HawortiaCooper/Bird.Bend_Stend/00_System/tools/README.md

# 00_System/tools — Integrator tools (owner: Implementer C)

Shared FW⇄SW interface tooling for `ICD_protocol.md` v0.7.5, `params.yaml` dict_version 6 and `protocol.yaml`
(protocol name registry, ICD §0.3).
Python ≥ 3.11, standard library + PyYAML (generators only). Use the project venv: `.venv\Scripts\python`.

| File | Purpose |
|---|---|
| `gen_params.py` | **Single generator entry point.** `params.yaml` → `02_FW/src/gen/params_gen.{h,c}`, `03_SW/src/bend_stand/core/params_gen.py`, ICD Appendix A; runs `gen_protocol.py`. Origin: Thrust_Stand_HAW `00_System/tools/gen_params.py` @9473c68 (trimmed). |
| `gen_protocol.py` | `protocol.yaml` → `02_FW/src/gen/proto_gen.h` (C), `03_SW/src/bend_stand/core/protocol_gen.py` (Python `IntEnum`/`IntFlag`, `<ID>_BITS`, `<ID>_DESC`, `CMD_REQ_LEN`, `CMD_RETRY`), ICD tables between `GENERATED protocol:<id>` markers + Appendix B (GF-08). |
| `ref_codec.py` | Reference codec (oracle): CRC-16/CCITT-FALSE, frame encoder, ICD §2.3 parser with resync, encode/decode of every request, response, DATA and EVENT payload. Stdlib only. |
| `ref_loadlim.py` | Reference FW load limit (M2, D-40 d): violations, trip samples, rails, regrow window; the docstring is the definition behind `loadlim_vectors.json` (ICD §5.5). |
| `ref_linkwdg.py` | Reference FW link watchdog (M4, D-47 a, ICD v0.7.4 §9.1): VALID cleared at the timeout in every motion state, stop / LINK_WDG / EVENTs only while moving; the docstring is the definition behind `linkwdg_vectors.json`. |
| `ref_motion.py` | Reference step-period generator (M2): exact sqrt ramp with max rule and fractional carry (R4 §1.5), controlled stop, JOG on-the-fly changes, ICD §6.5 stop-path rule, planner. The docstring is the normative definition behind `motion_vectors.json`. |
| `ref_cmdcheck.py` | Reference acceptance model of ICD §4–§6 (check order, BLOCK mask, busy, clears, SET_PARAM checks, hard rules). Acceptance only, no execution. |
| `gen_vectors.py` | **The single vector generator** → `vectors/protocol_vectors.json`, `vectors/check_vectors.json`, `vectors/units_vectors.json` (M1), `vectors/motion_vectors.json` (M2, from `ref_motion.py`), `vectors/loadlim_vectors.json` (M2, from `ref_loadlim.py`), `vectors/linkwdg_vectors.json` (M4, from `ref_linkwdg.py`). |
| `vectors/` | Generated shared vectors (never hand-edited). |
| `fw_twin/` | **FW host twin** (P2/M1): `build.py` (host gcc build of A's unmodified `02_FW/src/{pure,core,gen}` + twin seams), `engine/` (C: scheduler, seam implementations, world model), `twin.py` (launcher: virtual time, TCP ports, vocabulary v2, logs; Python API `Twin` / `TwinLink`), `contract/` (seam v1 header copies, used only while A's headers are absent), `probe/` (harness probe core — **not the FW**). See "FW host twin — how to run it" below. |
| `tests/` | pytest proving the codec, the model and the generators against the vectors; `test_fw_twin.py` = twin harness self-tests (probe core). |

## Regenerate (Integrator, after every params.yaml / ICD change)

```powershell
.venv\Scripts\python 00_System\tools\gen_params.py           # FW/SW params + protocol names, ICD App. A/B + tables
.venv\Scripts\python 00_System\tools\gen_vectors.py          # vectors (uses the new dictionary)
.venv\Scripts\python -m pytest 00_System\tools\tests -q      # must be green
```

CI / gate check (no writes): `gen_params.py --check` and `gen_vectors.py --check` exit 1 when any output is
stale; `gen_params.py --hash` prints PARAM_DICT_HASH. Rules: every ICD change = ICD version bump + change
history entry; every dictionary change = `dict_version` bump; ids are never reused (`retired_ids`). Validators
**add scenarios to `gen_vectors.py`** (via the Integrator), never a second generator (R3 pitfall P12).
**Input hardening (FWR-14, ICD v0.7.5):** `load()` of both generators rejects YAML text that could become code in the
generated C / Python: identifiers (`c_member`, `py_name`, columns, prefixes) against strict ASCII patterns without C / Python
keywords, `icd_version` / `retired` as `N.N[.N]`, `dict_version` and protocol versions as YAML integers, and every free text
(labels, units, descriptions, titles, `icd` refs, srs) without control / line-separator / bidi characters, `/*`, `*/`, `\`,
`"""` or C trigraphs (helpers `gen_protocol.safe_text / safe_ident / safe_version / safe_int`; tests
`tests/test_gen_text_safety.py` + Validator E's `02_FW/test/static/test_val_review_gen.py`). Non-ASCII symbols (µ, §, →) stay allowed.

## How both sides consume the vectors (IF-010)

Both implementations MUST pass the same files; the vectors are the oracle for byte values (ICD §0.1, §12).

| Vector set | FW (Implementer A / Validator E, `pio test -e native`, Unity) | SW (Implementer B / Validator F, pytest) |
|---|---|---|
| `protocol_vectors.json` `crc16` | `crc16_ccitt()` equals every `crc` | `io.framing` CRC equals every `crc` |
| `frames` (kind request/response/async) | decode every PC→FW request (payload_hex → C struct, fields = `decoded`); **encode** every FW→PC frame from `decoded` and compare **byte-identical** with `frame_hex` | encode every PC→FW request from `decoded` byte-identical; decode every FW→PC frame to `decoded` (`reencode: false` → re-encoding gives `canonical_payload_hex`; `INVALID_PADDING` → reject) |
| `frames` `framing_only` / `invalid` | frame layer only / must be dropped with `crc_errors += 1` | same |
| `streams` | feed `chunks_hex` in order to a fresh `frame.c` parser; call the 20 ms timeout hook if `idle_timeout_at_end`; frames **and** counters equal | same with `io.framing.FrameDecoder` |
| `units_vectors.json` (ICD §0.1) | `units.c` `um_to_steps` / `steps_to_um` / rate cap with `spm` = the binary32 from `spm_f32_hex`: every value exact | `calc.motion.um_to_steps` / `steps_to_um` and the simulator's step model: every value exact |
| `motion_vectors.json` (M2) | `ramp.c` / `stepgen_core` from the case parameters and events: every period within `tolerance.period_ticks` (±1) and the sum within `tolerance.sum_ticks` (±N/1000) of `periods`; `ctrl_stop_path()` equals every `ctrl_stop_paths` row; v0.7.2 `immediate_stops` (MOVE_UNTIL_LOAD threshold): the generator of `base_case` stopped immediately after `after_step` periods emits no further pulse; `threshold_in_controlled_stop`: the same after the base case's controlled stop, MOVE_DONE stays STOPPED (OI-FW-43 b) | the simulator's step model: every period and sum exact (binary64); `immediate_stops` the same |
| `loadlim_vectors.json` (M2) | `loadlim.c`: replay each case (init, then sample / fault_clear / config steps): `trip` and `regrow_window` equal after every step | the simulator's load limit: same |
| `linkwdg_vectors.json` (M4, ICD v0.7.4) | twin replay `03_SW/tests/integration/test_twin_m4_linkwdg.py` (state set up, silence from the end of the last request, trip / no trip, VALID after, LINK_WDG status, EVENT set at the trip and at the next frame) and Validator E's independent replay `02_FW/test/twin/test_val_twin_m4_linkwdg.py` (32/32 each); A's FW link watchdog (native suite) | the simulator's link watchdog: same (D-47 a in B's `io/sim/board.py`) |
| `check_vectors.json` `hw_meas_vectors` (v0.6) | only against a HW_MEAS build (FEAT_HW_MEAS = 1); release / twin builds replay `vectors` (DIAG_MEAS → NOT_IN_BUILD) | the simulator answers NOT_IN_BUILD (no HW_MEAS model) |
| `check_vectors.json` | set up the pure command-check context from `state_defaults` ⊕ `state` (and the param overrides), run the command check on `request.payload_hex`, compare STATUS/detail and, for NACKs, the encoded response with `response_frame_hex`; no side effect on NACK | the simulator (`io.sim.fw_logic`) in the same state answers identically (differential check of the SimBoard) |

FW side: a pre-script in `02_FW` (owned by A/E) converts the JSON into a C header (arrays of hex strings +
expected values) at build time, as Thrust_Stand did (`tools/gen_test_vectors.py`). It MUST read the files in
place (no copies) so `--check` staleness is caught. SW side: tests load the JSON directly via the repo path
`00_System/tools/vectors/`; `ref_codec` may be imported as an oracle in tests only, never by production code.

`check_vectors.json` state fields (`ref_cmdcheck.FwState`): `params` (key → value overrides; enum/bool as
code), `motion_state` (ICD §6.1 name), `enabling_left_ms`, `homed`, `pos_um`, `estop_latched`,
`estop_input_open`, `estop_closed_ms`, `halt_latched`, `stop_btn_active`, `stop_btn_released_ms`, `faults` /
`fault_causes` (FAULT names), `limit_start` / `limit_end` (active or latched), `afe_stale`, `afe_saturated`,
`raw`, `drv_power`, `alm_active`, `nvm_record_valid`, `paused` (v0.2), `unhomed_origin_um` (v0.7, D-43 b: the
position latched when the axis became un-homed; default 0), `ena_on` (**v0.7.5, D-50 c / OI-FW-50**: the ENA output at the
enabled level = STATUS `io` ENA_DISABLED clear; default true; false after DISABLE or an E-stop; after a boot NOT_ENABLED
keeps it true, D-13; the generator asserts ENA on outside NOT_ENABLED / E-stop and off with an E-stop).
`state_schema` (top level, = 2 since ICD v0.4, = 3 since ICD v0.7 (+ `unhomed_origin_um`), **= 4 since ICD v0.7.5** (+ `ena_on`;
FWR-09 in the pure check: DIAG_MEAS STATIC_LEVEL sel PUL with `ena_on` → `E_STATE` MEAS_STATE), F-B-25): version of these keys. Keys are only ever **added**
(never renamed or removed), each addition bumps `state_schema`; a replay MUST fail on an unknown key or a
newer `state_schema`. Every vector state is a valid configuration (all hard rules H1–H5 hold).
`expect.paused_after` (present when `state.paused` or for PAUSE / RESUME): the PAUSED latch after the command
(ICD §5.5, D-30/D-31: only RESUME or HALT_CLEAR clear it). It is an execution effect: FW latch unit tests,
the twin and the SW simulator check it; the pure FW command check ignores it.

**Protocol names (GF-08, ICD §0.3).** FW code includes `gen/proto_gen.h` and SW/GUI code imports
`bend_stand.core.protocol_gen`; neither side hand-lists command codes, NACK codes, bit tables or EVENT codes.
`tests/test_protocol_registry.py` proves `protocol.yaml` = `ref_codec.py` tables = generated module.

---

## Lean FW host twin for M1 (outline for Implementer A; R3 §3.6, SYS-008, D-07)

**Goal:** compile the *same* FW sources (`src/pure`, protocol/link, cfg/NVM, app state machines, motion
planner) for the PC against a ≤ 1.5 kLOC twin implementation of a few narrow C seams, serve USART2 as TCP
`127.0.0.1:5760` (SW endpoint `tcp://127.0.0.1:5760`), and drive the "world" through a control port. No
register emulation (the Thrust twin's 7.5 kLOC fake-`stm32f1xx.h` approach is not repeated).

### Seam v1 (single source; DEF-P1-02 / OI-FW-17 closed)
The seam contract is **FW_design §8.1** (Implementer A owns the headers `02_FW/src/hal/hal_*.h` and freezes
them as seam v1 in M1-WP1); this README adopts it **verbatim, including every Δ**. A seam change is made by A
in FW_design §8.1 + the headers and mirrored here in the same change (one contract, two copies kept equal;
the twin is coded against the headers).

```c
/* hal_uart.h */
size_t   hal_uart_read(uint8_t *buf, size_t max);                     /* consume RX bytes */
size_t   hal_uart_peek(uint8_t *buf, size_t max, uint32_t *cursor);   /* stop sniffer: new RX bytes, no consume */
typedef enum { HAL_TX_DATA = 0, HAL_TX_RESP = 1, HAL_TX_EVENT = 2 } hal_tx_class_t;
bool     hal_uart_write(const uint8_t *frame, size_t n, hal_tx_class_t cls); /* whole frame or false;
                                                                    HAL_TX_DATA callable from the sample ISR/tick */
size_t   hal_uart_tx_free(hal_tx_class_t cls);
bool     hal_uart_tx_idle(void);                                      /* all classes empty and line idle */
uint32_t hal_uart_rx_overruns(void);
/* hal_time.h */
uint32_t hal_time_us(void);   uint32_t hal_time_ms(void);
void     core_tick_1ms(void);                                         /* callback, level 4, every 1000 µs */
/* hal_step.h */
typedef struct { uint32_t pw_ticks, dir_setup_ticks; bool pul_invert, ena_invert; } hal_step_cfg_t;
uint32_t hal_step_init(const hal_step_cfg_t *cfg);                    /* returns f_tick (90 MHz target) */
void     hal_step_set_dir(int dir);                                   /* only while stopped; v1.3: +-1 logical
                                                                         direction, +-2 = same direction with the
                                                                         DIR output inverted (motion.dir_invert) */
void     hal_step_start(uint32_t first_period_ticks);                 /* first edge >= dir_setup after the call */
void     hal_step_set_period(uint32_t ticks);                         /* preload: period after the running one */
void     hal_step_set_period_now(uint32_t ticks);                     /* stretch the running period (§5.6.4) */
void     hal_step_arm_last(void);                                     /* OPM: stop at the end of this period */
bool     hal_step_stop_now(void);                                     /* CLEAN, no runt; true = pulse completes */
bool     hal_step_abort(void);                                        /* TRUNCATE; true = pulse cut (uncertain) */
int32_t  hal_step_count(void);                                        /* signed position counter, steps */
void     hal_step_set_count(int32_t steps);                           /* homing zero shift, only while stopped */
bool     hal_step_running(void);
uint32_t hal_step_stop_gen(void);                                     /* start-then-recheck counter */
void     hal_ena_set(bool enabled);                                   /* polarity from hal_step_init */
typedef struct { uint32_t period; bool last; bool stop; } step_next_t;
step_next_t step_isr(void);                                           /* callback, level 2, per completed pulse */
/* hal_inputs.h  — ids = ICD IO bit indices 0..7 */
uint16_t hal_inputs_raw(void);                                        /* electrical levels (1 = pin high) */
typedef struct { uint8_t pause_active_level, alm_active_level; } hal_in_cfg_t;   /* v1.2: STOP input retired */
void     hal_inputs_config(const hal_in_cfg_t *c);                    /* polarity for the fixed reactions */
void     hal_inputs_rearm(uint8_t id);                                /* re-enable a self-masked line */
void     on_input_edge(uint8_t id, bool level, uint32_t t_us);        /* callback, level 0/1, AFTER the HAL's
                                                                         fixed reaction; deferred during flash ops */
/* hal_outputs.h */
void hal_rate_pin(bool high);  void hal_trip_relay(bool trip /* never true in release 1 */);  void hal_led(bool on);
/* hal_hx711.h */
typedef struct { uint32_t t_us; int32_t raw; int32_t pos_steps; uint8_t status; } afe_sample_t;
void hal_hx711_config(uint8_t gain_pulses, bool rate80);
void hal_hx711_powerdown(bool on);
void hal_hx711_kick(void);                                            /* missed-edge recovery */
void hal_hx711_hold(bool on);                                         /* NVM hold */
void on_afe_sample(const afe_sample_t *s);                            /* callback, level 3, after the latch */
/* hal_flash.h */
bool hal_flash_erase(uint32_t sector);
bool hal_flash_program(uint32_t addr, const void *src, size_t n);
const void *hal_flash_map(uint32_t addr);
/* hal_sys.h */
void hal_wdg_kick(void);  void hal_wdg_set_timeout(uint32_t ms);
uint8_t hal_reset_cause(void);            /* RST_* (proto_gen.h) */
void hal_reset(void);  void hal_uid(uint8_t uid[12]);  bool hal_clk_fallback(void);
uint16_t hal_stack_free_min(void);
bool hal_fault_record(uint32_t *pc, uint32_t *cfsr);   /* seam v1.2 (OI-FW-32): HardFault record of the
                                                          previous run, true once after boot, then cleared */
size_t hal_meas_cmd(const uint8_t *req, size_t n, uint8_t *resp, size_t max);   /* seam v1.3 HW_MEAS (D-40c) */
/* critical sections (seam v1.1, A's proposal adopted in P2/M1): HALT = PRIMASK, AFE/MOTION = BASEPRI 0x20,
   DATA = 0x30, TICK = 0x40; no-ops in the twin (single thread, ISRs never preempt; nesting checked) */
typedef enum { HAL_CRIT_HALT = 0, HAL_CRIT_AFE = 1, HAL_CRIT_MOTION = 2, HAL_CRIT_DATA = 3, HAL_CRIT_TICK = 4 } hal_crit_level_t;
typedef uint32_t hal_crit_t;
hal_crit_t hal_crit_enter(hal_crit_level_t level);
void       hal_crit_exit(hal_crit_t saved);
/* usage: CRIT_BEGIN(HAL_CRIT_DATA); ... CRIT_END();  (macros in hal_sys.h) */
```

| Seam | Target implementation | Twin implementation (virtual time) |
|---|---|---|
| `hal_uart` | USART2 + DMA1 Stream5/6 Ch4; three TX class queues, wire order DATA > RESP > EVENT (ICD §2.4) | TCP 127.0.0.1:5760 paced at 92 160 B/s; same class queues and order; `peek` = second read cursor; every TX frame logged with first/last-byte virtual time (wire log) |
| `hal_time` | TIM5 1 MHz; SysTick 1 kHz → `core_tick_1ms` | virtual clock (lock-step or real time); `core_tick_1ms` every 1000 µs of virtual time |
| `hal_step` | TIM2 PWM mode 2 + update IRQ (R4 §1.3) | integrates virtual pulses at the commanded periods; `set_period_now` / `arm_last` act on the virtual counter; `abort` cuts the pulse and flags it uncertain; every PUL edge (both), DIR and ENA change logged with its virtual time |
| `hal_inputs` | GPIO + EXTI, fixed reactions in the HAL (FW_design §5.2) | world model per input (switch position, forced level, bounce, broken wire); `rearm` = no-op |
| `hal_outputs` | GPIO | levels recorded for `query` |
| `hal_hx711` | EXTI on DOUT + bit-bang (`hx711_seq.h`, Thrust origin) | sample source from the load model at rate·(1+ε); `hold` = no samples delivered; `kick` = no-op; gain pulses per read recorded |
| `hal_flash` | F4 sector erase / word program | file `flash.bin` (persists across twin resets); power cut injectable after program word n / during erase k; write counter |
| `hal_sys` | IWDG, RCC, SCB | IWDG model (timeout from `hal_wdg_set_timeout`, LSI selectable), reset = engine process restart by `twin.py` with the selected cause (flash kept, frames in flight cut), HSE-fail flag; `hal_crit_*` no-ops (nesting checked) |

**Seam semantics (normative, fixed by A's FW and fakes, adopted at ICD v0.5; OI-C-M1-03 answered):**
- `hal_uart_tx_free(cls)` = the largest frame (bytes) the class queue accepts **now** (0 = none).
- `hal_uart_peek(buf, max, &cursor)`: `cursor` = absolute RX byte count since boot (the core starts it at 0);
  returns the bytes after `cursor` without consuming them and advances `cursor`; a lapped cursor skips to the
  oldest byte still in the ring.
- `hal_step_stop_gen()` (v0.7.5, OI-FW-48, FW_design v0.8 FWR-01): incremented by **every** stop primitive call — `hal_step_stop_now()`,
  `hal_step_abort()` and the target's `step_estop_reaction()` — also while the timer is idle (start-then-recheck sees an idle
  halt between the gate check and the start); `hal_step_start()` arms the timer atomically. The twin mirrors the idle
  increment (its start is atomic by construction: single thread).
- `hal_flash_erase(sector)`: F4 sector number 1 or 2 (0x0800 4000…0x0800 7FFF / 0x0800 8000…0x0800 BFFF);
  `hal_flash_program(addr, src, n)`: addresses inside sectors 1–2, `n` a multiple of 4 B (word), at most
  512 B per call; programming can only clear bits (a 0→1 bit returns false).
- `hal_wdg_set_timeout(ms)` selects a window, it is not scaled: **ms ≤ 90 → run window** (PR /8, RLR 190:
  32.5 ms at LSI 47 kHz … 89.9 ms at 17 kHz; i.e. 90 = the worst-case timeout at the slowest LSI), **ms > 90
  → NVM long window** (PR /32, RLR 4095: 2.79 s … 7.71 s), idle only. The FW arms the run window at boot.
- `afe_sample_t.status` bits (`protocol.yaml` table `afe_sample_status`, C `AFES_*`): bit 0 `SCK_OVERRUN`
  (the read overran; the HX711 may have entered power-down → the core re-initialises it), bit 1 `MISSED_EDGE`
  (≥ 1 DOUT-ready edge missed before this sample → OVERRUN in the next DATA frame); bits 2–7 = 0.

**Seam v1.3 (ICD v0.6, D-40 c; REQ-C-M2-01, REQ-A-M2-03)** — three changes:
- `hal_step_set_dir(dir)`: A's interim encoding becomes the seam (SR-M2-01): `dir` = ±1 logical direction (the HAL
  counts `pos_steps` by its sign), ±2 = the same logical direction with the DIR output inverted
  (`motion.dir_invert`). DIR electrical level = (dir > 0) XOR (|dir| = 2).
- `hal_in_cfg_t` without `stop_active_level` (SR-M2-02, CR-01).
- `size_t hal_meas_cmd(const uint8_t *req, size_t n, uint8_t *resp, size_t max)` in `hal_sys.h`: the HW_MEAS forwarder.
  `req` = the 8-byte DIAG_MEAS request payload, already validated by the core (LEN, op / sel / a / b ranges,
  MEAS_STATE, ICD Appendix C); `resp` = the 64-byte OK body. Returns 64 when executed, **0 when the build has no
  HW_MEAS** (release image, twin without `--hw-meas`): the core then answers E_INTERNAL NOT_IN_BUILD. At boot the
  core calls it once with op INFO and sets FEAT_HW_MEAS from the result. STATIC_LEVEL is released by the HAL before
  any other DIAG_MEAS op and at `hal_step_start` / `hal_ena_set`. Not called from ISRs; called only from the command
  dispatcher (main loop). A's `hal_sys.h` carries it (seam check clean); the seam check still accepts a function marked
  "PENDING-A" in the block as announced-but-not-delivered for future additions.

**Seam v1.2 (M2; OI-FW-32)** — one addition, made by A in `hal_sys.h` and mirrored into the block above
(ICD v0.5; the twin provides it):
```c
bool hal_fault_record(uint32_t *pc, uint32_t *cfsr);   /* HardFault record of the previous run (.noinit):
                                                          true once after boot if present, then cleared */
```
The core puts `pc` / `cfsr` into EVENT BOOT `value` / `value2` (ICD §6.4). Twin: vocabulary `reset` with
`cause: "hardfault"` plants a record and resets with cause SOFTWARE; `--fault-rec <pc_hex>:<cfsr_hex>`.

Rules for A: the protocol, command check, state machines, NVM codec, ramp planner and safety logic call only
these seams (no direct register access outside `src/hal/`); every seam call that the twin cannot serve
deterministically takes `t_us` as an argument or reads `hal_time_us()`. FW-side debug hooks are not needed:
the twin keeps the seam-call log and the edge log itself (OI-FW-31).

### FW host twin — how to run it (Integrator, `00_System/tools/fw_twin/`, P2/M1)

**Private binary per run (OBS-M2-09, ICD v0.7.2).** Concurrent roles must never run, rebuild or lock the same
`fw_twin.exe`: (1) `build.py` compiles into a per-process temporary file and installs it with one atomic
`os.replace` (retried while Windows keeps an old file locked); (2) test suites call
`build.ensure_built_private(core)`: built once per process into `build.private_build_dir()` — `$BEND_TWIN_BUILD_DIR`
if set (kept, e.g. a role's scratchpad), else a temp dir removed at exit — and **pinned** for the whole run;
(3) `Twin(..., private=True)` (default) runs a binary that lies in the shared `fw_twin/build/` from a per-process
private copy (also for the engine restarts after resets), so callers that still pass the shared exe are
protected too. Validators' `VAL_TWIN_BUILD_DIR` keeps working (a private dir, used in place).

**Lock-step SW ⇄ twin (OBS-M2-09).** `03_SW/tests/integration/twin_rig.py` runs Implementer B's `Backend`
(`BackendSettings(clock="lockstep", test_hooks=True)`) and the twin in one virtual time: every 1 ms backend step
first advances the twin to the same instant (`Device.transport_for` → in-process `TwinTransport`; the
`Backend.sim_endpoint` stepper slot → the twin). `lockstep_boards.py` puts the twin and B's `SimBoard` (lock-step
clock, `VirtualTransportPair`) behind one PC-side driver for the SIM-vs-twin differentials;
`io_client.LockstepIoClient` is B's io layer waiting in virtual time. No integration result depends on the wall
clock any more except `test_backend_connect_sequence_tcp_realtime` (TcpTransport smoke, event-driven waits).
**M4 (D-46):** `test_backend_twin_m4.py` drives B's sequencer through its public API only (a `bird.bend.sequence`
file loaded by `Backend.sequencer.load`, `start / pause / resume / stop / abort / status / results`, `reports.*`)
and judges the outcome on the FW side of the wire (`seq_support.py`: decoded requests, responses, EVENTs and DATA
frames from the twin's `wire_log`; VALID windows from the SET_VALID response times, which fix VALID frame by frame
per ICD §4: a frame is VALID iff `t_on ≤ t_us < t_off`); `test_sim_vs_twin_m4.py` = the SIM-vs-twin differential of
a short sequence (board level with `lockstep_boards.Link`, and backend level: B's Backend on the simulator vs on the
twin). B's sequencer is delivered (M4), so these tests run without xfail; a test that needs a part of B that is
still missing is xfail at run time with the reason and flips by itself (e.g. `test_sim_vs_twin_stall.py` while the
simulator lacks `inject step_stall`). v0.7.5: `test_step_timeout_on_a_move_stall` = SW-SEQ-007 TIMEOUT end to end
(twin move stall → no MOVE_DONE → the sequencer's guard STOP at 1.2 × planned travel time + 10 s).

```powershell
.venv\Scripts\python 00_System\tools\fw_twin\build.py                  # --core auto: fw if 02_FW/src/core/*.c exists, else probe
.venv\Scripts\python 00_System\tools\fw_twin\build.py --core fw        # build\fw_twin.exe  (A's firmware)
.venv\Scripts\python 00_System\tools\fw_twin\build.py --check-seams    # A's hal_*.h == the seam v1 block above?
.venv\Scripts\python 00_System\tools\fw_twin\twin.py --port 5760 --ctl 5761 --clock realtime      # SW: tcp://127.0.0.1:5760
.venv\Scripts\python 00_System\tools\fw_twin\twin.py --clock lockstep --scenario my.simscn.json [--t0-us 0xFFFB6C20]
.venv\Scripts\python -m pytest 00_System\tools\tests\test_fw_twin.py -q                      # harness self-tests (probe)
.venv\Scripts\python -m pytest 03_SW\tests\integration -q                                    # SW <-> twin (A's FW)
$env:BEND_TWIN_CORE="probe"; .venv\Scripts\python -m pytest 03_SW\tests\integration -q       # harness check only
```

- **Build** (`build.py`): host gcc = CLion MinGW 13.1 (CLAUDE.md; else `gcc` on PATH or `$env:TWIN_GCC`), `-std=c11
  -O2 -DFW_TWIN=1 -DFW_VERSION_*` (read from `02_FW/platformio.ini` [env] build_flags, the single source; the ini is a build input) `-DPARAMS_GEN_WITH_KEYS=0 -DFW_FEATURE_EXTRA=FEAT_TWIN`
  (A's `core/fw.h` adds it to the INFO feature mask; no `#ifdef` in the core, TC-SYS-008-01). Sources compiled **in place,
  unmodified**: `02_FW/src/pure/*.c`, `src/core/*.c`, `src/gen/*.c` + `fw_twin/engine/*.c`; includes `02_FW/include`,
  `src`, `src/{pure,gen,core}` and `src/hal` (A's seam headers; `fw_twin/contract/` while they are absent).
  Log `build/build_<core>.log` (gcc command, warnings, seam check). `twin.ensure_built()` rebuilds when a source is
  newer than the exe. The core must provide `app_init()`, `app_loop()` and the callbacks `core_tick_1ms`,
  `step_isr`, `on_input_edge`, `on_afe_sample` (FW_design §3.2, §4.2, §8.1).
- **Architecture** (lean, R3 §3.6: no register emulation): `build/fw_twin.exe` = engine + FW, a slave process
  that runs only when `twin.py` advances the virtual clock (stdin/stdout line protocol, `engine/twin_engine.c`
  header). `twin.py` owns virtual time, the TCP data port (one client; a new connection replaces the old one,
  bytes go to the FW at the current virtual time), the JSON-lines control port, the logs and the timed actions.
  One engine process = one MCU power-on period; a reset ends the process and `twin.py` boots a new one after
  2 ms (`boot_delay_ms`) with the reset cause, the same `flash.bin` and the replayed world state.
- **Clocks**: `lockstep` — virtual time moves only on `clock` actions / `Twin.advance_*()` (deterministic: two
  runs give identical wire logs); `realtime` — `twin.py` advances virtual time with the wall clock × `--speed`
  (for B's backend over TCP). Execution rule (FW_design §8.2): ISR callbacks run atomically at their virtual time
  in NVIC order (inputs 0/1, step 2, sample 3, tick 4, TX-done 5), the main loop runs once after every virtual
  instant with an event. A main-loop pass takes no virtual time except flash operations (CPU stall: erase 500 ms,
  16 µs per programmed word); interrupts falling into a stall are taken after it (input fixed reactions happen
  at once, their core callback is deferred), the TX frame on the wire completes, the next one starts after the
  stall. A pass with > 2·10⁶ `hal_time_*` calls is a busy-wait → reported, treated as a hang (IWDG reset).
- **Seam models** (constants = FW_design §2.5): TX classes D 2 frames / 52 B, R 1 024 B, E 16 frames / 384 B;
  wire order D > R > E; 92 160 B/s, byte i of a frame ends at `t0 + ceil((i+1)·10⁹/92160)` ns (RX the same);
  RX ring 2 048 B (overrun counted, reader lapped). Step: f_tick 90 MHz, pulse at the end of each period
  (PWM mode 2), first rising edge ≥ `dir_setup` after `hal_step_start`; at each period end the count moves,
  the next period starts with the preload, then `step_isr()` is called (`.period` → preload, `.last` → the
  period just started is the last, `.stop` → halt now); `stop_now` CLEAN (a pulse in its high phase completes),
  `abort` TRUNCATE (pulse cut, not counted, POS_UNCERTAIN in `query pulses`). ENA electrical level
  = `!enabled ^ ena_invert`. Inputs (electrical, 1 = pin high, pinout §1): E-stop open = 1, limits active = 1,
  PAUSE pressed = 0 (NO), ALM active or driver unpowered = 1, PEND in position = 1, DRV_PWR present = 0; a broken
  wire reads 1 on every input; HAL fixed reactions: E-stop open → `hal_step_abort()` + ENA disabled, limit
  active → `hal_step_stop_now()`; every EXTI-input edge calls `on_input_edge` (lines never masked, `rearm` no-op);
  ALM / PEND / DRV_PWR are only polled. AFE: 80 SPS from reset (RATE pull-up), `hal_rate_pin` /
  `hal_hx711_config` select 10/80 SPS, conversions at `1/(sps·(1+rate_error))`, raw = round-half-away(offset +
  `cell_counts_per_n`·F(x) + N(0, noise)) clamped to the rails, `afe_sample_t.status` per the seam semantics
  (bit 0 = `afe sck_overrun`, bit 1 = after `afe miss_next`); `hold` = conversions continue, none delivered.
  **M3 load model (ICD v0.7.2)**: F = specimen (elastic − relaxation) + hung weights (`weight`); raw =
  round-half-away(offset + cpn·F + cell non-linearity + creep + zero drift + N(0, noise)): non-linearity
  `nonlin_pct_fs`·FS·4u(1−u), u = |F|/FS, odd in F (`fs_n` default 1961.33 N = 200 kg); creep first order toward
  `creep_pct`·(cpn·F) with `creep_tau_s` (R2: 0.02 % FS / 30 min); zero drift `drift_counts_per_s`, linear from the
  time it is set; relaxation first order toward `relax_pct`·F_elastic with `relax_tau_s` (follows the elastic
  force while moving). All terms 0 by default (M1/M2 results unchanged); the states advance with virtual time at
  each conversion / query and survive MCU resets (world).
  **M4 specimen model (twin side; vocabulary additions ICD v0.7.4, D-47 b):** deflection
  d = x − `x_contact_um`; `side` `pull` (default, the M1–M3 model: force only for d > 0), `push` (compression side:
  only d < 0, force negative) or `both` (clamped specimen, linear through the contact point);
  |F| = k|d| (bilinear above `f_yield_n`) + `k3_n_per_mm3`·|d|³, never below 0 (a softening k3 saturates at 0);
  **grip slip** `slip_at_n` + `slip_mm` (the simulator's B6-17 test extra): when |F| first reaches `slip_at_n` the
  contact point moves once by `slip_mm` in the deflection direction; **break** when |F| ≥ `f_break_n` or
  |d| ≥ `break_travel_um`: the force drops to `break_residual_pct` % of the intact curve (0 = clean break),
  relaxation state cleared (the simulator implements the same model, SWC-M4-01 closed). Break and slip are world states (kept over MCU resets, cleared by the next `specimen`
  action); seam-log entries `specimen_break <F_N> <x_um>` and `specimen_slip <F_N> <new x_contact_um>`; `query
  world` adds `specimen_broken`. Relaxation acts on either side (it follows the signed elastic force); a one-sided (pull / push) specimen never changes sign through its relaxation — unloading a relaxed specimen loses contact (force 0, no push-back; D-49 a scenarios), a clamped (`both`) one may.
  Flash: sectors 1+2 (0x0800 4000…0x0800 BFFF) in `flash.bin`, program = AND (a 0→1 bit returns false), sector =
  1/2 or an address in it. IWDG armed by the first kick / `set_timeout`; window per the seam semantics at the model LSI (`iwdg lsi_hz`,
  default 32 kHz: run window 47.75 ms, long window 4.10 s).
  `hal_uid` = `--uid` (default "TWIN-UID-001"), `hal_stack_free_min` = 3072 (no stack painting).
- **D-36 / CR-01 (ICD v0.5)**: there is no STOP/BREAK button input (PC7 is free; the red button is the E-stop,
  `estop`). The names `button stop`, `wire stop`, `chatter stop` are **retired** from the vocabulary and answer
  `{"ok": false}`.
- **RX during a flash stall (OBS-M1-02, fixed in v0.5)**: bytes injected with `rx_bytes at_us` reach the
  engine before it advances to their time, so bytes arriving during a SAVE stall land in the RX ring at their
  wire time (as the RX DMA does; logged there in `wire_log`), and the command is processed and answered after
  the flash operation (ICD §2.4 SAVE exemption, D-37a).
- **Python API** (validators, integration tests): `Twin(clock, core|exe, run_dir, scenario, t0_us, speed)`,
  `advance_us/ms/to`, `act(...)` (= control port), `feed_rx(bytes)`, `read_client()`, `serve(port, ctl)`,
  `fw_t_us()`, logs `wire_log`, `sent`, `edges`, `seam_log`, `conversions`, `input_log`, `resets`;
  `TwinLink(twin)` = in-process PC side on `ref_codec` (oracle, tests only): `send(name, fields, at_us=)`,
  `cmd(name, fields)`, `poll()`, `data()`, `events()`, `find(name, seq)`.
- **Probe core** (`probe/probe_core.c`, `--core probe`): a small ICD-shaped stand-in (link, parameters, a
  power-safe record log, stream, SET_VALID, stop/clear latches, and the probe-only TYPE 0x3F step train) used to
  self-test the harness and the integration tests before A's core exists. **Never M1 evidence** (INFO build string
  `PROBE-NOT-FW`).

**Vocabulary v2 in the twin (M1 subset complete; M2–M4 additions below; v0.7.5 `inject step_stall`, see "Move stall"):** all M1 actions are implemented — `estop` (bounce,
`drv_power_follows`, `k1_delay_ms`: the driver power also returns `k1_delay_ms` after the E-stop closes), `drv_power`,
`button` (pause), `limit` (forced / position), `alm`, `pend`, `specimen` (none / spring / bilinear / break;
relaxation since v0.7.2), `load_offset`, `afe` (all arguments), `inject` (`tx_congestion`, `link_silence`,
`rx_corrupt`, `hang` main/tick, `step_fault` = the next step ISR is skipped, per-command `drop_next` /
`duplicate_next` / `delay_next` / `corrupt_next` on requests and responses), `rx_bytes` (`at_us` = start of the
first byte, world µs), `on_frame` (after the last byte of the nth matching request), `on_event` (after the last
byte of the nth matching EVENT on the wire), `flash`, `clock`, `reset`, `query` (`world`, `pulses`, `outputs`,
`edges`, `seam_log`, `wire_log`, `sent`, `flash`); also `wire`, `chatter`, `world_shift`, `iwdg`, `clk`.
M2 additions (ICD v0.6, Validator E REQ-C-M2-02…10): `inject loop_load` (`us_per_pass`, `duration_ms?`: each main-loop pass consumes that much virtual time, ISRs keep running, the next pass starts after it), `driver` (`dir_wiring_inverted?`: the world moves by the DIR **pin** — x is integrated from PUL edges and the DIR level, independent of the FW counter, and persists across MCU resets; `pend_auto?`, `pend_lag_ms?`: PEND inactive while pulsing and `pend_lag_ms` after the last pulse), `query conversions` entries carry `gain_pulses` / `channel_gain` / `rate_sps`, `query … clear: true` drains a log after reading (default `log_max` 1 000 000 per log), `Twin(hw_meas=True)` / `--hw-meas 1` = model of DIAG_MEAS (twin_meas.c: counter, probe, stamps, .noinit kept over resets, STIM_RUN, HANG, STATIC_LEVEL; DWT not modelled). Earlier M2 additions (ICD v0.5): `inject isr_storm` (= `hang where=isr1`: main loop, tick, step ISR and sample delivery starved for `duration_ms`, hardware pulses continue at the preloaded period, level-1 input callbacks deferred, the level-0 E-stop reaction still acts; seam log `step_isr_starved`), `reset cause=hardfault` (seam v1.2 record), `afe_sample_t.status` bit 1 after `afe miss_next` / `drop_every`. Twin-only `query` extensions: `conversions` (every HX711
conversion: world `t_us`, FW `fw_t_us`, raw, delivered) and `inputs` (electrical input changes). Times in logs
are world µs since the twin start (float, ns resolution); `wire_log` `first_us` = start of the first byte,
`last_us` = end of the last byte.

**Coordinate and limit-switch convention (normative for the twin and the SW simulator; OI-B-M2-04, ICD v0.7).**
World x [µm] (`query world` `x_um_true`) is integrated per **completed** pulse (the end of the PUL pulse = the
timer update) from the DIR **pin**: +1 step (1000 / steps_per_mm **of the world** µm — the mechanics: scenario `params.motion.steps_per_mm`, default 800; v0.7.2 clarification, SWC-M3-03: a later SET_PARAM of the board's `motion.steps_per_mm` changes the µm per commanded step, never the carriage travel per pulse) while DIR is high, unless the DIR
wiring is inverted (`driver dir_wiring_inverted`); it is independent of the FW counter and persists across MCU
resets. START is active iff x ≤ `start_switch_um`, END iff x ≥ `end_switch_um` (`limit position_um`), evaluated
after every completed step. The HAL fixed reaction stops the timer CLEAN at that step, so the **last executed step
is the first step at which the switch is active** (step-exact, no extra step, no overshoot); the stop position
is therefore the first grid step at or beyond the edge. Homing: the slow approach ends at that step (x_edge), and
machine 0 lies `home.offset_um` beyond it, i.e. machine x = x_world − x_edge − `home.offset_um`
(`test_home_at_start_edge`). A simulator that integrates continuously must quantise the same way (stop at the first
step ≥ the edge in the moving direction).

**SIM-vs-twin comparison rule (MC2-6, ICD v0.7.2; `03_SW/tests/integration/test_sim_vs_twin_motion.py`).** Both
boards run the same script at the same virtual instants. Compared **exactly**: responses (status, detail), EVENT
sequences (code, arg and the position / reason values), STATUS latches (flags, status, faults, motion state, home
phase) and `pos_um` / `pos_steps` at world- or plan-determined end points (move target, JOG bound, homing at the
START edge, limit-switch stop at the first active step, MOVE_UNTIL_LOAD bound). For stops triggered **at a time**
(a command or an input edge while moving) the end position may differ by the simulator's 1 ms step grid, which
delays both the start of the move and the reaction by up to 1 ms each: |Δ| ≤ ceil(v·2 ms) + 1 steps; a FW load-limit or MOVE_UNTIL_LOAD threshold stop depends on the HX711
conversion phase: |Δ| ≤ ceil(v·12.5 ms) + 1 steps and the raw value of the trip sample is not compared; the rest
of those transcripts stays exact. Boot-time EVENT order (BOOT / PARAMS_DEFAULTED, not specified in ICD §11.3) and
all times are not compared. POS_UNCERTAIN after an E-stop edge while moving = the step output was running
(ICD v0.7.2 §6.2). M4 sequence differential (`test_sim_vs_twin_m4.py`): a VALID window is compared by its VALID
frame count (±1: conversion phase) and its set of raw values (exact: noise 0, world-determined position); status
after a threshold stop is taken ≥ 50 ms later (PEND is a driver-model signal with a 5 ms lag, not FW behaviour).

**E-stop wiring in the world (CR-03 / D-41, ICD v0.7).** Release 1 has no power-removal contactor: the driver's
48 V stays present when the E-stop opens. The world default `estop drv_power_follows: true` (vocabulary FROZEN)
models the earlier contactor wiring; release-1 scenarios pass `drv_power_follows: false`. With the defaults
`drv.pwr_sense_enable` = 0 and `drv.k1_check_enable` = 0 the FW ignores DRV_POWER, so both give the same result.

**DIAG_MEAS model (twin_meas.c) aligned to the target in v0.7 (REQ-C-M2-12, OI-FW-38).** NOINIT: the magic is
set at boot whenever the block is invalid (block cleared), so w0 = `MEAS_MAGIC` from the first read; w2 = the
heartbeat of the last 10 kHz DMA update (FW t_us floored to 100 µs), not the time of the read; sel 1 clears the
block and the rings. INFO w4 = 2048 stamps per channel, w7 = 10 000 000 (stimulus clock). PROBE_READ w5 = PUL
stamps since arming; TRIGGERED = probe counter running (never in PWM_INPUT). STATIC_LEVEL acts only with the step
timer stopped. Not modelled: the stamp rings surviving a reset (the twin carries the .noinit words), DWT
statistics (op 9 w0 = 0). v0.7.1 (OI-FW-41): NOINIT w4 prev_valid, w5 / w6 / w7 previous boot's newest PUL /
last heartbeat / hang start, w8 boot counter — at each MCU reset of a valid block the previous boot is snapshot,
w8 + 1, w1 restarts at 0 (this boot's rings start empty), w3 is kept; a power cycle invalidates the block; sel 1
clears all words. `build.py --build-dir` may lie outside the repo (absolute paths in its messages).
The engine no longer calls `step_isr()` after a fixed-reaction halt at a counted step (OI-FW-35).

**DIAG_MEAS model fidelity (v0.7.3, Validator E's HIL dry run, `00_System/tools/hil/`).**
- OBS-E-HG-01 (fixed): the RX probe source triggers at the falling edge of the **start bit** of a received byte
  (byte end − 10 851 ns at 921 600 Bd), as on the board; earlier models triggered at the end of the stop bit.
- OBS-E-HG-02 (fixed): STIM_RUN: each pulse = random delay (0…1 step period) + `hold`; the next delay starts at the
  end of the hold (board `meas_f4.c`); earlier models added another `hold` of idle time per pulse.
- OBS-E-HG-03 (partly fixed, rest documented): the twin has **no ISR latency** — an input's HAL fixed reaction (E-stop
  → ENA disabled, PUL stopped) and its core callback run at the virtual instant of the input change. A probe capture
  (CCR2/3/4) of an edge caused at the trigger instant therefore reports **1 tick** (board: CCRx = 0 means "no
  capture"). Latency budgets (≤ 100 µs / ≤ 1 ms) are only verified on the target (HG items); the twin checks the
  order of events and the reaction itself, not its latency.
- OBS-E-HG-05 / DEF-HG-01 (fixed): PWM-input mode as A's target after DEF-HG-01: a capture at each rising edge gives
  the period since the previous rise and the high time of the previous pulse; the first capture after arming is
  discarded, so min / max / count start with the second rising edge (min period no longer stuck at 0).
- v0.7.5 (OI-FW-47, OBS-M3-01): a PWM-input period longer than the 16-bit capture range (65 535 probe ticks) is recorded
  as 0xFFFFFFFF, as on the target (URS = 1). DWT section 23 (EXTI3 deferred E-stop callback) exists only on the target.
- Not modelled (unchanged): DWT statistics (op 9 w0 = 0), stamp rings surviving a reset, DMA latency (stamps exact
  to the virtual µs).

## Shared simulator / twin world-control vocabulary v2 (F-B-06, DEF-P1-03) — names FROZEN (ICD v0.4; v0.5: STOP-button names retired; v0.7.5: `inject step_stall` added)

Both the SW simulator (`io.sim.SimControl.act(action, **args)`, Implementer B) and the FW twin control port
accept the **same action names and arguments**, so differential tests (`03_SW/tests/integration/
test_sim_vs_twin.py`, Integrator) and validator suites drive both identically. Control port: one JSON object
per line over TCP 5761, `{"action": "<name>", ...args}`; reply `{"ok": true, ...result}` or
`{"ok": false, "error": "..."}`. Units: µm, counts, N, ms (µs where named `_us`); times without `at_us` act at
the current virtual time. Names are frozen from v0.4: a change needs a new action/argument name (old ones stay
accepted until both sides migrate) and an ICD version bump.

**Column M1** = required before M1 exit (Validator E / F M1 evidence); the rest before M2 entry. **Side**:
T = twin, S = simulator, both = both (differential tests use only "both" actions).

| Action | Arguments | Effect / result | M1 | Side |
|---|---|---|---|---|
| `estop` | `open: bool`, `drv_power_follows?: bool` (default true), `k1_delay_ms?: int` (default 20), `bounce_ms?: [int]` | E-stop sense input; if `drv_power_follows`, DRV_POWER drops `k1_delay_ms` later (K1 weld = `drv_power_follows: false`) | ✓ | both |
| `drv_power` | `on: bool`, `bounce_ms?: [int]` | DRV_POWER input / driver supply | ✓ | both |
| `button` | `name: "pause"`, `pressed: bool`, `bounce_ms?: [int]` | physical PAUSE button (polarity per `io.pause_active_level`); `name: "stop"` retired (v0.5, D-36) | ✓ | both |
| `limit` | `name: "start"\|"end"`, `active?: bool` (forced), `position_um?: int` (switch location), `bounce_ms?: [int]` | limit switches | ✓ | both |
| `wire` | `input: "estop"\|"start"\|"end"\|"pause"\|"alm"\|"pend"\|"drv_power"` ("stop" retired, v0.5), `broken: bool` | broken wire on any input (NC inputs read active / unpowered) |  | both |
| `chatter` | `input: <as wire>`, `period_ms: float`, `duration_ms: int` | periodic toggling (e.g. ALM 1 kHz chatter) |  | T |
| `alm` / `pend` | `active: bool` | driver outputs | ✓ | both |
| `driver` | `dir_wiring_inverted?: bool`, `pend_auto?: bool`, `pend_lag_ms?: float` (default 5) | DIR wiring / driver SW5 inverted in the world (x follows the DIR pin); automatic PEND (REQ-C-M2-06/07, v0.6) |  | T (S variant: `dir_wiring_inverted`; PEND always automatic, `pend_auto` / `pend_lag_ms` accepted and ignored) |
| `specimen` | `kind: "none"\|"spring"\|"bilinear"`, `k_n_per_mm`, `x_contact_um`, `k2_n_per_mm?`, `f_yield_n?`, `f_break_n?`, `relax_pct?`, `relax_tau_s?`; M4 (ICD v0.7.4): `side?: "pull"\|"push"\|"both"`, `k3_n_per_mm3?`, `break_travel_um?`, `break_residual_pct?`, `slip_at_n?`, `slip_mm?` | load model (relaxation modelled in the twin since v0.7.2; M4 sides / non-linearity / break by travel with residual / grip slip: see the M4 specimen model above) | ✓ | both (M4 args too: SWC-M4-01 closed, B's `io/sim/models.py` Specimen) |
| `weight` | `kg?: float`, `n?: float` (instead of kg), `g_mps2?: float` (default 9.80665) | v0.7.2 (M3 load calibration): known masses hung on the cell, force = kg·g (+ = tension, the sign of a pushed spring), adds to the specimen; 0 = removed |  | T (S variant implemented, SWC-M3-02) |
| `load_offset` | `counts: int` | cell zero offset (default scenario 50 000 counts ≤ 1 % FS, SWD-P1-15) | ✓ | both |
| `afe` | `rate_error?: float`, `noise_counts?: float`, `stall?: bool`, `saturate?: "pos"\|"neg"\|null`, `drop_every?: int`, `miss_next?: int` (single missed DOUT edges), `sck_overrun?: bool` (power-down symptom on the next read), `raw_script?: [int]` (next samples verbatim); v0.7.2: `drift_counts_per_s?`, `creep_pct?`, `creep_tau_s?`, `nonlin_pct_fs?`, `fs_n?` (cell model, see the AFE model above) | HX711 model | stall / rate / rails ✓ | both (`sck_overrun`: T; v0.7.2 cell terms in the simulator too) |
| `world_shift` | `um: int` | lost steps: shift `x_um_true` against the step counter (open-loop model; HOME_DRIFT tests); acts at once in every state, also while the step output runs (lost pulses mid-move: the move continues from the shifted world x, the FW count is unaffected; OI-F-BRU-02, twin self-test `test_world_shift_while_moving_lost_steps`) |  | both |
| `inject` | `fault: "step_fault"\|"tx_congestion"\|"rx_corrupt"\|"link_silence"\|"hang"\|"isr_storm"\|"loop_load"\|"step_stall"\|"drop_next"\|"duplicate_next"\|"delay_next"\|"corrupt_next"`, `duration_ms?`, `where?: "main"\|"tick"\|"isr1"` (hang / storm), `cmd?: <CMD name>`, `what?: "request"\|"response"`, `n?: int`, `ms?: int` | fault injection (per-command link faults = B's LinkModel hooks); v0.7.5 **`step_stall`** (`duration_ms`, 0 / absent = until the move ends): move stall without a FW stop cause, see "Move stall" below | step_fault, tx_congestion, link_silence, hang ✓ | both (`isr_storm`, `loop_load`, `where`: T) |
| `rx_bytes` | `hex: str`, `at_us?: int` | inject raw bytes into the FW RX at a virtual time (lock-step: exact) | ✓ | both |
| `on_frame` / `on_event` | `cmd` / `code`, `nth?: int`, `delay_us: int`, `then: {action…}` | run an action `delay_us` after the board received the nth matching request / sent the nth matching EVENT | ✓ | both |
| `flash` | `cut_after_word?: int`, `cut_in_erase?: int`, `reset?: "power"` | power cut during the next NVM program / erase (record integrity tests) | ✓ | T (S: record-level cut) |
| `iwdg` | `lsi_hz?: int` (17 000…47 000) | IWDG model clock |  | T |
| `clk` | `hse_fail: bool` | `hal_clk_fallback()` at the next boot |  | T |
| `clock` | `advance_ms?: int`, `advance_us?: int` | advance virtual time (lock-step only) | ✓ | both |
| `reset` | `cause: "pin"\|"power"\|"iwdg"\|"software"\|"hardfault"`, `pc?: int`, `cfsr?: int` | board reset, flash kept; `hardfault` = HardFault record (seam v1.2) + reset cause SOFTWARE (M2) | ✓ (hardfault: M2) | both (hardfault: T) |
| `query` | `what: "world"\|"pulses"\|"outputs"\|"edges"\|"seam_log"\|"wire_log"\|"sent"\|"flash"` , `since_us?: int`, `clear?: bool` (v0.6: drain after reading) | `world`: `x_um_true`, inputs, load (v0.7.2 twin: `specimen_n`, `weight_n`, `relax_n`, `creep_counts`, `drift_counts`, `raw_ideal` = raw without noise; M4: `specimen_broken`); `pulses`: PUL count (v0.7.5 twin: + `step_stalled`, `step_stall_armed`); `outputs`: ENA, RATE, LED, trip relay; `edges`: `[{t_us, pin: "PUL"\|"DIR"\|"ENA", level}]`; `seam_log`: `[{t_us, call, args}]`; `wire_log`: `[{dir, type, seq, first_us, last_us, hex}]`; `sent`: frames produced incl. dropped DATA; `flash`: write counter, records | world/pulses/outputs/edges/wire_log/sent ✓ | both (`edges`, `seam_log`: T; S returns its model equivalent where defined) |

**Move stall — `inject` `fault: "step_stall"`, `duration_ms?: int` (ICD v0.7.5; side both: twin `fw_twin`,
simulator `io/sim/board.py` `inject_step_stall`; the stimulus for the SW step-timeout guard SW-SEQ-007 TIMEOUT end
to end).** The board is open loop: a carriage that stops while the pulses go on is invisible to the FW (the move
still ends with MOVE_DONE), so the stall is modelled at the step-pulse output.
- Scope: the step output of the **running move** is frozen for `duration_ms` from the call; `duration_ms` 0 or
  absent = **until the move ends** (a stop); negative = refused. Injected while no move runs, the stall is **armed**
  and starts with the next move start (its duration counted from that start). A second call while stalled sets a
  new end from now. An MCU reset drops a running or armed stall.
- While frozen the move makes **no progress and the FW sees no stop cause**: no pulse completes; the step counter,
  `pos_steps` / `pos_um` and the world x (`x_um_true`; the carriage, hence the specimen load) stay constant; the
  motion state stays MOVING / HOMING / STOPPING; no MOVE_DONE, EVENT, fault or latch; DATA keeps MOVING. Twin: the
  step timer is frozen in its low phase — a pulse already high completes (and counts), the freeze starts at its end.
- End of the window: the pulse train resumes and the unchanged plan continues, so the move ends at its normal target
  / bound about `duration_ms` later with the usual MOVE_DONE (twin: the rest of the running period, exact;
  simulator: the next pulse one step period after the end; differences ≤ one step period).
- Any **stop** ends the stall. Immediate stop (STOP mode 0 — the sequencer's guard stop —, HALT, E-stop, limit or
  load-limit fixed reaction, MOVE_UNTIL_LOAD threshold): the frozen output halts at once, MOVE_DONE STOPPED at the
  frozen position, no pulse cut (the stall adds no POS_UNCERTAIN; an E-stop sets it as always, ICD §6.2). **Controlled stop** (STOP mode 1, link watchdog,
  PAUSE): model-dependent, **not compared** — the simulator lifts the stall and ramps down; in the twin the FW's stop
  ramp needs pulses (no seam call marks a controlled stop), so it starts when the window ends (clean-halt path, ICD
  §6.5: at once) and with `duration_ms` 0 the FW stays STOPPING until an immediate stop.
- Comparison (SIM-vs-twin, `test_sim_vs_twin_stall.py`): a stall that ends by itself (end position exact) and an
  immediate stop inside the window (positions within the time-triggered-stop tolerance, the position at the stop
  equal to the frozen one on each board, events exact).
- Twin extras: seam-log entries `step_stall_armed <duration µs>`, `step_stall_begin <end world µs | -1>`,
  `step_stall_end <frozen µs>`, `step_stall_halted <frozen µs>`; `query pulses` adds `step_stalled`,
  `step_stall_armed`.

Scenario file (`bird.bend.simscenario` v1, JSON, shared by simulator and twin):

```json
{
  "schema": "bird.bend.simscenario", "version": 1,
  "world": {"stroke_um": 300000, "start_switch_um": -1500, "end_switch_um": 301000,
            "cell_counts_per_n": 3285.0, "load_offset_counts": 50000,
            "specimen": {"kind": "spring", "k_n_per_mm": 50.0, "x_contact_um": 120000},
            "afe": {"rate_sps": 80, "rate_error": 0.005, "noise_counts": 45},
            "driver": {"lag_tau_ms": 5, "drv_power": true}, "estop_open": false},
  "params": {"motion.steps_per_mm": 800.0},
  "schedule": [{"t_ms": 5000, "action": "button", "name": "pause", "pressed": true},
               {"t_ms": 5100, "action": "button", "name": "pause", "pressed": false}]
}
```
M4 scenario keys of the specimen (twin): `world.specimen.side`, `k3_n_per_mm3`, `break_travel_um`,
`break_residual_pct`, `slip_at_n`, `slip_mm`.
v0.7.2 scenario keys of the cell model (twin): `world.afe.drift_counts_per_s` (alias `drift_counts_per_min`, the
simulator's name), `world.afe.creep_pct` + `creep_tau_s` (default 600 s), `world.afe.nonlin_pct_fs`, `world.weight_kg`,
`world.specimen.relax_pct` + `relax_tau_s`.
`params` = parameter overrides applied before the test (via SET_PARAM by the harness, not by the model).
`schedule` entries are vocabulary actions with `t_ms`. **Default load offset 50 000 counts** (≤ 1 % FS =
64 425 counts, the zero-balance allowance behind the FW threshold range, SRS A-02), so a default session does
not clamp the 110 % FS threshold; the clamping path (SAF-SW-002, D-29g) gets its own scenario
(`clamp.simscn.json`, offset 125 000 counts) (SWD-P1-15, advice to B).
