HawortiaCooper/Bird.Bend_Stend/00_System/specs/DECISIONS.md

# Decision log

Binding for all roles once **accepted**. Proposed decisions are listed for the product owner (PO).

| ID | Date | Decision | Status |
|---|---|---|---|
| D-01 | 2026-10-03 | Process, roles and layout mirror Thrust_Stand_HAW (`00_System/PROCESS.md`). | accepted (PO request) |
| D-02 | 2026-10-03 | `E:\Bavovna\Drone\Thrust_Stand_HAW` and `E:\Bavovna\Drone\Stefan` are read-only references. Reused code is copied into this repo with an origin note (`/* Origin: Thrust_Stand_HAW/02_FW/src/... @9473c68 */`). | accepted (PO request) |
| D-03 | 2026-10-03 | PC link: UART 921600 baud, 8N1, no flow control; every frame in both directions carries CRC-16. | accepted (PO request) |
| D-04 | 2026-10-03 | HX711 default: 80 SPS, channel A gain 128. | accepted (PO request) |
| D-05 | 2026-10-03 | Data frame fields: system time, payload version (1 B), flags (bit0 = data validity), AFE raw 32-bit, setpoint distance, CRC-16; binary with a leading separator. | accepted (PO request) |
| D-06 | 2026-10-03 | No hardware access (opening COM ports, flashing) until the PO confirms which board/port may be used. | accepted (Orchestrator, safety) |
| D-07 | 2026-10-03 | Hardware is available **later**: development and FW⇄SW integration first run against a PC simulator / FW host twin; on-target tests happen at a later gate approved by the PO. | accepted (PO) |
| D-08 | 2026-10-03 | "Start/stop switches" = **two end-of-travel limit switches** (START end, END end); one of them is the home/zero reference. No physical operator start/stop buttons. | accepted (PO) |
| D-09 | 2026-10-03 | FW framework: **PlatformIO + stm32duino** (as Thrust_Stand_HAW), LL/register access for timing-critical peripherals; Stefan is used only for pinout/board-init knowledge. | accepted (PO) |
| D-10 | 2026-10-03 | ~~E-stop under load: stop pulses, keep holding.~~ **Amended by D-11:** "stop pulses immediately, keep the driver enabled (holding)" applies to all **operational stops** (GUI STOP, Pause/Break, limit switch, FW load limit, stale/saturated AFE) = IEC 60204-1 stop category 2. Link loss and PAUSE use a **controlled** (decelerated) stop, also holding (D-15, D-26). | amended (PO, Q1) |
| D-11 | 2026-10-03 | **E-stop per IEC 60204-1 (power removal):** NC E-stop removes driver power in hardware, independent of the MCU (stop category 0; R5 to propose circuit). The MCU also reads the E-stop state → stops pulses, drops ENA, latches. Driver power loss = position lost → axis "not homed". Clear = button released + PC command + re-home. | accepted (PO, Q1) |
| D-12 | 2026-10-03 | FW hard load limit checked on **every** HX711 sample; ADC saturation = trip. Default 110 % FS (220 kg); **the PC can set it lower** (parameter), never above 110 % FS. SW limits (travel, load) on top. | accepted (PO, Q2) |
| D-13 | 2026-10-03 | MCU reset / power loss: the driver keeps holding (HBS86H: no ENA current = enabled); FW boots with pulses blocked, axis "not homed". | accepted (PO, Q3) |
| D-14 | 2026-10-03 | **Pause/Break key** = operational stop (holding) + sequence **terminated**, explicit clear. **Additional Pause/Resume**: a physical PAUSE button on an MCU input → controlled stop (holding), sequence paused, resumable (GUI Resume or button). | accepted (PO, Q4) |
| D-27 | 2026-10-03 | **Driver DIP setting (PFDE HBS86H label, 2 photos).** Block SW1..SW8 = 0 1 1 1 0 1 0 0. Label: SW1–SW4 pulse/rev (Leadshine table); SW5 motor DIR (off CCW / on CW); SW6 off = standard mode, on = start-up acceleration assist; **SW7/SW8 = motor select: on/on = 60 mm motor; off/on = 86-80 / 86-118; on/off = 86-151; off/off = 86 OPEN-LOOP, 6.0 A**; control inputs 5–24 V. 1 = ON is the only plausible reading (1 = OFF would select a 60 mm motor at 20000 p/rev). **Current setting therefore = 800 pulses/rev (160 steps/mm), CCW, acceleration assist on, 86 open-loop 6.0 A — the encoder is not used: missed steps are silent and no position-error ALM is possible.** Recommended: closed-loop motor setting matching the motor body length (86-80/86-118 → SW7 off, SW8 on; 86-151 → SW7 on, SW8 off) and 4000 p/rev (SW1 on, SW2 off, SW3 on, SW4 off). FW default steps/mm = 160 until changed/calibrated. Pending PO: motor label/body length, change to closed loop, pulses/rev choice, SW6. | **closed (PO 2026-10-03): "DIP change OK"** → target setting SW1..SW8 = on/off/on/off (4000 p/rev) · SW5 off (CCW, unchanged) · SW6 on (unchanged, compared at HW gate) · SW7 off / SW8 on (86-80/86-118 **closed loop**). Nominal **800 steps/mm** → `motion.steps_per_mm` default 800. The setup sheet must be applied (driver powered off) before the first FW motion; the first motion at the HW gate is a short slow jog that verifies direction and scale before any calibration. |
| D-28 | 2026-10-03 | **R5 defaults accepted** (`research/R5_interface_safety_hw.md` §7.1): E-stop Option A — 2-NC mushroom, NC1 drops a self-latching DC contactor (DILM7 class, 48 V coil from the driver PSU, blue RESET) switching +48 V to the driver, NC2 → MCU E-stop sense, contactor aux → driver-power sense (PA7); panel space reserved for a safety relay (Option B). **Axis is horizontal** (no gravity load, no brake; table may spring back when power is cut under load — accepted, releases the specimen). MCU trip-relay output (PB9) provisioned, unused in release 1. PSU Mean Well SDR-480-48. Interface board: perfboard for bring-up, SN74ACT244 shield PCB before calibration. Pin map R5 §6.1 accepted (DOUT PB4, RATE PB5, END PC1, STOP PC7 NC, PAUSE PB6 NO, DRV_POWER PA7, PA6 reserved). Driver tuning/current limit evaluated at the HW gate. Alarm reset = driver power cycle (E-stop + RESET); ENA-toggle reset tested on the bench. **Release 1: new motion is refused while ALM is active and driver power is present** (running moves unaffected; extends D-16). Following-error limit: factory value. ENA/driver-power settle ≥ 500 ms before the first pulse. | accepted (PO) |
| D-29 | 2026-10-03 | **Orchestrator P1 reconciliation (technical, within PO decisions):** (a) GUI Pause = FW PAUSE command 0x3B, same FW behaviour as the physical button; PAUSED clears on the next accepted motion command or HALT_CLEAR (F-B-03, SD-01). (b) Homing **only at the START switch** in release 1 (D-08/D-18; OI-ICD-01) — `home.ref_switch` fixed to START. (c) Driver power: E-stop sense open while DRV_PWR still present > 200 ms → fault K1_WELDED (contactor welded); DRV_PWR lost without E-stop → refuse motion, clear HOMED (position lost, D-11) (OI-FW-06, SD-02). (d) Controlled stop when the step period > 2 ms may be executed as a clean immediate halt (stop distance < 1 step) (OI-FW-07). (e) Speed limits split: travel 30 mm/s, under load 20 mm/s (R5, SD-03). (f) Accept ICD v0.1 SD-04…SD-10 (renames, session-only threshold params, reboot-required params, JOG no-bound sentinel, motion never auto-retried, max step rate 100 kHz, CLK_FALLBACK in GET_STATUS/EVENT). (g) SW FW-threshold computation clamps inward to the FW range (safe side) with a warning instead of refusing (F-B-07). (h) **First use / no calibration:** the operator may switch SW load limits off for the session ("no-specimen mode", explicit confirmation, banner); the FW load limit stays at its nominal default; travel calibration and the load-calibration wizard run in this mode (F-B-08). (i) Manual jog buttons: latest-wins — clicks accumulate on the commanded target; a target issued while moving is sent when the move completes (F-B-09). (j) Tare is session-only, never loaded from a file (F-B-13). (k) Dwell/settle measured from "target reached"; sequence travel targets are relative to the test travel zero by default (F-B-20). (l) AFE-config mismatch invalidates the calibration for load limits (F-B-22, stricter). (m) Reused Thrust_Stand code may be copied from its current HEAD; the commit hash is recorded in the origin note (F-B-11). (n) Ownership: Implementer B owns `03_SW/src/bend_stand/__init__.py`, `__main__.py`, launch scripts and `03_SW/tests/conftest.py`; Implementer D owns `gui/__init__.py` (F-B-12). | accepted (Orchestrator) |
| D-30 | 2026-10-03 | **PAUSED is a motion-blocking latch (amends D-29 a; closes OI-ICD-04 race).** While PAUSED, every new motion start (MOVE_ABS, MOVE_UNTIL_LOAD, HOME, JOG with v ≠ 0 incl. refreshes) is refused with E_STATE + BLOCK bit PAUSED; STOP/HALT/PAUSE/JOG 0 and all clears stay accepted. PAUSED is cleared **only by HALT_CLEAR** (the PC's Resume action), never implicitly by a motion command — so a command already in flight when PAUSE is pressed cannot restart motion. Resume (GUI Resume or button RESUME_REQUEST) = PC sends HALT_CLEAR, then re-issues the interrupted step's absolute target. **Controlled-stop clean-halt substitution (OI-ICD-05):** allowed only when the step period > 2 ms **and** the planned stop distance v²/(2·a_stop) ≤ 1 step (FW computes it); otherwise the FW decelerates as planned. Ownership: `00_System/specs/protocol.yaml` belongs to the Integrator. | accepted (Orchestrator) |
| D-31 | 2026-10-03 | **Dedicated RESUME command (amends D-30; closes F-B-30 race).** New command RESUME (0x3C, no payload): clears **only** PAUSED; refused (E_STATE with BLOCK mask) while HALT, ESTOP or any fault is latched — so a STOP-button HALT latched just before a Resume frame can never be cleared by it. HALT_CLEAR clears HALT and also PAUSED (a HALT terminates the sequence; clears never start motion). SW Resume = RESUME, then re-issue the interrupted step's absolute target. Ownership: Implementer B also owns `03_SW/requirements*.txt` (F-B-31). | accepted (Orchestrator) |
| D-32 | 2026-10-03 | **PO answers Q25–Q28.** Q25: motor label **SIHONG 86HS2140-06-001** (8.2 N·m, 6.0 A, 0.5 Ω, 140 mm, encoder to driver; = R2 §2) → closest PFDE motor profile is "86-80 / 86-118" (SW7 off, SW8 on; electrically ≈ Leadshine 86HS80-EC 8 N·m 6 A) for closed loop — recommendation, DIP change pending PO (see D-27); limit switches mechanical NC (= D-18). **Q26: when a load-target step does not reach its target load, the axis keeps travelling in the step direction up to the end of travel (soft limit before the end switch; the NC end switch is the backstop) and stops there; the step is marked NOT_REACHED and the sequence stops.** The approach bound of MOVE_UNTIL_LOAD is therefore the soft limit in the step direction; the step timeout must not abort earlier (timeout = travel time to that bound + margin); BREAK_DETECTED (load drop > 20 % of running max) still aborts. Q27: GUI defaults accepted (SW_design_GUI GQ-01…20). Q28: Pause/Break hotkey does not reach elevated windows — accepted known limitation. | accepted (PO) |
| D-33 | 2026-10-03 | **Orchestrator decisions on the P1 validator reviews.** (a) AFE stale timeout: default 250 ms + hard rule `afe.timeout_ms` ≥ 2 × configured conversion period (DEF-P1-01). (b) Sequence start is refused while POS_UNCERTAIN, AFE_RATE_MISMATCH, PAUSED, ALM active or DRV_PWR off (SWD-P1-04/08); the steady-state mask stays as specified. (c) ALM becoming active during a sequence → SW sends a controlled STOP and terminates the sequence (SW policy; FW still only reports, D-16) (SWD-P1-14). (d) Load-step approach bound (D-32) = the nearer of the soft limit and an enabled SW travel limit in the step direction; reaching it without the target load = NOT_REACHED (not a limit trip); step timeout = 1.2 × travel time to the bound + 10 s (SWD-P1-18). (e) SAF-FW-018 target test: reset with the specimen under ≥ 98 N (10 kgf) tension on the horizontal axis, axis motion ≤ 0.01 mm (DEF-P1-05). (f) During an NVM erase/program (idle only) the DRV_PWR reaction bound is extended to the operation time + 25 ms (DEF-P1-06); K1_WELDED latches ≤ `drv.k1_weld_ms` + 25 ms (OBS-P1-02). (g) Idle disable is not applied while the AFE is stale (unloaded state cannot be confirmed) (OBS-P1-05). (h) A limit latch clears when the input has been released for `io.release_ms`; only motion away from the switch is accepted while latched (OBS-P1-06). (i) Supported PC runtime: **Python 3.14** (as installed on the dev PC; the app ships with its own venv); no separate 3.11 test (SWD-P1-16). (j) Reference PC for NFR-001…004 = the PO's lab PC; spec to be supplied by the PO before M3 (SWD-P1-17). (k) A motion command refused with BLOCK PAUSED is an expected outcome (no retry, no link-degradation count) (SWD-P1-03). | accepted (Orchestrator) |
| D-34 | 2026-10-03 | **Clear commands are never auto-retried (closes OI-ICD-08).** HALT_CLEAR, ESTOP_CLEAR and FAULT_CLEAR move to retry class VERIFY (still sent on the priority lane, bypassing queues): a lost response is resolved by GET_STATUS, never by re-sending — so a retried clear can never wipe a new STOP-button HALT, E-stop or load-limit trip raised in between. Same rule as RESUME (D-31). | accepted (Orchestrator) |
| D-35 | 2026-10-03 | **P1 gate (PO review of REVIEW_PACKAGE).** G1: D-29…D-34 confirmed. G2: start with 1 kg + 10 kg (LOW_SPAN warning accepted); a heavier reference may come later. G3: no answer → default, nothing missing in SW items 9–11. **G4: the E-stop and the physical STOP are the same button** → board inputs: STOP and PAUSE buttons; SW: STOP and PAUSE (exact semantics of the combined button: see D-36). **G5: plan without oscilloscope / logic analyzer** → HW-gate timing evidence must come from on-chip measurement (DWT/timer capture, e.g. PUL looped back to a timer input) and the PC. G6: lab PC spec still due before M3. **G7: P2 started — M1 (link & skeleton) on the simulator/twin, D-06 stays in force.** | accepted (PO) |
| D-36 | 2026-10-03 | **One red STOP = E-stop (amends D-26 (2), D-28).** There is a single physical red NC mushroom button: it cuts driver power through the contactor (R5 Option A, RESET to re-close) and its second NC contact is the MCU E-stop sense (PA10). **There is no separate physical holding STOP/BREAK button**: SAF-FW-022 (physical STOP → HALT) is withdrawn, the STOP-button input (PC7), `io.stop_active_level`, status bit STOP_BTN and HALT source BUTTON are retired. Holding stops remain in software: GUI STOP and the Pause/Break key (HALT). Physical **PAUSE** button (NO) stays. Both buttons are on a **separate operator panel** wired to the interface board. Side effect: PC7 is free again → FW_design R-01 (USART6 fallback clash) is resolved. Applied as change request **CR-01** at the M1 gate (SRS v0.5, ICD v0.5, params/protocol, pinout, designs, test plans) — M1 code does not implement the button inputs (M2 scope). | accepted (PO) |
| D-37 | 2026-10-04 | **M1 gate interface decisions.** (a) OBS-M1-01: commands received during an NVM SAVE (idle only) are answered after the flash operation (≤ erase + program time); this is an accepted exemption to the response-time and stop-path budgets because no motion is possible during SAVE. The SW sends **no non-stop command while a SAVE is outstanding** (stop-class frames stay allowed and are executed right after the flash op), so the FW RX ring cannot overflow. (b) IF-C-M1-02: while a feature bit (e.g. FEAT_DRV_SIGNALS) is 0 in GET_INFO, the related status bits (ALM, PEND, DRV_PWR) are sent as 0 and are **invalid** — the SW shows them UNKNOWN; the simulator mirrors the FW feature mask. (c) RESUME stays on the CONTROL lane (not "never delayed"); SRS IF-011 lists only STOP/HALT/PAUSE and the clears (priority path). (d) STOP confirmation must be ordered by FW device time (`t_us` of the indication ≥ FW receive time of the STOP), not only by the PC receive stamp (OBS-M1-R1) — B before M2. | accepted (Orchestrator) |
| D-38 | 2026-10-04 | **Plot panes as in Thrust_Stand (PO request after running the M1 SW).** Adopt Thrust_Stand_HAW SW-RT-004 / D-62 / D-63 (@37c8747, incl. its plot-performance fix): each plot window holds plot panes in a grid of 1/2/3/4 columns (per window); user can add panes ("New pane", "Plot in / move to pane N"), reorder by drag and drop, move a pane with its curves to another plot window, rename and close panes; a newly shown channel joins the first pane showing the same quantity, else an empty pane is reused before a new one is created; unticking removes only the curve, emptied panes are kept for reuse; X axis (time) linked inside a window; the X-Y (travel–load) view is a pane type; layout (columns, order, curves per pane) restored at next start; one data snapshot per distinct time window for all panes. New requirement SW-RT-006 (M1 add-on, Implementer D). | accepted (PO) |
| D-39 | 2026-10-04 | **M2 started (PO "go ahead with M2").** M1 close-out items (CR-01, D-37, OBS-M1-R1, SAVE quiesce, feature-bit validity) are folded into the M2 work of each role; ICD v0.5 lands during M2. **HX711 driver is reused from Thrust_Stand_HAW @37c8747** (PO: already done there): `02_FW/src/sens/hx711.{cpp,h}`, `src/pure/hx711_math.{c,h}`, `src/pure/hx711_seq.h` (+ its `test/test_val_hx711` as reference), ported to F446 seams (DOUT PB4/EXTI4, SCK PB10, RATE PB5) with origin notes. | accepted (PO) |
| D-40 | 2026-10-04 | **M2 entry decisions (Validator E's v0.3 plan).** (a) LIMIT_WIRING (both limit inputs active): FAULT_CLEAR is accepted once the inputs are no longer **both** active (ICD rule); an input still active keeps acting as a normal limit latch (motion toward it refused) — SRS SAF-FW-014 aligned to the ICD (OBS-E-M2-08). (b) Ramp total-duration tolerance = ±ceil(N/1000) ticks (vectors rule); SRS FW-MOT-003 aligned (REQ-C-M2-11). (c) CR-02 hardware-gate measurement approach accepted: loopback jumpers (PUL→PC7/PB7, DIR→PC9, ENA→PC8, event→PC6, 2nd input→PA11, stimulus PB8, 1 kΩ series), `HW_MEAS` build with byte-identical safety handlers, diagnostic command **DIAG_MEAS (0x3D)** present only in HW_MEAS builds (feature bit FEAT_HW_MEAS; release build answers NOT_IN_BUILD). (d) Load-limit regrow reference stays valid until the load is back inside the thresholds or the next FAULT_CLEAR (Integrator to state it in the ICD) (OI-E-M2-03). | accepted (Orchestrator) |
| D-41 | 2026-10-04 | **No power-removal contactor — E-stop is MCU/FW only (PO; amends D-11, D-28 E-stop circuit, D-36). CR-03.** The red NC button goes only to the MCU E-stop sense input (PA10). FW reaction unchanged: last PUL edge ≤ 100 µs, ENA driven to *disabled* ≤ 1 ms (driver de-energises the motor; load may back-drive), ESTOP latched, not homed; clear = released + PC ESTOP_CLEAR + ENABLE + HOME. There is no hardwired channel: the stop depends on the MCU, FW and the ENA line (3.3 V direct drive until the buffer board). Driver-power sense / K1_WELDED have no contactor to watch → `drv.pwr_sense_enable` default **0** (feature kept, optional 48 V presence sense). **Residual risk (stated to the PO):** not an IEC 60204-1 emergency stop; an MCU fault is covered only by the IWDG (≤ 100 ms → reset → boot with E-stop open drives ENA disabled). Orchestrator recommendation offered: a hardwired ENA-disable path (extra NO contact on the E-stop driving the ENA opto directly), independent of the MCU, ≈ €5. HW-gate answers: multimeter available; SWD possible but least preferred (board installed remotely) → DIAG_MEAS is the primary evidence path, SWD fallback only; bench safety procedure for E-stop sense stimulus: Validator E proposes. Applied at the M2 gate (SRS v0.6, ICD v0.7 default change, wiring/pinout, test plans). | accepted (PO) |
| D-42 | 2026-10-04 | **Hardwired ENA cut on the E-stop (PO, completes D-41).** The E-stop button gets an additional **NO contact** that drives the HBS86H ENA opto to *disabled* directly (ENA+ fed from a local 5 V supply through a resistor, OR-ed with the MCU drive via the buffer board / diode), independent of the MCU. The NC contact stays the MCU sense (PA10). The FW must tolerate the externally forced ENA state (no fault on read-back mismatch while E-stop is active). Implementer A designs the circuit in `01_HW/wiring.md` (with the buffer board), Validator E adds HG checks (E-stop with MCU held in reset → motor de-energised; multimeter on the ENA opto). Part of CR-03. | accepted (PO) |
| D-43 | 2026-10-04 | **M2 gate decisions.** (a) DEF-M2-01 and DEF-M2-02 are fixed now (no waiver), re-verified by Validator E before the M2 gate closes. (b) OBS-M2-02 un-homed jog bound: the un-homed travel window is measured from a fixed **un-homed origin** latched when the axis becomes un-homed (boot, ENABLE after power-up, E-stop, DISABLE, homing failure), not from each jog start: un-homed JOG/HOME motion stays within origin ± `home.max_travel_um`; a held jog that reaches the bound stops and further JOG toward it is refused (E_RANGE) until homed. (c) OBS-M2-06 ALM chatter at the 1 kHz poll rate: accepted limitation (ALM is report/start-block only, D-16/D-28), noted in FW_design. (d) M2 close-out applies CR-03 (D-41/D-42) everywhere: SRS v0.6, ICD v0.7 (`drv.pwr_sense_enable` default 0), wiring/pinout v0.5 with the D-42 circuit, SW texts. (e) SRS OI-18: K1_WELDED check gets its own parameter `drv.k1_check_enable` (default false, reboot-required); it latches only with both pwr_sense and k1_check enabled. | accepted (Orchestrator) |
| D-44 | 2026-10-05 | **M2 gate ACCEPTED WITH CONDITIONS; M3 started (PO "continue").** M3 scope: SW application (manual control, Safety limits / Test marks / Calibration & Tare tabs, travel + load calibration wizards, tare, PC load limits SAF-SW-001/002 calibrated path, no-specimen mode, recording + take sample, derived channels, hotkey test dialog). In parallel: Validator E prepares HW-gate scripts (`00_System/tools/hil/`, dry-run on the twin `--hw-meas`); Implementer A implements MOVE_UNTIL_LOAD (FW-MOT-006, M4 scope pulled forward — FW has slack); Integrator: sim-vs-twin motion subset (MC2-6), per-run private twin binary (OBS-M2-09), M3 integration flows with a load model. | accepted (Orchestrator) |
| D-45 | 2026-10-05 | **HW-gate plan decisions (Validator E's HIL dry run).** (a) OI-E-HG-01: HG-10c text corrected — with the MCU held in reset, releasing the E-stop lets the ENA pull-down re-enable the driver (holding, no pulses possible); accepted, the check is "de-energised while pressed". (b) OI-E-HG-02: the §6.8 bench window is 5…55 mm next to START (each E-stop trial forces a re-home). (c) OI-E-HG-03: 50 kHz / 10 kHz pulse-train checks run with the 48 V PSU off. (d) OI-E-HG-04: HG-04a uses a real button press on the predicted erase SAVE. (e) OI-E-HG-05: pulse-timing defaults get a margin over the driver minimum so rule 4 can pass: `motion.pulse_high_ns` 12 500, `motion.pulse_low_min_ns` 12 500, `motion.max_step_rate_hz` 40 000 (≥ 24 kHz needed for 30 mm/s at 800 steps/mm); the HG budget stays the driver minimum (10 µs). (f) OI-E-HG-06: HG-29c self-test uses a 10 ms hold + stamp/probe consistency. (g) OI-E-HG-07 (ENA node on J-EVT): deferred, optional. (h) DEF-M3-01 (stale sniffed-stop hold) and DEF-HG-01 (first PWM-input capture) are fixed by A before the HW gate. | accepted (Orchestrator) |
| D-46 | 2026-10-05 | **M3 gate ACCEPTED WITH CONDITIONS; M4 (Sequencer) starts.** M4 scope: sequence editor (travel / load-target / hold / home / tare / mark steps), loops, generator wizards, save/recall, sequence chart x = travel / y = load with moving marker, sequence execution engine with VALID windows and pause/resume, load-target steps (MOVE_UNTIL_LOAD approach + trim, NOT_REACHED, BREAK_DETECTED), steady-state extraction and the test report (CSV + JSON + HTML, optional 3-point bend). M4 entry also fixes SWD-M3-02 (trip-clear toast). | accepted (Orchestrator) |
| D-47 | 2026-10-05 | **M4 integration decisions.** (a) OI-C-M4-02: the FW link watchdog clears VALID (and reports it with the existing VALID-auto-clear EVENT) on timeout **in every motion state**, not only while moving; motion-stop behaviour on link loss is unchanged (controlled stop only while moving). Closes the gap "PC silent during a capture leaves VALID = 1" (SW-SEQ-004). A implements, Integrator states it in the ICD. (b) OI-C-M4-01: the Integrator may run the generator for ICD v0.7.4 (vocabulary-only additions: twin `specimen` arguments side / k3 / break_travel / residual / slip); generated files are the Integrator's to regenerate. (c) Validator F's TC-SW-SEQ-007-03 text is aligned to SRS SW-SEQ-007 / D-33 c (ALM during a sequence → controlled STOP + terminate). | accepted (Orchestrator) |
| D-48 | 2026-10-05 | **Sequence guard parameters (B's M4 design choices, accepted).** Guards arm once |F| ≥ max(5 % of the step target, 1 % FS); SLIP threshold floor 0.5 % FS; BREAK_DETECTED is evaluated before SLIP and only while a command increases |F|; plan estimates: trim 1 s, HOME at 10 mm/s + 5 s, TARE = window + 1.5 s. Validator F verifies them against SW-SEQ-007; the PO may tune them after the first real tests. | accepted (Orchestrator) |
| D-49 | 2026-10-05 | **PO decisions before P3.** (a) OBS-M4-02: BREAK_DETECTED also at standstill — during a hold or capture (no command changing |F|), a load drop of more than 20 % of the running maximum within 0.5 s stops the sequence (BREAK_DETECTED); the 0.5 s window keeps slow relaxation from triggering it; the guard still arms per D-48; samples before t_reached + 100 ms are ignored (HX711 filter lag after a fast move — same settle allowance as the trim; Orchestrator-confirmed). (b) Bench safety procedure FW_test_plan §6.8 with the D-45 changes is **approved by the PO**; the gate date is not yet set → **no D-06-GATE approval row exists yet** and D-06 stays in force (the HIL scripts open no port until a dated, approved D-06-GATE row is recorded). | accepted (PO) |
| D-50 | 2026-10-08 | **Pre-P3 Orchestrator decisions (tasks 1–7).** (a) F-B-COV-01: a 2-point load calibration with no weight actually hung was accepted (K wrong sign, ≈16 000 × nominal) because the K ≈ 0 check cannot trigger with two points. Plausibility rule added to SW-CAL-007: a weight point whose raw change from the zero point and from the previous point is < 10 × std_zero (min 50 counts) is refused ("weight not detected"); a fitted \|K\| outside 0.5…2 × the nominal \|K\| derived from the configured cell / AFE needs explicit operator confirmation (recorded). No sign check (negative K stays legal, wiring polarity). (b) F-B-PKG-03: SW-PLT-001 covers the self-contained Windows distribution (DM-02 runs on it); the venv route stays for development. (c) OI-C-075-04: the check-vector state gets an `ena_on` key (state_schema 4) for the FWR-09 STATIC_LEVEL rule after A's FWR fixes land; A, B and E update their replays in the same round. (d) Code signing of the distribution (F-B-PKG-02) and the D-42 periodic-check interval (OI-UM-04) are PO decisions; until then: unsigned build, check at the start of every test campaign. | accepted (Orchestrator) |
| D-51 | 2026-10-08 | **ISR budget verdict path (OI-FW-45/46).** A's rework (FW_design v0.8 §9.8, `02_FW/tools/isr_wcet.py`) gives path bounds that include bus wait states and cold flash: E-stop level-0 handler 1.33 µs conservative / 1.06 µs nominal (budget 1 µs), step ISR 3.52 / 2.29 µs (budget 2 µs). The safety outcomes have large margin (PUL inactive 0.49 µs after the E-stop edge vs ≤ 100 µs; ENA disabled 1.08 µs vs ≤ 1000 µs). Decision: NFR-007 stays as written and is judged, as its acceptance column says, on the DWT measurement at HG-18 (sections 1, 2, 3/4, 23); the static bounds are informative and the bus constants are calibrated there (OI-FW-46). If HG-18 measures the step ISR > 2 µs or the step-generation load > 15 % at the configured maximum rate, the fixed-point ramp (R4 §1.5, OI-FW-45 b) is the prepared remedy and becomes a defect fix; if the E-stop handler measures > 1 µs it is a defect against A. No budget is restated now. | accepted (Orchestrator) |
| D-52 | 2026-10-09 | **Level-1 handler budget and the FW re-check follow-ups (OI-E-RC-01).** NFR-007's \"E-stop/STOP ISR ≤ 1 µs\" applies to the level-0 E-stop reaction (`EXTI15_10`, DWT section 2); the \"≤ 1 µs\" for critical sections masking levels 0–2 is unchanged. The level-1 handlers (START/END `EXTI0/1`, PAUSE `EXTI9_5`, deferred E-stop callback `EXTI3`; sections 3/4, 23) are not E-stop/STOP ISRs; their pinout §4 \"≤ 1 µs\" was a design target derived from FW-TIM-001. They get a design budget of **≤ 2.5 µs each (measured)**, plus the derived HG-18 check **step ISR + largest level-1 handler ≤ 5 µs** (HX711 timestamp latency, FW-TIM-001). Exceeding either is a defect against A. A updates pinout §4 / FW_design §9.8; Validator E updates the HG-18 criteria. Re-check verdict (FW_code_review v0.6 §10): FWR-01…10 closed; new Low FWR-16 (ENABLE re-drives ENA after an E-stop edge inside the check window, ≤ 1 ms, the D-42 hardwired cut holds) and FWR-17 (tick-path restart misses an edge recorded before the generation capture) → A, to be fixed before the HW gate. | accepted (Orchestrator) |
| D-53 | 2026-10-09 | **SW review decisions (SW_code_review v1.1, OI-F-RV-01/02).** (a) SWR-03: motion commands require a valid load input (calibration + tare in this session, no AFE fault) or the no-specimen mode, independently of which SW load limits are enabled; switching both SW load limits off outside the no-specimen mode is refused; a session file with both off is restored with both on and a warning (SRS v0.6.6 SW-LIM-003). (b) SWR-16: the session `pull_dir` is the single source of truth; a sequence file's `pull_dir` is checked at start and a mismatch refuses the start (SW-SEQF-001). (c) Gate conditions: SWR-01/02/03 fixed before the first specimen test at the HW gate; SWR-04/05/07 before recordings count as evidence; SWR-14 (log file) before the HW gate; all other SWR in the pre-P3 batch where cheap, S4 items may stay backlog with a recorded reason. | accepted (Orchestrator) |
| D-54 | 2026-10-10 | **PO answers after tasks 1–7.** (a) Travel calibration shall be available and independent of the load calibration (PO: it was greyed out — cause: the D-53 a motion gate refused every move without a valid load input, making the wizard's own "no specimen mounted" confirmation unreachable). The travel-wizard start is exempt from LOAD_INPUT_INVALID: it asks for the "no specimen mounted" confirmation and runs in a wizard-scoped no-specimen state (PC load limits off only for the wizard's moves, FW load limit at nominal defaults, banner, event, limits restored at finish / cancel / abort per SWR-29); a non-homed axis is homed as the wizard's first step in the same scope. All other motion keeps D-53 a. SRS v0.6.7 SW-CAL-002. (b) 20 fps with the 600 s window on 4 plot windows is desired → new NFR-009 (Should); try GPU (OpenGL) rendering. (c) Recordings-folder picker in the GUI (SW-ACQ-002). (d) Driver-alarm reset procedure confirmed: E-stop → 48 V off/on → release → Clear E-STOP → Enable → HOME (OI-UM-02 closed). (e) D-42 ENA-cut check at the start of every test campaign confirmed (OI-UM-04 closed). (f) No code signing (F-B-PKG-02 closed). (g) Prepare the fixed-point step ramp now as a selectable FW build (default image unchanged; OI-FW-45 b) so a second image is ready at the gate. (h) HW gate date and reference-PC runs wait for the PO's go. | accepted (PO) |
| D-55 | 2026-10-10 | **D-54 g re-planned (OI-FW-45).** A's analysis: on the Cortex-M4F a fixed-point exact-sqrt ramp that keeps FW-MOT-003 (±1 tick, ~2^-26 relative precision) needs 64-bit Newton steps / library division and would be break-even or slower than the float path (VDIV/VSQRT 14 cycles each); the AVR446 recursion breaks ±1 tick. The Orchestrator's premise for D-54 g (fixed point = faster) was wrong. Replacement, same intent (a faster step ISR ready before the gate): A trims the float step-ISR path without behaviour change (branch-free clamps, register return, shorter bookkeeping; the seam change "count passed into step_isr" only with the Integrator and only if needed), target nominal ≤ 2.0 µs; ramp bit-exact, twin unchanged, verified by Validator E; HG-18 measurement decides (D-51); re-budgeting only on the measured figure. The fixed-point image is not built unless the PO asks for it as an experiment. | accepted (Orchestrator), PO informed |
| D-56 | 2026-10-14 | **PO: operator bring-up without an agent.** PO: no buffer board will be fitted; the operator flashes the board; the application runs on the operator's PC with no agent; the app shall collect the bring-up data and pack them into a zip that the operator sends to the PO. (a) New SW-BRU-001…004: a Bring-up assistant in the app (steps = the bring-up guide's step ids, automatic evaluation where the board shows the result, operator entries otherwise, continuous collection, resumable session, *Create bring-up package* zip with HTML + JSON + manifest). Step definitions are a data file shipped with the app, authored from the guide by A, schema and engine by B, GUI by D, safety review of the step content by Validator E, validation by Validator F. The assistant never bypasses gates (SW-BRU-004). (b) SYS-011 amended: the direct 3.3 V drive stays; before calibration / test campaigns it is qualified by I_LED ≥ 6 mA on ENA and DIR (shunt, C-06) and a pulse-integrity check (full-speed moves over the stroke, re-home, no HOME_DRIFT, offset within the FW-HOM tolerance), repeated after wiring changes and at the end of each campaign; the buffer board is required only if that qualification fails. Residual risk: a dropped pulse during a test is not detected until the end-of-campaign re-home (added to the known limitations). (c) The gate kit (HW_MEAS images) is separate from the operator package; how the formal HG items are run without an agent on the bench PC is open (PO question). | accepted (PO) / (b) Orchestrator, for PO confirmation |
| D-57 | 2026-10-14 | **PO: build the gate runner.** The formal HW gate is run by the operator alone with a frozen gate runner shipped in the gate kit (Validator E's proposal, ≈ 5–6 person-days): (a) the existing HIL session (`00_System/tools/hil`) packaged like the app (PyInstaller, no Python / repo needed), plain-language operator prompts with jumper pictures (A), fail-safe stops and BENCH-EXIT as today; (b) the D-06 interlock without the repo: an **approval file** generated by the Orchestrator from the dedicated `D-06-GATE-YYYYMMDD` row (board UID, validity date, kit and image hashes, runner version, accepted-open items), checked by the runner before any port is opened; any mismatch refuses; (c) the runner writes one results zip (session JSON, raw frame log, probe / DWT data, timestamped prompt answers, photos, manifest with hashes of runner and images) that the operator sends to the PO; Validator E evaluates it offline with a new analysis tool and writes `FW_test_report_HG1`; (d) known limits accepted by the PO: manual items are operator-attested, no live diagnosis or on-the-spot finer repeats (a second session instead), §6.8 bypass trials need a second person on site; (e) agents still never open a COM port or flash (D-06); the runner is used only by the PO's operator. Owners: Validator E (lead, runner logic, approval-file spec, offline analysis), B packaging (frozen build, smoke), A (jumper / bench pictures), Integrator (independent review), Orchestrator (approval-file generation tool and record). | accepted (PO) |
| D-26 | 2026-10-03 | **Operator controls, physical + SW pairs:** (1) physical **PAUSE** button on an MCU input + GUI Pause/Resume → controlled stop (holding), sequence paused, resumable; (2) physical **STOP/BREAK** button on an MCU input + GUI STOP + Pause/Break key → operational stop (holding, D-10) and sequence **terminated**; (3) NC **E-stop** = power removal (D-11). Physical STOP acts in FW without the PC. Contact type of PAUSE/STOP: NC recommended for STOP (R5 to confirm). | accepted (PO, 2026-10-03) |
| D-15 | 2026-10-03 | Link watchdog 1 s while moving → controlled stop, holding, validity flag cleared. Idle auto-disable after 600 s only if load < 2 % FS. Homing allowed with load < 5 % FS, else operator confirmation. | accepted (PO, Q5–Q7) |
| D-16 | 2026-10-03 | Driver: **PFDE (普菲德) HBS86H** — Leadshine-compatible clone (identified from the label photo 2026-10-03; PO had assumed genuine Leadshine); rated 24–100 VDC / 18–70 VAC; supplied from **48 V DC** (PO raised it from 24 V, which was below the 30 VDC datasheet minimum). Timing defaults as parameters: PUL high/low ≥ 10 µs, ≤ 50 kHz, DIR setup 20 µs; 4000 pulses/rev. **ALM and PEND are wired**; first release reads and reports them only, no automatic reaction (to be added later). | accepted (PO, Q8, Q10) |
| D-17 | 2026-10-03 | Driver inputs are currently driven **directly from 3.3 V MCU pins, wired common-cathode** (PUL−/DIR−/ENA− to GND; PO confirmed; Stefan wiring, proven running per D-24); a 5 V buffer interface board is optional — R5 prepares a proposal. | accepted (PO, Q9) |
| D-18 | 2026-10-03 | Limit switches: **mechanical NC**, both ends wired. START = home end. | accepted (PO, Q11) |
| D-19 | 2026-10-03 | Mechanics: **SFU1605 ball-screw table** (16 mm, 5 mm lead — PO confirmed), **300 mm stroke**; nominal 800 steps/mm at 4000 p/rev (direct drive ASSUMED). Required speed ≤ 10 mm/s; more is welcome. Max force 200 kg = cell FS (more needs a bigger cell). | accepted (PO, Q12) |
| D-20 | 2026-10-03 | Load cell **Keli DEF 3.0 mV/V, tension + compression**, pull positive; one calibration (no separate push calibration). | accepted (PO, Q13, Q20) |
| D-21 | 2026-10-03 | HX711: **RATE wired to an MCU GPIO**, 3.3 V supply, default **80 SPS**; FW measures the real sample period and flags a mismatch. | accepted (PO, Q14) |
| D-22 | 2026-10-03 | Nucleo: Stefan's board; re-wiring allowed. Powered from PC USB or a separate DC-DC; driver from a separate supply (48 V, D-16). Calibration weights: **1 kg and 10 kg**. | accepted (PO, Q15, Q16) |
| D-23 | 2026-10-03 | DATA frame: PO fields + u16 frame sequence counter + status flags (VALID, MOVING, LIMIT, ESTOP, fault…); **one frame per HX711 sample**; 32-bit µs timestamp. Manual slider = target position on release + hold-to-jog buttons; ±0.1/1/10 mm become absolute targets (no relative moves on the wire). **Load-target sequence steps are mandatory** (approach + trim). Linearity PASS ≤ 0.1 % / WARN ≤ 0.5 % span; caliper; travel step 2 over total 60 mm. Report: raw CSV + JSON metadata + HTML summary; 3-point-bend stress/strain can be enabled. Motor 86HS2140-class, 1000-line encoder. | accepted (PO, Q17–Q22) |
| D-24 | 2026-10-03 | Stefan's stand **did run and control the driver** (PO): its PUL/DIR wiring and direct 3.3 V drive work in practice; ENA was never driven (consistent with "no current = enabled"). Stefan's ~3 µs pulses worked → our 10 µs default is conservative. | accepted (PO, Q23) |
| D-25 | 2026-10-03 | Git: the Orchestrator commits at each gate (P0 committed 2026-10-03). | accepted (PO, Q24) |
