HawortiaCooper/Bird.Bend_Stend/00_System/specs/SRS.md

# Bird Bend Stand — System Requirements Specification (SRS)

| Doc | SRS |
|---|---|
| Version | **0.6.8 — DRAFT for Orchestrator review** (CR-03: no power-removal contactor, hardwired ENA cut; D-41…D-43) |
| Date | 2026-10-03 |
| Owner | Orchestrator (`00_System/specs/SRS.md`); draft prepared on the Orchestrator's behalf |
| Binding inputs | `Initial_specs.txt` (PO request), `DECISIONS.md` D-01…D-43 incl. change requests CR-01 and CR-03 (D-10 amended by D-11; D-16: PFDE HBS86H clone at 48 V DC; D-26 operator controls; D-27 DIP setting decoded, change still open; D-28 R5 defaults accepted; D-29 Orchestrator P1 reconciliation; D-30/D-31 PAUSED latch and RESUME; D-32 PO answers Q25–Q28; D-33 validator-review decisions; D-34 clears never auto-retried; D-35 P1 gate (G1…G7); D-36 one red STOP = E-stop (CR-01); D-37 M1-gate interface decisions; D-38 plot panes; D-39/D-40 M2 start/entry; D-41/D-42 no contactor + hardwired ENA cut (CR-03); D-43 M2-gate decisions), `P1_QUESTIONS.md`, research R1–R5, ICD v0.3 §14 (SD-01…SD-13, OI-ICD-01…07), `params.yaml` (Table 5.1), FW_design (OI-FW-01…27, R-01), SW_design (F-B-01…31), SW_design_GUI (GF-01…10, GQ-01…20), FW_test_plan (DEF-P1-01…07, OBS-P1-01…15), SW_test_plan (SWD-P1-01…18) |
| Downstream | `ICD_protocol.md` and `params.yaml` (Integrator), `01_HW/` pinout & wiring, FW/SW design, test plans, `TRACEABILITY.md` |

**Notation**
- "shall" is normative. Each requirement row: **ID · Requirement · Source · Acceptance criterion · V · MS · Pri**.
- **Source**: `PO-FW-n` / `PO-SW-n` = numbered items of `Initial_specs.txt` (sub-items of SW item 8 are `PO-SW-8.x`, see §7); `D-xx` = decision; `Rn §x` = research section; `CONV` = conventions in `CLAUDE.md`/`PROCESS.md`.
- **V** (verification): **T** test (host unit test, FW host twin or PC simulator), **A** analysis, **I** inspection, **D** demonstration. Suffix **+H** = needs target hardware, executed only at a PO-approved hardware gate (D-06, D-07).
- **MS** = milestone (PROCESS.md §2): M1 link & skeleton · M2 sensor & motion · M3 SW application · M4 sequencer.
- **Pri**: Must / Should / Could.
- Command names (STOP, HALT, PAUSE, MOVE_ABS, …) follow ICD v0.1 and parameter names (`motion.*`, `safety.*`, `io.*`, `drv.*`, …) follow `params.yaml` dict_version 1. The Integrator owns names, codes, ids and byte layouts; a rename there is reflected here at the next SRS version without changing the semantics stated here.
- Numbers marked ASSUMED are collected in §10. Withdrawn requirements keep their row and ID (never renumbered).

---

## 1. Scope

This SRS specifies the Bird Bend Stand: a pull/push (tension/compression) bend test stand made of a
NUCLEO-F446RE firmware (FW) that drives a horizontal ball-screw axis through a hybrid-servo stepper driver
(closed-loop mode, 4000 pulses/rev, D-27) and reads a load cell, and a Windows PC application (SW,
Python/PySide6) for configuration, manual control, calibration, tare, realtime display, test sequences and
reports. It covers system, safety, FW, interface, SW and non-functional requirements. The byte-level
protocol (`ICD_protocol.md`) and the parameter dictionary (`params.yaml`) are owned by the Integrator and
must implement the requirements here. The E-stop circuit (NC → MCU sense, NO → hardwired ENA cut; no power-removal contactor, CR-03:
D-41, D-42) and the 5 V buffer interface board are decided and documented in `01_HW/`.

## 2. Definitions

| Term | Definition |
|---|---|
| FS | Load-cell full scale: 200 kg = **1961.33 N** (G0 = 9.80665 m/s²). Nominal HX711 counts (3.0 mV/V, gain 128, ratiometric): **32 212 counts/kg**, 6 442 451 counts at FS; 1 % FS = 64 425 counts (R2 §4.4, ASSUMED nominal). |
| Raw counts | HX711 24-bit two's-complement result, sign-extended to int32, unscaled. Rail values 0x7FFFFF / 0x800000 (−8 388 608) = **saturated** (≈ 130 % FS). |
| Operational stop | IEC 60204-1 **stop category 2**: pulse generation ends, the driver stays **enabled and holding** (D-10 as amended by D-11). *Immediate* = no further step pulse after the stated reaction time; *controlled* = deceleration with `motion.a_stop_um_s2`, then stop (executed as a clean immediate halt only when the step period is > 2 ms and the stop distance is ≤ 1 step, D-29 (d), D-30). An operational stop never resumes the stopped move automatically. |
| E-stop | The **single red** NC mushroom button on the separate operator panel (with the PAUSE button; no separate physical holding STOP button, D-36). Its **NC contact** → MCU E-stop sense input (PA10): the FW stops pulses ≤ 100 µs, drives ENA to *disabled* ≤ 1 ms, latches ESTOP and clears HOMED (SAF-FW-005). Its additional **NO contact** drives the driver's ENA opto to *disabled* directly, independent of the MCU (hardwired ENA cut, D-42). There is **no power-removal contactor** (CR-03, D-41): the driver stays supplied; with ENA disabled the motor is de-energised and the load may back-drive the axis; position is lost ⇒ not homed. **Not an IEC 60204-1 emergency stop** (residual risk accepted by the PO, D-41; SYS-006, KL-08). |
| DRV_PWR | Optional MCU input (PA7) sensing the driver's 48 V supply: closed = driver powered (fixed fail-safe polarity). Disabled by default (`drv.pwr_sense_enable` = false since CR-03, D-41); while disabled, status DRV_PWR reads 1. |
| K1_WELDED | Latched fault: E-stop sense open while DRV_PWR still reports driver power for longer than `drv.k1_weld_ms` (default 200 ms). Meaningful only with the optional power sense enabled **and** a power-removal device that opens with the E-stop; none is fitted since CR-03 (D-29 (c), D-41, OI-18). |
| ALM start-block | Release-1 reaction to the driver ALM output: **new** motion commands are refused while ALM is active **and** driver power is present; running moves are not affected (D-28, extends D-16). Alarm reset = driver power cycle (48 V supply off/on). |
| STOP (GUI) | GUI STOP button: immediate operational stop, sequence terminated, not latched in FW (D-26 (2)). |
| HALT | Latched immediate operational stop raised by the PC **HALT** command (Pause/Break key); sequence terminated; cleared only by HALT_CLEAR (D-14, D-36). Not an E-stop. |
| PAUSE | Physical PAUSE button (MCU input, NO contact, operator panel) or GUI Pause (PC **PAUSE** command, same FW behaviour, D-29 (a)): controlled operational stop and FW latch **PAUSED**, which **blocks every new motion start** (MOVE_ABS, MOVE_UNTIL_LOAD, HOME, JOG ≠ 0 incl. refreshes of a running jog) (D-30); sequence **paused** and resumable (D-14, D-26 (1)). PAUSED is cleared only by the PC command **RESUME** (clears PAUSED only; refused while HALT, ESTOP or a fault is latched) or by HALT_CLEAR (clears HALT and PAUSED) (D-31); never by a motion command. |
| RESUME | PC command (GUI Resume, or the SW's reaction to the button's RESUME_REQUEST): clears PAUSED only; the SW then re-issues the interrupted step's absolute target (D-31). A clear never starts motion. |
| Homed | FW state: machine coordinate referenced by a completed HOME sequence and not invalidated since (E-stop, driver power loss, disable, idle disable, step fault, failed/aborted homing, reset). |
| Machine coordinate | Travel x [µm on the wire, mm in SW], 0 = home reference (`home.offset_um` from the START switch edge), increasing away from the home (START) switch. Release 1 homes at the START switch only (D-29 (b)). |
| Test travel zero | PC-side offset `x_zero` (e.g. at specimen contact); test travel = x − x_zero. Never sent to the FW. Sequence travel targets are relative to it by default (`x_zero` frozen at sequence start, D-29 (k)). |
| No-specimen mode | Session-only SW mode in which the operator has switched the SW load limits off after an explicit confirmation (first use / no calibration); a persistent banner is shown; the FW load limit stays at its nominal default (SW-LIM-004, D-29 (h)). |
| Active travel calibration | The steps/mm stored in the board NVM together with the SW file `active_travel.json`. A value written to the board RAM during the travel wizard is a trial value until the wizard result is accepted (SW-CAL-001). |
| Session parameter | Dictionary parameter with `nvm: false` (`safety.zero_raw`, `safety.load_raw_min/max`): written by the PC (SAF-SW-002), never stored in NVM; boot and DEFAULT_PARAMS set the default (D-29 (f), SD-05). |
| Latest-wins | SW rule for manual targets: while a move runs, a newer target replaces the pending one and is sent when the move completes (D-29 (i)). |
| Setpoint distance | D-05 field: commanded profile position = steps issued so far × 1000 / `steps_per_mm` [µm], latched at HX711 data-ready (R4 §2.3; interpretation ASSUMED, §10). |
| Validity flag (VALID) | DATA flag bit 0, set/reset by PC command (PO-FW-7); marks frames usable for analysis; FW clears it automatically on every stop/fault. |
| Moving / idle | Moving = FW is generating pulses or executing a ramp (MOVING flag). Idle = not moving. |
| Steady-state window | Report samples of a step: VALID = 1, MOVING = 0, setpoint distance constant, no stop/fault flag, t ∈ [t_reached + settle, t_reached + settle + capture] (R4 §8.3). |
| Tare | `tare_raw` = robust mean raw over the tare window; force F = K·(raw − tare_raw) (R4 §7). |
| Load calibration | K [N/count], B [N] from an OLS fit over zero + known weights (R4 §6). |
| Soft limits | FW travel limits [`limits.soft_min_um`, `limits.soft_max_um`] (machine coordinate), active when homed. **SW travel limits**: per-test limits inside them. |
| FW load limit | Raw thresholds `safety.load_raw_min/max` (session parameters) compared by the FW on every sample (D-12). **SW load limits**: force limits in N evaluated on the PC. |
| Latched | The condition persists until its stated clear condition is met. |
| Link capacity | 92 160 B/s (921 600 Bd, 8N1). |
| p95 | 95th percentile over ≥ 100 trials. |
| Reference PC | The PO's Windows 10 lab PC used with the stand (ASSUMED, §10); its spec is recorded in each performance test report. |
| Dead-man | Jog motion continues only while refreshed by the PC. |

## 3. System context

### 3.1 Context

```
 PC — Windows 10, Python 3.14 (own venv, D-33 (i)), PySide6 GUI + backend (core/io/calc), simulator
   │  USB ── ST-LINK/V2-1 VCP ── USART2: 921600 Bd 8N1, no flow control, binary frames, separator, CRC-16 both directions
 NUCLEO-F446RE — FW (PlatformIO + stm32duino, LL timers/EXTI/DMA, 180 MHz from HSE bypass); pin map R5 §6.1 (D-28)
   ├─ PUL PA0 / DIR PA1 / ENA PA4, common cathode (D-17) ── bring-up: direct 3.3 V; before calibration: SN74ACT244 5 V buffer shield (D-28)
   │       └─► PFDE HBS86H driver (Leadshine-compatible clone, 24–100 VDC; 48 V DC from Mean Well SDR-480-48)
   │             DIP (D-27, PO-approved target): 4000 pulses/rev, SW7/SW8 = off/on closed loop 86-80/86-118, SW5 CCW + SW6 assist unchanged
   │       └─► SIHONG 86HS2140-06-001 motor (1000-line encoder → driver, closed loop) ──(direct coupling, ASSUMED)──► SFU1605 ball screw,
   │             5 mm lead, 300 mm stroke, horizontal axis, no brake (D-19, D-28)
   ├─ ALM PA8 / PEND PA9 ◄── driver opto outputs (report; ALM start-block, D-16, D-28)
   ├─ DRV_PWR PA7 ◄── optional 48 V presence sense (default disabled, D-41)
   ├─ HX711 (3.3 V; DOUT PB4, PD_SCK PB10, RATE PB5; 80 SPS, A/128) ◄── Keli DEF 200 kg S-cell (3.0 mV/V, tension + compression)
   ├─ START limit PB0 (NC, home end) · END limit PC1 (NC)                                  (D-08, D-18)
   ├─ E-stop sense PA10 ◄── red E-stop NC contact; E-stop NO contact ──► ENA opto forced to disabled (hardwired, 5 V via buffer board, D-42);
   │       no power-removal contactor — the driver stays supplied (CR-03, D-41)
   ├─ operator panel: red E-stop (above) + physical PAUSE button PB6 (NO, D-14, D-26 (1)); no physical STOP/BREAK button — PC7 free (D-36)
   ├─ PB9 spare (trip relay not applicable without a contactor, CR-03) · PA6 reserved (TIM1/TIM8_BKIN)
   └─ status LED PA5
```

### 3.2 Stop and enable policy (normative summary; details in §4.2)

| Trigger | Category | Pulses | ENA | Latch / clear | HOMED | VALID | Source |
|---|---|---|---|---|---|---|---|
| E-stop button (MCU sense + hardwired ENA cut; no power removal, CR-03) | — (FW: immediate stop + ENA disabled; not IEC 60204-1 cat. 0) | stop ≤ 100 µs | driven to *disabled* ≤ 1 ms by the FW, and forced to *disabled* by the E-stop NO contact independent of the MCU | ESTOP; clear = input closed ≥ 100 ms **and** PC ESTOP_CLEAR; then ENABLE (500 ms settle) + HOME | cleared | cleared | D-11, D-41, D-42 |
| GUI STOP, SW limit trip, wizard/sequence abort (PC STOP) | 2 immediate | stop | kept | none (sequence terminated on the PC) | kept | cleared | D-10, D-26 |
| Pause/Break key (PC HALT) | 2 immediate | stop | kept | HALT; clear = PC HALT_CLEAR | kept | cleared | D-14, D-26 |
| Physical PAUSE button / GUI Pause (PC PAUSE command) | 2 controlled¹ | decelerate | kept | PAUSED (src = button / PC): every new motion start refused (BLOCK PAUSED, incl. jog refreshes); clear = PC RESUME (refused while HALT/ESTOP/fault latched) or PC HALT_CLEAR; button press while PAUSED → RESUME_REQUEST only | kept | cleared | D-14, D-26, D-29 (a), D-30, D-31 |
| Limit switch while moving | 2 immediate | stop | kept | LIMIT_x; only motion away from the switch accepted while latched; auto-clear when the input has been released ≥ `io.release_ms` (20 ms) | kept | cleared | D-08, D-10, D-33 (h) |
| Both limit switches active | 2 immediate | stop | kept | LIMIT_WIRING; FAULT_CLEAR when both released | kept | cleared | R4 §3.3 |
| FW load limit / ADC saturation | 2 immediate | stop | kept | LOAD_LIMIT; FAULT_CLEAR (unload allowed, re-trip on growth) | kept | cleared | D-12 |
| AFE stale while moving | 2 immediate | stop | kept | AFE_FAULT; FAULT_CLEAR after fresh samples | kept | cleared | D-10 |
| Link watchdog (1 s, while moving) | 2 controlled¹ | decelerate | kept | LINK_WDG; clears at next valid frame | kept | cleared | D-15 |
| Jog dead-man expired | 2 controlled¹ | decelerate | kept | none | kept | unchanged | R1 §10.3 |
| Step overrun / count fault | 2 immediate | stop | kept | STEP_FAULT; FAULT_CLEAR | cleared | cleared | R4 §1.6 |
| Homing failure | 2 immediate | stop | kept | HOME_NOT_FOUND / HOME_WIRING; FAULT_CLEAR (aborted homing: EVENT only, the stopping cause has its own latch) | cleared | cleared | R4 §3.1 |
| Home drift at re-homing (> `home.drift_tol_um`) | — | none (homing completes) | kept | HOME_DRIFT; FAULT_CLEAR (data since the previous homing suspect) | set (new zero) | — | R5 §8, SD-02 |
| Driver power lost (optional sense enabled; DRV_PWR off: PSU loss / switched off) | — (driver unpowered) | stop ≤ 25 ms (idle NVM operation: its duration + 25 ms) | driven to *disabled*, NOT_ENABLED | none; motion and ENABLE refused (DRV_UNPOWERED) while power is absent; after power returns ENABLE + 500 ms settle + HOME | cleared | cleared | D-11, D-29 (c), D-33 (f), D-41 |
| E-stop sense open while DRV_PWR present > `drv.k1_weld_ms` (200 ms) — only with the optional sense **and** a power-removal device (none fitted, OI-18) | — (E-stop row applies) | — | — | K1_WELDED (latched ≤ `drv.k1_weld_ms` + 25 ms); FAULT_CLEAR when the cause is gone | — | — | D-29 (c), D-33 (f), D-41 |
| Driver ALM active | — | **no stop** of a running move | kept | none; **new** motion refused while ALM active and driver power present (ALM start-block); alarm reset = driver power cycle (48 V supply off/on) | — | — | D-16, D-28, D-41 |
| Idle ≥ 600 s **and** load < 2 % FS (not while the AFE is stale) | — | — | *disabled* | event; re-ENABLE by PC | cleared | — | D-15, D-33 (g) |
| PC DISABLE (operator confirmed) | — | refused while moving | *disabled* | — | cleared | — | R4 §4.2 |
| MCU reset / IWDG / power-up | — | none | left at "no current" = driver enabled, holding (disabled if E-stop active) | boot: not enabled, not homed | cleared | stream off | D-13 |

¹ A controlled stop may be executed as a clean immediate halt only when the step period is > 2 ms **and** the FW-computed stop distance v²/(2·a_stop) is ≤ 1 step; otherwise the FW decelerates as planned (D-29 (d), D-30).

---

## 4. Requirements

### 4.1 System (SYS-)

| ID | Requirement | Source | Acceptance criterion | V | MS | Pri |
|---|---|---|---|---|---|---|
| SYS-001 | The system shall consist of the PC application, the NUCLEO-F446RE FW, the PFDE HBS86H hybrid-servo driver with the SIHONG 86HS2140-06-001 motor (8.2 N·m, 6.0 A, 1000-line encoder; D-32) on a horizontal SFU1605 ball-screw table without brake, the 48 V PSU, the HX711 AFE with Keli DEF 200 kg cell, two NC limit switches, the red E-stop button (NC contact → MCU sense, NO contact → hardwired ENA cut; no power-removal contactor, D-41/D-42), the optional driver-power sense (DRV_PWR), the physical PAUSE (NO) button (E-stop and PAUSE on a separate operator panel; no physical STOP/BREAK button, D-36) and the 5 V buffer interface board (SYS-011), connected as in §3.1. | PO intro, D-08, D-11, D-16, D-19, D-20, D-26, D-28, D-32, D-36, D-41, D-42 | `01_HW` wiring documentation shows every connection of §3.1; inspection checklist complete. | I | M2 | Must |
| SYS-002 | The FW shall stream raw counts and the commanded position and execute single motion commands; the FW alone shall implement the E-stop sense reaction, the optional driver-power supervision (DRV_PWR, K1_WELDED; default off), the ALM start-block, the physical PAUSE button, limit switches, FW load limit, link watchdog, jog dead-man and idle disable, independently of PC presence, stream state and SW. Scaling, tare, derived quantities, SW limits, calibration, sequencing and reports shall run on the PC. | CONV, D-12, D-26, D-28, D-29 (c), D-36, D-41, R4 §4, OBS-P1-14, OI-F-M2-02 | Every SAF-FW test also passes with the PC silent after its last command (timed tests run inside the link-watchdog window, `safety.link_timeout_ms` = 5000) and the stream off; code inspection finds no force scaling in FW. | T, I | M2 | Must |
| SYS-003 | Conventions: force > 0 = tension (pull), < 0 = compression (push), sign carried by K; travel in the machine coordinate (§2); SW units mm, N (display N or kgf selectable), s; wire units µm, µm/s, µm/s², µs, raw counts; all float→int conversions round half away from zero. | D-20, R4 §0 | R4 §12 vectors TV-U and `um_to_steps`/`steps_to_um` pass in FW host tests and pytest; GUI offers the N/kgf selector. | T | M1 | Must |
| SYS-004 | Mechanical envelope: stroke 300 mm; commanded speed 0.001…10 mm/s **required** (≥ 10 mm/s); higher speeds are allowed up to the parameter caps (defaults 30 mm/s travel unloaded, 20 mm/s under load, D-29 (e), R5 §2.3) and the pulse-rate cap; force range ±FS. | D-19, D-29 (e), R5 §2.3 | On the stand: moves at 0.01 mm/s and 10 mm/s (after travel calibration) with measured mean speed error ≤ 1 %; an unloaded move at 30 mm/s completes without ALM and with HOME drift ≤ `home.drift_tol_um` at the next homing; usable travel between soft limits ≥ 280 mm measured. | D+H | M2 | Must |
| SYS-005 | Drive train configuration: PFDE HBS86H (Leadshine-compatible clone, rated 24–100 VDC) supplied from **48 V DC** (Mean Well SDR-480-48, D-28); DIP block SW1…SW8 set and documented in a `01_HW` setup sheet with **all eight switches** and their meaning: SW1–SW4 pulses/rev (Leadshine table), SW5 motor direction, SW6 standard / start-up acceleration assist (**not** a motor-type switch), SW7/SW8 motor select (on/on 60 mm; off/on 86-80/86-118 closed loop; on/off 86-151 closed loop; off/off 86 open loop 6.0 A). **Target setting (D-27, PO-approved):** SW1 on, SW2 off, SW3 on, SW4 off = **4000 pulses/rev** (nominal **800 steps/mm**); SW7 off / SW8 on = closed loop for the SIHONG 86HS2140-06-001 motor (8.2 N·m, 6.0 A, 0.5 Ω, encoder to the driver, D-32); SW5 (CCW) and SW6 (acceleration assist on) unchanged. The setting found at delivery (800 pulses/rev, 86 open loop 6.0 A) is recorded in the setup sheet as the previous state. SFU1605 lead 5 mm, direct coupling ASSUMED; driver command-smoothing filter off; driver tuning/current limit evaluated at the HW gate. FW and SW shall not depend on a particular pulses/rev value: steps/mm is a calibrated parameter, and speed/acceleration limits are expressed in length units (mm/s, mm/s² in SW; µm/s, µm/s² on the wire) so they remain valid after recalibration. | D-16, D-19, D-23, D-27, D-28, D-32, R2 §1.6, §1.9, R5 §2 | `01_HW` setup sheet lists supply/PSU, all 8 DIP positions (previous and target) with meaning, motor label (86HS2140-06-001) and tuning settings; the DIP state is recorded in every test report; the change to the target setting is verified at the HW gate (SYS-009); first travel calibration result recorded and compared with 800 steps/mm; inspection: no speed/accel parameter in step units. | I, I+H | M2 | Must |
| SYS-006 | E-stop (CR-03: D-41, D-42): a single red NC mushroom button on the operator panel. Its **NC contact** goes to the MCU E-stop sense input (PA10): the FW stops pulses and drives ENA to *disabled* (SAF-FW-005), latches ESTOP and clears HOMED. An additional **NO contact** shall drive the driver's ENA opto to *disabled* directly — ENA+ fed from a local 5 V supply through a resistor, OR-ed with the MCU drive via the buffer board / diode — independent of MCU, FW and SW (D-42). There is **no power-removal contactor**: the driver stays supplied with 48 V; with ENA disabled the motor is de-energised and the load may back-drive the horizontal axis (no brake; spring-back accepted, KL-03). Releasing the button shall not cause motion (re-enable only by PC command after ESTOP_CLEAR, SAF-FW-006). **Residual risk (stated to and accepted by the PO, D-41):** this is **not** an IEC 60204-1 emergency stop (no hardwired power removal); an MCU fault is covered by the IWDG (≤ 100 ms → reset → boot with the E-stop open drives ENA disabled, SAF-FW-018/019) and by the hardwired ENA cut (D-42), whose NO contact is not monitored (KL-08, KL-09). Circuit documented in `01_HW/wiring.md` with the buffer board. | D-11, D-28, D-36, D-41, D-42, PO-FW-3, PO-SW-6 | Circuit review; with the MCU held in reset, pressing the E-stop de-energises the motor (multimeter on the ENA opto input: disabled level; motor shaft free without load); with the MCU running: ESTOP latched and ENA disabled per SAF-FW-005; after release no axis motion until ESTOP_CLEAR + ENABLE + HOME. | I, T+H | M2 | Must |
| SYS-007 | `01_HW` shall document the pinout per R5 §6.1 (accepted, D-28: DOUT PB4, RATE PB5, END PC1 with PB1 fallback, PAUSE PB6 NO (STOP input PC7 retired and free, D-36), DRV_PWR PA7, PB9 spare (trip relay not applicable, CR-03), PA6 reserved; origin Stefan, deviations with rationale), PUL/DIR/ENA common-cathode wiring with MCU GND only on the driver's opto side, the buffer board (SYS-011), HX711 at 3.3 V with RATE on a GPIO, NC limit switches to GND with RC filters, E-stop circuit (NC → PA10 sense, NO contact → hardwired ENA cut via the buffer board, D-42), optional 48 V presence sense on PA7, operator panel (E-stop, PAUSE button), ALM/PEND inputs, supplies and grounding. | PO intro, D-17, D-21, D-22, D-26, D-28, D-36, D-41, D-42, R1 §9, R2 §6, R5 §6.1 | Every FW pin appears in `pinout.md` with direction, level and origin; no 5 V signal on a non-5-V-tolerant (TC) pin (PA4/PA5). | I | M1 | Must |
| SYS-008 | All FW logic (motion, homing, safety, AFE, protocol) shall be executable in a FW host twin, and the SW shall run against a PC simulator with the models of R4 §11 (driver incl. ALM, optional driver-power sense and the E-stop with hardwired ENA cut, switches, buttons, HX711, specimen, link); target tests run only at a PO-approved hardware gate. | D-06, D-07, R4 §11, R5 §1.5 | Full GUI workflow (connect, home, calibrate, tare, sequence, report) demonstrated against the simulator; SW⇄twin integration tests pass. | T, D | M1 | Must |
| SYS-009 | Before any motion under load on target, a hardware check list shall be passed: 921600 Bd VCP streaming soak, flash erase vs IWDG, HX711 80 SPS on silicon, E-stop MCU-sense reaction and the hardwired ENA cut (D-42: with the MCU held in reset, pressing the E-stop de-energises the motor — multimeter on the ENA opto input), optional DRV_PWR sense (only if fitted), limit/load-limit/PAUSE-button reaction times, ENA enable/disable (direct 3.3 V drive at bring-up, then through the buffer board), ENA settle 500 ms, PUL/DIR timing (on-chip measurement: DWT / timer capture of PUL/DIR looped back to timer inputs, or equivalent; no oscilloscope or logic analyser, D-35 G5), ALM/PEND levels, ALM reset by driver power cycle (48 V supply off/on; the ENA-toggle reset tested on the bench), DIP target setting applied and recorded (SYS-005). The **first motion** on target shall be a short, slow jog without specimen (e.g. a few mm at ≤ 1 mm/s, un-homed jog speed cap) that verifies the direction (+x away from START, `motion.dir_invert`) and the scale (commanded vs measured travel, ±10 %, i.e. that the DIP change to 4000 pulses/rev took effect) **before any homing at speed or calibration**. Evidence: on-chip measurement through the `HW_MEAS` build's DIAG_MEAS command (primary, D-40 (c)) and a multimeter for static levels; SWD access is a fallback only (board installed remotely, D-41); the bench safety procedure for stimulating the E-stop sense is defined by Validator E. | R3 §7.2, D-17, D-24, D-27, D-28, D-35 (G5), D-36, D-40 (c), D-41, D-42, R5 §2.5 | Check-list report by Validator E with measured values; every budget of §6 met; first-jog record (direction, commanded vs measured travel) precedes the first homing and calibration records. | T+H | M2 | Must |
| SYS-010 | Code reused from Thrust_Stand_HAW or Stefan shall be copied into this repository with an origin note (path @ commit); Thrust_Stand_HAW code may be copied from its current HEAD, and the commit hash actually copied is recorded in the origin note; every requirement shall be traced to design, code and tests through ID tags (`Implements:` / `Verifies:`) and `TRACEABILITY.md`. | D-02, D-29 (m), PROCESS §3, PO-FW-1 | Traceability report: 100 % of Must requirements have ≥ 1 verifying test; every reused file carries an origin note with path and commit hash. | I | M1 | Must |
| SYS-011 | The driver control inputs (PUL, DIR, ENA) are driven directly at 3.3 V (D-17; the PO does not fit the 5 V buffer board, D-56 b). Before any calibration or test campaign the direct drive shall be qualified: (a) opto current I_LED ≥ 6 mA on ENA (DISABLE) and DIR (held level after a + jog), measured with a burden ≤ 10 Ω (DMM mA range or 10 Ω shunt; a 100 Ω-shunt reading is conservative and only a 4.5–6 mA reading needs the low-burden repeat; wiring.md §2.2, C-06 / M-2 / M-8), and (b) a pulse-integrity check passes — 10 round trips 5 ↔ 285 mm at the travel speed limit, then a re-home of the homed axis: no HOME_DRIFT and |d1| ≤ max(30 µm, 2·max|d0ᵢ|), where d0ᵢ are 3 baseline re-homes taken before the run and d = the HOMED event deviation, valid only if the axis was homed when HOME started (Validator E statistics: d is a difference of two switch captures; one repeat allowed); a baseline with max|d0ᵢ| > 100 µm stops the check (START switch mounting to be fixed first). If (a) or (b) fails, the 5 V buffer interface board (R5 §5.2 Option A, SN74ACT244 class) shall be fitted before calibration. The pulse-integrity check is repeated after any wiring change and at the end of every test campaign. | D-17, D-27 (inputs 5–24 V), D-28, R5 §5, D-56 (b) | Bring-up record (assistant package, SW-BRU-003): I_LED values and the pulse-integrity result; inspection of the installed wiring. | I+H | M2 | Must |

### 4.2 Safety — firmware (SAF-FW-)

| ID | Requirement | Source | Acceptance criterion | V | MS | Pri |
|---|---|---|---|---|---|---|
| SAF-FW-001 | Every operational stop shall end pulse generation, keep the ENA level unchanged (driver holding), discard the active move target and ramp state, clear VALID and report its cause (status flag + EVENT); a stopped move is never resumed by the FW. | D-10, D-11, R3 §1.7 P11, R4 §8.5 | Twin test per stop source of Table 3.2: ENA unchanged, MOVING = 0 and VALID = 0 in the next DATA frame, EVENT cause correct; a later clear/ENABLE does not restart the old move. | T | M2 | Must |
| SAF-FW-002 | Immediate stops (PC STOP, PC HALT, limit switch, FW load limit, AFE fault, step fault, homing/wiring fault) shall emit no further PUL edge later than: 200 µs after a limit-switch input edge at the MCU pin; 200 µs after the HX711 data-ready of the deciding sample; 2 ms after the last byte of a STOP/HALT command frame. Exemption: a STOP/HALT frame received during an idle NVM SAVE is executed right after the flash operation (no motion is possible during SAVE, D-37 (a)). | D-10, D-12, D-26, D-35 (G5), D-36, D-37 (a), R4 §4.6 | Twin timing test (virtual time); on target by on-chip measurement (DWT / timer capture with PUL looped back to a timer input) or equivalent, 100 trials per path, max ≤ budget. | T, T+H | M2 | Must |
| SAF-FW-003 | Controlled stops (link watchdog, PAUSE button, PC PAUSE, jog dead-man, STOP controlled mode, JOG 0) shall decelerate with `motion.a_stop_um_s2` to standstill, then behave as SAF-FW-001. The FW may substitute a clean immediate halt (no runt pulse) only when the current step period is > 2 ms **and** the FW-computed stop distance v²/(2·a_stop) is ≤ 1 step; otherwise it decelerates as planned, reprogramming the running step interval if needed to meet the 2 ms budget. | D-14, D-15, D-26, D-29 (a), (d), D-30, R4 §4.5, OBS-P1-01, OI-ICD-07 | Twin, for step periods ≤ 1 ms, 1…2 ms and > 2 ms and every controlled source: the deceleration **commit** (reprogramming of the running period / preload of the first deceleration interval, or the clean halt) occurs ≤ 2 ms after the trigger — for the PAUSE button the trigger is the threshold crossing at the MCU pin (the input RC delay is outside the budget); every later PUL interval is non-decreasing and on the planned profile ± 1 timer tick; stop distance = v²/(2·a_stop) ± 1 step; a clean halt occurs only when both substitution conditions hold. | T | M2 | Must |
| SAF-FW-004 | No partial (runt) or uncounted step pulse shall occur at any stop; the step counter shall equal the number of completed pulses; an immediate stop that may truncate a pulse in flight sets `pos_uncertain` (±1 step) and keeps HOMED; a missed timer update raises STEP_FAULT (immediate stop, HOMED cleared). | R1 B-07, R4 §1.6 | Twin: 10 000 random stops, simulated PUL edges = step counter (or ±1 with `pos_uncertain`); target: 100 moves cross-checked by an independent on-chip counter (PUL looped back to a timer input) or equivalent, difference 0. | T, T+H | M2 | Must |
| SAF-FW-005 | When the E-stop sense input opens, the FW shall (a) emit no further PUL edge later than **100 µs** after the input edge at the MCU pin, (b) drive ENA to the disabled level within 1 ms, (c) latch ESTOP, clear VALID and HOMED and discard the active move — in every link, stream and motion state. The ENA line may additionally be forced to *disabled* externally by the E-stop NO contact (D-42); the FW shall tolerate this externally forced state (no fault, no read-back-mismatch error while the E-stop is active). | D-11, D-41, D-42, R4 §4.6, PO-FW-3 | Twin and target (on-chip measurement: DWT / timer capture or equivalent), 100 trials: max (a) ≤ 100 µs, (b) ≤ 1 ms; flags set in the next DATA frame; with the ENA line externally forced to disabled during the E-stop → no fault, no extra EVENT. | T, T+H | M2 | Must |
| SAF-FW-006 | ESTOP_CLEAR shall be accepted only after the sense input has been closed continuously for ≥ `io.estop_release_ms` (default 100 ms), otherwise NACK with the input state; after clear the driver stays disabled and the axis not homed: motion requires ENABLE (which additionally requires driver power when the optional power sense is enabled, SAF-FW-024), MOVE_ABS additionally HOME. | D-11, D-28, R4 §4.2 | Twin: clear refused at 50 ms, accepted at 100 ms; afterwards JOG → NACK (not enabled); ENABLE with DRV_PWR off → NACK; after power + ENABLE MOVE_ABS → NACK (not homed). | T | M2 | Must |
| SAF-FW-007 | E-stop sense and limit inputs shall be NC contacts to GND with pull-up, "open/high" = active, and the DRV_PWR input shall read "unpowered" when open; their polarity is fixed in FW (no parameter), so a broken wire or unplugged connector reads as active / unpowered; an input active at boot is latched/reported from the first status and motion is refused accordingly. `drv.pwr_sense_enable` (reboot required) defaults to false since CR-03 (no contactor; the input is an optional 48 V presence sense); while false DRV_PWR reads "powered". | D-18, D-28, D-41, R2 §6.3–6.4, R4 §3.5, R5 §1.5 | Inspection: no polarity parameter for these inputs; twin: wire break on each input → stop + flag; boot with an input open → reported in the first GET_STATUS. | I, T | M2 | Must |
| SAF-FW-008 | The FW shall compare **every** HX711 sample with `safety.load_raw_min/max`; `safety.load_trip_samples` (default 1) consecutive violations shall cause an immediate stop, latch LOAD_LIMIT and clear VALID — in every state (incl. homing, jog, un-homed, stream off). The check cannot be disabled. | D-12, R4 §4.4 | Twin: injected raw_max + 1 → stop on that sample, same with the stream off; inspection: no parameter disables the check. | T, I | M2 | Must |
| SAF-FW-009 | A sample at either rail (0x7FFFFF or −8 388 608) shall count as a load-limit violation regardless of the thresholds. | D-12, R2 §4.1 | Twin: rail sample with thresholds at the range cap → trip. | T | M2 | Must |
| SAF-FW-010 | Load thresholds shall default to ±7 022 271 counts (110 % FS minus the 1 % FS zero-balance allowance) and be settable only within ±7 151 121 counts (110 % FS plus 1 % FS); outside → E_RANGE (never clamped by the FW); `raw_min < raw_max` hard rule; settable while moving, effective from the next sample. They are session parameters: never stored in NVM, set to the defaults at boot and by DEFAULT_PARAMS, kept by LOAD_PARAMS. | D-12, D-29 (f), SD-05, R2 §3, §4.4 | Parameter vectors: SET 7 151 122 → E_RANGE; SET 7 151 121 accepted and read back; defaults after boot and DEFAULTS equal the listed values; SAVE + reboot → defaults (not the set value). | T | M2 | Must |
| SAF-FW-011 | FAULT_CLEAR shall clear LOAD_LIMIT even if the load is still beyond the threshold, so the operator can unload; the FW shall re-trip immediately if the violation grows by more than `safety.load_regrow_raw` beyond the value at clear. | R4 §4.4 | Twin: after clear, a move reducing the load runs; a move increasing it beyond regrow trips. | T | M2 | Must |
| SAF-FW-012 | No HX711 sample for `afe.timeout_ms` (default **250 ms**; hard rule `afe.timeout_ms` ≥ 2 × the conversion period of the configured `afe.rate_sps`, i.e. ≥ 200 ms at 10 SPS) shall set AFE_STALE; while moving this causes an immediate stop and latches AFE_FAULT. Motion commands shall be refused while the AFE is stale or the last sample was saturated. | D-10, D-33 (a), DEF-P1-01, R4 §4.2 | Twin: DOUT stops during a jog → stop ≤ `afe.timeout_ms` + 1 ms; 10 min idle + 60 s jog at a true 10 SPS (± 0.5 % jitter) with the default timeout → no AFE_STALE / AFE_FAULT; SET of `afe.timeout_ms` or `afe.rate_sps` violating the hard rule → E_CONFIG; motion NACK while stale; FAULT_CLEAR succeeds only after fresh samples. | T | M2 | Must |
| SAF-FW-013 | A limit input becoming active while moving shall cause an immediate stop, latch LIMIT_START/LIMIT_END, clear VALID and send an EVENT. While a limit is active or latched, only motion away from that switch is accepted (motion toward it is refused); the latch clears automatically when the input has been released (inactive) continuously for `io.release_ms` (20 ms). (Expected switch edges during HOME are handled by FW-HOM.) | PO-FW-2, D-08, D-18, D-33 (h), OBS-P1-06, R4 §3.3 | Twin: hit during MOVE_ABS → stop; JOG toward → NACK; JOG away → executes; latch kept after 19 ms of release, cleared after 20 ms. | T | M2 | Must |
| SAF-FW-014 | Both limit inputs active simultaneously shall raise LIMIT_WIRING: immediate stop, all motion refused until the inputs are no longer both active and FAULT_CLEAR is received; an input that is still active keeps acting as a limit latch (motion toward it refused, SAF-FW-013). | R4 §3.3, §3.5, D-40 (a) | Twin: both open → fault + motion NACK; FAULT_CLEAR refused while both active; after one input closes, FAULT_CLEAR accepted, motion toward the still-open switch refused, motion away allowed. | T | M2 | Must |
| SAF-FW-015 | Link watchdog: no CRC-valid frame from the PC for `safety.link_timeout_ms` (default 1000 ms) shall, **in every motion state**, clear VALID (reported once by VALID_CLEARED, arg LINK_WDG, only on a 1 → 0 change); **while moving** (any mode) it shall additionally cause a controlled stop with the driver kept enabled, set LINK_WDG and send the LINK_WDG / STOPPED events; LINK_WDG clears at the next valid frame; no motion restarts; idle never stops. | D-15, D-47 (a), R4 §4.5 | Twin: silence 999 ms → no stop, VALID kept; 1000 ms + 2 ms → deceleration started (moving) / VALID cleared without stop (idle, NOT_ENABLED); `linkwdg_vectors.json` 32 cases. | T | M2 | Must |
| SAF-FW-016 | Jog dead-man: JOG motion shall continue only while refreshed by a JOG command at least every `motion.jog_timeout_ms` (default 250 ms); otherwise controlled stop. | R1 §10.3, R4 §2.1 | Twin: refresh every 200 ms keeps moving; deceleration starts ≤ timeout + 2 ms after the last refresh. | T | M2 | Must |
| SAF-FW-017 | Idle disable: after `safety.idle_disable_s` (default 600 s, 0 = never) without motion **and** with abs(raw − `safety.zero_raw`) < `safety.release_band_raw` (default 2 % FS; `zero_raw` is the session tare written by the PC, 0 until then), the FW shall set ENA to disabled, clear HOMED and send an EVENT; with the load at or above the band the driver stays enabled (holding) indefinitely; idle disable is not applied while the AFE is stale (the unloaded state cannot be confirmed). | D-15, D-33 (g), OBS-P1-05 | Twin (virtual time): unloaded → disabled at 600 s ± 1 s; loaded → still enabled after 1 h; AFE stalls at 300 s → no idle disable. | T | M2 | Must |
| SAF-FW-018 | After reset, power-up or IWDG reset the FW shall keep PUL idle from reset release, leave ENA at the "no current" level (driver enabled, holding, D-13) unless the E-stop input is active (then disabled level), report HOMED = 0, motion state "not enabled" (no pulse until ENABLE), stream off and the reset cause. | D-13, D-33 (e), DEF-P1-05, R2 §1.5, CONV | Twin: after boot STATUS shows not homed / not enabled / reset cause; JOG before ENABLE → NACK. Target: MCU reset with the specimen (spring) preloaded to ≥ 98 N (10 kgf) tension on the horizontal axis → axis motion ≤ 0.01 mm (dial indicator), raw change within noise. | T, T+H | M2 | Must |
| SAF-FW-019 | An independent watchdog (IWDG) shall be active from boot; a FW hang while moving shall stop the PUL output ≤ 100 ms after the hang (reset → SAF-FW-018). The timeout may be extended only while idle for flash operations. | R2 §5.5, R3 §3 | Injected infinite loop while moving: PUL stops ≤ 100 ms (twin; on target by on-chip loopback capture or equivalent); reset cause = IWDG. | T, T+H | M2 | Must |
| SAF-FW-020 | Motion gating: the command set shall contain **absolute moves only** (no relative move on the wire); targets/bounds outside the soft limits → E_RANGE; speed above the effective cap → E_RANGE, where the cap is `motion.v_max_load_um_s` for MOVE_UNTIL_LOAD and for any command accepted while loaded (abs(raw − `safety.zero_raw`) ≥ `safety.release_band_raw`, or AFE stale), else `motion.v_max_travel_um_s`, both limited by the step-rate cap (FW-MOT-009); accel above `motion.a_max_um_s2` → E_RANGE; MOVE_ABS, MOVE_UNTIL_LOAD and JOG with a bound refused when not homed; un-homed only HOME and unbounded JOG at ≤ `motion.v_unhomed_um_s`, both within the **un-homed travel window** = un-homed origin ± `home.max_travel_um`, the origin being latched when the axis becomes un-homed (boot, ENABLE after power-up, E-stop, DISABLE, homing failure) and not at each jog start; a JOG toward a reached window bound is refused (E_RANGE) until homed; every motion command refused while ESTOP/HALT/fault is latched, the driver is not enabled, driver power is absent (SAF-FW-024, optional sense), the ALM start-block applies (SAF-FW-026), PAUSED is set (SAF-FW-023) or the AFE is stale/saturated. | D-23, D-28, D-29 (e), D-30, D-43 (b), R3 §1.6 (b), R4 §2.1, §3.2, R5 §2.3 | Command-check vectors, one per refusal reason (incl. DRV_UNPOWERED, DRIVER_ALARM, PAUSED, loaded speed cap, un-homed window bound), give the expected NACK code; inspection: the ICD defines no relative-move command. | T, I | M2 | Must |
| SAF-FW-021 | HOME shall be refused when abs(raw − `safety.zero_raw`) > `home.max_load_raw` (default 5 % FS) unless the command carries the operator-confirmed flag; the FW load limit stays active during homing. | D-15 | Twin: 6 % FS load → NACK; same with flag → homing runs; trip during homing → stop. | T | M2 | Must |
| SAF-FW-022 | *Withdrawn (v0.5, D-36 / CR-01):* there is no separate physical holding STOP/BREAK button — the single red button is the E-stop (SAF-FW-005, SYS-006); holding stops remain GUI STOP and the Pause/Break key (HALT). | D-36 | — | — | — | — |
| SAF-FW-023 | PAUSE — physical PAUSE button active edge or PC **PAUSE** command (same FW behaviour): while moving a controlled stop (SAF-FW-003); in every case PAUSED is set (with source button / PC), VALID cleared and EVENT PAUSED sent (once; PAUSE while PAUSED → no new event); a button press while PAUSED shall only send EVENT RESUME_REQUEST. While PAUSED, every new motion start (MOVE_ABS, MOVE_UNTIL_LOAD, HOME, JOG ≠ 0 including refreshes of a running jog) shall be refused (E_STATE, BLOCK PAUSED); STOP, HALT, PAUSE, JOG 0, RESUME and the clears stay accepted. PAUSED shall be cleared only by **RESUME** (clears PAUSED only; refused with E_STATE while HALT, ESTOP or any fault is latched, so a HALT (Pause/Break) latched just before a RESUME frame is never cleared by it) or by **HALT_CLEAR** (clears HALT and PAUSED) — never by a motion command; neither clear starts motion; the FW never resumes motion by itself. | D-14, D-26 (1), D-29 (a), D-30, D-31, SD-01, SD-13 | Twin: button press and PC PAUSE during a move → deceleration + EVENT PAUSED with the source; second press → RESUME_REQUEST only, no pulses; MOVE_ABS / HOME / JOG and a jog refresh while PAUSED → E_STATE PAUSED, PAUSED kept; RESUME → only PAUSED cleared, no PUL edge; RESUME with HALT latched ms earlier → E_STATE HALT, HALT and PAUSED both kept; RESUME with ESTOP or a fault latched → refused, PAUSED kept; HALT_CLEAR with HALT + PAUSED → both cleared. | T | M2 | Must |
| SAF-FW-024 | **Only when the optional driver-power sense is fitted and enabled** (`drv.pwr_sense_enable` = true; default false since CR-03, D-41): driver power supervision (DRV_PWR input, FW-SW-005): when driver power is lost (PSU loss or switched off) the FW shall, within 25 ms of the input change (during an idle NVM erase/program: the operation time + 25 ms), end pulse generation, drive ENA to the disabled level, enter NOT_ENABLED, clear HOMED and VALID and discard the active move; it sends EVENT DRIVER_POWER (lost) on every loss, STOPPED (DRV_POWER_LOST) only if a motion was ended by it, and DRIVER_DISABLED (DRV_POWER_LOST) only if the driver was not already NOT_ENABLED (after an E-stop the axis is already stopped and disabled, so only DRIVER_POWER follows); while power is absent ENABLE and all motion commands are refused (DRV_UNPOWERED); after power returns, ENABLE waits `motion.ena_settle_ms` (FW-MOT-008) counted from the later of ENABLE and power return. | D-11, D-28, D-29 (c), D-33 (f), D-41, R5 §1.5, OI-ICD-06, DEF-P1-06 | Twin: DRV_PWR off during a jog (E-stop closed) → stop ≤ 25 ms, NOT_ENABLED, HOMED = 0, EVENTs DRIVER_POWER + STOPPED + DRIVER_DISABLED; E-stop first, then DRV_PWR off → only DRIVER_POWER; DRV_PWR off during a SAVE with sector erase → reaction ≤ erase time + 25 ms; toggles < 20 ms ignored; ENABLE refused while off; power on + ENABLE → first pulse ≥ 500 ms after the later of both. Default configuration (sense disabled): DRV_PWR reads powered, no reaction. Target (sense fitted): switching the 48 V supply off → status and EVENT observed. | T, T+H | M2 | Must |
| SAF-FW-025 | Contactor plausibility — **only with the optional driver-power sense enabled and a power-removal device that opens with the E-stop** (none is fitted since CR-03, D-41; with a plain 48 V presence sense this check would latch on every E-stop, OI-18): with `drv.pwr_sense_enable`, E-stop sense open while DRV_PWR still reports driver power continuously for longer than `drv.k1_weld_ms` (default 200 ms, ≥ contactor drop-out incl. aux delay) shall latch fault **K1_WELDED** (FAULT_SET EVENT, status FAULT) no later than `drv.k1_weld_ms` + 25 ms after the E-stop sense edge; FAULT_CLEAR clears it only when the cause is gone (E-stop sense closed or driver power off). The E-stop reaction itself (SAF-FW-005) is unaffected. | D-29 (c), D-33 (f), D-41, OBS-P1-02, R5 §1.5 | Twin (`drv.k1_weld_ms` ∈ {100, 200, 2000}): E-stop open with DRV_PWR held on → no fault at 150 ms (k1 = 200), fault latched within (k1, k1 + 25 ms]; normal case (power drops 60 ms after the E-stop) → no fault; FAULT_CLEAR refused while the cause persists, accepted after DRV_PWR off; sense disabled → never. | T | M2 | Must |
| SAF-FW-026 | ALM start-block: while ALM is active **and** driver power is present (DRV_PWR on, or `drv.pwr_sense_enable` = false), every **new** motion command (MOVE_ABS, MOVE_UNTIL_LOAD, HOME, JOG ≠ 0 when not jogging) shall be refused (DRIVER_ALARM); a running move — including speed refreshes of a running jog — is not stopped or affected by ALM; ENABLE, STOP, HALT, PAUSE, JOG 0, RESUME and the clears are not blocked. Alarm reset is by driver power cycle (48 V supply off/on). In the closed-loop driver setting (D-27) a following error raises ALM; release 1 still only blocks new motion (D-16). | D-16, D-28, R5 §1.5, Q-R5-11 | Twin: ALM active + power on → MOVE_ABS/HOME/JOG NACK DRIVER_ALARM; ALM during a move → move completes, EVENT ALM_CHANGED; ALM active + DRV_PWR off → refusal reason DRV_UNPOWERED. | T | M2 | Must |

### 4.3 Safety — PC software (SAF-SW-)

| ID | Requirement | Source | Acceptance criterion | V | MS | Pri |
|---|---|---|---|---|---|---|
| SAF-SW-001 | The backend shall evaluate the enabled SW limits (load in N with active calibration + tare; travel in mm) on every received DATA frame; a violation shall send STOP, terminate any sequence/wizard motion and log an event with the value (a position at, not beyond, an enabled travel limit is not a violation); STOP frame on the wire ≤ 50 ms after reception of the violating frame. While a load limit is enabled but has no valid input (no calibration, no tare in this session, calibration invalid by AFE-configuration mismatch (SW-CAL-009), AFE fault), motion commands are disabled; the only way to move without valid load limits is the no-specimen mode (SW-LIM-004). | PO-SW-2, D-12, D-29 (h), (l), R4 §4.6 | Simulator: 100 injected violations, STOP on the wire p95 ≤ 50 ms; motion controls disabled with load limit enabled and no calibration / no tare / AFE mismatch. | T | M3 | Must |
| SAF-SW-002 | After every change of calibration, tare or FW load-limit level, at connect and after LOAD/DEFAULT_PARAMS, the SW shall compute `safety.load_raw_min/max` per R4 §4.4 (rounding toward the tare), write them together with `safety.zero_raw` (session parameters, never saved) and verify by read-back. A FW level > 110 % FS is refused (SW-LIM-002); a computed threshold outside the FW range (±7 151 121 counts) is **clamped inward** to the range limit (safe side, earlier trip) with a warning. Without a valid calibration (no-specimen mode) the nominal defaults (±7 022 271) apply. SW motion commands stay disabled until the verified thresholds match the active calibration + tare (or the defaults in no-specimen mode). | D-12, D-29 (f), (g), (h), SD-05, R4 §4.4, §7 | pytest R4 TV-T `fw_raw_limits` vectors incl. a K below nominal → clamped value + warning; simulator: tare → SET_PARAM + read-back observed; reconnect / DEFAULT_PARAMS → values re-sent; injected mismatch → motion disabled. | T | M3 | Must |
| SAF-SW-003 | While connected, the SW shall send a heartbeat (PING) whenever nothing else was sent for 200 ms (gap ≤ 250 ms), only while its receive/processing pipeline is alive; during motion, DATA loss > 500 ms shall send STOP, terminate the sequence and show LINK LOST. | D-15, R3 §1.5 | Simulator: 600 ms stream gap during a sequence → STOP sent, sequence terminated; 10 min run: max heartbeat gap ≤ 250 ms. | T | M3 | Must |
| SAF-SW-004 | Operator confirmations shall be required for: HOME with abs(F) ≥ 5 % FS (sends the confirmed flag), DISABLE ("specimen unloaded?"), E-stop clear (button released, re-home notice), entering the no-specimen mode (SW-LIM-004); Enter/Space never confirm, and STOP is reachable inside every such dialog. | D-11, D-15, D-28, D-29 (h), R4 §2.1 | GUI tests: each dialog appears under its condition; keyboard default does not confirm; STOP button present. | T | M3 | Must |
| SAF-SW-005 | The GUI shall show persistent indicators for ESTOP, HALT, PAUSED (with source), LIMIT_START/END, LOAD_LIMIT, AFE stale/saturated/rate mismatch, LINK_WDG and link state, HOMED, POS_UNCERTAIN, driver enabled, driver power (DRV_PWR), ALM (with "new motion blocked"), PEND, faults K1_WELDED and HOME_DRIFT, CLK_FALLBACK (from GET_STATUS), the no-specimen mode banner, and for each latched condition its clear procedure. Status bits that belong to a feature whose GET_INFO feature bit is 0 (e.g. ALM, PEND, DRV_PWR without FEAT_DRV_SIGNALS) are invalid and shown as UNKNOWN (D-37 (b)). | D-11, D-16, D-26, D-28, D-29 (c), (h), D-37 (b), SWD-P1-06 | Simulator fault injection: each indicator updates ≤ 200 ms after reception of its carrier (DATA frame, EVENT or GET_STATUS response); for items carried only by GET_STATUS the poll period (≤ 1 s while streaming) adds to this. | T | M3 | Must |
| SAF-SW-006 | Before a move or sequence with enabled load limits, the SW shall warn when k_est·v·0.065 s > F_fw − F_pc (speed too high for the configured limit margin). | R4 §4.6 | pytest of the rule; GUI warning shown in the simulator. | T | M4 | Should |

### 4.4 Firmware (FW-)

#### FW-PLT — platform
| ID | Requirement | Source | Acceptance criterion | V | MS | Pri |
|---|---|---|---|---|---|---|
| FW-PLT-001 | The FW shall run on NUCLEO-F446RE, built with PlatformIO + stm32duino, with LL/register access and own IRQ handlers for step timer, EXTI and UART DMA (build flags per R1 §6.2); pinout and basic board init taken from Stefan where no conflict exists. | PO intro, D-09, R1 §6, §9 | Clean-checkout build succeeds; inspection of `platformio.ini` flags and pin init vs `01_HW/pinout.md`. | I | M1 | Must |
| FW-PLT-002 | SYSCLK shall be 180 MHz from HSE bypass (8 MHz ST-LINK MCO) with bounded PLL start and an HSI fallback reported as CLK_FALLBACK in GET_STATUS (`sys_flags`) and by an EVENT at boot — not in DATA (the condition is fixed from boot); all timer, pulse and baud constants shall be derived from the actual bus clocks (no hard-coded Stefan values). | R2 §5.1, R3 P7, R4 §1.9, D-29 (f), SD-10 | Inspection; twin with simulated HSE failure → flag; target: PUL frequency / device-clock error ≤ 0.1 % on HSE, measured on-chip (timer capture of looped-back PUL) and against the PC clock over ≥ 60 s, or equivalent. | I, T, T+H | M1 | Must |

#### FW-AFE — HX711
| ID | Requirement | Source | Acceptance criterion | V | MS | Pri |
|---|---|---|---|---|---|---|
| FW-AFE-001 | The FW shall read one HX711 on the DOUT-ready falling edge (EXTI), bit-banged in the ISR with interrupts masked only during each SCK-high (≤ 1 µs, never masking the E-stop/STOP/limit IRQs), SCK-high ≤ 50 µs always; result as int32 sign-extended 24-bit; driver logic reused from Thrust_Stand_HAW `hx711_seq` with origin note. | PO-FW-1, D-04, R2 §4.1, R3 §3.3 | Host vectors of the reused pure module pass; target on-chip measurement (DWT cycle counter around the read / timer capture of SCK, or equivalent) over 10 000 reads: max SCK-high ≤ 50 µs, read ≤ 60 µs. | T, T+H | M2 | Must |
| FW-AFE-002 | Gain/channel (A/128, A/64, B/32 = 25/27/26 pulses) and rate (10/80 SPS through the RATE GPIO) shall be configurable without reboot; defaults A/128 and 80 SPS. | PO-FW-1, PO-FW-4, D-04, D-21 | Twin: SET gain → pulse count changes on the next read; RATE pin level follows the parameter; defaults after DEFAULTS. | T | M2 | Must |
| FW-AFE-003 | After power-up, gain/rate change or a detected HX711 power-down/reset, the first `afe.settle_discard` (default 4) samples shall be flagged AFE_SETTLING in DATA (still subject to the load limit); a detected power-down shall trigger re-initialisation and increment a counter in GET_STATUS. | R2 §4.1, §4.3 | Twin: 4 flagged frames after a gain change; injected SCK-high overrun → re-init counter +1. | T | M2 | Must |
| FW-AFE-004 | The FW shall measure the real DOUT-ready period continuously (median of the last 16 periods), report the measured rate (0.1 SPS resolution) in GET_STATUS and set AFE_RATE_MISMATCH (flag + EVENT) when it deviates from the configured rate by more than `afe.rate_tol_pct` (default 20 %). | D-21, R2 §4.2 | Twin: HX711 model at 10 SPS with 80 configured → flag ≤ 1 s; 80 SPS ± 2 % → no flag; target: reported rate within ±1 % of an independent on-chip measurement (timer input capture of DOUT, or equivalent) and of the DATA t_us statistics. | T, T+H | M2 | Must |
| FW-AFE-005 | Each conversion shall be time-stamped with the 32-bit µs timer at DOUT-ready EXTI entry, and the commanded position (setpoint distance) shall be latched in the same ISR. | D-05, D-23, R4 §2.3, §9 | Twin: timestamp = virtual data-ready time ± 2 µs; latched position = step count at that instant. | T | M2 | Must |

#### FW-MOT — step/dir/enable motion
| ID | Requirement | Source | Acceptance criterion | V | MS | Pri |
|---|---|---|---|---|---|---|
| FW-MOT-001 | PUL shall be generated by a hardware timer in PWM mode with the pulse at the end of each period (R4 §1.3–1.4); pulse high width (default 12.5 µs, min 2.5 µs), minimum low width (default 12.5 µs), maximum step rate (default 40 kHz, cap **100 kHz**; defaults carry a 25 % margin over the 10 µs driver minimum, D-45 e) and DIR setup before the first active edge (default 20 µs) are parameters; DIR changes only while the timer is stopped; PUL/DIR/ENA polarities are parameters, and the PUL and ENA polarities take effect only after SAVE + REBOOT (`reboot_required`: a live change could emit a step edge or release a holding driver). | PO intro, D-16, D-24, D-29 (f), SD-06, SD-09, R2 §1.4, R4 §1.4 | Twin vectors; target at 50 kHz by on-chip measurement (PUL/DIR looped back to timer input capture, or equivalent): high ≥ 10 µs, low ≥ 10 µs, DIR setup ≥ 20 µs on every reversal. | T, T+H | M2 | Must |
| FW-MOT-002 | Position shall be an int32 step counter changed only per completed pulse and reported in µm via `steps_per_mm` with round half away from zero. | R4 §1.6, §2.2 | R4 TV-TC `um_to_steps`/`steps_to_um` vectors pass on host. | T | M2 | Must |
| FW-MOT-003 | Moves shall follow trapezoid/triangle profiles from the exact square-root ramp with fractional carry and separate accel/decel; period sequences match R4 TV-M within ±1 timer tick per period and ±ceil(N/1000) ticks in total (D-40 b); speed changes on the fly (JOG, controlled stop) use the virtual-index method. | R4 §1.5, §12 | Host vectors `motion_vectors.json` (TV-M 5.2 s move, triangle, asymmetric triangle, stop paths) pass. | T | M2 | Must |
| FW-MOT-004 | MOVE_ABS(target µm, speed µm/s, accel µm/s², 0 = default) shall move to the absolute target and send MOVE_DONE with the final position; a new MOVE_ABS/MOVE_UNTIL_LOAD while moving is refused (busy). | D-23, R4 §2.1 | Twin: 10 mm at 5 mm/s ends at the exact step count, duration = planner ± 1 ms; second move while moving → NACK busy. | T | M2 | Must |
| FW-MOT-005 | JOG(signed speed, accel, optional absolute bound) shall move in the sign direction toward the soft limit in that direction, or toward the bound if one is given (a bound must lie inside the soft limits, strictly ahead in the jog direction, and requires HOMED); "no bound" is the sentinel `JOG_NO_BOUND` = 0x80000000 (not 0, which can be a valid position); un-homed: no bound allowed, ≤ `motion.v_unhomed_um_s` and limited to the un-homed travel window (fixed un-homed origin ± `home.max_travel_um`, SAF-FW-020) — a held jog that reaches the window bound stops there and further JOG toward it is refused (E_RANGE) until homed; repeated JOG changes speed, accel and bound on the fly and refreshes the dead-man; JOG(0) = controlled stop, never refused by state. | PO-SW-5, D-23, D-29 (f), D-43 (b), SD-07, F-B-15, R4 §2.1 | Twin: jog never passes the soft limit or the bound; bound 0 is a real position; bound un-homed → NACK; un-homed: successive jogs never leave origin ± `home.max_travel_um`, JOG toward a reached bound → E_RANGE; speed change ramps without step loss. | T | M2 | Must |
| FW-MOT-006 | MOVE_UNTIL_LOAD(absolute travel bound — direction = sign(bound − x), speed, accel, raw stop threshold, comparison `cmp`: stop when raw ≥ threshold or raw ≤ threshold) shall check the last sample before the first pulse (already beyond → MOVE_DONE without motion), then move until the first sample beyond the threshold (immediate stop with the SAF-FW-002 load-path timing) or until the bound, and report MOVE_DONE with the reason; its speed cap is `motion.v_max_load_um_s`. | D-23, D-29 (e), (f), SD-07, R4 §2.1, §8.4 | Twin with specimen model: stop on the first sample past the threshold for both `cmp` values; already-beyond → no pulse; bound respected; reason codes correct. | T | M4 | Must |
| FW-MOT-007 | STOP(mode immediate / controlled) shall stop without latching; HALT shall stop immediately and latch HALT (source = PC) until HALT_CLEAR; PAUSE and RESUME per SAF-FW-023; STOP, HALT and PAUSE are accepted in every state and idempotent. | PO-SW-5, PO-SW-6, D-14, D-26, D-29 (a), D-30, D-31 | Twin: HALT during move → stop + latch; motion NACK until HALT_CLEAR; repeated HALT → one latch, OK responses. | T | M2 | Must |
| FW-MOT-008 | ENABLE shall assert the ENA enabled level, wait `motion.ena_settle_ms` (default **500 ms**) with no PUL/DIR edge — counted from the later of ENABLE and driver power return — and then set "enabled"; refused while ESTOP is latched or its input open, or while driver power is absent (SAF-FW-024). DISABLE (refused while moving) shall assert the disabled level and clear HOMED. | D-13, D-16, D-28, R2 §1.4–1.5, R5 §8 | Twin: first PUL/DIR edge ≥ 500 ms after ENABLE and ≥ 500 ms after DRV_PWR came on; ENABLE with DRV_PWR off → NACK; DISABLE while moving → NACK; after DISABLE HOMED = 0. | T | M2 | Must |
| FW-MOT-009 | `motion.steps_per_mm` (float32; dictionary range **100…100 000** — minimum 100 from the timer/ramp resolution; default **800** = 4000 pulses/rev on the 5 mm lead, D-27) shall be changeable only while idle; HOMED is kept and µm positions rescale (machine zero is a step count). All speed/acceleration parameters and command arguments are in µm/s and µm/s²; the effective speed limit is min(`motion.v_max_travel_um_s` or `motion.v_max_load_um_s` (SAF-FW-020), `motion.max_step_rate_hz`·1000/steps_per_mm), so a steps/mm change never invalidates a speed parameter. | PO-FW-4, D-19, D-27, D-29 (e), (f), SD-03, SD-09, R4 §2.2 | SET while moving → NACK busy; SET 99 → E_RANGE; SET 100 and 10 000 accepted; after SET while idle, reported position = steps·1000/spm; at spm = 10 000 a 10 mm/s move is refused (E_RANGE, step-rate cap) while the v_max parameters are unchanged. | T | M2 | Must |

#### FW-HOM — homing / zeroing
| ID | Requirement | Source | Acceptance criterion | V | MS | Pri |
|---|---|---|---|---|---|---|
| FW-HOM-001 | HOME shall run: pre-check (enabled, driver powered, no latch, no ALM start-block, SAF-FW-021) → release the START switch if active → fast seek toward the **START** switch at `home.v_fast_um_s` → immediate stop on the edge → back-off `home.backoff_um` → slow approach at `home.v_slow_um_s` capturing the position at the first switch edge in the EXTI ISR → set zero so that the edge lies at −`home.offset_um` → move to 0 → HOMED + EVENT. Release 1 homes **only at the START switch**; END homing is not supported and there is no home-switch parameter (`home.ref_switch` retired in dict_version 2). | PO-FW-2, D-08, D-18, D-29 (b), OI-ICD-01, R4 §3.1 | Twin with switch model incl. bounce: HOMED set, final position 0 = edge + offset ± 1 step. | T | M2 | Must |
| FW-HOM-002 | Homing failures shall stop immediately, leave the axis not homed and report: no switch within `home.max_travel_um` → fault HOME_NOT_FOUND; opposite (END) switch reached → fault HOME_WIRING; any other stop/fault during HOME → homing aborted, reported by EVENT (HOME_FAILED, reason ABORTED) but not latched as a fault (the stopping cause has its own latch, if any). | R4 §3.1, OI-ICD-03 | Twin: the three scenarios give the expected fault / EVENT; after an aborted homing FAULT_CLEAR has nothing homing-related to clear. | T | M2 | Must |
| FW-HOM-003 | The home position shall be repeatable within 0.02 mm (2σ) over 10 homing cycles. | R4 §3.1 | Target: dial indicator at the zero position, 10 cycles. | T+H | M2 | Should |
| FW-HOM-004 | Home drift check: when HOME runs on an axis that was already homed, the FW shall compare the captured switch edge with its expected position (−`home.offset_um`); a deviation > `home.drift_tol_um` (default 200 µm) shall latch fault HOME_DRIFT (FAULT_SET with the deviation in µm) while homing still completes with the new zero; EVENT HOMED carries the deviation in every case; FAULT_CLEAR clears HOME_DRIFT at once. (Detects lost steps or pulses the driver did not execute, e.g. with a wrong DIP setting or a dropped PUL edge.) | R5 §8, D-27, D-29 (f), SD-02 | Twin: re-homing after injected lost steps of 0.1 mm → no fault, deviation reported; 0.3 mm → HOME_DRIFT latched, HOMED set, motion refused until FAULT_CLEAR. | T | M2 | Must |

#### FW-SW — switch and button inputs
| ID | Requirement | Source | Acceptance criterion | V | MS | Pri |
|---|---|---|---|---|---|---|
| FW-SW-001 | START/END limit inputs shall use own EXTI lines, react on the first edge (no software delay) and debounce only the release (stable ≥ `io.release_ms`, default 20 ms, 1 kHz sampling); hardware RC τ ≈ 100 µs. | PO-FW-2, D-18, R4 §3.4 | Twin with bounce model: one stop per hit; release reported after 20 ms stable. | T | M2 | Must |
| FW-SW-002 | The E-stop sense input shall use its own EXTI at the highest interrupt priority, never masked by AFE critical sections (BASEPRI scheme), with hardware RC τ ≤ 10 µs; release debounced ≥ `io.estop_release_ms` (default 100 ms). | D-11, R4 §1.8, §3.4 | Inspection of NVIC priorities/BASEPRI; twin release test. | I, T | M2 | Must |
| FW-SW-003 | The physical PAUSE button input (PB6, operator panel) shall have an EXTI with priority just below the E-stop, react on the first active edge, debounce release/re-arm with `io.release_ms`, have a contact-type parameter (`io.pause_active_level` default CLOSED_ACTIVE = **NO**, D-28), and report its state in DATA status and GET_STATUS plus an EVENT on every press. There is no physical STOP/BREAK button input (D-36). | D-14, D-26, D-28, D-36 | Twin with bounce model: one EVENT per press; polarity parameter inverts detection; state bit in DATA. | T | M2 | Must |
| FW-SW-004 | ALM and PEND inputs shall be read with polarity parameters `drv.alm_active_level` / `drv.pend_active_level`, reported in every DATA frame status and GET_STATUS, with an EVENT on every ALM change; PEND not active within `drv.pend_timeout_ms` after the last pulse of a move → EVENT NOT_SETTLED (warning only, 0 = off). **No stop of a running move** by ALM in this release; the only reaction is the ALM start-block (SAF-FW-026). | D-16, D-28, SD-02, R5 §3.4 | Twin: ALM toggle during a move → flag + EVENT, motion continues; ALM active → new motion NACK; PEND withheld → NOT_SETTLED; inspection: no stop path from ALM. | T, I | M2 | Must |
| FW-SW-005 | The DRV_PWR input (PA7, optional 48 V presence sense — no contactor since CR-03; closed = driver powered, fixed polarity) shall be sampled at 1 kHz with a 20 ms stability filter, reported in DATA status (DRV_PWR) and GET_STATUS, with EVENT DRIVER_POWER on every change, and feed SAF-FW-024…026; with `drv.pwr_sense_enable` = false (**default** since CR-03, reboot required) it is ignored and DRV_PWR reads "powered". | D-28, D-29 (c), D-41, SD-02, SD-06, R5 §1.5 | Twin: input toggles shorter than 20 ms ignored; change → status bit + EVENT; default (sense disabled) → DRV_PWR = 1. Target (sense fitted): 48 V supply off/on observed. | T, T+H | M2 | Must |

#### FW-CFG / FW-NVM — configuration
| ID | Requirement | Source | Acceptance criterion | V | MS | Pri |
|---|---|---|---|---|---|---|
| FW-CFG-001 | All configuration parameters shall be defined only in `params.yaml` (id, type, unit, min, max, default, NVM flag (`nvm: false` = session parameter), settable-while-moving flag, reboot-required flag); FW tables are generated and never hand-edited. | PO-FW-4, CONV, D-29 (f), SD-05, SD-06 | Generator `--check` passes in CI; no hand-written parameter table in `02_FW`. | I | M1 | Must |
| FW-CFG-002 | A command sequence shall read **all** parameters (ids + values, paged if needed). | PO-FW-5 | Twin: every dictionary entry returned exactly once with its current value. | T | M1 | Must |
| FW-CFG-003 | A command shall set any single parameter: type and range checked (out of range → E_RANGE, never clamped), hard rules checked, parameters not settable while moving → busy; the response returns the value as stored; no implicit flash write; a `reboot_required` parameter becomes effective only after SAVE + REBOOT and sets REBOOT_PENDING in GET_STATUS until then. | PO-FW-6, D-29 (f), SD-06 | Vectors per parameter type: min/max accepted, min−1/max+1 refused; flash untouched after SET; SET `motion.ena_invert` → old level kept, REBOOT_PENDING = 1. | T | M1 | Must |
| FW-CFG-004 | GET_INFO shall return protocol version (major.minor), payload version, FW version + build id, parameter-dictionary hash, MCU UID and feature mask. | IF-008, R3 §1.4 | Twin: fields match build constants and generated hash. | T | M1 | Must |
| FW-NVM-001 | SAVE, LOAD and DEFAULTS commands shall exist; CFG_DIRTY (RAM ≠ NVM record) shall be reported with one normative definition (ICD). | PO-FW-6, R3 §1.4, §1.7 P2 | Twin: SET → dirty; SAVE → clean; reboot → saved values restored; DEFAULTS → defaults, dirty. | T | M1 | Must |
| FW-NVM-002 | NVM shall use two alternating flash records with sequence number, CRC-32 and dictionary hash: a power loss during SAVE keeps the previous record; corrupt/absent → defaults + flag; changed hash → migration by id (same id, type and in range kept); ≥ 10 000 saves; session parameters (`nvm: false`) are never written, start at their defaults and are kept by LOAD. | R2 §5.5, R3 §1.4, D-29 (f), SD-05 | Twin flash model: power cut at every program step → a valid record at boot; endurance analysis. | T, A | M1 | Must |
| FW-NVM-003 | Flash erase/program shall run only while idle (otherwise busy), after queued TX frames are drained; HX711 samples lost during the stall are flagged; commands received during the operation are executed and answered right after it (D-37 (a)). | R2 §5.5, R3 §1.7 P5 | Twin: SAVE while moving → NACK; target: no split frame on the wire around SAVE. | T, T+H | M1 | Must |

#### FW-CMD — command handling
| ID | Requirement | Source | Acceptance criterion | V | MS | Pri |
|---|---|---|---|---|---|---|
| FW-CMD-001 | Every CRC-valid command shall get exactly one response echoing its link sequence number; NACK carries status + detail and has no side effect; check order type → length → arguments → state → execution; unknown type → NACK. | IF-005, R3 §1.3 | Shared protocol vectors pass (incl. unknown type, wrong length). | T | M1 | Must |
| FW-CMD-002 | SET_VALID(0/1) shall return the device time t_us from which the value applies; every DATA frame with t_us ≥ that value carries it. | PO-FW-7, D-05, R4 §8.5 | Twin: frames before/after the boundary carry the old/new value. | T | M1 | Must |
| FW-CMD-003 | FAULT_CLEAR shall clear latched faults (LOAD_LIMIT per SAF-FW-011, AFE_FAULT, STEP_FAULT, LIMIT_WIRING, HOME_NOT_FOUND, HOME_WIRING, HOME_DRIFT, K1_WELDED) only when their cause is gone; otherwise NACK naming the remaining cause and nothing is cleared. ESTOP, HALT and PAUSED have their own clear commands (ESTOP_CLEAR, HALT_CLEAR, RESUME). | R4 §4.2, D-29 (c), D-31, SD-02 | Twin: one test per fault. | T | M2 | Must |
| FW-CMD-004 | GET_STATUS shall report: rx frames OK / CRC errors / framing errors, RX overruns, TX drops, loop_max_us, reset cause, link age, measured AFE rate, AFE re-init count, all latches and faults with the PAUSE source (HALT source is always PC, D-36), all input states incl. DRV_PWR, motion state, commanded position, active target, step count, current speed cap, CLK_FALLBACK, CFG_DIRTY, REBOOT_PENDING, last NVM save time. | R3 §1.4, D-21, D-28, F-B-02, SD-11 | Twin: each counter increments under its injected condition. | T | M1 | Must |

#### FW-STR / FW-TIM — streaming and time base
| ID | Requirement | Source | Acceptance criterion | V | MS | Pri |
|---|---|---|---|---|---|---|
| FW-STR-001 | STREAM_START / STREAM_STOP commands shall start/stop DATA frames; the stream is off after boot; the stream state does not affect any safety function. | PO-FW-8 | Twin: start/stop; SAF tests pass with stream off. | T | M1 | Must |
| FW-STR-002 | One DATA frame per HX711 conversion shall be sent, transmission starting ≤ 2 ms after data-ready, extended only by the remaining wire time of a frame already being transmitted (≤ 1.82 ms at the ICD maximum frame of 168 B) (M1: synthetic samples at 80 Hz). | D-23, PROCESS M1, OI-FW-02 | Twin: frames = conversions over 10 min; latency max ≤ 2 ms when no other frame is on the wire, ≤ 2 ms + wire time of the frame in transmission otherwise. | T | M1 | Must |
| FW-STR-003 | DATA shall carry the fields of IF-006, with status bits at least: VALID, MOVING, HOMED, ENABLED, ESTOP, HALT, FAULT (any fault latched), PAUSED, LIMIT_START, LIMIT_END, LOAD_LIMIT, AFE stale/saturated/settling, AFE_RATE_MISMATCH, LINK_WDG, PAUSE button, ALM, PEND, DRV_PWR, NO_AFE_DATA (fallback frame), OVERRUN, `pos_uncertain`. CLK_FALLBACK is not a DATA bit (FW-PLT-002). Status bits of a feature whose GET_INFO feature bit is 0 (e.g. ALM, PEND, DRV_PWR without FEAT_DRV_SIGNALS) are sent as 0 and are **invalid** (D-37 (b)). | PO-FW-11, D-05, D-23, D-28, D-29 (f), D-36, D-37 (b), SD-10 | Shared codec vectors; twin: each bit set under its condition. | T | M1 | Must |
| FW-STR-004 | The u16 frame sequence counter shall increment by 1 per DATA frame, also for frames dropped in the FW; the next sent frame carries OVERRUN. | D-23, R4 §9 | Twin with forced TX congestion: counter gap = dropped frames, OVERRUN set. | T | M1 | Must |
| FW-STR-005 | While the AFE is stale, the FW shall send DATA frames at `stream.fallback_hz` (default 10 Hz) marked "no AFE data", so that position and status stay visible. | R3 §1.6 (a) | Twin: DOUT silent → 10 Hz frames with the marker. | T | M2 | Should |
| FW-STR-006 | EVENT frames shall report: every stop with cause, fault set/clear (incl. K1_WELDED, HOME_DRIFT), VALID auto-cleared (with cause), MOVE_DONE, HOMED (with drift) / homing failure, driver enable/disable (incl. idle, E-stop, power loss), driver power changes, PAUSED (with source) / PAUSE_CLEARED (by RESUME or HALT_CLEAR), PAUSE button presses, RESUME_REQUEST, ALM changes, NOT_SETTLED, AFE re-init and rate mismatch, CLK_FALLBACK; queue ≥ 8 deep, overflow counted. | R3 §1.4, R4 §4, D-26, D-28, D-29 (a), (c), D-31, SD-02 | Twin: each event observed with correct code and t_us. | T | M2 | Must |
| FW-TIM-001 | A free-running 32-bit 1 MHz timer (wrap 71.6 min) shall be the device time base for DATA t_us, SET_VALID and EVENT timestamps; data-ready timestamp latency ≤ 5 µs. | PO-FW-11, D-23, R4 §9 | Twin; target: timestamp vs an independent timer input capture of the DOUT edge (or equivalent), max difference ≤ 5 µs. | T, T+H | M2 | Must |

#### FW-PAR — required configuration parameters (existence and range; dictionary = Integrator, §5)
| ID | Requirement | Source | Acceptance criterion | V | MS | Pri |
|---|---|---|---|---|---|---|
| FW-PAR-001 | The dictionary shall contain the AFE parameters of Table 5.1 (gain/channel, rate, rate tolerance, settle discard, stale timeout with the hard rule ≥ 2 × conversion period) with at least the listed ranges and the listed defaults. | PO-FW-1, PO-FW-4, D-04, D-21, D-33 (a) | `params.yaml` review against Table 5.1; generated C/Python contain them; SW-CFG displays them. | I | M1 | Must |
| FW-PAR-002 | The dictionary shall contain the mechanics and pulse-timing parameters of Table 5.1 (steps/mm, PUL/DIR/ENA polarity — PUL and ENA reboot-required, pulse high/low width, max step rate, DIR setup, ENA settle default 500 ms). | PO-FW-4, D-16, D-19, D-28, SD-06 | as FW-PAR-001. | I | M1 | Must |
| FW-PAR-003 | The dictionary shall contain the speed/acceleration parameters of Table 5.1 (v_max travel 30 mm/s and v_max under load 20 mm/s with hard rule load ≤ travel, a_max, a_stop, v_unhomed, jog timeout), all in length units (µm/s, µm/s²), never in steps. | D-19, D-27, D-29 (e), SD-03, R4 §2.1, §3.2, R5 §2.3 | as FW-PAR-001; inspection: no step-unit speed parameter. | I | M1 | Must |
| FW-PAR-004 | The dictionary shall contain the travel parameters of Table 5.1 (soft min/max with rule min < max; homing fast/slow speed, accel, back-off, offset, max travel, drift tolerance — no home-switch parameter: START only in release 1). | PO-FW-2, D-18, D-19, D-29 (b), SD-02, R4 §3 | as FW-PAR-001. | I, T | M1 | Must |
| FW-PAR-005 | The dictionary shall contain the safety parameters of Table 5.1 (load raw min/max and zero_raw as session parameters, trip samples, regrow, release band, homing max load, idle disable time, link timeout). | D-12, D-15, D-29 (f), SD-05, R4 §4 | as FW-PAR-001. | I | M1 | Must |
| FW-PAR-006 | The dictionary shall contain the I/O parameters of Table 5.1 (`io.release_ms`, `io.estop_release_ms`, PAUSE contact type, ALM/PEND polarity, PEND timeout, driver-power sense enable (reboot-required), K1 weld detection time, stream fallback rate) and shall **not** contain polarity parameters for the E-stop sense, limit and DRV_PWR inputs. | D-16, D-26, D-28, D-36, SD-02, SD-04, SAF-FW-007 | as FW-PAR-001. | I | M1 | Must |

### 4.5 Interface (IF-)

| ID | Requirement | Source | Acceptance criterion | V | MS | Pri |
|---|---|---|---|---|---|---|
| IF-001 | The PC⇄FW protocol shall be fully specified in `ICD_protocol.md`, owned by the Integrator, versioned with a change history; FW and SW implement only from it. | CONV, PROCESS §1 | ICD exists with version + history; review: every command/field used in code appears in the ICD. | I | M1 | Must |
| IF-002 | Physical link: USART2 via the ST-LINK/V2-1 VCP, **921 600 Bd, 8N1, no flow control**, binary (not human-readable), multi-byte values little-endian. | PO-FW-9, PO-FW-10, D-03 | Twin/codec vectors little-endian; target soak (SYS-009) at 921 600 Bd. | T, T+H | M1 | Must |
| IF-003 | Every frame shall start with a fixed **separator** (sync bytes), followed by type, link sequence number, length, payload, CRC; the ICD fixes the maximum payload and the receiver resync rules (drop one byte on CRC/length error, inter-byte timeout). | PO-FW-10, D-05, R3 §1.1–1.2 | Both parsers reproduce the shared stream vectors (bad CRC, noise, sync in payload, truncated frames). | T | M1 | Must |
| IF-004 | Every frame in **both directions** shall carry a CRC-16 (variant fixed in the ICD; proposed CRC-16/CCITT-FALSE, check "123456789" → 0x29B1); frames with a bad CRC are dropped, counted and never acted upon. | PO-FW-9, PO-FW-10, D-03 | CRC check vector; corrupted-frame vectors produce no action and increment the counter. | T | M1 | Must |
| IF-005 | Command/response: one response per CRC-valid command echoing its sequence number, ACK/NACK with status + detail; the PC retries only idempotent commands (queries, parameter writes, stream/valid, JOG 0), with a new sequence number and the newest value; STOP/HALT/PAUSE are repeated until confirmed; **motion commands (MOVE_ABS, MOVE_UNTIL_LOAD, HOME, JOG ≠ 0), ENABLE/DISABLE, NVM commands, REBOOT, RESUME and the clears (HALT_CLEAR, ESTOP_CLEAR, FAULT_CLEAR — still sent on the priority path) are never auto-retried** (D-31, D-34) — after a response timeout the SW determines the outcome from GET_STATUS; the FW has no duplicate acknowledgement; a motion command refused with E_STATE (BLOCK PAUSED) is an expected outcome — no retry, not counted as a link failure. Response timeouts, retry classes and counts are defined in the ICD. | R3 §1.3, §1.5, §1.7 P4, D-29 (f), D-31, D-33 (k), D-34, SD-08, F-B-01 | Protocol vectors; simulator with dropped responses: no duplicated motion, no motion command, RESUME or clear sent twice. | T | M1 | Must |
| IF-006 | The DATA frame shall contain: system time t_us (u32 µs), payload version (1 B), flag byte with bit 0 = data validity, AFE raw (i32), setpoint distance (i32 µm), frame sequence counter (u16), status flags (FW-STR-003), CRC-16; byte layout defined in the ICD. | PO-FW-11, D-05, D-23 | Codec vectors decode every field; ICD layout review. | T, I | M1 | Must |
| IF-007 | Exactly one DATA frame shall be sent per HX711 conversion (fallback frames per FW-STR-005 marked as such). | D-23 | Twin: frame count = conversion count over 10 min. | T | M1 | Must |
| IF-008 | Versioning: PROTO_VERSION major.minor (minor = backward-compatible additions), PAYLOAD_VERSION in every DATA frame, parameter-dictionary hash in GET_INFO; at connect the SW refuses motion and shows read-only state on a major or payload-version mismatch, and makes the configuration read-only with a warning on a hash mismatch. | R3 §1.3, §2.1 | Simulator with mismatching versions/hash → expected SW behaviour. | T | M1 | Must |
| IF-009 | Wire units: positions µm (i32), speeds µm/s, accelerations µm/s², times µs, load raw counts; motion commands carry absolute targets only (no relative moves). | D-23, R4 §0.1, R3 §1.6 (b) | ICD review; codec vectors. | I | M1 | Must |
| IF-010 | `params.yaml` shall generate the FW C header and the SW Python module (never hand-edited, `--check` in CI); shared protocol vectors and a reference codec shall be used by FW host tests and SW pytest alike. | CONV, R3 §2, §7.1 | CI job runs `--check` and both test suites on the same vector file. | I, T | M1 | Must |
| IF-011 | FW→PC traffic shall stay ≤ 10 % of the link capacity at 80 Hz incl. events; STOP, HALT, PAUSE and the clear frames (HALT_CLEAR, ESTOP_CLEAR, FAULT_CLEAR) from the PC use the priority path and are never delayed by SW queues or TX throttling; RESUME uses the normal control lane (D-37 (c)). | R3 §1.5, R4 §9, D-29 (a), D-31, D-37 (c) | Analysis of frame sizes; SW test: STOP sent while the queue is full goes out first. | A, T | M1 | Must |
| IF-012 | The ICD shall define at least: PING, GET_INFO, GET_STATUS, GET_ALL_PARAMS, GET_PARAM, SET_PARAM, SAVE/LOAD/DEFAULTS, STREAM_START/STOP, SET_VALID, ENABLE/DISABLE, HOME, MOVE_ABS, JOG (with optional bound), MOVE_UNTIL_LOAD (with comparison sense), STOP, HALT/HALT_CLEAR, **PAUSE**, **RESUME**, ESTOP_CLEAR, FAULT_CLEAR, REBOOT; async DATA and EVENT. | PO-FW-5…8, D-23, D-26, D-29 (a), (f), D-31, SD-01, SD-07 | ICD review checklist. | I | M1 | Must |

### 4.6 PC software (SW-)

#### SW-PLT — platform
| ID | Requirement | Source | Acceptance criterion | V | MS | Pri |
|---|---|---|---|---|---|---|
| SW-PLT-001 | The SW shall be a Windows 10 (64-bit) desktop application on **Python 3.14** (64-bit) with PySide6, pyqtgraph, numpy, pyserial, delivered (a) as a self-contained Windows distribution that needs no Python on the target PC (one-folder build with its own runtime, operator manual and quick-reference card, built by `03_SW/packaging/build_dist.ps1`; optional installer) and (b) for development, installable into a Python 3.14 venv from documented requirements files (`03_SW/requirements*.txt`). | PROCESS §5, D-33 (i), SWD-P1-16, D-50 (b) | (a) Fresh install of the distribution on a Windows 10 PC without Python starts and passes the packaging smoke checks (DM-02); (b) fresh install into a new Python 3.14 venv from the requirements files starts; dependency list inspected; no other Python version is supported or tested. | I, D | M1 | Must |
| SW-PLT-002 | Backend packages (`core`, `io`, `calc`) shall not import Qt widgets; calculations shall be pure functions covered by pytest vectors (all R4 §12 vectors). | CONV | Import-check test; pytest of R4 §12 passes. | T, I | M1 | Must |
| SW-PLT-003 | The SW shall connect to a COM port or to the simulator/twin endpoint, run the connect sequence (GET_INFO → version/hash check → GET_STATUS → GET_ALL_PARAMS) and show link statistics (frames, lost frames, CRC errors). | R3 §1.5, IF-008 | Simulator connect test; statistics change under injected loss. | T | M1 | Must |

#### SW-CFG — board configuration (PO-SW-1)
| ID | Requirement | Source | Acceptance criterion | V | MS | Pri |
|---|---|---|---|---|---|---|
| SW-CFG-001 | The SW shall read all settings from the board and display them in dedicated typed fields generated from the dictionary (unit, range, enum names, board value, default, edited value). | PO-SW-1 | GUI test vs simulator: every parameter shown, values equal the board. | T | M1 | Must |
| SW-CFG-002 | The configuration shall be saved to a JSON file (enums by name, dictionary hash) and recalled; recall fills edit fields only and reports unknown, missing and out-of-range entries and hash mismatch. | PO-SW-1 | Round trip identical; crafted file → each report case shown. | T | M1 | Must |
| SW-CFG-003 | Edited values shall be checked against hard rules, written to the board and validated by read-back, with per-parameter status OK / REJECTED / MISMATCH / BUSY / TIMEOUT; reboot-required parameters are marked and the SW offers SAVE + REBOOT; session parameters (`safety.zero_raw`, `safety.load_raw_min/max`) are shown read-only (owned by SAF-SW-002) and excluded from the configuration file. | PO-SW-1, D-29 (f), SD-05, SD-06, F-B-21 | Simulator with injected rejection/mismatch → status shown; reboot-required item → REBOOT_PENDING shown; session rows not editable. | T | M1 | Must |
| SW-CFG-004 | Buttons shall save to NVM, reload from NVM and restore defaults (with confirmation), and a CFG_DIRTY indicator shall be shown. While a SAVE (or LOAD/DEFAULTS) is outstanding the SW shall send **no non-stop command**; STOP, HALT and PAUSE stay allowed (the FW executes them right after the flash operation), so the FW receive ring cannot overflow (D-37 (a)). | PO-SW-1, FW-NVM-001, D-37 (a) | Demonstration against the simulator; wire-log test: between a SAVE and its response only stop-class frames appear. | D, T | M1 | Must |

#### SW-LIM — safety limits (PO-SW-2)
| ID | Requirement | Source | Acceptance criterion | V | MS | Pri |
|---|---|---|---|---|---|---|
| SW-LIM-001 | Travel limits (min/max, machine mm, each with enable) shall be configurable within the FW soft limits; manual control and the sequencer refuse targets outside them; violations are enforced by SAF-SW-001. | PO-SW-2 | Test: target outside → refused with message; limit outside soft limits → refused. | T | M3 | Must |
| SW-LIM-002 | Load limits shall be configurable: pull max (N > 0) and push max (N < 0), each with enable and warning level (defaults ±100 % FS trip, 90 % warning), plus the FW load-limit level (default 110 % FS; may be set lower but not below the SW trip level; never above 110 % FS) used by SAF-SW-002. | PO-SW-2, D-12 | Test: FW level > 110 % FS or < SW trip → refused; warning indicator at 90 %. | T | M3 | Must |
| SW-LIM-003 | Limits shall be saved/recalled with the session file, applied at start, and recorded in the recording metadata and the report. **(D-53 a)** Independently of which load limits are enabled, motion commands require a valid load input (calibration + tare in this session, no AFE fault, SAF-SW-001) or the no-specimen mode (SW-LIM-004); switching both SW load limits off outside the no-specimen mode is refused, and a session file with both load limits off is restored with both on and a warning. | PO-SW-2, PO-SW-3, D-53 (a), SWR-03 | Round trip; JSON metadata contains the limits; session with both load limits off → restored on + warning, motion refused until tare or no-specimen mode. | T | M3 | Must |
| SW-LIM-004 | **No-specimen mode** (first use / no valid calibration): the operator may switch the SW load limits off for the current session only after an explicit confirmation ("no specimen mounted — SW load limits off"; SAF-SW-004 dialog rules); while active, a persistent banner is shown on every tab and the mode is recorded as an event in recordings and reports; the FW load limit stays active — with the calibrated SAF-SW-002 thresholds when a valid calibration + tare exist, otherwise at its nominal default thresholds (SAF-FW-010 defaults; never widened); travel limits stay active; the travel calibration wizard and the load-calibration wizard are allowed in this mode. The mode is never saved to a file and ends when the operator re-enables the load limits, at disconnect and at application exit. | PO-SW-2, D-12, D-29 (h), F-B-08, GF-07 | Simulator: no calibration → motion refused; confirm no-specimen mode (Enter/Space do not confirm) → banner, jog allowed, both wizards run; FW thresholds read back = defaults without calibration, = calibrated values with a valid calibration + tare; event row in the recording; restart → mode off, limits enabled. | T | M3 | Must |

#### SW-META — report marks (PO-SW-3)
| ID | Requirement | Source | Acceptance criterion | V | MS | Pri |
|---|---|---|---|---|---|---|
| SW-META-001 | Report marks shall include measured element (specimen), specimen number, operator and notes, plus user-defined custom key/value fields (add, rename, remove). | PO-SW-3 | GUI test: custom field added appears in the JSON metadata and HTML report. | T | M3 | Must |
| SW-META-002 | Mark presets shall be saved/recalled; marks plus an automatic snapshot (board configuration, calibration, tare, limits, SW/FW versions) shall be included in every recording and report. | PO-SW-3, D-23 | Test: recording JSON contains marks + snapshot. | T | M3 | Must |

#### SW-RT — realtime display (PO-SW-4)
| ID | Requirement | Source | Acceptance criterion | V | MS | Pri |
|---|---|---|---|---|---|---|
| SW-RT-001 | Realtime plot windows shall be detachable (dock, float, re-attach), at least two at a time, each with its own STOP button; the layout is restored at the next start. | PO-SW-4, R3 §6.2 | GUI test float/re-attach; restart restores layout. | T, D | M3 | Must |
| SW-RT-002 | Plots shall be switchable on/off per channel for every DATA field (raw, setpoint distance, sample rate, frame-sequence gaps, each status bit) and for every derived channel; derived channels whose prerequisites (calibration, tare, geometry) are missing are shown greyed. | PO-SW-4 | GUI test toggles every channel; greyed state without calibration. | T | M3 | Must |
| SW-RT-003 | A time view (adjustable window 5–600 s, freeze, auto/manual Y) and an **X-Y view** (x = travel mm, y = load N or kgf) of the live data shall be available. | PO-SW-4, PO-SW-15, R3 §6.2 | Demonstration with the simulator. | D | M3 | Must |
| SW-RT-004 | Derived channels per R4 §10 shall be provided: force N and kgf, travel mm (machine and test), speed, force rate, tangent and secant stiffness, work, peak force, noise (rolling std), sample rate / lost frames, and optional 3-point-bend stress/strain when geometry is entered; each a pure function with vectors. | PO-SW-4, R4 §10 | pytest R4 TV-D and derived-channel vectors. | T | M3 | Must |
| SW-RT-005 | Numeric readouts (value and state n/a / STALE / SATURATED / INVALID) shall be shown for force, travel, raw and sample rate. | R3 §6.11 | Demonstration with injected states. | D | M3 | Should |
| SW-RT-006 | Plot windows shall hold plot panes arranged in a grid of 1, 2, 3 or 4 columns selectable per window; the user shall be able to add a pane, plot a channel in / move it to a chosen pane, reorder panes by drag and drop, move a pane with its curves to another plot window, rename and close panes; by default a newly shown channel joins the first pane showing the same quantity, otherwise an empty pane is reused before a new one is created; unticking a channel removes only its curve and an emptied pane is kept; the time axis is linked within a window; the X-Y (travel–load) view is available as a pane; the arrangement (columns, pane order, curves per pane) is restored at the next start; all panes share one data snapshot per distinct time window. | PO 2026-10-04 (D-38), Thrust_Stand SW-RT-004 / D-62 / D-63, OI-F-M2-01 | GUI tests: column switch keeps order; drag-reorder; move pane to another window keeps curves; quantity grouping and empty-pane reuse per D-63 rules (1)–(5); restart restores layout; refresh test: one snapshot per time window with 4 panes; NFR-001 frame interval holds with 4 panes. | T, D | M3 | Must |

#### SW-MAN — manual control (PO-SW-5)
| ID | Requirement | Source | Acceptance criterion | V | MS | Pri |
|---|---|---|---|---|---|---|
| SW-MAN-001 | A slider shall set the target position over the SW travel range; one MOVE_ABS is sent on release (nothing while dragging); disabled when not homed. | PO-SW-5, D-23 | GUI test: drag sends nothing; release sends one MOVE_ABS with the slider value. | T | M3 | Must |
| SW-MAN-002 | A numeric entry shall accept an absolute target or a travel distance (±mm); a distance is converted by the SW to an absolute target = last commanded target (incl. a pending one, SW-MAN-003) + distance. | PO-SW-5, D-23 | Test: the wire carries only absolute targets. | T | M3 | Must |
| SW-MAN-003 | Buttons −10, −1, −0.1, +0.1, +1, +10 mm shall produce absolute targets = last commanded target ± step; repeated clicks accumulate on the commanded target, not on the live position. **Latest-wins:** a target issued while the axis is moving becomes the pending target (a newer one replaces it) and is sent when the running move completes (MOVE_DONE); the GUI shows the pending target. | PO-SW-5, D-23, D-29 (i), F-B-09, GF-04 | Test: three +1 mm clicks from 10.000 mm → final commanded target 13.000 mm; clicks during a move: no MOVE_ABS before MOVE_DONE, then exactly one MOVE_ABS with the newest target (e.g. wire sequence 11, 13). | T | M3 | Must |
| SW-MAN-004 | Hold-to-jog forward/rear buttons shall send JOG while pressed (refresh ≤ 100 ms) and JOG 0 on release or focus loss; jog works un-homed at ≤ v_unhomed. | D-23, SAF-FW-016 | GUI test incl. focus loss → JOG 0 sent. | T | M3 | Must |
| SW-MAN-005 | Manual speed and acceleration fields (limited to the FW maxima) and a STOP button for immediate stop shall be on the manual tab. | PO-SW-5 | Test: values above max refused; STOP sends STOP immediate. | T | M3 | Must |
| SW-MAN-006 | The manual tab shall offer driver enable/disable (bound to FW state), HOME, set test travel zero (PC offset) and the VALID flag toggle. | PO-FW-2, PO-FW-7, D-23 | Demonstration with the simulator. | D | M3 | Must |

#### SW-STOP — stop, Pause/Break, pause/resume (PO-SW-5, PO-SW-6)
| ID | Requirement | Source | Acceptance criterion | V | MS | Pri |
|---|---|---|---|---|---|---|
| SW-STOP-001 | A GUI STOP button (immediate operational stop, D-26 (2)) shall be present as the first toolbar item, in every floating window and in every dialog; it acts on mouse press (GQ-20), never takes keyboard focus, bypasses command queues and terminates any running sequence or wizard motion. A STOP counts as confirmed only by its ACK or by an indication (MOVING = 0) whose FW device time `t_us` is ≥ the FW receive time of the STOP — never by PC receive order alone (D-37 (d)). Native OS file dialogs are disabled application-wide (Qt non-native dialogs) so that every dialog, including file open/save, carries STOP. | PO-SW-5, PO-SW-6, D-26, D-32 (Q27), D-37 (d), GF-02 | GUI test "STOP reachable on every tab/window/dialog" incl. the file open/save dialogs; inspection: native dialogs disabled at application start; latency per NFR-002. | T, I | M3 | Must |
| SW-STOP-002 | A system-wide Pause/Break hotkey (Pause, Ctrl+Break; also when the application is not focused) shall send HALT, terminate the running sequence and any calibration/tare step, and repeat HALT until it is acknowledged (ACK, or HALT shown in DATA/GET_STATUS with a device time `t_us` ≥ the FW receive time of the HALT, D-37 (d)) — ≤ 20 tries in 1 s, also with the stream off. The GUI shows whether the hotkey is active; known limitation KL-01 (§8.1, accepted by the PO, D-32 Q28): not delivered while an elevated (Administrator) window has focus. | PO-SW-6, D-14, D-26, R3 §6.3, GF-03 | Test with another (non-elevated) application focused; latency per NFR-003; hotkey state indicator shown. | T | M3 | Must |
| SW-STOP-003 | A HALT, ESTOP or driver-power loss reported by the FW from any source (GUI STOP / Pause/Break key, E-stop, driver-power loss if sensed) shall terminate any running sequence/wizard/tare within one received frame; a latched HALT shall be cleared only by an explicit GUI "Clear stop" action (HALT_CLEAR, which also clears PAUSED, D-31); no motion restarts automatically after the clear. | D-11, D-14, D-26, D-29 (c), D-36 | Simulator: HALT, E-stop EVENT and DRV_PWR loss during a sequence → sequence terminated; clear sends HALT_CLEAR; no motion command follows automatically. | T | M3 | Must |
| SW-STOP-004 | Sequence Pause — GUI Pause (sends the PC **PAUSE** command; the FW performs the controlled stop and sets PAUSED) or the physical PAUSE EVENT — shall keep the sequence state; while PAUSED no motion command is sent, and a command already in flight that is refused with E_STATE PAUSED is an expected outcome (no retry, no link-degradation count, the sequence stays paused). Resume (GUI Resume or RESUME_REQUEST from the button) shall send **RESUME** and, after its ACK, re-issue the interrupted step's motion (absolute target, or approach + trim) and restart its capture window; a RESUME refused because HALT, ESTOP or a fault is latched is an expected outcome (no retry, no re-issue; the HALT/ESTOP terminates the sequence). In manual mode Pause is a controlled stop and the motion controls stay disabled until Resume. | D-14, D-26 (1), D-29 (a), D-30, D-31, D-33 (k), PO-SW-12, SD-01, GF-01, SWD-P1-01 | Simulator: GUI Pause sends PAUSE; while PAUSED no motion command is accepted; Resume sends RESUME, then the step's absolute target; Resume is refused while HALT/ESTOP/fault is latched; a HALT latched before the RESUME frame is never cleared by it; pause during a travel step and a load step, resume → step completes; VALID never 1 during the pause. | T | M4 | Must |

#### SW-ACQ — stream, recording, momentary sample (PO-SW-7)
| ID | Requirement | Source | Acceptance criterion | V | MS | Pri |
|---|---|---|---|---|---|---|
| SW-ACQ-001 | Stream start/stop buttons shall be available on the toolbar from every tab, with the stream state shown. | PO-SW-7, PO-FW-8 | GUI test on every tab. | T | M1 | Must |
| SW-ACQ-002 | Record start/stop shall write a new test folder with a CSV of all DATA fields (unwrapped t_us, frame sequence, flags, raw, setpoint distance), derived columns and event rows (tare, VALID changes, stops, steps), plus a JSON metadata sidecar; recording runs during the whole sequence. The recordings folder shall be selectable in the GUI (folder picker; checked writable before use; saved with the session; D-54 c). | PO-SW-7, PO-SW-12, D-23, SWD-P1-06, D-54 (c) | 1 h simulator recording contains every frame exactly once (ground truth = the simulator's sent-frame log of frame_seq / t_us).; GUI test: folder chosen → next recording lands there, unwritable folder refused, choice survives restart. | T | M3 | Must |
| SW-ACQ-003 | "Take sample" shall append mean, std and N of force, travel and raw over a window (default 1 s, 0.1–10 s), with timestamp and marks, to `samples.csv`. | PO-SW-7 | pytest on the statistics; GUI test appends one row. | T | M3 | Must |
| SW-ACQ-004 | Frame-sequence gaps, CRC errors and overruns shall be counted and written into the recording; a recording failure (disk full, write error) shall be reported immediately, stop a running sequence (controlled stop) and never drop rows silently. | R3 §6.7 | Fault-injection tests. | T | M3 | Must |

#### SW-CAL — calibration (PO-SW-8)
| ID | Requirement | Source | Acceptance criterion | V | MS | Pri |
|---|---|---|---|---|---|---|
| SW-CAL-001 | A calibration tab shall start a travel wizard and a load wizard; each step shows its description, input fields, Continue / Repeat / Cancel and a progress bar during capture; STOP stays reachable; Cancel or any stop leaves the active calibration unchanged. **Active travel calibration** = the steps/mm in the board NVM together with `active_travel.json`; values written to the board RAM during the wizard (spm1) are trial values and are saved only when the operator accepts the final result (SW-CAL-004). On Cancel, STOP, HALT, PAUSE-abort, E-stop, driver-power loss, link loss or any other abort before that acceptance, the SW shall restore the previous value (spm0) to the board RAM and verify it by read-back as soon as the board is idle and reachable (after a reconnect at the latest; a board reset restores the NVM value by itself); until verified, an indicator "board steps/mm differs from the active calibration" is shown and recorded in recording metadata. | PO-SW-8.WIZ, GF-05, GRQ-B-17 | GUI test through all pages; cancel at each step keeps the old calibration; simulator: cancel after spm1 written → board = spm0 by read-back; E-stop during the 50 mm move → spm0 restored when idle; link loss after spm1 → indicator until reconnect, then spm0 restored; NVM never written before acceptance. | T | M3 | Must |
| SW-CAL-002 | Travel wizard (no specimen; allowed in the no-specimen mode, SW-LIM-004; **independent of the load calibration, D-54 a**: without a valid load input and outside the no-specimen mode the wizard start asks for the "no specimen mounted" confirmation (SAF-SW-004 dialog rules) and runs in a wizard-scoped no-specimen state — PC load limits off for the wizard's own moves only, FW load limit active at its nominal default thresholds (never widened), banner shown, event recorded, PC load limits restored when the wizard ends, is cancelled or aborted; if the axis is not homed the wizard's first step is HOME in the same scope): take up backlash with +2 mm; step 1 moves 10 mm (N1 = round(10·spm0)), the operator enters the measured distance D1, spm1 = N1/D1 is written to the board RAM (trial value, SW-CAL-001) and verified; step 2 moves 50 mm more (N2 = round(50·spm1), target = re-read commanded position + 50 mm), the operator enters the **total** D_tot, spm2 = (N1 + N2)/D_tot is written; all moves are absolute targets in one direction. | PO-SW-8.TC1, PO-SW-8.TC2, D-23, R4 §5.1, D-54 (a) | pytest R4 TV-TC (N1 = 6400, spm1 = 636.8159…, N2 = 31841, spm2 = 636.0778…); simulator run of the wizard.; no load calibration → wizard start enabled, confirmation required, PC load limits restored after finish / cancel / abort. | T | M3 | Must |
| SW-CAL-003 | Travel plausibility: reject D ≤ 0 or a result outside 100…10 000 steps/mm; the expected value is **800 steps/mm** (4000 pulses/rev, D-27); a change > 20 % is not rejected but requires explicit confirmation that shows the DIP-derived values (800 steps/mm = 4000 pulses/rev target; 160 steps/mm = 800 pulses/rev if the DIP change was not applied) — this large-change confirmation is still offered; a change > 5 % or a value outside ±20 % of the configured expected steps/mm asks for confirmation; warn "repeat" when the incremental value N2/(D_tot − D1) differs from spm1 by > 0.5 %. | R4 §5.1, §5.3, D-27 | pytest for each rule incl. 800 → 160 and 160 → 800 (confirmation, not rejection); 800 → 805 accepted without the > 20 % confirmation. | T | M3 | Must |
| SW-CAL-004 | The accepted steps/mm shall be written to the board, verified by read-back, saved to NVM and stored in a travel calibration file (date, D1, D_tot, N1, N2, results; displayed with 3 decimals). | PO-SW-8.TC2, R4 §5.1 | Simulator: board value, NVM and file agree. | T | M3 | Must |
| SW-CAL-005 | Load wizard (allowed in the no-specimen mode, SW-LIM-004) per the PO sequence: step 1 "remove load" → reference (zero) point; step 2 "put known weight", mass entered → point; step 3 "put bigger known weight", mass entered → point; for each point the stream is on, 2 s pre-settle, then 10 s capture (configurable). | PO-SW-8.PC1–PC3, D-22, SWD-P1-06 | Simulator: three points, each capture with N = round(capture time × measured conversion rate) ± 1 samples (= 800 ± 1 at exactly 80 SPS). | T | M3 | Must |
| SW-CAL-006 | Point acceptance: any saturated sample → invalid; MAD outlier rejection (5·σ_MAD) with > 2 % rejected → invalid; ≥ 95 % of nominal samples; drift ≤ max(2·std, 20 counts); std ≤ max(3·std_zero, 50 counts); masses increasing with m2 ≥ 1.5·m1 (m1 < 2 % FS → warning only, D-22); an invalid point is re-taken. | R4 §6.1–6.2, D-22 | pytest R4 TV-RS; scenario tests for each rejection. | T | M3 | Must |
| SW-CAL-007 | The SW shall fit F = K·raw + B by OLS, show residuals, R² (informative) and NL_span, and classify PASS (≤ 0.1 % span), WARN (≤ 0.5 %, operator may accept) or FAIL (> 0.5 %, K ≈ 0 or non-monotonic → "points are not linear", refused); 2 points → UNVERIFIED_LINEARITY; negative K accepted. **Plausibility (D-50 a), for any number of points:** each weight point whose raw change from the zero point (and from the previous point) is < 10 × std_zero (min 50 counts) is refused ("weight not detected", re-take); when a nominal \|K\| is derivable from the configured cell and AFE, a fitted \|K\| outside 0.5…2 × nominal is shown as "K implausible" and needs an explicit operator confirmation recorded in the calibration file. | PO-SW-8.FIT, D-23, R4 §6.2, D-50 (a) | pytest R4 TV-LC (PASS / WARN / FAIL / 2-point / degenerate); 2-point calibration with no weight hung → refused; \|K\| at 0.3 × / 3 × nominal → confirmation required. | T | M3 | Must |
| SW-CAL-008 | When the largest reference force is < 20 % FS, the calibration shall carry a LOW_SPAN warning, and displayed forces beyond 3× the largest calibration force shall be marked "extrapolated". | D-22, P1 follow-up, R4 Q-R4-07 | Test with 1 kg + 10 kg → LOW_SPAN; force > 294 N marked. | T | M3 | Should |
| SW-CAL-009 | The calibration result shall be saved as JSON (R4 §6.4 schema incl. AFE config, points, fit, status, `push_calibrated = false`) and an active copy loaded by default at start; previous files are kept. An AFE-configuration mismatch (gain/channel or rate) between the calibration and the board shall show "calibration invalid" **and invalidate the calibration for load limits**: the SW load limits and the FW threshold computation have no valid input, so motion is disabled while SW load limits are enabled (SAF-SW-001; no-specimen mode excepted); forces may still be displayed, marked invalid. | PO-SW-8.FILE, D-20, D-29 (l), F-B-22 | Restart → same K/B active; changed gain on the board → warning, motion disabled with load limits enabled, forces marked invalid. | T | M3 | Must |

#### SW-TARE — tare (PO-SW-8)
| ID | Requirement | Source | Acceptance criterion | V | MS | Pri |
|---|---|---|---|---|---|---|
| SW-TARE-001 | A TARE button shall be on the global toolbar, usable from every tab, with non-modal progress and verbatim refusal reasons. | PO-SW-8.TARE-ANY | GUI test on every tab. | T | M3 | Must |
| SW-TARE-002 | Tare shall capture `tare.window_s` (default 10 s, 2–60 s) with the robust statistics of R4 §6.1, set tare_raw = robust mean and apply F = K·(raw − tare_raw); it starts the stream if off and restores its state; a tare event row is recorded; on success the FW thresholds and `safety.zero_raw` are re-sent (SAF-SW-002). The tare is **session-only**: valid for the connected board (UID) while the application runs, never saved to or loaded from a file (recordings carry it as metadata); after an application restart a new tare is required. | PO-SW-8.TARE, R4 §7, D-29 (j), F-B-13 | pytest R4 TV-T `force_n` vectors; simulator: thresholds re-sent after tare; restart → no tare active, motion with load limits refused until a new tare. | T | M3 | Must |
| SW-TARE-003 | Tare shall be refused while moving or < 1 s after a move, with a stop/fault latched, with std/drift beyond the R4 §7 limits, > 2 % outliers or any saturated sample, > 1 % lost frames, or during a sequence capture window; it shall warn when abs(K·(tare_raw − raw_zero_cal)) > 10 % FS. | R4 §7 | One scenario test per refusal/warning. | T | M3 | Must |

#### SW-SEQ — test sequences (PO-SW-12)
| ID | Requirement | Source | Acceptance criterion | V | MS | Pri |
|---|---|---|---|---|---|---|
| SW-SEQ-001 | A sequence tab shall edit a step table with: step type (travel target, load target, hold, home, tare, mark), target (mm or N), speed (mm/s), ramp (accel mm/s², 0 = default), settling time (s), capture duration (s), step time (s, minimum duration; timeout for load steps), load tolerance (N), label; travel targets are relative to the test travel zero by default (`x_zero` frozen at sequence start), machine coordinate selectable per sequence; invalid entries are flagged in the editor. | PO-SW-12, D-29 (k), F-B-20, R4 §8.1 | Model tests incl. both travel references; GUI test of field validation. | T | M4 | Must |
| SW-SEQ-002 | Loops over a step range with a count (1–10 000) or "until stopped", nestable one level, shall be supported; loop iteration counters are recorded and reported. | PO-SW-12 | Expanded-plan tests for nested loops. | T | M4 | Must |
| SW-SEQ-003 | The backend engine shall execute steps as single absolute FW commands with the timeline command → target reached (t_reached: MOVE_DONE, or trim converged for load steps) → settle → capture → hold; settle, capture and the dwell max(step time, settle + capture) are all measured from t_reached; recording runs during the whole sequence. | PO-SW-12, D-29 (k), F-B-20, SWD-P1-06, R4 §8.1 | Simulator: each phase boundary within ±1 frame of plan, relative to the observed t_reached. | T | M4 | Must |
| SW-SEQ-004 | The SW shall set VALID = 1 exactly over the capture windows (via SET_VALID device time) and 0 at window end and on pause/stop/abort; every frame with VALID = 1 lies inside a planned capture window. | PO-SW-12, PO-FW-7, R4 §8.5 | Simulator recording check over a 50-step sequence. | T | M4 | Must |
| SW-SEQ-005 | Sequence start shall be refused unless the axis is homed and enabled, driver power is present (DRV_PWR), no ALM active, not PAUSED, no POS_UNCERTAIN (re-home first), no AFE_RATE_MISMATCH, no latch is active, all targets are within the SW limits, calibration + tare are valid for load steps, FW thresholds are verified and recording can start. | R4 §8, D-28, D-33 (b), SWD-P1-04, SWD-P1-08 | One test per refusal reason. | T | M4 | Must |
| SW-SEQ-006 | Load-target steps (mandatory) shall use approach + trim: approach with MOVE_UNTIL_LOAD (direction from `pull_dir` and the error sign, speed = step speed, raw stop at F_target − sgn·band, band = max(tol, k_est·v·0.065 s)); trim after MOVE_DONE + 100 ms using the mean of the last 4 samples, Δx = 0.5·(F_target − F̄)/k_est, abs(Δx) ≤ 0.2 mm at 0.2 mm/s, ≤ 10 iterations until abs(error) ≤ tol; position frozen during capture; k_est from the approach OLS slope (clamped), fallback user value. The approach bound is the nearer of the FW soft limit and an enabled SW travel limit in the step direction; reaching it without the target load (MOVE_DONE BOUND) marks the step **NOT_REACHED** — not a SW-limit trip — and stops the sequence; trim not converged after 10 iterations likewise marks the step NOT_REACHED and stops the sequence (no continue option). | D-23, D-32 (Q26), D-33 (d), R4 §8.4, F-B-14, SWD-P1-18 | pytest R4 TV-C; simulator specimen k = 50 N/mm, k_est = 40 → within tol in ≤ 10 iterations; MOVE_UNTIL_LOAD bound = soft limit, or the enabled SW travel limit when nearer; specimen too soft for the target → approach ends at the bound, step NOT_REACHED, sequence stopped, no SW-limit trip. | T | M4 | Must |
| SW-SEQ-007 | Guards shall abort the step and stop the sequence on: load moving opposite to the motion by > 5 % of target, load drop > 20 % from its running maximum (BREAK_DETECTED, during load-raising commands incl. a load-step approach, and also at standstill during a hold or capture when the drop happens within 0.5 s — D-49 a; guards arm per D-48), step timeout (travel and load steps incl. trim moves: 1.2 × planned travel time from the start position to the target / approach bound + 10 s, never shorter, SW-SEQ-006; hold steps: 3× planned + 10 s), travel bound (NOT_REACHED for load steps); ALM becoming active during a sequence → the SW sends a controlled STOP and terminates the sequence with reason "driver alarm" (no retry; the FW itself only reports ALM, D-16); controls shall be start, pause, resume (SW-STOP-004), stop (controlled stop, sequence ends) and abort (HALT). | PO-SW-12, R4 §8.4, D-32 (Q26), D-33 (c), (d), D-48, D-49 (a), SWD-P1-14, SWD-P1-18 | Scenario tests per guard and control; load-step timeout vector (130 → 290 mm at 2 mm/s, 100 mm/s² → travel time 80.02 s → timeout 106.0 s); ALM injected mid-sequence → controlled STOP, sequence ended "driver alarm", no retry. | T | M4 | Must |

#### SW-WIZ / SW-SEQF / SW-SCH — generators, files, chart (PO-SW-13…15)
| ID | Requirement | Source | Acceptance criterion | V | MS | Pri |
|---|---|---|---|---|---|---|
| SW-WIZ-001 | Generator wizards shall create: staircase (travel or load; start, end, increment or count; up / up-down; optional return to zero between steps), linear ramp (x0 → x1 at speed, capture during the ramp), cyclic/triangle (min/max travel or load, cycles, speed, dwell), hold/creep-relaxation, and return (travel 0 / home), each with speed, ramp, settle and capture parameters. | PO-SW-13, R4 §8.2 | pytest: generated step lists equal expected lists for each generator. | T | M4 | Must |
| SW-WIZ-002 | Generated steps shall be inserted into the editor (append or replace) and remain editable; the preview updates. | PO-SW-13 | GUI test. | T | M4 | Should |
| SW-SEQF-001 | Sequences shall be saved and recalled as JSON with a schema version (steps, loops, k_est, pull_dir, travel reference); an invalid file gives an error and leaves the current sequence unchanged. **(D-53 b)** The session `pull_dir` (stand configuration) is the single source of truth; the file's `pull_dir` is a declaration checked at sequence start — a mismatch refuses the start with a message naming both values. | PO-SW-14, D-53 (b), SWR-16 | Round trip identical; corrupt file → current sequence unchanged.; sequence pull_dir ≠ session pull_dir → start refused. | T | M4 | Must |
| SW-SCH-001 | A sequence chart (x = travel mm, y = load N/kgf) shall show the planned path of the defined sequence (travel targets known; load targets placed via k_est), with step labels. | PO-SW-15, R4 §8.2 | Test of the path computation; demonstration. | T, D | M4 | Must |
| SW-SCH-002 | During execution the chart shall show a moving line marker of the actual stage (vertical line at the current travel + point at (x, F)), highlight the active step and overlay the measured trace, updated ≥ 10 Hz. | PO-SW-15, SWD-P1-06 | Demonstration; timing test: the backend publish rate and the GUI repaint rate of the marker are each ≥ 10 Hz. | D, T | M4 | Must |

#### SW-REP — report
| ID | Requirement | Source | Acceptance criterion | V | MS | Pri |
|---|---|---|---|---|---|---|
| SW-REP-001 | Each test shall produce raw data CSV + JSON metadata (marks, calibration, tare, limits, sequence, board configuration, SW/FW versions, k_est, events) + an HTML summary (marks, F–x and F–t figures, step result table, warnings incl. LOW_SPAN / tension-calibrated push). | D-23, PO-SW-3 | Simulator run generates the three files; HTML opens in a browser; contents checklist. | T | M4 | Must |
| SW-REP-002 | Steady-state extraction per step and loop iteration shall use only samples with VALID = 1, MOVING = 0, setpoint distance equal to its value at window start, none of the flags excluded by the ICD §7.6 steady-state mask (unchanged, D-33 (b)) and t within [t_reached + settle, + capture]; statistics N, mean, std, min, max, SE(N_eff), drift for raw, F and x; INCOMPLETE if N < 0.8·capture·rate; ON_TARGET for load steps (abs(mean − target) ≤ tol). | PO-SW-12, R4 §8.3 | pytest R4 TV-SS (N = 7, mean = 300 047.142857…). | T | M4 | Must |
| SW-REP-003 | The report shall be reproducible offline from the recording, also with another calibration/tare applied. | R4 §7 | Regenerated report equals the original numbers; re-applied tare changes F as expected. | T | M4 | Should |
| SW-REP-004 | Optional 3-point-bend outputs (off by default): with span L, width b, thickness h → σ = 3FL/(2bh²), ε = 6δh/L², E_f = L³·m/(4bh³). | D-23, R4 §10 | pytest R4 TV-D (60 MPa, 0.006, 5000 MPa). | T | M4 | Should |
| SW-BRU-001 | The SW shall provide a **Bring-up assistant** (Tools menu) that walks the operator through the steps of the delivered bring-up guide (same step ids): per step the instruction, the expected result and a state (not done / pass / fail / skipped with reason). Steps observable from the board (latch, status bit and chip changes, GET_INFO identity, parameter read-back, motion results, HOME_DRIFT) are evaluated automatically; the others take operator entries (confirmation, measured values with unit and limits, remark). | PO 2026-10-14 (operator alone, no agent on the bench PC), D-56 (a) | Simulator walk-through of every step; automatic evaluation per step kind; GUI test of the entry forms. | T, D | P3 | Must |
| SW-BRU-002 | During a bring-up session the SW shall collect, without operator action: every event and status change, GET_INFO, the full parameter set at session start and at every Save to NVM / session end, the NVM state, link statistics, the incident log, the app settings, the calibration files, and a recording of every motion step. The session is saved continuously and resumes after an application or PC restart. | PO 2026-10-14, D-56 (a) | Kill-and-restart test resumes the session with no lost entry; collected-items checklist. | T | P3 | Must |
| SW-BRU-003 | **Create bring-up package** shall write one zip (name: date, board UID, FW build) with an HTML report and a JSON file of all steps, entries and automatic results, the collected data of SW-BRU-002, app / FW / OS versions and a manifest with the SHA-256 of every file; it works offline, takes only files from the app's own data folders, can be created at any point (partial package) and offers *Open folder*. | PO 2026-10-14, D-56 (a) | Package created on the simulator: manifest hashes verify, HTML opens, JSON validates against its schema; no file from outside the data folders. | T | P3 | Must |
| SW-BRU-004 | The assistant shall never bypass a gate or confirmation: it starts motion only from an explicit operator click on a motion step, with the normal gates, confirmations and no-specimen rules (D-53 a, D-54 a); STOP, Pause/Break and the stop banners stay available on top of it. | SAF-SW-004, D-56 (a) | Gate tests through the assistant (refusals identical to the normal GUI); STOP reachable in every assistant view. | T | P3 | Must |

### 4.7 Non-functional (NFR-)

| ID | Requirement | Source | Acceptance criterion | V | MS | Pri |
|---|---|---|---|---|---|---|
| NFR-001 | Plot refresh ≥ 20 fps (p95 frame interval ≤ 50 ms) with all channels of the channel registry (every DATA field, status bit and derived channel) enabled in one time view at 80 Hz, recording on, one time view + one X-Y view, 30 s window, on the reference PC. | R3 §0 (8), §6.2, SWD-P1-06 | Perf test over 10 min on the reference PC (simulator source). | T | M3 | Must |
| NFR-002 | GUI STOP click → STOP frame on the wire ≤ 50 ms (p95, 100 clicks) under the NFR-001 load. | R3 §6.12 | Perf test with wire timestamps (virtual serial / sniffer). | T | M3 | Must |
| NFR-003 | Pause/Break key → HALT frame on the wire ≤ 50 ms (p95); key → last PUL edge ≤ 100 ms (p95) on target. | PO-SW-6, D-14, D-35 (G5), R3 §6.3 | Perf test (simulator); target on-chip measurement (DWT / timer capture of the last PUL edge, or equivalent) against the PC key timestamp, 100 presses. | T, T+H | M3 | Must |
| NFR-004 | Endurance: 1 h at 80 Hz (288 000 frames) with recording and plotting: 0 lost frames attributable to the SW (= receive-queue overflow + recorder rows lost; FW losses are flagged by OVERRUN, link losses are frame_seq gaps without OVERRUN), memory growth ≤ 50 MB after buffers are full; on target over the VCP: 0 sequence gaps and 0 CRC errors. | R3 §6.12, SWD-P1-06 | Soak test with simulator; target soak at the HW gate. | T, T+H | M3 | Must |
| NFR-005 | FW: no dynamic memory allocation after init (no malloc/new in the build, heap unused); stack high-water mark reported in GET_STATUS. | CONV | Map-file inspection (no allocator symbols); twin/target status check. | I, T | M1 | Must |
| NFR-006 | FW main loop: each pass ≤ 1 ms, no blocking > 1 ms; exception: NVM erase/program while idle (≤ 2.5 s); `loop_max_us` reported. | CONV | Target: loop_max_us ≤ 1000 under max load (50 kHz stepping, 80 Hz stream, 20 commands/s) outside NVM operations. | T+H | M2 | Must |
| NFR-007 | FW ISR budgets: step ISR ≤ 2 µs worst case, step-generation CPU load ≤ 15 % at 50 kHz, critical sections that mask NVIC levels 0–2 (E-stop, limit/button inputs, step timer) ≤ 1 µs (other critical sections — AFE, tick, NVM — are reported with their measured length), E-stop/STOP ISR ≤ 1 µs. | R4 §1.8, OBS-P1-04 | DWT cycle-counter measurement on target. | T+H | M2 | Must |
| NFR-008 | FW command response time ≤ 10 ms after the last command byte (SAVE/LOAD/DEFAULTS ≤ 2.5 s); accepted exemption: commands received during an idle NVM SAVE are answered after the flash operation (≤ erase + program time, D-37 (a)). | R3 §1.5 | Twin timing; target sample of 1000 commands. | T, T+H | M1 | Must |
| NFR-009 | Plot refresh ≥ 20 fps (p95 frame interval ≤ 50 ms) shall also be reached with the 600 s window shown on 4 plot windows (all channels, 80 Hz, recording on) on the reference PC; GPU (OpenGL) rendering may be used. | PO 2026-10-10 (OBS-P3-03), D-54 (b) | Perf test TC-NFR-001-03 on the reference PC (simulator source). | T | P3 | Should |

---

## 5. Configuration parameters

### 5.1 FW parameters required in `params.yaml`

Names, ids and types are the Integrator's (`params.yaml` **dict_version 6**; the CR-03 default change of
`drv.pwr_sense_enable` to false lands with ICD v0.7; retired ids 0x0401 = `home.ref_switch`, 0x0603 = `io.stop_active_level`); this table states the required content, ranges and defaults and must match the dictionary.
"Range" is the dictionary range (min…max). **Flags**: **M** = settable while moving (`moving_ok`), **N** =
persisted in NVM (absent = session parameter, `nvm: false`), **R** = reboot required (effective after SAVE +
REBOOT). Counts assume the nominal cell sensitivity (§10 A-02).

| Group | Parameter | Type | Unit | Range | Default | Flags | Source | Req |
|---|---|---|---|---|---|---|---|---|
| afe | `afe.gain_channel` | enum | — | A128, A64, B32 | A128 | N | D-04 | FW-PAR-001 |
| afe | `afe.rate_sps` | enum | SPS | SPS10, SPS80 | SPS80 | N | D-04, D-21 | FW-PAR-001 |
| afe | `afe.rate_tol_pct` | u8 | % | 5…50 | 20 | MN | R2 §4.2 | FW-PAR-001 |
| afe | `afe.settle_discard` | u8 | samples | 0…20 | 4 | MN | R2 §4.1 | FW-PAR-001 |
| afe | `afe.timeout_ms` | u16 | ms | 25…1000 | 250 (H5: ≥ 2 × conversion period) | MN | R4 §4.2, D-33 (a), DEF-P1-01 | FW-PAR-001 |
| motion | `motion.steps_per_mm` | f32 | steps/mm | 100…100 000 | 800 (4000 pulses/rev, D-27) | N | PO-FW-4, D-19, D-27, SD-09 | FW-PAR-002 |
| motion | `motion.pul_invert` | bool | — | false/true | false (pulse = LED current) | NR | D-17, SD-06 | FW-PAR-002 |
| motion | `motion.dir_invert` | bool | — | false/true | false (set at the HW gate so that +x moves away from START; DIP SW5 direction, D-27) | N | D-27, R2 §1.4 | FW-PAR-002 |
| motion | `motion.ena_invert` | bool | — | false/true | false (LED current = disabled) | NR | D-13, R2 §1.5, SD-06 | FW-PAR-002 |
| motion | `motion.pulse_high_ns` | u32 | ns | 2 500…100 000 | 12 500 (25 % margin over the 10 µs driver minimum, D-45 e) | N | D-16, D-45 | FW-PAR-002 |
| motion | `motion.pulse_low_min_ns` | u32 | ns | 2 500…100 000 | 12 500 (D-45 e) | N | D-16, D-45 | FW-PAR-002 |
| motion | `motion.max_step_rate_hz` | u32 | Hz | 100…100 000 | 40 000 (D-45 e; ≥ 24 kHz needed at 30 mm/s × 800 steps/mm) | N | D-16, SD-09, D-45 | FW-PAR-002 |
| motion | `motion.dir_setup_us` | u16 | µs | 5…1000 | 20 | N | D-16 | FW-PAR-002 |
| motion | `motion.ena_settle_ms` | u16 | ms | 0…2000 | 500 | N | D-28, R5 §8 | FW-PAR-002 |
| motion | `motion.v_max_travel_um_s` | u32 | µm/s | 1…250 000 | 30 000 | N | D-19, D-29 (e), R5 §2.3, SD-03 | FW-PAR-003 |
| motion | `motion.v_max_load_um_s` | u32 | µm/s | 1…250 000 | 20 000 | N | D-19, D-29 (e), R5 §2.3, SD-03 | FW-PAR-003 |
| motion | `motion.a_max_um_s2` | u32 | µm/s² | 1 000…10 000 000 | 100 000 | N | R4 §2.1 | FW-PAR-003 |
| motion | `motion.a_stop_um_s2` | u32 | µm/s² | 10 000…10 000 000 | 1 000 000 | N | R4 §4.2 | FW-PAR-003 |
| motion | `motion.v_unhomed_um_s` | u32 | µm/s | 1…20 000 | 2 000 | N | R4 §3.2 | FW-PAR-003 |
| motion | `motion.jog_timeout_ms` | u16 | ms | 50…1000 | 250 | MN | R1 §10.3 (ASSUMED value) | FW-PAR-003 |
| limits | `limits.soft_min_um` | i32 | µm | −10 000…399 999 | 500 | N | R4 §3.2 | FW-PAR-004 |
| limits | `limits.soft_max_um` | i32 | µm | 0…400 000 | 290 000 | N | D-19 (ASSUMED) | FW-PAR-004 |
| home | `home.v_fast_um_s` | u32 | µm/s | 10…20 000 | 5 000 | N | R4 §3.1 | FW-PAR-004 |
| home | `home.v_slow_um_s` | u32 | µm/s | 10…20 000 | 500 | N | R4 §3.1 | FW-PAR-004 |
| home | `home.a_um_s2` | u32 | µm/s² | 1 000…1 000 000 | 50 000 | N | R4 §3.1 | FW-PAR-004 |
| home | `home.backoff_um` | u32 | µm | 0…20 000 | 2 000 | N | R4 §3.1 | FW-PAR-004 |
| home | `home.offset_um` | u32 | µm | 0…20 000 | 1 000 | N | R4 §3.1 | FW-PAR-004 |
| home | `home.max_travel_um` | u32 | µm | 1 000…500 000 | 360 000 | N | R4 §3.1, D-19 | FW-PAR-004 |
| home | `home.max_load_raw` | i32 | counts | 0…7 151 121 | 322 123 (5 % FS) | N | D-15 | FW-PAR-005 |
| home | `home.drift_tol_um` | u32 | µm | 10…10 000 | 200 | N | R5 §8, SD-02 | FW-PAR-004 |
| safety | `safety.load_raw_max` | i32 | counts | −7 151 120…+7 151 121 | +7 022 271 | M (session) | D-12, SD-05 | FW-PAR-005 |
| safety | `safety.load_raw_min` | i32 | counts | −7 151 121…+7 151 120 | −7 022 271 | M (session) | D-12, SD-05 | FW-PAR-005 |
| safety | `safety.load_trip_samples` | u8 | samples | 1…4 | 1 | MN | R4 §4.4 | FW-PAR-005 |
| safety | `safety.load_regrow_raw` | i32 | counts | 0…1 288 490 | 128 849 (2 % FS) | MN | R4 §4.4 | FW-PAR-005 |
| safety | `safety.zero_raw` | i32 | counts | −8 388 608…8 388 607 | 0 (PC writes tare_raw) | M (session) | D-15, R4 §7, SD-05 | FW-PAR-005 |
| safety | `safety.release_band_raw` | i32 | counts | 0…644 245 | 128 849 (2 % FS) | MN | D-15 | FW-PAR-005 |
| safety | `safety.idle_disable_s` | u16 | s | 0…65 535 (0 = never) | 600 | MN | D-15 | FW-PAR-005 |
| safety | `safety.link_timeout_ms` | u16 | ms | 200…5 000 | 1 000 | MN | D-15 | FW-PAR-005 |
| io | `io.release_ms` | u8 | ms | 5…200 | 20 | N | R4 §3.4, SD-04 | FW-PAR-006 |
| io | `io.estop_release_ms` | u16 | ms | 50…2 000 | 100 | N | R4 §4.2, SD-04 | FW-PAR-006 |
| io | `io.pause_active_level` | enum | — | OPEN_ACTIVE, CLOSED_ACTIVE | CLOSED_ACTIVE (NO) | N | D-26, D-28 | FW-PAR-006 |
| drv | `drv.alm_active_level` | enum | — | HIGH_ACTIVE, LOW_ACTIVE | HIGH_ACTIVE (ALM open = alarm) | N | D-16, R2 §1.7 | FW-PAR-006 |
| drv | `drv.pend_active_level` | enum | — | HIGH_ACTIVE, LOW_ACTIVE | HIGH_ACTIVE (PEND high-impedance = in position) | N | D-16, R2 §1.7 | FW-PAR-006 |
| drv | `drv.pend_timeout_ms` | u16 | ms | 0…5 000 (0 = off) | 200 | MN | R5 §3.4, SD-02 | FW-PAR-006 |
| drv | `drv.pwr_sense_enable` | bool | — | false/true | false (optional 48 V presence sense; no contactor, CR-03) | NR | D-28, D-41, R5 §1.5, SD-02, SD-06 | FW-PAR-006 |
| drv | `drv.k1_weld_ms` | u16 | ms | 100…2 000 | 200 | N | D-29 (c), R5 §1.5 | FW-PAR-006 |
| drv | `drv.k1_check_enable` | bool | — | false/true | false (K1_WELDED check only with a power-removal device; needs `drv.pwr_sense_enable`) | NR | D-43 (e), SRS OI-18, SD-17 | FW-PAR-006 |
| stream | `stream.fallback_hz` | u8 | Hz | 1…80 | 10 | MN | R3 §1.6 | FW-PAR-006 |

Hard rules (FW-checked, `E_CONFIG`): H1 `soft_min_um < soft_max_um`; H2 `load_raw_min < load_raw_max`;
H3 `1e9 / max_step_rate_hz ≥ pulse_high_ns + pulse_low_min_ns`; H4 `v_max_load_um_s ≤ v_max_travel_um_s`;
H5 `afe.timeout_ms ≥ 2 ×` the conversion period of `afe.rate_sps` (SPS10: ≥ 200 ms, SPS80: ≥ 25 ms; D-33 (a)).
Every range end is reachable by a single SET in some valid configuration. Speeds are not rule-coupled to
steps/mm: the FW caps the effective speed at `max_step_rate_hz`·1000/steps_per_mm (FW-MOT-009).
**No** polarity parameter exists for the E-stop sense, limit and DRV_PWR inputs (SAF-FW-007); there is no
home-switch parameter (START only, D-29 (b)).

### 5.2 SW settings (session/config files, not in `params.yaml`)

SW travel/load limits and warning levels (SW-LIM), FW load-limit level, tare window (10 s), calibration
pre-settle/capture (2 s / 10 s), momentary-sample window (1 s), `pull_dir` (+1/−1), k_est default, trim
parameters (Kp 0.5, 0.2 mm, 0.2 mm/s, 10 iterations), sequence
travel reference (default test travel zero), display unit (N/kgf), optional 3-point-bend geometry.
Session-only, never saved: tare (SW-TARE-002), no-specimen mode (SW-LIM-004).
GUI defaults accepted by the PO (D-32 Q27, SW_design_GUI GQ-01…20): tab order Connection & Config · Safety limits ·
Test marks · Manual · Calibration & Tare · Sequence · Report; force unit N (kgf selectable); readouts and X axes in
test travel (machine coordinate secondary); Plot 1 docked (time + X-Y), Plot 2 tabbed, at most 4 plot windows;
English; no keyboard jog; non-modal wizards; STOP acts on press, labelled "STOP", no extra in-app STOP key.

## 6. Timing budget summary

| Path | Budget | Req |
|---|---|---|
| E-stop sense edge at MCU pin → last PUL edge | ≤ 100 µs (normative); ENA disabled ≤ 1 ms | SAF-FW-005 |
| E-stop button → ENA opto forced to disabled (hardwired NO contact, independent of the MCU) | immediate (contact + opto, no MCU involvement; verified statically by multimeter) | SYS-006 (D-42) |
| DRV_PWR input change (power lost; optional sense enabled) → pulses ended, ENA disabled, NOT_ENABLED, HOMED cleared | ≤ 25 ms (1 kHz sampling + 20 ms filter); during an idle NVM erase/program: its duration + 25 ms | SAF-FW-024, FW-SW-005 |
| E-stop sense open while DRV_PWR present → K1_WELDED latched | > `drv.k1_weld_ms` and ≤ `drv.k1_weld_ms` + 25 ms (default 200…225 ms) | SAF-FW-025 |
| ENABLE / driver power return → first PUL/DIR edge | ≥ `motion.ena_settle_ms` (default 500 ms) | FW-MOT-008, SAF-FW-024 |
| Limit switch edge → last PUL edge | ≤ 200 µs | SAF-FW-002 |
| HX711 data-ready of deciding sample → last PUL edge (FW load limit) | ≤ 200 µs (= 1 sample + processing; from the physical force crossing ≈ 12.5 ms × trip samples + HX711 filter delay ≈ 65 ms, R4 §4.6) | SAF-FW-002, SAF-FW-008 |
| STOP/HALT command last byte → last PUL edge | ≤ 2 ms (during an idle NVM SAVE: right after the flash operation, D-37 (a)) | SAF-FW-002 |
| Command received during an idle NVM SAVE → response | after the flash operation (≤ erase + program time), accepted exemption | NFR-008, FW-NVM-003 |
| Trigger → start of controlled deceleration (link wdg, PAUSE button / command, dead-man, STOP controlled) | ≤ 2 ms to the deceleration commit (clean halt only if step period > 2 ms **and** stop distance ≤ 1 step) | SAF-FW-003 |
| FW hang while moving → PUL stops | ≤ 100 ms | SAF-FW-019 |
| No HX711 sample while moving → immediate stop (AFE_FAULT) | `afe.timeout_ms` (default 250 ms) + 1 ms | SAF-FW-012 |
| Travel/load-step timeout | 1.2 × planned travel time to the target / approach bound + 10 s (hold steps: 3× planned + 10 s) | SW-SEQ-007 |
| GUI STOP click → STOP frame on the wire | ≤ 50 ms p95 | NFR-002 |
| Pause/Break key → HALT frame / → last PUL edge | ≤ 50 ms / ≤ 100 ms p95 | NFR-003 |
| Violating DATA frame received → SW STOP frame on the wire | ≤ 50 ms p95 | SAF-SW-001 |
| HX711 data-ready → DATA frame transmission start | ≤ 2 ms (+ remaining wire time of a frame already in transmission, ≤ 1.82 ms) | FW-STR-002 |
| Link silence while moving → controlled stop | 1000 ms (+ ≤ 2 ms) | SAF-FW-015 |
| Jog refresh missing → controlled stop | 250 ms (+ ≤ 2 ms) | SAF-FW-016 |

---

## 7. PO request coverage (`Initial_specs.txt`)

The SW list in `Initial_specs.txt` is numbered 1–8, then 12–15: **items SW-9…SW-11 do not exist** (PO confirmed nothing is missing, D-35 G3).
The unnumbered paragraphs under SW item 8 are referenced as PO-SW-8.x below.

| PO item | Content (short) | Requirement IDs |
|---|---|---|
| Intro | Stefan as reference for pinout/board init; STEP/DIR/EN to HBS86H; 86HS2140; Keli DEF 200 kg; HX711 | SYS-001, SYS-005, SYS-007, SYS-011, FW-PLT-001, FW-MOT-001, FW-MOT-008, FW-SW-004 |
| PO-FW-1 | One HX711 AFE, 80 Hz, gain 128; drivers from Thrust_Stand_HAW (read-only) | FW-AFE-001…005, FW-PAR-001, SYS-010 |
| PO-FW-2 | Start/stop (limit) switches and zeroing mechanism | FW-SW-001, SAF-FW-007, SAF-FW-013, SAF-FW-014, FW-HOM-001…004, FW-PAR-004, SW-MAN-006 |
| PO-FW-3 | NC button immediately stops the motor | SYS-006, SAF-FW-005, SAF-FW-006, SAF-FW-007, SAF-FW-024, SAF-FW-025, FW-SW-002, FW-SW-005 (the single red button is the E-stop; no separate physical STOP, D-36) |
| PO-FW-4 | AFE configuration settings; steps-per-mm calibration parameter | FW-AFE-002, FW-MOT-009, FW-PAR-001, FW-PAR-002, FW-CFG-001 |
| PO-FW-5 | Command reading all configurations | FW-CFG-002, FW-CFG-004, IF-012 |
| PO-FW-6 | Command setting each parameter | FW-CFG-003, FW-NVM-001…003, IF-012 |
| PO-FW-7 | Command set/reset data validity flag | FW-CMD-002, FW-STR-003, SAF-FW-001, SW-MAN-006, SW-SEQ-004 |
| PO-FW-8 | Commands start/stop data streaming | FW-STR-001, SW-ACQ-001, IF-012 |
| PO-FW-9 | UART 921600, no flow control, CRC16 on all communication | IF-002, IF-004 |
| PO-FW-10 | Data block starts with separator, binary, contains CRC-16 | IF-003, IF-004, IF-006 |
| PO-FW-11 | Fields: time mark, payload version, flag byte (validity), AFE 32 bit, setpoint distance, CRC-16 | IF-006, FW-STR-003, FW-TIM-001, FW-AFE-005 |
| PO-SW-1 | Board config: read, display, save/recall file, change, write, validate | SW-CFG-001…004, SW-PLT-003 |
| PO-SW-2 | Safety limits for travel and load | SW-LIM-001…004, SAF-SW-001, SAF-SW-002, SAF-FW-008…011 |
| PO-SW-3 | Report marks (element, number) + custom | SW-META-001, SW-META-002, SW-REP-001 |
| PO-SW-4 | Realtime display, per-value on/off incl. calculated, detachable | SW-RT-001…005, NFR-001 |
| PO-SW-5 | Manual tab: slider, travel entry, ±0.1/1/10 mm, immediate stop | SW-MAN-001…006, SW-STOP-001, FW-MOT-004, FW-MOT-005, FW-MOT-007 |
| PO-SW-6 | NC safety knob stops motor; Pause/Break key stops motor/script from anywhere | SYS-006, SAF-FW-005, SW-STOP-002, SW-STOP-003, FW-MOT-007, NFR-003 (+ D-26: SAF-FW-023, FW-SW-003, SW-STOP-004; limitation KL-01) |
| PO-SW-7 | Buttons: stream start/stop, record to file, momentary sample | SW-ACQ-001…004 |
| PO-SW-8 / 8.WIZ | Calibration & tare tab; wizard with step description + Continue | SW-CAL-001 |
| PO-SW-8.TC1 | Travel cal step 1: 10 mm, operator enters measured distance, recompute steps/mm, send to board | SW-CAL-002, SW-CAL-003, SW-CAL-004 |
| PO-SW-8.TC2 | Travel cal step 2: 50 mm more, entry, fine-tune steps/mm | SW-CAL-002, SW-CAL-003, SW-CAL-004 |
| PO-SW-8.PC1 | Pull cal step 1: remove load, reference level | SW-CAL-005, SW-CAL-006, SW-LIM-004 |
| PO-SW-8.PC2 | Pull cal step 2: known weight, entry, 10 s average | SW-CAL-005, SW-CAL-006 |
| PO-SW-8.PC3 | Pull cal step 3: bigger known weight, entry, 10 s average | SW-CAL-005, SW-CAL-006, SW-CAL-008 |
| PO-SW-8.FIT | Linearity check, K and B, used for scaling charts from raw | SW-CAL-007, SW-RT-004 |
| PO-SW-8.FILE | Calibration saved to file, loaded by default | SW-CAL-009 |
| PO-SW-8.TARE | Tare: capture ~10 s, average, offset compensation (pull) | SW-TARE-002, SW-TARE-003, SAF-SW-002 |
| PO-SW-8.TARE-ANY | Tare button available from any tab | SW-TARE-001 |
| PO-SW-9…11 | (not present in `Initial_specs.txt`) | — (OI-08) |
| PO-SW-12 | Steps: time, target travel or load, speed, ramping, settling, capture; whole-time capture, report only steady data; looping; controls | SW-SEQ-001…007 (NOT_REACHED rule, D-32), SW-STOP-004, SW-ACQ-002, SW-REP-002, FW-MOT-006 |
| PO-SW-13 | Wizards generating steps, ramps, other sequences | SW-WIZ-001, SW-WIZ-002 |
| PO-SW-14 | Sequences saved and recalled | SW-SEQF-001 |
| PO-SW-15 | Chart x = travel, y = load; moving line marker of actual stage | SW-SCH-001, SW-SCH-002, SW-RT-003 |
| Process paragraphs | Spec-driven development, roles, folders | `PROCESS.md` (D-01), SYS-007, SYS-010 |

All numbered PO items are covered. Requirements added in v0.3 that implement decisions rather than PO
items: SAF-FW-024…026, FW-HOM-004, FW-SW-005, SYS-011 (D-28, D-29), SW-LIM-004 (D-29 (h)).

## 8. Deferred / out of scope (this release)

| Item | Reason / where it goes |
|---|---|
| Automatic FW reaction to driver ALM (stop, latch DRIVER_FAULT, ENA drop, HOMED cleared) | D-16: release 1 FW reports ALM and blocks new motion only (ALM start-block, SAF-FW-026, D-28); the SW stops a running sequence on ALM (SW-SEQ-007, D-33 (c)); FW reaction planned for a later release (recommended right after the first hardware gate). |
| ALM reset by ENA toggle | Release 1 alarm reset = driver power cycle (48 V supply off/on, D-28, D-41); the ENA-toggle reset is only tested on the bench (SYS-009). |
| MCU trip relay (PB9) | Not applicable since CR-03 (no contactor to open, D-41); PB9 spare. |
| Hardwired power removal / safety relay (R5 Options A/B, IEC 60204-1 stop category 0) | Not fitted (PO decision D-41, CR-03); upgrade path if the residual risk (KL-08) is no longer accepted. |
| Driver current limit as hardware force cap, tighter following-error limit | Evaluated at the HW gate (D-28, Q-R5-08/12); factory values in release 1. |
| Driver following-error limit tightening | Factory value in release 1 (D-28, Q-R5-12); closed loop + 4000 pulses/rev is decided (D-27, SYS-005). |
| Homing at the END switch | D-29 (b): START only in release 1. |
| Separate push (compression) calibration | D-20: one (tension) calibration; push forces reported as "tension-calibrated". |
| Continuous force control / force hold during capture (`trim_during_hold`), FW-side force loop | R4 §8.4, Q-R4-10: approach + trim only. |
| Machine-compliance correction channel (C_m) and data-ready skew correction | R4 §9–10: optional later. |
| Resistor-coded switch loops (short-circuit detection) | R4 §3.5: optional HW upgrade. |
| Independent hardware pulse counter cross-check (TIM3) | R4 §1.4 (d): optional diagnostics. |
| PEND-based settle detection | PEND reported only; NOT_SETTLED is a warning EVENT (D-16, FW-SW-004). |
| HX711 external clock, more AFEs, other link baud rates, Nucleo B1 button | Not requested. |
| PC↔device clock synchronisation beyond event timestamp pairs | Not needed (SET_VALID uses device time, R4 §9). |

### 8.1 Known limitations (release 1)

| ID | Limitation | Mitigation / path of record |
|---|---|---|
| KL-01 | The system-wide Pause/Break hotkey (SW-STOP-002) is **not delivered while an elevated (Administrator) window has focus** (Windows limitation). **Accepted by the PO (D-32 Q28).** | The on-screen STOP and the E-stop always work and are the paths of record; the GUI shows the hotkey state and warns when the application itself runs elevated (GF-03). Stated in the operator notes. |
| KL-02 | Lost steps in the drive chain are reported by the driver only as ALM (closed loop, D-27) and by the FW only at re-homing; with a wrong DIP setting (e.g. open loop left in place) missed steps are silent. | SYS-009 first jog verifies direction/scale and the DIP state; HOME_DRIFT at re-homing (FW-HOM-004); ALM start-block (SAF-FW-026). |
| KL-03 | Horizontal axis without brake: when the motor is de-energised under load (E-stop → ENA disabled, PSU loss) the load may back-drive the table, which may spring back and release the specimen. | Accepted (D-28, D-41); position is lost → re-home (SAF-FW-005, SAF-FW-024); operator notes. |
| KL-04 | CLK_FALLBACK (HSI clock) is not visible in DATA frames. | Reported in GET_STATUS and by EVENT at boot (FW-PLT-002, SD-10); shown by the GUI (SAF-SW-005). |
| KL-05 | The PAUSE button is an NO contact (D-28): a broken PAUSE wire reads "not pressed" and is undetectable. | Accepted by design: the NC E-stop is the path of record; stated in the operator notes (OBS-P1-11). |
| KL-07 | No physical **holding** stop: the only physical stop button is the E-stop, which de-energises the motor (position lost, re-home; spring-back KL-03). Holding stops exist only in software (GUI STOP, Pause/Break key → HALT). | Accepted by the PO (D-35 G4, D-36); PAUSE button for a controlled, holding pause. |
| KL-08 | **No hardwired power removal** (CR-03, D-41): the E-stop is **not an IEC 60204-1 emergency stop**; the driver stays supplied and the stop relies on the ENA input (FW drive + hardwired NO contact). An MCU fault is covered only by the IWDG (≤ 100 ms → reset → boot with the E-stop open drives ENA disabled) and by the hardwired ENA cut. | Residual risk stated to and accepted by the PO (D-41); SYS-006; operator notes; upgrade path §8. |
| KL-09 | The D-42 E-stop **NO contact** (hardwired ENA cut) is **not monitored**: a broken wire or a failed contact is not detected by the MCU. | Checked at the hardware gate and by a periodic manual test with the MCU held in reset (SYS-009, operator notes); the NC sense path (SAF-FW-005) remains active. |
| KL-06 | With the optional power sense enabled, a DRV_PWR loss during an idle NVM erase/program is handled only after the flash operation (≤ its duration + 25 ms). | Axis is idle (NVM operations only while idle, FW-NVM-003); D-33 (f), SAF-FW-024. |

## 9. Open items

| ID | Item | Proposed resolution |
|---|---|---|
| OI-01 | **Calibration span:** weights 1 kg + 10 kg reach only 5 % FS → forces up to 200 kg are extrapolated 20×. | **Closed (D-35 G2):** start with 1 kg + 10 kg, LOW_SPAN warning and "extrapolated" marking accepted (SW-CAL-006/008); a heavier reference may be added later. |
| OI-02 | **Direct-drive assumption** (D-19): the nominal steps/mm assumes the motor coupled 1:1 to the 5 mm screw. | **Closed (v0.4):** carried as assumption A-01; the travel calibration measures the real value and SW-CAL-003 flags a ratio error. |
| OI-03 | **Link loss: D-10 vs D-15.** | **Closed (Orchestrator 2026-10-03):** D-10 reworded — link loss and PAUSE use a controlled stop (D-15, D-26), still holding. |
| OI-04 | **"Motor disabled by default" (CLAUDE.md) vs D-13.** | **Closed (Orchestrator 2026-10-03):** CLAUDE.md now says "motion disabled by default; ENA follows D-13". |
| OI-05 | **3.3 V direct drive (D-17)** below the driver's 5–24 V input rating. | **Closed (v0.4):** bring-up only; the buffer board is required before any calibration (SYS-011, D-28); ENA disable and levels are verified in the SYS-009 check list. |
| OI-06 | **ALM without FW stop reaction (D-16).** | **Closed (v0.4):** release 1 = FW ALM start-block (SAF-FW-026) + SW stops a running sequence on ALM (SW-SEQ-007, D-33 (c)); the FW reaction is a deferred item (§8); lost-step detection see KL-02. |
| OI-07 | **FW load-threshold cap** relies on the nominal 3.0 mV/V sensitivity (A-02). | **Closed (v0.4) as an open item:** SAF-SW-002 clamps inward meanwhile (D-29 (g)); comparing measured counts/kg with 32 212 after the first calibration is a hardware-gate action (OI-ICD-02, dictionary bump if > 2 %). |
| OI-08 | **PO numbering:** `Initial_specs.txt` SW list jumps from item 8 to 12. | **Closed (D-35 G3):** nothing is missing in SW items 9–11; SRS maps the paragraphs under item 8 as PO-SW-8.x. |
| OI-09 | **E-stop circuit and STOP/PAUSE contact types.** | **Closed (D-28):** Option A, STOP NC, PAUSE NO (SYS-006, FW-SW-003). |
| OI-10 | **Setpoint distance semantics** (A-03). | **Closed (v0.4):** commanded position at the sample (A-03, IF-006); the active target is in GET_STATUS. A target field in DATA would be a PAYLOAD_VERSION 2 change request. |
| OI-11 | **921 600 Bd over the ST-LINK/V2-1 VCP** is not officially specified (R2 RK-5). | **Open:** SYS-009 soak test at the hardware gate; fallback: external USB-UART on USART6 (PC6/PC7 — PC7 is free since D-36). |
| OI-12 | **D-22 24 V vs 48 V.** | **Closed (Orchestrator 2026-10-03):** D-22 corrected to 48 V (D-16). |
| OI-13 | **Driver DIP change (D-27).** | **Closed (D-27, PO-approved):** 4000 pulses/rev + closed loop 86-80/86-118 (SW7 off, SW8 on), SW5/SW6 unchanged → nominal 800 steps/mm, `motion.steps_per_mm` default 800 (SYS-005, SW-CAL-003, Table 5.1); applied and verified at the HW gate (SYS-009 first jog). |
| OI-14 | **Load-step trim failure** (F-B-14). | **Closed (D-32 Q26, D-33 (d)):** step NOT_REACHED, sequence stops (SW-SEQ-006/007). |
| OI-15 | **USART6 fallback pin clash (FW_design R-01).** | **Closed (D-36):** the STOP input on PC7 is retired, so USART6 (PC6/PC7) is available for the OI-11 fallback. |
| OI-16 | **ICD/dictionary alignment with SRS v0.3** (`home.ref_switch`, K1 time, ALM start-block scope). | **Closed:** ICD v0.2/v0.3 and dict_version 2 aligned (SD-04, SD-11). |
| OI-18 | **K1_WELDED without a contactor** (CR-03): with no power-removal device, enabling the optional 48 V presence sense would make SAF-FW-025 latch K1_WELDED on every E-stop. | **Open — Integrator / Implementer A:** give the K1_WELDED check its own enable (default off) or retire it in ICD v0.7+; until then `drv.pwr_sense_enable` stays false unless a power-removal device is fitted. **Closed 2026-10-04:** separate `drv.k1_check_enable` (default false) in ICD v0.7 / dict 5 (D-43 (e)). |
| OI-17 | **Reference PC specification** (NFR-001…004, A-10): the PO's lab PC (D-33 (j)). | **Open — PO** to supply the spec (CPU, RAM, GPU, display, Windows build) and an interactive operator session **before the M3 gate** (D-35 G6). |

Closed by v0.4 (not separate rows): OI-ICD-04/05 (D-30), OI-ICD-06 (SAF-FW-024 event wording), OI-ICD-07
(SAF-FW-003 commit-time criterion), DEF-P1-01 (H5, D-33 (a)), DEF-P1-05 (D-33 (e)), DEF-P1-06 (D-33 (f)),
OBS-P1-01…06, -11, -14, SWD-P1-01, -04, -06, -14, -16, -17, -18. Items addressed to other roles (ICD v0.4 RESUME
details OBS-P1-15, twin vocabulary DEF-P1-02/03, design DEF-P1-04/07, GUI alignment SWD-P1-05) are tracked in
their documents.

## 10. Assumptions

| ID | Assumption (ASSUMED) | Source | Used in |
|---|---|---|---|
| A-01 | Motor (SIHONG 86HS2140-06-001, confirmed D-32) directly coupled to the 5 mm lead screw (1:1); with the DIP target of 4000 pulses/rev (D-27) → nominal 800 steps/mm (the travel calibration measures the real value). | D-19, D-27, D-32 | SYS-005, FW-MOT-009, SW-CAL-003, Table 5.1 |
| A-02 | Load cell 3.0 mV/V nominal → 32 212 counts/kg, FS = 6 442 451 counts, zero balance ±1 % FS (±64 425 counts), saturation ≈ 130 % FS; HX711 gain error negligible. | R2 §3, §4.4 | SAF-FW-010, Table 5.1 |
| A-03 | "Setpoint distance" = commanded profile position latched at HX711 data-ready. | R4 §2.3 | IF-006, FW-AFE-005 |
| A-04 | HBS86H ENA (PFDE clone behaves like the Leadshine original): no LED current = enabled, LED current = disabled; after re-enable the driver takes the current position (no jump). | R2 §1.5, D-16 | SAF-FW-018, FW-MOT-008 |
| A-05 | Driver needs ≥ 500 ms after enable / power-up before the first DIR/PUL edge (Leadshine sequence chart; **decided** as default by D-28, ASSUMED only in that the PFDE clone follows the chart). | R5 §8, D-28 | FW-MOT-008, Table 5.1 |
| A-06 | Jog dead-man refresh timeout 250 ms (PC refresh ≤ 100 ms). | R1 §10.3, R4 §2.1 | SAF-FW-016, SW-MAN-004 |
| A-07 | Soft limits 0.5 / 290 mm, home offset 1 mm, back-off 2 mm, max homing travel 360 mm (1.2 × 300 mm stroke); actual end-stop positions unknown. | R4 §3, D-19 | Table 5.1, SYS-004 |
| A-08 | *Withdrawn as an assumption (v0.3):* the PAUSE button is an NO (closed = active) momentary button (D-28); the separate STOP/BREAK button was retired (D-36). | D-28, D-36 | FW-SW-003, SAF-FW-023 |
| A-09 | ALM output configured "conducting = OK" (open/high = alarm, also when unpowered or a wire is broken, fail-safe); PEND active at high impedance (Leadshine defaults; PFDE clone not yet verified). | R2 §1.7, R5 §3.1 | Table 5.1 |
| A-10 | *Decided (D-33 (j)):* reference PC = the PO's Windows 10 lab PC; its specification is supplied by the PO before M3 (OI-17) and recorded in each performance test report. | D-33 (j) | NFR-001…004 |
| A-11 | HSE bypass 8 MHz from the ST-LINK MCO available (factory solder bridges). | R2 §5.1, R1 §9.2 | FW-PLT-002 |
| A-12 | Limit micro-switch repeatability ±5…20 µm. | R4 §3.1 | FW-HOM-003, FW-HOM-004 |
| A-13 | HX711 filter/settling delay ≈ 25–50 ms at 80 SPS → force-crossing-to-stop ≈ 65 ms. | R4 §4.6, R2 §4.1 | §6, SAF-SW-006 |
| A-14 | IWDG can be shortened to ≤ 100 ms during motion and extended only for idle flash operations. | R2 §5.5 | SAF-FW-019 |
| A-15 | SW load-limit defaults ±100 % FS trip / 90 % warning, below the FW 110 % FS level. | R4 §4.4 (layering) | SW-LIM-002 |
| A-16 | Fallback frame rate 10 Hz while the AFE is stale. | R3 §1.6 (a) | FW-STR-005 |
| A-17 | The installed HX711 board runs at 3.3 V with RATE wired to a GPIO (board modified per D-21); noise ≈ +40 % vs 5 V supply accepted. | D-21, R2 §4.3 | FW-AFE-002 |
| A-18 | 921 600 Bd works over the ST-LINK/V2-1 VCP. | R2 §5.2 | IF-002 |
| A-19 | *Withdrawn as an assumption (v0.6):* no contactor K1 is fitted (CR-03, D-41); DRV_PWR filter 20 ms remains a design value (FW-SW-005). | D-41 | — |
| A-21 | With ENA driven to *disabled* (by the FW or the D-42 contact) the driver de-energises the motor within a few ms, and the D-42 5 V feed forces the ENA opto to disabled even while the MCU drives "enabled" (OR-ed circuit) — to be verified at the hardware gate. | D-41, D-42, A-04 | SYS-006, SAF-FW-005 |
| A-20 | With driver power removed the ALM output reads "alarm" (opto LED fed by the drive), so ALM alone cannot distinguish fault from unpowered — hence the start-block applies only with DRV_PWR present. | R5 §1.5 | SAF-FW-026 |

## 11. Requirement count

| Group | Count |
|---|---|
| SYS | 11 |
| SAF-FW | 25 (+ 1 withdrawn: SAF-FW-022) |
| SAF-SW | 6 |
| FW (PLT 2, AFE 5, MOT 9, HOM 4, SW 5, CFG 4, NVM 3, CMD 4, STR 6, TIM 1, PAR 6) | 49 |
| IF | 12 |
| SW (PLT 3, CFG 4, LIM 4, META 2, RT 6, MAN 6, STOP 4, ACQ 4, CAL 9, TARE 3, SEQ 7, WIZ 2, SEQF 1, SCH 2, REP 4, BRU 4) | 65 |
| NFR | 9 |
| **Total** | **177** active (Must 168, Should 9, Could 0) + 1 withdrawn = 178 IDs |

## 12. Change history

| Version | Date | Change |
|---|---|---|
| 0.6.8 | 2026-10-14 | Orchestrator (PO 2026-10-14): **new** SW-BRU-001…004 Bring-up assistant + data package (D-56 a); SYS-011 direct 3.3 V drive qualified by I_LED (low-burden measurement) + pulse-integrity check (10 × 5↔285 mm, re-home |d1| ≤ max(30 µm, 2·max|d0|) over a 3-re-home baseline), buffer board only if that fails (D-56 b). |
| 0.6.7 | 2026-10-10 | Orchestrator (PO answers 2026-10-10): SW-CAL-002 travel wizard independent of the load calibration (wizard-scoped no-specimen state, D-54 a); SW-ACQ-002 recordings-folder picker (D-54 c); **new** NFR-009 600 s × 4 windows ≥ 20 fps, Should (D-54 b). |
| 0.6.6 | 2026-10-09 | Orchestrator: SW-LIM-003 motion needs valid load input or no-specimen mode regardless of limit enables, both-off not restorable (D-53 a, SWR-03); SW-SEQF-001 session pull_dir is the source of truth, mismatch refuses start (D-53 b, SWR-16). |
| 0.6.5 | 2026-10-08 | Orchestrator: SW-CAL-007 load-calibration plausibility (weight-not-detected refusal, K-implausible confirmation; D-50 a, F-B-COV-01); SW-PLT-001 covers the self-contained Windows distribution (D-50 b, F-B-PKG-03). |
| 0.6.4 | 2026-10-05 | Orchestrator: SW-SEQ-007 BREAK_DETECTED also at standstill during hold/capture (drop > 20 % within 0.5 s, PO D-49 a); guard arming per D-48. |
| 0.6.3 | 2026-10-05 | Orchestrator: SAF-FW-015 — link watchdog clears VALID in every motion state; stop and LINK_WDG status stay moving-only (D-47 a, ICD v0.7.4, SD-18). |
| 0.6.2 | 2026-10-05 | Orchestrator: Table 5.1 pulse-timing defaults 12 500 / 12 500 ns, max step rate 40 000 Hz (D-45 e, ICD v0.7.3 dict 6). |
| 0.6.1 | 2026-10-04 | Orchestrator: Table 5.1 row `drv.k1_check_enable` (ICD v0.7, dict_version 5, SRS OI-18 closed by D-43 (e)). |
| 0.6 | 2026-10-04 | **CR-03 (D-41, D-42) and D-43.** **New / withdrawn:** none (A-19 withdrawn as an assumption). **Changed:** §1 scope; §2 E-stop (NC → MCU sense, NO → hardwired ENA cut, no contactor, not IEC 60204-1), DRV_PWR (optional, default off), K1_WELDED (needs a power-removal device), ALM reset = 48 V power cycle; §3.1 E-stop / DRV_PWR / PB9 lines; §3.2 E-stop, driver-power-lost, K1_WELDED and ALM rows; SYS-001, SYS-002 (optional power supervision; "physical PAUSE" only, OI-F-M2-02), **SYS-006 rewritten** (no contactor, D-42 hardwired ENA cut, residual risk: not an IEC 60204-1 E-stop, MCU fault covered by IWDG + D-42), SYS-007, SYS-008, SYS-009 (E-stop/ENA-cut check with multimeter; DIAG_MEAS primary evidence, SWD fallback); SAF-FW-005 (externally forced ENA tolerated, no fault), SAF-FW-006, SAF-FW-007 (`drv.pwr_sense_enable` default false), SAF-FW-020 + FW-MOT-005 (un-homed travel window from a fixed origin, D-43 (b)), SAF-FW-024/025 conditional on the optional sense (K1_WELDED also on a power-removal device, OI-18), SAF-FW-026 alarm reset; FW-SW-005; SAF-SW-004, SW-STOP-003; SW-RT-006 acceptance D-63 rules (1)–(5) (OI-F-M2-01); Table 5.1 `drv.pwr_sense_enable` default false; §6 E-stop hardware row (ENA cut), DRV_PWR row; §8 trip relay n/a, power removal / safety relay as upgrade path; §8.1 KL-03/06/07 reworded, **KL-08** (no hardwired power removal) and **KL-09** (D-42 NO contact not monitored) added; §9 OI-18 added; §10 A-19 withdrawn, A-21 added. |
| 0.5.2 | 2026-10-04 | Orchestrator: SAF-FW-014 LIMIT_WIRING clear rule aligned to the ICD (D-40 a); FW-MOT-003 total tolerance ±ceil(N/1000) and motion_vectors.json (D-40 b). |
| 0.5.1 | 2026-10-04 | Orchestrator: new SW-RT-006 plot-pane grid / add / reorder / move / quantity grouping (PO request after running M1 SW, D-38; inherited from Thrust_Stand SW-RT-004, D-62, D-63). |
| 0.5 | 2026-10-04 | CR-01 / D-34…D-37. **Withdrawn:** SAF-FW-022 (physical STOP/BREAK → HALT; one red button = E-stop, D-36). **New:** none. **Changed (D-36, CR-01):** §2 E-stop (single red button, operator panel), HALT (PC HALT only), PAUSE (operator panel); §3.1 operator panel, PC7 free; §3.2 STOP-button row removed; SYS-001, SYS-007 (pin map: STOP input PC7 retired), SYS-009; SAF-FW-002 (no STOP-button source), SAF-FW-023 / SW-STOP-004 (HALT-before-RESUME wording); SAF-SW-005 (HALT has no source); FW-SW-003 (PAUSE button only); FW-STR-003/006, FW-PAR-006, FW-CMD-004; SW-STOP-003 (HALT sources = GUI STOP / Pause/Break); Table 5.1 `io.stop_active_level` removed; §6 STOP-button row removed; §7 PO-FW-3 = E-stop only; §8.1 KL-01/KL-05 reworded, KL-07 added (no physical holding stop); A-08; OI-15 closed (R-01 resolved, PC7 free), OI-11 fallback on USART6. **D-37:** (a) NVM SAVE exemption in SAF-FW-002, FW-NVM-003, NFR-008, §6 + SW quiesce rule in SW-CFG-004; (b) feature-bit validity in FW-STR-003 and SAF-SW-005; (c) IF-011 priority path = STOP/HALT/PAUSE + clears, RESUME on the control lane; (d) STOP/HALT confirmation ordered by FW device time in SW-STOP-001/002. **D-34:** IF-005 source/acceptance (text already in v0.4.1). **D-35:** G5 no oscilloscope/logic analyser → +H acceptance criteria rephrased to on-chip measurement (DWT / timer capture with PUL/DIR/DOUT loopback) or equivalent, numbers unchanged: SYS-009, SAF-FW-002/004/005/019, FW-PLT-002, FW-AFE-001/004, FW-MOT-001, FW-TIM-001, NFR-003; G2 → OI-01 closed; G3 → OI-08 closed; G6 → OI-17. |
| 0.4.1 | 2026-10-03 | Orchestrator: IF-005 — RESUME and the clear commands are never auto-retried (D-31, D-34; ICD v0.4.1); SW-SEQ-007 / §6 — one timeout rule for travel and load steps incl. trim moves (F-B-34), hold steps unchanged. |
| 0.4 | 2026-10-03 | P1 validator reviews and D-30…D-33; Table 5.1 aligned to `params.yaml` dict_version 3. **New:** none. **Withdrawn:** none. **Changed:** §2 PAUSE (blocking latch, cleared only by RESUME / HALT_CLEAR) + new term RESUME (D-30, D-31); §3.2 PAUSE row, limit-latch clear (D-33 (h)), driver-power NVM bound and K1 upper bound (D-33 (f)), idle disable not while stale (D-33 (g)), clean-halt footnote (D-30); SYS-001/005 motor SIHONG 86HS2140-06-001 (D-32 Q25) and **D-27 closed**: DIP target 4000 pulses/rev + closed loop (SW7 off / SW8 on), SW5/SW6 unchanged → 800 steps/mm (SYS-005, FW-MOT-009 default 800, SW-CAL-003 expected 800 with 160 as the not-applied case, Table 5.1, §3.1, OI-13 closed, A-01, KL-02, SAF-FW-026, FW-HOM-004 notes); SYS-009 first motion = short slow jog verifying direction and scale before calibration; SYS-002 "PC silent" acceptance (OBS-P1-14); SAF-FW-003 clean halt only if step period > 2 ms **and** stop distance ≤ 1 step, commit-time criterion (D-30, OBS-P1-01, OI-ICD-07); SAF-FW-012 stale timeout 250 ms + hard rule H5 (D-33 (a), DEF-P1-01); SAF-FW-013 latch clear on release time (D-33 (h)); SAF-FW-017 no idle disable while stale (D-33 (g)); SAF-FW-018 target test with ≥ 98 N tension (D-33 (e), DEF-P1-05); SAF-FW-020 PAUSED refusal (D-30); SAF-FW-023 PAUSED blocks motion starts incl. jog refreshes, cleared only by RESUME or HALT_CLEAR (D-30, D-31, SD-13); SAF-FW-024 event rules (OI-ICD-06, SD-11) and NVM bound (D-33 (f), DEF-P1-06); SAF-FW-025 upper bound k1_weld_ms + 25 ms (D-33 (f), OBS-P1-02); SAF-FW-026 RESUME not blocked; SAF-SW-001 position at a travel limit is not a violation (D-33 (d)); SAF-SW-005 carrier definition (SWD-P1-06); FW-MOT-007, FW-CMD-003/004 (pause source, SD-11), FW-STR-006, FW-PAR-001 (RESUME, H5); IF-005 PAUSED refusal expected (D-33 (k)); IF-011/012 RESUME (D-31); SW-PLT-001 Python 3.14 (D-33 (i)); SW-STOP-001 STOP on press (D-32 Q27); SW-STOP-002 KL-01 accepted (D-32 Q28); SW-STOP-003 HALT_CLEAR also clears PAUSED; SW-STOP-004 Pause/RESUME flow and acceptance per SWD-P1-01 (D-30, D-31, D-33 (k)); SW-CAL-005, SW-ACQ-002, SW-SCH-002, SW-SEQ-003, NFR-001, NFR-004 acceptance wording per SWD-P1-06; SW-SEQ-005 start refusals POS_UNCERTAIN, AFE_RATE_MISMATCH, PAUSED (D-33 (b)); SW-SEQ-006 approach bound, NOT_REACHED, trim failure stops the sequence (D-32 Q26, D-33 (d)); SW-SEQ-007 load-step timeout and ALM → controlled STOP (D-33 (c), (d)); SW-SEQF-001; SW-REP-002 ICD §7.6 mask reference (D-33 (b)); NFR-007 masked-window wording (OBS-P1-04). Sections: §5.1 `afe.timeout_ms` 25…1000 / 250 + H5; §5.2 GUI defaults (D-32 Q27); §6 new rows (AFE stale, load-step timeout), DRV_PWR / K1 / controlled-stop rows; §8 ALM row; §8.1 KL-01 accepted, KL-05/06 added; §9 OI-02/05/06/07/10/13/14/16 closed, OI-17 added (reference PC spec); §10 A-01, A-10. |
| 0.3 | 2026-10-03 | P1 reconciliation (D-27, D-28, D-29, ICD v0.1 §14 SD-01…SD-10, FW/SW/GUI design findings); Table 5.1 aligned to `params.yaml` dict_version 2. **New (7):** SYS-011 buffer board before calibration (D-28); SAF-FW-024 driver-power loss → stop, NOT_ENABLED, HOMED cleared, motion refused (D-29 (c), SD-02); SAF-FW-025 K1_WELDED (D-29 (c)); SAF-FW-026 ALM start-block (D-28); FW-HOM-004 HOME_DRIFT (R5 §8, SD-02); FW-SW-005 DRV_PWR input (D-28); SW-LIM-004 no-specimen mode (D-29 (h)). **Changed:** SYS-001/002/007/008/009 (Option A E-stop, K1, DRV_PWR, pin map, PSU, check list, D-28); SYS-004 speed split 30/20 mm/s, ≥ 10 mm/s still required (D-29 (e)); SYS-005 DIP rewrite incl. SW6 and SW7/SW8 open loop, setup sheet with all 8 switches (D-27); SYS-006 Option A + horizontal axis (D-28); SYS-010 Thrust_Stand copies record their commit (D-29 (m)); SAF-FW-003 clean halt at step period > 2 ms (D-29 (d)); SAF-FW-006/007 driver power, DRV_PWR fixed polarity; SAF-FW-010 session thresholds (SD-05); SAF-FW-017 zero_raw session; SAF-FW-020 speed caps, DRV_UNPOWERED, DRIVER_ALARM, JOG bound; SAF-FW-023 PAUSE command, PAUSED clears on accepted motion / HALT_CLEAR (D-29 (a), SD-01); SAF-SW-001 AFE mismatch + no-specimen mode; SAF-SW-002 clamp inward with warning (D-29 (g)), session params; SAF-SW-004/005 new confirmations/indicators; FW-PLT-002 + FW-STR-003 CLK_FALLBACK only in GET_STATUS/EVENT (SD-10); FW-MOT-001 step-rate cap 100 kHz, reboot-required polarities (SD-06, SD-09); FW-MOT-005 JOG bound sentinel 0x80000000 (SD-07); FW-MOT-006 bound + `cmp` (SD-07); FW-MOT-007 PAUSE; FW-MOT-008 ENA settle 500 ms, power return (D-28); FW-MOT-009 range 100…100 000, v_max split (SD-03, SD-09); FW-HOM-001 START only (D-29 (b), OI-ICD-01); FW-HOM-002 aborted homing = EVENT (OI-ICD-03); FW-SW-001/002/003 `io.*` renames (SD-04), STOP NC / PAUSE NO decided; FW-SW-004 NOT_SETTLED + start-block; FW-CFG-001/003, FW-NVM-002 session and reboot-required flags (SD-05, SD-06); FW-CMD-003/004 new faults and status; FW-STR-002 frame-in-transmission allowance (OI-FW-02); FW-STR-006 new events; FW-PAR-002…006; IF-005 motion never auto-retried (SD-08); IF-011/012 PAUSE (SD-01); SW-CFG-003 session/reboot params; SW-MAN-002/003 latest-wins (D-29 (i)); SW-STOP-001 native dialogs disabled (GF-02); SW-STOP-002 KL-01 elevated windows (GF-03); SW-STOP-003 driver-power loss; SW-STOP-004 GUI Pause = PAUSE command (D-29 (a)); SW-CAL-001 active travel calibration + restore on abort (GF-05); SW-CAL-002/005 allowed in no-specimen mode; SW-CAL-003 DIP values 160/800; SW-CAL-009 AFE mismatch invalidates for load limits (D-29 (l)); SW-TARE-002 session-only (D-29 (j)); SW-SEQ-001/003 test-zero targets, dwell from t_reached (D-29 (k)); SW-SEQ-005 driver power/ALM; SW-SEQ-006 trim-failure default stop (OI-14); SW-SEQF-001. **Withdrawn:** none (A-08 withdrawn as an assumption). Sections: §2 new terms; §3.1 context; §3.2 rows PAUSE command, driver power lost, K1_WELDED, ALM start-block, HOME_DRIFT; §5.1 rebuilt from `params.yaml` (48 parameters, flags M/N/R, H4); §6 new budgets; §8 deferred items + §8.1 known limitations KL-01…04; §9 OI-09 closed, OI-05/06/11/13 rewritten, OI-14…16 added; §10 A-01/04/05/08/09 updated, A-19/20 added. D-29 (n) (file ownership) has no SRS impact. Orchestrator review: SW-LIM-004 keeps the calibrated FW thresholds in no-specimen mode when a valid calibration + tare exist (nominal defaults only without them). |
| 0.2 | 2026-10-03 | Orchestrator review: SW-STOP-002 HALT retry ends on ACK (works with stream off); SW-STOP-003 FW-reported HALT/ESTOP from any source terminates the sequence; OI-03/04/12 closed. |
| 0.1 | 2026-10-03 | Initial draft for PO review: requirements from Initial_specs, D-01…D-27 (D-16 amended to 48 V DC; D-17 common-cathode; D-19 5 mm lead confirmed; D-26 physical STOP/BREAK + PAUSE buttons; D-27 DIP 800 pulses/rev → default 160 steps/mm, open), R1–R4. |
