HawortiaCooper/Bird.Bend_Stend/03_SW/docs/SW_design.md

# Bird Bend Stand — PC Software Design (SW_design)

| Item | Value |
|---|---|
| Version | **0.6.13 — bring-up review fixes** (SWD-P3-03…09, OBS-F-BRU-01/02; §25). **0.6.12 — D-56 a Bring-up assistant backend** (`core.bringup`, §25; SW-BRU-001…004, SYS-011 pulse-integrity check). **0.6.9 — D-54** (travel calibration without load calibration, recordings folder at runtime; §9.3, §15.5f B6-35). **0.6.8 — review residuals SWR-29…36** (D-53 a no-specimen exit, §15.5f B6-34). **0.6.7 — P3 perf findings** (SWD-P3-01 recorder, OBS-P3-01 / 04, liveness filter, diagnostic log sizes). **0.6.6 — SW review fixes** (SW_code_review v1.1 SWR-01…28 except the packaging items, D-53, §15.5f B6-33, §22c). **0.6.5 — review fixes SWR-11/14/23/24/27** (§14 log file, §24 locks; B packaging share). **0.6.4 — load-calibration plausibility** (D-50 a, §9.4, §15.5f B6-32). **0.6.2 — coverage + M4 notes + manual items** (§22c post-gate revision, §15.5f B6-24…B6-31, §12.4 `inject step_stall`). **0.6.1 — Windows distribution** (§24, PyInstaller build for the lab PC). **0.6 — M4 (Sequencer) backend** (§22c work breakdown + as built, §15.5f API delta B6-01…B6-23 for D). **0.5.1 — M3 gate fix (SWD-M3-01, MC3-4)**. **0.5 — M3 (SW application) backend** (§22b work breakdown, §15.5e API delta B5-01…17 for D). **0.4.1 — M2 close-out** (SWD-M2-01…03, MC2-4, D-41…D-43; §22a). **0.4 — M2 (Sensor & motion) backend + M1 close-out** (ICD v0.5 / v0.6 decode, SRS v0.5.1, D-36…D-39; §22a, §15.5d). Earlier: **0.3.1 — DRAFT for the P1 gate** (aligned to **ICD v0.4 / v0.4.1** (D-34), SRS v0.3, D-29…D-34, SW_test_plan SWD-P1-01…18 / C1–C7; v0.2 answered GRQ-B-01…18) |
| Date | 2026-10-03 |
| Owner | Implementer B (SW backend): overall architecture + backend (`core`, `io`, `calc`), package root (`bend_stand/__init__.py`, `__main__.py`), launch scripts `03_SW/run*.bat`, `03_SW/tests/conftest.py` (D-29 n). GUI design: `03_SW/docs/SW_design_GUI.md` (Implementer D), which consumes §15 of this document. |
| Binding inputs | `00_System/specs/SRS.md` **v0.3** (SAF-SW-, SW-, IF-, NFR-001..004, §3.2, §5.2; new SW-LIM-004; the v0.4 draft was cross-checked — same 82 SW-side IDs, traceability §20 unchanged), `DECISIONS.md` D-01…D-33, **`ICD_protocol.md` v0.4** (final P1 draft; PROTO 1.0, PAYLOAD 1; STATUS 86 B with `pause_src`; PAUSED latch with BLOCK bit PAUSED (D-30); RESUME 0x3C VERIFY class (D-31); hard rule H5 (D-33 a); homing at START only; `state_schema` 2; frozen sim/twin vocabulary v2 in tools/README; `units_vectors.json`) and its **v0.4.1** delta (D-34: HALT_CLEAR / ESTOP_CLEAR / FAULT_CLEAR become VERIFY class on the priority path), `03_SW/docs/SW_test_plan.md` (Validator F, verdict YES WITH CONDITIONS; SWD-P1-01…18), `protocol.yaml` + generated `core/protocol_gen.py` (names/codes), `params.yaml` **dict_version 3** (PARAM_DICT_HASH **0xF0376293**; since dict 2: `home.ref_switch` 0x0401 retired, `drv.k1_weld_ms` 0x0705 added; dict 3: `motion.steps_per_mm` default 800 (D-27 closed), `afe.timeout_ms` default 250 + H5 (D-33 a)) + generated `core/params_gen.py`, `00_System/tools/{ref_codec.py, ref_cmdcheck.py, README.md, vectors/}` (check vectors ICD v0.4: 509, `state_schema` 2; `units_vectors.json`), R3 (§1.6–1.7, §5, §6, §7), R4 (§2, §4–§12), R5 (§0, §5.5, §8), `SW_design_GUI.md` v0.1 §11.2 (GRQ-B-01…18), §14 (GF-04/05/07/10) |
| Orchestrator / PO decisions after D-29 | **D-30**: PAUSED is a motion-blocking FW latch (BLOCK PAUSED); controlled-stop clean halt only when step period > 2 ms **and** stop distance ≤ 1 step. **D-31**: dedicated **RESUME 0x3C** clears only PAUSED and is refused while HALT/ESTOP/fault is latched; HALT_CLEAR clears HALT and PAUSED; Resume = RESUME, then re-issue. **D-32** (PO Q26): a load step that does not reach its load travels to the end of travel, ends NOT_REACHED and stops the sequence. **D-33**: (b) sequence start refused on POS_UNCERTAIN, AFE_RATE_MISMATCH, PAUSED, ALM, DRV_PWR off; (c) ALM during a sequence → controlled STOP + sequence ends; (d) load-step bound = nearer of soft limit and enabled SW travel limit, timeout 1.2 × travel time + 10 s; (i) runtime Python 3.14; (k) BLOCK PAUSED refusal is an expected outcome. **D-27 closed** (PO): 4000 p/rev closed loop → nominal 800 steps/mm (params default 800 from ICD v0.4). No-specimen mode keeps the calibrated SAF-SW-002 thresholds when a valid calibration + tare exist; only without them the FW thresholds stay at the nominal defaults (SW-LIM-004, §6.7). |
| Reference | `E:\Bavovna\Drone\Thrust_Stand_HAW` (read-only, D-02): copies are taken from its **current HEAD** with the commit hash recorded in every origin note (D-29 m; design citations "TS-SWD §x" were checked at 9473c68) |
| Status of code | **M2 backend implemented (WP-B12a/b, WP-B13, WP-B14, §22a)**: MotionController, motion gates, simulator motion = ICD v0.5 FW behaviour (exact ramps = `motion_vectors.json`), threshold manager (default / manual raw / calibrated path), Pause/Break key; M1 close-out MC-4, D-37 a/b/d, CR-01. Earlier: **M1 backend implemented (P2, WP-B0…WP-B11; WP-B12 partly: simulator motion simplified)** — as-built deviations in §23 v0.3.2. The M1 work breakdown is §22. |

Conventions: requirement IDs in **bold** where a design element implements them; code will carry
`# Implements: <ID>` tags. "B" = backend (this document), "D" = GUI (`SW_design_GUI.md`). Units in the
backend API are SW units (mm, mm/s, mm/s², N, s); wire units (µm, µm/s, µm/s², µs, raw counts) exist only
inside `io.protocol` and `core.device` (SYS-003).

---

## 0. Key design decisions (summary)

| # | Decision | Why / requirement |
|---|---|---|
| KD-01 | Strict layering `calc` ← `io` ← `core` ← `gui`; `core`, `io`, `calc` never import PySide6/shiboken6/pyqtgraph (AST + subprocess import test). | SW-PLT-002, CONV |
| KD-02 | Seven backend threads with single responsibilities: Reader, Pipeline, Supervisor, Worker, Operation runner, Recorder, Hotkey (§3). Only the Pipeline writes data structures; only the writer lock serialises the port. | NFR-001/002/004, R3 §5.4 |
| KD-03 | **Priority TX path**: STOP, HALT, **PAUSE**, HALT_CLEAR, ESTOP_CLEAR, FAULT_CLEAR are written directly under the frame-writer lock, bypassing lanes, queues, token bucket and outstanding-command limits; the lock is held for one frame at a time (largest frame 168 B ≈ 1.8 ms, ICD §2). | IF-011, NFR-002/003, SW-STOP-001/002, ICD §2.4 |
| KD-04 | **Motion epoch**: every STOP/HALT/PAUSE sent and every stop indication from the FW increments an epoch; queued or pending motion commands of an older epoch are dropped. Motion commands are **never auto-retried** (ICD §9.3 VERIFY class, SD-08); their outcome after a timeout is resolved by GET_STATUS (`motion_state`, `target_um`, latches). Only idempotent commands are retried (new SEQ, newest payload). | IF-005, ICD §9.3, R3 §1.7 P4/P11 |
| KD-05 | SW limits are evaluated **in the Pipeline thread on every DATA frame**; a trip writes STOP before anything is published ("act first, publish after"). | SAF-SW-001, R3 §5.4 SWD-M1-04 |
| KD-06 | Motion commands are allowed only while the stream runs and is fresh, the FW load thresholds are verified for the active calibration + tare, and every enabled SW limit has a valid input (pure gate functions, §5.6). **No-specimen mode** (D-29 h) is the only way to move with SW load limits off: explicit confirmation, session-only, banner, FW load limit at its nominal default (§6.7). | SAF-SW-001/002, SW-SEQ-005, D-29 h |
| KD-07 | **Absolute targets only** on the wire; the `MotionController` keeps the *commanded target* accumulator (±0.1/1/10 mm add to it) and a **latest-wins** pending target while the FW is busy (D-29 i). | SW-MAN-001..003, IF-009, D-23, D-29 i |
| KD-08 | Calibration, tare and sequencer are **Qt-free state machines** with an immutable state snapshot + events; the GUI wizards only render the snapshot and call engine methods. | SW-CAL-001, SW-TARE-001, PO-SW-8.WIZ |
| KD-09 | **Device time** (unwrapped `t_us`) is the only time base for settle/capture windows, VALID boundaries, steady-state extraction and derived rates; host time is used only for timeouts, UI and link supervision. | R4 §8.5, §9, SW-SEQ-003/004 |
| KD-10 | Recordings keep raw counts, K, tare_raw and every event, so forces and the report can be recomputed offline with another calibration/tare. | SW-REP-003, R4 §7 |
| KD-11 | Minimal runtime dependencies: PySide6-Essentials, pyqtgraph, numpy, pyserial (+ stdlib). No jsonschema/Jinja2/matplotlib/platformdirs: hand-written schema validators, HTML report with inline SVG figures, `%APPDATA%` paths via `os.environ`. | SW-PLT-001 |
| KD-12 | In-process simulator (`io.sim`) uses the **same** codec and the generated parameter dictionary; its command acceptance replays **every** `check_vectors.json` vector (differential check against the Integrator's oracle `ref_cmdcheck`, §12.5) and its behaviour is compared with the FW host twin over `tcp://`. | SYS-008, D-07, ICD §12 |
| KD-13 | Tare is **session-only** (valid for the connected board UID while the application runs, never loaded from a file, D-29 j); calibrations are persisted with an active copy loaded at start. | SW-TARE-002, SW-CAL-009, D-29 j |
| KD-14 | Heartbeat PING after **150 ms** of TX idle (ICD §9.2: 150–200 ms, gap ≤ 250 ms), gated by Reader/Pipeline liveness, so a hung backend lets the FW link watchdog trip. | SAF-SW-003, ICD §9.2, R3 §5.4 SWD-M1-03 |
| KD-15 | **Pause = FW PAUSE command** (0x3B, D-29 a): GUI Pause and the physical PAUSE button produce the same FW state (PAUSED latch, controlled stop, VALID cleared); the sequencer reacts to the FW indication, not to the button that caused it. **PAUSED blocks every new motion start in the FW (D-30)**; it is cleared by **RESUME 0x3C** (only PAUSED; refused while HALT/ESTOP/fault is latched, D-31) or by HALT_CLEAR (clears HALT and PAUSED). Resume = RESUME, then re-issue the interrupted step's motion — always a PC action. | SW-STOP-004, D-14, D-26, D-29 a, D-30, D-31, ICD §5.5 |
| KD-16 | **Active travel calibration** = `active_travel.json` steps/mm = board NVM value. A wizard writes trial values to board RAM only; every exit other than ACCEPT restores the previous value as soon as the board is reachable and idle, and a persisted *restore-pending* record survives link loss and application crashes (§9.3.1, GF-05). | SW-CAL-001/004, GRQ-B-17 |

---

## 1. Technology stack and packaging

- **Supported runtime: Python 3.14** (D-33 i; the application ships with its own venv, no separate 3.11 test). `requires-python = ">=3.11"` stays as the declared floor of SW-PLT-001, but only 3.14 is verified. Type hints everywhere, `from __future__ import annotations`.
- **Requirements files** (owner B, D-31 / F-B-31): `03_SW/requirements.txt` (runtime, pinned to the verified versions: PySide6-Essentials 6.11.2, pyqtgraph 0.14.0, numpy 2.5.3, pyserial 3.5) and `03_SW/requirements-dev.txt` (`-r requirements.txt` + pytest 9.1.1, pytest-qt 4.5.0, pytest-cov 7.1.0, pytest-randomly 5.0.0, PyYAML 6.0.3 for the Integrator's generators). Install: `.venv\Scripts\python -m pip install -r 03_SW\requirements-dev.txt`. `pyproject.toml` keeps the same set as ranges; a unit test checks that both files agree. **Hash-pinned locks (v0.6.5, SWR-27):** `requirements.lock.txt`, `requirements-dev.lock.txt`, `requirements-build.lock.txt` — every direct and transitive package with the SHA-256 of the exact wheel for Windows x64 / CPython 3.14, generated by `packaging/lock_requirements.py` (pip's own resolution), installed with `pip install --require-hashes -r …` (§24.1); `pyproject.toml` ranges have upper bounds.
- Runtime: `PySide6-Essentials` (GUI only), `pyqtgraph` (GUI only), `numpy` (pipeline, ring buffer, calc), `pyserial` (transport).
- Test: `pytest`, `pytest-qt` (GUI, offscreen), `pytest-cov`, `pytest-randomly` (tests must be order-independent; seed printed and reproducible with `-p randomly -p "randomly_seed=…"`).
- `03_SW/pyproject.toml` (written with this document): package `bend_stand` (src layout), extras `test`, pytest markers `req(*ids)`, `unit`, `component`, `integration`, `validation`, `gui`, `winint` (interactive Windows session: real display/keyboard, hotkey), `rt` (real-time clock, not lockstep), `perf`, `soak`, `hil`, `slow` — `--strict-markers` is on (SWD-P1-16); coverage omits the generated `core/params_gen.py`, `core/protocol_gen.py` and `gui/*` (D measures GUI coverage separately).
- Entry points (`bend_stand/__main__.py`, owner B, D-29 n): `python -m bend_stand [--sim[=scenario.json]] [--port COM7 | --port tcp://127.0.0.1:5760] [--session file] [--headless [--duration s]]` and the script `bend-stand` (`bend_stand.__main__:main`). Without `--headless`, `main()` parses the arguments (the selected endpoint as **`args.endpoint: str | None`** — `"sim"`, `"sim:<scenario.json>"`, `"COM7"` or `"tcp://host:port"`; `None` = start disconnected), builds the `Backend` **without starting it** and returns `bend_stand.gui.app.run(backend, args)` (owner D), which calls `backend.start()` before showing the window, connects to `args.endpoint` if given, and calls `backend.shutdown()` on exit (GF-14); `--headless` connects, streams and prints link statistics (M1 smoke test, no Qt import). **No COM port is ever opened unless the operator selected it** (`--port COMx` or the GUI connect action, D-06); without `--port` the GUI starts disconnected and `--headless` requires `--sim` or `--port`. `python -m bend_stand.io.sim.server --port 5770 [--scenario f]` serves the simulator out of process over TCP (GUI perf runs, GRQ-B-16). Launch scripts: `03_SW/run.bat` (GUI, disconnected), `03_SW/run_sim.bat` (GUI + `--sim`), both via `.venv\Scripts\python`.
- **Windows distribution** (lab PC without Python, DM-02): PyInstaller one-folder build `03_SW/dist/BirdBendStand-<ver>/` (+ zip, optional Inno Setup installer) from `03_SW/packaging/build_dist.ps1`, build pins `03_SW/requirements-build.txt` — §24. Entry-point additions for the installed app (v0.6.3): subcommand `report <recording> […]` (offline report rebuild = `core.report.main`), `--recordings DIR`, `--headless --record` — §24.2.
- Windows timing: `core.timing.init()` calls `winmm.timeBeginPeriod(1)` (paired `timeEndPeriod`) and `sys.setswitchinterval(0.001)` at start-up (TS-SWD §3.1 "Timing primitives").

## 2. Package layout (`03_SW/src/bend_stand/`)

```
bend_stand/
  __init__.py            __version__, PROTO/PAYLOAD versions implemented (owner B, D-29 n)
  __main__.py            argument parsing → gui.app.run(backend, args) or headless (owner B, D-29 n)
  calc/                  (B) pure functions, numpy/stdlib only, no I/O, no threads, no clock — §18
    units.py             G0, n_to_kgf, kgf_to_n, mm↔µm, FS constants (SRS §2)
    paramrules.py        check_hard_rules H1–H4 (ICD §11.4), write_order (pure; used by core.params and io.sim)
    rounding.py          round_half_away(x) (SYS-003)
    motion.py            um_to_steps, steps_to_um, plan_trapezoid, move_duration_s, stop_distance_mm,
                         ramp_periods (reference for simulator / FW vector cross-check)
    stats.py             robust_window_stats (MAD k=5), se_ar1, drift_slope, window_acceptance
    loadcal.py           load_calibration (OLS, NL_span, status), point_acceptance, low_span, fw_raw_limits
    travelcal.py         travel_cal_step1, travel_cal_step2, travel_plausibility
    tare.py              force_n, tare_acceptance, tare_offset_warning
    limits.py            evaluate_force_limit, evaluate_travel_limit, limit_margin_warning (SAF-SW-006)
    timebase.py          unwrap_us, plausible_wraps, frame_gaps (seq u16 + Δt rule)
    derived.py           speed, force_rate, stiffness_ols, stiffness_tangent, stiffness_secant, work_trapz,
                         running_peak, break_detect, rolling_std, sample_rate, bend3p_* (R4 §10)
    steady.py            steady_state (R4 §8.3, SW-REP-002)
    trim.py              approach_band, force_to_raw_stop, k_est_from_approach, trim_step (R4 §8.4)
    path.py              planned_path (SW-SCH-001)
  io/                    (B) bytes, ports, protocol, simulator — no application state
    crc.py               crc16_ccitt_false (ICD §2.1, check 0x29B1)
    framing.py           FrameEncoder, FrameDecoder (ICD §2.3: hunt / LEN > 160 / CRC drop-one / 20 ms timeout)
    protocol.py          payload builders and decoders for both directions (PC requests + FW responses/async,
                         the latter also used by the simulator), INFO/STATUS/PARAM_ENTRY/EVENT codecs, DATA
                         numpy dtype, NACK detail decoding — hand-written from the ICD, vector-tested
    transport.py         Transport ABC, SerialTransport, VirtualTransportPair, TcpTransport, transport_factory
    reader.py            ReaderThread (bytes → frames → dispatch)
    ports.py             list ST-LINK VCPs (VID 0x0483) first; never opens a port
    win_hotkey.py        GlobalHaltHotkey (Pause, Ctrl+Break; RegisterHotKey / WH_KEYBOARD_LL fallback)
    sim/                 in-process FW simulator (§12)
      board.py           SimBoard: protocol endpoint + command dispatch + NVM store
      check.py           pure command acceptance (ICD §4–§6): check(state, cmd, payload) -> (status, detail)
      fw_logic.py        FW state machine: enable, homing, motion, jog dead-man, stops/latches, watchdogs
      server.py          out-of-process simulator over TCP (GRQ-B-16 perf runs)
      models.py          DriverModel, SwitchModel, ButtonModel, Hx711Model, SpecimenModel, LinkModel
      scenario.py        SimScenario (JSON), world-control API, fault injector
      clock.py           RealTimeSimClock, LockstepSimClock
  core/                  (B) application logic, no Qt
    params_gen.py        GENERATED from params.yaml (Integrator) — never edited
    protocol_gen.py      GENERATED from protocol.yaml (Integrator, ICD v0.2 §0.3) — never edited
    params.py            ParamStore, typed values, local range + hard-rule checks, write plan, board-config file
    model.py             frozen dataclasses/enums: DeviceInfo, BoardStatus, StatusFlags, Latches, LinkState,
                         Compat, MoveDone, VerifyItem/VerifyReport, Indicators
    errors.py            exception hierarchy (§14)
    clock.py             Clock protocol (monotonic_ns, wall), FakeClock
    timing.py            timeBeginPeriod, Ticker (absolute deadlines)
    observers.py         ObserverList (weak bound methods), ReleasingFuture, AsyncCall
    events.py            EventBus (topics, bounded history 10 000), EventRecord, SW event codes
    liveness.py          LivenessMonitor (per-thread beats, excepthooks)
    link.py              FrameWriter, CommandChannel, PrioritySender, StopConfirmer, LinkSupervisor
    linkstats.py         PC + FW counters, deltas mod 2³²
    device.py            Device (wire-level API, §5.1)
    motion.py            MotionController (absolute targets, pending target, jog session, x_zero) §5.4
    gates.py             pure gate functions (motion, home, enable/disable, clear, tare, sequence start) §5.6
    operations.py        OperationRegistry: who owns motion; terminate_all(reason) §3.5
    samples.py           SampleBatch (decoded DATA + derived columns), channel keys
    channels.py          ChannelSpec registry, availability + reason (SW-RT-002)
    pipeline.py          SamplePipeline + stages (§7)
    ringbuffer.py        ColumnRingBuffer + min/max pyramid (§7.5)
    dataview.py          DataView: thread-safe snapshot API for plots/readouts (§15)
    safety.py            SafetySupervisor, LimitConfig, ThresholdManager (§6)
    capture.py           CaptureHub (device-time windows over pipeline samples) §9.2
    tare.py              TareEngine §9.5
    calibration/         travel.py (TravelCalEngine), load.py (LoadCalEngine), store.py (CalibrationStore)
    sequencer/           model.py, plan.py, generators.py, executor.py, loadstep.py, seqfile.py (§10)
    recorder.py          Recorder (CSV + JSON sidecar + optional raw frame dump), SampleTaker (§8)
    report.py            WindowAccumulator, ReportBuilder (JSON + HTML/SVG), offline CLI (§11)
    metadata.py          TestMarks, presets I/O (SW-META)
    session.py           SessionSettings (limits, FW level, k_est, pull_dir, trim, windows, units, geometry)
    paths.py             app data dirs (%APPDATA%\BirdBendStand), recordings root
    schema.py            hand-written JSON field specs/validators + atomic write helper (§13)
    api.py               typing.Protocol surface of the Backend for GUI fakes (§15)
    backend.py           Backend facade (§15) — the only object the GUI constructs
    testing.py           test-only fault hooks (recorder failure, thread stall), enabled by BackendSettings
  (03_SW root, owner B)  run.bat, run_sim.bat; tests/conftest.py (fixtures, D-06 port guard, vector loaders)
  gui/                   (D) PySide6 — SW_design_GUI.md
```

Generated modules (Integrator, never edited; both are **leaf modules** importing only the stdlib, so
`io` — codec and simulator — may import them without breaking the layering `calc ← io ← core`; the layering
test whitelists exactly these two `core` modules for `io`):
- `core/params_gen.py` (dict_version **3**, hash **0xF0376293** — ICD v0.4: `motion.steps_per_mm` default 800, `afe.timeout_ms` default 250, H5): `PARAMS`, `BY_ID`, `BY_KEY`,
  `GROUPS`, `PARAM_DICT_HASH`, `PARAM_DICT_VERSION`, `PARAM_COUNT`, `ParamType`, `TYPE_SIZE` and `ParamMeta`
  (`id, key, type, unit, min, max, default, description, enum (code→NAME), group, group_label, label, name,
  moving_ok, nvm, reboot_required, decimals, advanced, enum_labels, srs, flags, size, enum_value(),
  in_range(), pack(), unpack()`) — F-B-19 is satisfied.
- `core/protocol_gen.py` (ICD v0.2 §0.3, from `protocol.yaml`): constants (`MAX_LEN`, `RX_BUF_MIN`,
  `INTERBYTE_TIMEOUT_MS`, `STATUS_LEN = 86`, `JOG_NO_BOUND`, `AFE_NO_DATA`, `RAW_MIN/MAX`, `REBOOT_MAGIC`, …),
  `Cmd`, `CMD_REQ_LEN`, `CMD_RETRY`, `CMD_PRIORITY`, `RetryClass`, `Status`, `BusyDetail`, `NvmDetail`,
  `Block`, `StopMode`, `MulCmp`, `HomeFlags`, `MotionState`, `HomePhase`, `Source`, `ResetCause`,
  `SysFlags`, `Features`, `DataFlags`, `DataStatus`, `Faults`, `IoBits`, `Event` (+ `EVENT_ARG`,
  `EVENT_VALUES`), `StopCause`, `MoveDoneReason`, `HomeFailReason`, `DriverDisabledCause`,
  `PauseClearedReason`, `ParamsDefaultedReason`, `LimitId`, `<ID>_BITS` / `<ID>_NAMES` / `<ID>_DESC`, `TABLES`.
  **No backend module hand-lists a code, bit or name** (ICD §0.3); `Indicators` and the channel registry
  iterate `DATA_FLAGS_BITS`, `DATA_STATUS_BITS`, `FAULTS_BITS`, `SYS_FLAGS_BITS`.
Cross-parameter hard rules **H1–H5** (ICD v0.4 §11.4: H1 `soft_min_um < soft_max_um`, H2 `load_raw_min <
load_raw_max`, H3 `max_step_rate_hz·(pulse_high_ns + pulse_low_min_ns) ≤ 1e9`, H4 `v_max_load_um_s ≤
v_max_travel_um_s`, **H5 `afe.timeout_ms · sps ≥ 2000`** with sps = 10 / 80 from `afe.rate_sps` — SPS10 →
≥ 200 ms, SPS80 → ≥ 25 ms, D-33 a; `E_CONFIG` detail = id of the partner parameter) are implemented once in
the pure `calc.paramrules.check_hard_rules(values) -> list[RuleViolation(rule, key, other_key)]` (used by
`core.params` and the simulator) and tested against every `E_CONFIG` vector of `check_vectors.json`.
`calc.paramrules.write_order(current, target)` follows ICD §11.4: min/max pairs move the outward bound
first; H3 lowers the rate before widening pulses and widens the rate after narrowing pulses; **H5 raises
`afe.timeout_ms` before switching to SPS10 and switches to SPS80 before lowering it**; an `E_CONFIG` item is
retried in a further pass until a pass makes no progress. The SW's AFE stale handling reads
`afe.timeout_ms` (default 250 ms), it never assumes a fixed value.

Parameter names used by the backend (ICD Appendix A, D-29 f / SD-03…SD-06): `motion.steps_per_mm`,
`motion.v_max_travel_um_s` (30 mm/s), `motion.v_max_load_um_s` (20 mm/s), `motion.a_max_um_s2`,
`motion.a_stop_um_s2`, `motion.v_unhomed_um_s`, `motion.max_step_rate_hz` (≤ 100 kHz), `motion.jog_timeout_ms`,
`motion.ena_settle_ms`, `limits.soft_min_um` (max 399 999) / `soft_max_um`, `home.max_load_raw`,
`home.drift_tol_um`, `safety.load_raw_min/max` (±7 151 120 / ±7 151 121 range ends, SD-12),
`safety.zero_raw` (session values, `nvm: false`), `safety.release_band_raw`, `safety.load_regrow_raw`,
`safety.link_timeout_ms`, `io.release_ms`, `io.estop_release_ms`, `drv.pwr_sense_enable`, `drv.k1_weld_ms`
(dict 2, D-29 c), `afe.gain_channel`, `afe.rate_sps`, `stream.fallback_hz`. `home.ref_switch` no longer
exists (dict 2, homing only at START, D-29 b). No backend module uses a parameter key that is not in
`params_gen` (test: string literals of the form `"<group>.<name>"` checked against `BY_KEY`).

---

## 3. Threading model and data flow

### 3.1 Threads

| Thread | Module | Work | Trigger / period | Liveness beat |
|---|---|---|---|---|
| **GUI (main)** | D | Qt event loop; polls snapshots (§15) every 33–50 ms; calls `Backend.stop()`/`halt()` **directly** (non-blocking) and everything else through `*_async` | event-driven | GUI timer tick (`backend.liveness.beat("gui")`) |
| **Reader** | `io.reader` | `transport.read()` (≤ 4096 B, 2 ms timeout, configured once), `FrameDecoder.feed()`; responses → `CommandChannel.on_response()` (resolves futures); DATA/EVENT/LOG → bounded queue (4096) to the Pipeline **in arrival order**. Never writes to the port. | continuous | every loop |
| **Pipeline** | `core.pipeline` | drains the queue (batch closes when the queue is empty or after 8 frames), decodes, unwraps time, detects gaps, scales, derives, annotates, **evaluates safety per sample**, feeds sinks; dispatches FW EVENTs (in order with DATA) | queue-driven, 10 ms idle wake-up | every batch / wake-up |
| **Supervisor** | `core.link.LinkSupervisor` | 5 ms `Ticker`: heartbeat PING, link state, DATA-loss-while-moving reaction, liveness evaluation, `StopConfirmer` repeats (STOP/HALT/PAUSE), jog refresh, GET_STATUS poll (1 Hz while streaming: counters, `sys_flags`, `v_limit_um_s`, `idle_disable_left_s`; 4 Hz while the stream is off: indicator freshness, GRQ-B-02), travel-restore retry (§9.3.1), reconnect trigger | 5 ms | it is the monitor (its death stops the heartbeat → FW watchdog) |
| **Worker** | `core.observers.AsyncCall` executor (1 thread) | executes `*_async` calls (connect, read/write params, SAVE/LOAD/DEFAULTS, threshold write+verify, file I/O for reports) | queue | per job |
| **Operation runner** | `core.operations` (1 thread, started per operation) | runs the active long operation: sequence executor, travel-calibration moves, load-step approach + trim, homing wait; 20 ms `Ticker` + event waits | while an operation runs | every tick (stall > 300 ms while moving → STOP) |
| **Recorder** | `core.recorder` | formats and writes CSV rows / raw dump from its bounded queue, flush 1 s | queue | every write / 250 ms |
| **Hotkey** | `io.win_hotkey` | Win32 message loop; Pause / Ctrl+Break → `Backend.halt("hotkey")` directly | message-driven | answers a 250 ms supervisor ping |

Capture (tare, calibration points, take-sample), the safety supervisor, the window accumulator and the
sequencer's per-sample guards are **pipeline sinks** (they run in the Pipeline thread and never block).

### 3.2 Data flow

```
 port ─► Reader ─frames─┬─► responses ──► CommandChannel (future per (type|0x80, SEQ))
                        └─► DATA / EVENT / LOG (arrival order) ─► queue ─► Pipeline
 Pipeline per batch: decode ─► time unwrap ─► gaps ─► classify ─► scale (K, tare, x_zero) ─► derived
     ─► annotate (operation/step/phase) ─► SAFETY (per sample; may STOP) ─► EVENT dispatch
     ─► sinks: RingBuffer │ Recorder queue │ CaptureHub │ WindowAccumulator │ operation guards │ observers
 GUI timer ─► DataView.snapshot(...) / Backend.status() ─► pyqtgraph / readouts / indicators
 GUI / engines ─► MotionController / Device ─► CommandChannel (lanes) ─► FrameWriter ─► port
 GUI STOP / hotkey / safety / supervisor ─► PrioritySender ─► FrameWriter (lock, next frame slot) ─► port
```

### 3.3 Thread-safety and object-lifetime rules (carried over from TS-SWD §3.1, SWD-PM3-07)

1. The Reader never blocks on anything except the transport and never writes (TS SWD-M1-06).
2. Only the Pipeline writes the ring buffer, the latest-sample record and derived state; readers copy under a short lock.
3. `Device` methods are callable from any thread; frames are serialised by `FrameWriter._lock`.
4. Observers (`EventBus.subscribe`, `SamplePipeline.add_sink`, engine observers) run on backend threads, must return in < 1 ms, must not block or call blocking `Device` methods. Registrations hold bound methods **weakly**; the backend never owns a GUI object (TS rule 1).
5. Futures release callbacks once run (`ReleasingFuture`), `AsyncCall` drops `fn/args` before resolving (TS rule 2).
6. No reference cycles on backend paths; the backend never calls `gc.*` (GUI GC policy is D's, TS-SWD §13.10).
7. Events are published **after** locks are released and **after** the safety action they report (act first, publish after).
8. Integer time (ns host, µs device) for all deadlines, debounce and windows; floats only for display/CSV.

### 3.4 Timing primitives

`core.timing.Ticker(period_ns)` uses absolute deadlines on `time.monotonic_ns()`; overruns skip and are
counted. Start-up measures `sleep(0.001)` granularity (p95 > 3 ms → warning event, value in the recording
sidecar).

### 3.5 Operations and motion ownership

`OperationRegistry` holds at most one **motion-owning operation**: `MANUAL` (default, no runner),
`SEQUENCE`, `TRAVEL_CAL`, `HOMING`; plus non-motion captures (`TARE`, `LOAD_CAL_POINT`, `SAMPLE`) that may run
concurrently only where the SRS allows (tare refused during a sequence capture window, SW-TARE-003).
Motion commands carry an owner token; the gate refuses a command from a non-owner (manual buttons are
disabled while a sequence or wizard owns motion). `terminate_all(reason)` is called by STOP, HALT, safety
trips, FW-reported HALT/ESTOP/stop events, link loss and liveness faults: it swaps every running operation to
`ABORTED`/`TERMINATED` synchronously (atomic state swap, no waiting), so no further command is issued by it;
the runner thread then cleans up (SW-STOP-001/003).

`pause_all(source)` is called on `Backend.pause()` (before the PAUSE frame is written) and on FW EVENT
PAUSED (either source): a running `SEQUENCE` swaps to `PAUSED` (state kept, §10.5); every other
motion-owning operation (`TRAVEL_CAL`, `HOMING`) and the `TARE` / `LOAD_CAL_POINT` captures are terminated
exactly as by STOP (reason `PAUSE`, GRQ-B-10 d) — wizards are not resumable. `SAMPLE` (take-sample capture)
is never affected by stops or pauses; its result carries the state flags of its window.

---

## 4. Transport and protocol client

### 4.1 Transport (`io.transport`)

```python
class Transport(ABC):
    name: str
    def open(self) -> None; def close(self) -> None; def is_open(self) -> bool
    def read(self, max_bytes: int) -> bytes        # returns after ≤ read timeout (2 ms), b"" on timeout
    def write(self, data: bytes) -> None           # whole frame; raises TransportError
    last_write_ns: int                              # for perf tests (NFR-002/003)
def transport_factory(endpoint: str) -> Transport
    # "COM7" → SerialTransport(921600, 8N1, no flow control, timeout set once)       (IF-002)
    # "tcp://127.0.0.1:5760" → TcpTransport (FW host twin, Integrator)
    # "sim" | "sim:<scenario.json>" → VirtualTransportPair host end + SimBoard (§12)
```

- `SerialTransport`: port settings and the read timeout are configured **once** (TS SWD-M1-01: changing the
  timeout per read hammered the ST-LINK VCP with SetCommState). Pending bytes at open are fed to the parser,
  not flushed blindly (R3 §1.7 P13).
- `VirtualTransportPair`: in-memory byte pipes with optional baud pacing (92 160 B/s), latency, unplug/replug.
- **`wire_log` on every transport** (base class, SWD-P1-09 b): a bounded ring (default 200 000 entries) of
  `WireRecord(t_ns, direction TX | RX, frame bytes)` recorded at the write call (TX) and at the read that
  completed the frame (RX); enabled by `BackendSettings(wire_log=True)` for Serial, Virtual and TCP
  transports, so REF runs against the out-of-process simulator (`tcp://127.0.0.1:5770`) have the same
  timestamps as in-process runs; `test_hooks.wire_log()` returns a copy. The simulator server keeps its own
  board-side log (§12.4).
- D-06: no code path opens a COM port by itself; port lists come from `io.ports` (enumeration only).

### 4.2 Framing and codec (`io.framing`, `io.protocol`)

- Frame (ICD §2, IF-003/004): `A5 5A | TYPE u8 | SEQ u8 | LEN u16 (0…160) | PAYLOAD | CRC16`,
  CRC-16/CCITT-FALSE over TYPE..PAYLOAD, low byte first (check `"123456789"` → 0x29B1). `FrameDecoder` = TS
  `io/framing.py` state machine adapted to ICD §2.3: buffer ≥ 336 B; hunt for `A5 5A` (a trailing lone `A5`
  kept); `LEN > 160` → `len_errors`, drop one byte; CRC mismatch → `crc_errors`, drop one byte (a truncated
  frame never swallows the next one); **inter-byte timeout 20 ms** evaluated only after an empty read (TS
  SWD-M2-01) → `timeout_drops`, drop one byte, re-scan; a lone trailing `A5` discarded without counting;
  TYPE invalid for the PC side (§3.1: anything but `0x81..0xBF`, `0xC0..0xCF`) → `unknown_type`, ignored;
  `0xC2..0xCF` reserved asynchronous frames are ignored without counting an error. Output (frames +
  counters) equals `ref_codec.FrameParser` on every `streams` vector.
- **Name tables** (command TYPEs and LENs, retry classes, STATUS codes and detail enums, BLOCK/FAULT/IO bit
  names, DATA `flags`/`status` bits, `sys_flags`, feature bits, motion states, home phases, halt/pause
  sources, reset causes, EVENT codes and their `arg` enums, stop causes, MOVE_DONE reasons, constants) come
  **only** from the generated `core/protocol_gen.py` (ICD v0.2 §0.3, GF-08). `io.protocol` adds the struct
  layouts; a test proves that every name/code decoded from `protocol_vectors.json` equals the generated
  tables. `ref_codec` is imported in tests only, never in production code (tools/README).
- `io.protocol` (hand-written, vector-tested; the vectors are the oracle, ICD §0.1 / R3 P14) provides for
  **both directions**: request builders (PC→FW, used by `core.device`; decoders used by the simulator),
  response encoders/decoders (FW→PC; encoders used by the simulator), `INFO` (44 B), `STATUS` (86 B),
  `PARAM_ENTRY` (7 B, typed via `params_gen.ParamMeta.pack/unpack`, non-zero padding → `INVALID_PADDING`
  error), GET_ALL_PARAMS pages (`page, page_count, n, n × entry`), `EVENT` (16 B: `t_us u32, code u16,
  arg u16, value i32, value2 i32`), `DATA_DTYPE` (numpy structured, little-endian, packed, 18 B: `t_us u32,
  payload_version u8, flags u8, afe_raw i32, setpoint_um i32, frame_seq u16, status u16`) for
  `np.frombuffer` batch decoding (IF-006), and `Nack(status, detail)` with `nack_text(cmd, status, detail)`
  (§4.7).
- Tolerance (ICD §0.2, IF-008): OK responses longer than known are accepted (trailing bytes ignored, vector
  `get_info_resp_longer`); unknown EVENT codes, STATUS codes, reasons and set reserved bits are logged and
  never fatal; a DATA payload whose `payload_version` ≠ 1 is not decoded (`bad_payload`, compat state
  `PAYLOAD_MISMATCH`).

### 4.3 Reader (`io.reader`)

TS `io/reader.py` as-is: ABOVE_NORMAL priority thread, reads ≤ 4096 B per call, stamps the host time
**before** the read, applies the inter-byte timeout only after an empty read, dispatches responses to the
`CommandChannel` and async frames to the Pipeline queue, then publishes `line_ns` (the instant up to which
the line was observed; TS SWD-M2-07). A full Pipeline queue is a liveness fault (never a silent drop):
counter `async_overflow` + event + the motion reaction of §6.4.

### 4.4 Command channel (`core.link.CommandChannel`)

```python
def request(cmd: Cmd, payload: bytes, *, lane: Lane, timeout_s: float | None = None,
            retry: RetryClass | None = None, epoch: int | None = None) -> ReleasingFuture[Response]
```

- **SEQ**: incrementing u8, skipping values still pending; the response echoes it (FW-CMD-001); late
  responses of abandoned SEQs are counted and dropped; stale bytes at connect cannot match because the first
  SEQ is randomised (TS SWD-M2-06).
- **Lanes** (≤ 4 outstanding in total, ICD §9.3; the priority path is exempt):

  | Lane | Commands | Rule |
  |---|---|---|
  | priority (exempt, §4.5) | STOP, HALT, PAUSE, HALT_CLEAR, ESTOP_CLEAR, FAULT_CLEAR | never waits, outside the outstanding limit and the token bucket |
  | SAFETY | PING, SET_VALID(0), JOG 0 | 1 reserved slot |
  | CONTROL | RESUME, MOVE_ABS, MOVE_UNTIL_LOAD, JOG ≠ 0, HOME, ENABLE, DISABLE, SET_VALID(1), SET_PARAM of `safety.*` session values | 1 reserved slot |
  | GENERAL | GET_INFO, GET_STATUS, GET_PARAM, GET_ALL_PARAMS, other SET_PARAM, SAVE/LOAD/DEFAULT_PARAMS, STREAM_START/STOP, REBOOT | ≤ 2 |

- **Retry classes** = ICD §9.3 (F-B-01 closed); the class is a property of the command in `io.protocol`
  (`RETRY_CLASS[cmd]`, JOG decided by `v == 0`), never chosen by the caller:

  | Class | Commands | Behaviour |
  |---|---|---|
  | `RETRY` | PING, GET_INFO, GET_STATUS, GET_PARAM, GET_ALL_PARAMS, SET_PARAM, STREAM_START, STREAM_STOP, SET_VALID, **JOG 0** | timeout 100 ms (GET_INFO at connect 200 ms); ≤ 2 retries, each with a **new SEQ** and the **newest** value (latest-wins slots for SET_VALID, threshold SET_PARAMs and JOG 0); a retry superseded by a newer command is dropped; late responses of abandoned SEQs are counted and ignored |
  | `CONFIRM` | STOP, HALT, **PAUSE** | priority path; repeated every 50 ms until confirmed — STOP: ACK or `MOVING = 0` (DATA or GET_STATUS); HALT: ACK or `flags.HALT`; PAUSE: ACK or `status.PAUSED`, each indication only if its device `t_us` ≥ the FW receive time of the command (v0.4, D-37 d: PC–device time pairing + round-trip bound, or a STATUS answering a request written after the command) — ≤ 20 attempts in 1 s; with the stream off the `StopConfirmer` polls GET_STATUS (ICD §9.4); unconfirmed after 1 s → event `stop.unconfirmed` + banner "use the red E-stop button" |
  | `VERIFY` on the **priority path** | **HALT_CLEAR, ESTOP_CLEAR, FAULT_CLEAR** (D-34, ICD v0.4.1; the class `ONCE_PRIORITY` no longer exists) | written through the priority path (bypassing lanes, queues, token bucket), timeout 100 ms, **never auto-retried** — a retried clear could wipe a new STOP-button HALT, E-stop or load-limit trip raised in between; a timeout is resolved by GET_STATUS (§4.4.1); NACK detail decoded (§4.7) and shown verbatim |
  | `VERIFY` | **RESUME** (ICD v0.4: VERIFY, CONTROL lane, not sniffed), MOVE_ABS, MOVE_UNTIL_LOAD, HOME, JOG ≠ 0, ENABLE, DISABLE, SAVE_PARAMS, LOAD_PARAMS, DEFAULT_PARAMS, REBOOT | **never retried** (SD-08). After the timeout (100 ms; SAVE/LOAD/DEFAULT 3000 ms + wire time of the TX backlog; REBOOT: EVENT BOOT or 3 s) the channel sends GET_STATUS and resolves the outcome (§4.4.1); `CommandOutcomeUnknown` only if GET_STATUS also fails. |

  JOG ≠ 0 refreshes (§5.4) are a stream of new VERIFY commands scheduled every **80 ms** on the 5 ms
  Supervisor tick (absolute deadlines; worst case 80 + 5 + jitter < 100 ms, SW-MAN-004, SWD-P1-11) with the
  newest speed and bound; a timed-out refresh is **not** resolved by GET_STATUS (the next refresh supersedes
  it) and is covered by the FW dead-man (`motion.jog_timeout_ms`, SAF-FW-016); 3 consecutive refresh
  **timeouts** → `jog_stop()` + link DEGRADED. A refresh **NACK** ends the jog session at once (no further
  refresh) and is not a timeout.

- **Expected refusals (D-33 k, SWD-P1-03).** A NACK is an answer, not a link failure: only response
  *timeouts* count toward DEGRADED. A motion command (MOVE_ABS, MOVE_UNTIL_LOAD, HOME, JOG ≠ 0 incl.
  refreshes) refused with `E_STATE` whose BLOCK mask contains **PAUSED** is an **expected outcome** of the
  PAUSE race (a command in flight when PAUSE was pressed): no retry, no DEGRADED count, no error dialog; the
  `MoveTicket` resolves `REFUSED_PAUSED`, the jog session and the pending target are dropped, the manual
  commanded target is resynced, and a running sequence stays (or becomes) PAUSED with its step and phase
  unchanged — the step's motion is re-issued only by Resume. The same holds for a motion command refused
  while the SW already knows a stop/latch is in progress (epoch changed): it is logged, not shown.

#### 4.4.1 VERIFY outcome resolution (GET_STATUS, ICD §7.2)

| Command | "executed" when GET_STATUS shows … | else |
|---|---|---|
| MOVE_ABS | `motion_state` = MOVE_ABS / STOPPING with `target_um` = sent target, **or** a MOVE_DONE received after the request was written (every accepted motion ends with exactly one MOVE_DONE, ICD §5.4; EVENTs are not lost silently — an EVENT SEQ gap makes the outcome `unknown`) | not executed → `CommandNotExecuted` (the caller may re-issue explicitly; no automatic re-send) |
| MOVE_UNTIL_LOAD | `motion_state` = MOVE_UNTIL_LOAD / STOPPING with `target_um` = bound, or a MOVE_DONE for this epoch | not executed |
| HOME | `motion_state` = HOMING or `home_phase` ≠ NONE, or EVENT HOMED / HOME_FAILED received | not executed |
| JOG ≠ 0 | `motion_state` = JOG | not executed |
| ENABLE / DISABLE | `motion_state` ∈ {ENABLING, IDLE, moving} / = NOT_ENABLED and `io.ENA_DISABLED` | not executed |
| SAVE_PARAMS | `nvm_record_seq` increased and `CFG_DIRTY` = 0 | not executed |
| LOAD / DEFAULT_PARAMS | EVENT PARAMS_LOADED / PARAMS_DEFAULTED received; otherwise unknown → full parameter re-read | — |
| REBOOT | EVENT BOOT, `uptime_ms` smaller than before | — |
| RESUME | `status.PAUSED` = 0 **and no EVENT PAUSED received since the RESUME was written** (a new pause in between means the RESUME did not take effect for the current pause), or EVENT PAUSE_CLEARED arg 3 RESUME received | not executed → the sequence stays PAUSED, message "Resume not confirmed — press Resume again" (never re-sent automatically) |
| HALT_CLEAR | `flags.HALT` = 0 and `status.PAUSED` = 0 (or EVENT HALT_CLEARED / PAUSE_CLEARED arg 2 received) | not executed → `ClearResult(confirmed=False)`, message "Clear not confirmed — click again"; nothing is re-sent automatically (D-34) |
| ESTOP_CLEAR | `flags.ESTOP` = 0 (or EVENT ESTOP_CLEARED received) | as above |
| FAULT_CLEAR | the previously latched faults are no longer in STATUS `faults` (or EVENT FAULT_CLEARED received; its arg = cleared mask) | as above; if only some faults cleared, `ClearResult.cleared` lists those |

A clear whose latch is still set after the GET_STATUS check may also have been executed and re-tripped (e.g.
LOAD_LIMIT re-trip on regrow); the result text then names the new latch event if one arrived.

- **Motion epoch** (KD-04): `CommandChannel.motion_epoch` increments on every STOP/HALT/PAUSE sent and on
  every FW stop indication (EVENT STOPPED, ESTOP_SET, HALT_SET, PAUSED, FAULT_SET, LIMIT_SET, LINK_WDG,
  HOME_FAILED, DRIVER_DISABLED, DRIVER_POWER(0); MOVE_DONE reason STOPPED; `MOVING` 1→0 without MOVE_DONE).
  A motion request carries the epoch at creation; the writer drops it if the epoch changed before it was
  written (event `motion.dropped`). JOG sessions and pending targets are bound to the epoch.
- **Token bucket** ≤ 100 command frames/s (ICD §9.3) for GENERAL/CONTROL; SAFETY and priority frames are
  exempt (they are ≤ 7 Hz + bursts of ≤ 20 in 1 s).

### 4.5 Priority TX path (`core.link.PrioritySender`) — IF-011, NFR-002, NFR-003

- `send_now(cmd, payload)` builds the frame and acquires `FrameWriter._lock` with priority: the writer lock is
  a two-level lock (a "priority waiting" flag makes normal writers yield before taking the lock), so the
  longest wait is **one frame already being written** (PC→FW frames ≤ 25 B, i.e. MOVE_UNTIL_LOAD; the
  largest frame of either direction is 168 B ≈ 1.8 ms; typ. < 0.5 ms because the OS buffers the write).
  No queue, lane, token bucket or outstanding limit applies. Frames: STOP 9 B, HALT 8 B, PAUSE 8 B (fixed
  TYPEs for the FW stop sniffer, ICD §2).
- The call never raises to the caller: transport errors are recorded in the returned `StopResult(sent,
  t_write_ns, error)` and published; the GUI banner shows the real send result (TS SWD-M1-05).
- STOP/HALT/PAUSE: (1) increment the motion epoch (a plain integer store, so a motion frame waiting for the
  lock is dropped) and write the frame under the priority lock, (2) cancel the jog session and the pending
  target, (3) call `OperationRegistry.terminate_all(reason)` (PAUSE: `pause_all(source)`, §3.5), (4) arm the
  `StopConfirmer` (CONFIRM class), (5) publish `stop.issued` — in this order, all within the caller's
  thread, no waiting (act first, publish after).
- Callers: GUI STOP (GUI thread, SW-STOP-001), hotkey thread (SW-STOP-002), Pipeline (SAF-SW-001 trips,
  sequence guards), Supervisor (SAF-SW-003 link loss, liveness), Operation runner (abort).

### 4.6 Heartbeat, link states and liveness (`core.link.LinkSupervisor`, `core.liveness`)

- **Heartbeat** (SAF-SW-003): every 5 ms tick, if `now − last_tx ≥ 150 ms` and the liveness gate is open,
  send PING (SAFETY lane). Worst-case gap 150 + 5 + jitter ≪ 250 ms (95 ms margin for GIL/GC pauses). Any
  sent frame counts. Liveness gate: Reader beat < 200 ms, Pipeline beat < 300 ms, and while streaming the last
  DATA < 500 ms. A dead or hung backend therefore stops the heartbeat and the FW link watchdog
  (SAF-FW-015, 1 s) performs a controlled stop.
- **DATA loss while moving** (SAF-SW-003): moving (latest `MOVING` flag, or a motion command in flight, or a
  jog session) and no DATA for > 500 ms → priority STOP, `terminate_all("LINK_LOST")`, link state `LOST`
  indicator "LINK LOST". STREAM_STOP is refused by the backend while moving or while an operation runs
  (PC limits need data).
- **Link states** (`LinkState`): `DISCONNECTED → CONNECTING → CONNECTED`; `DEGRADED` after 3 consecutive
  command timeouts or 300 ms without any received frame while streaming (recovery probe GET_STATUS every 1 s,
  TS SWD-M3R2-02); `LOST` after 1 s without frames or on a serial exception; reconnect attempts every 1 s
  (same endpoint) run the connect sequence (§5.2) and compare the board UID. **The SW never re-enables,
  re-homes, re-moves or restarts a sequence automatically after a reconnect.**
- **Liveness faults** (thread beat missing: Reader > 100 ms, Pipeline > 200 ms or DATA received but not
  evaluated > 200 ms, Operation runner > 300 ms while moving, GUI > 2 s; uncaught exception in any thread via
  `threading.excepthook`/`sys.excepthook`): while moving → priority STOP + `terminate_all` + event; idle →
  warning event only. The hotkey thread missing its 250 ms ping → warning "Pause/Break key unavailable" (the
  physical STOP button and E-stop remain the path of record).

### 4.7 Command mapping (ICD v0.2 §3.2) and NACK decoding (ICD §4)

| TYPE | Command | Request (wire) | OK body | Lane / class | Backend caller |
|---|---|---|---|---|---|
| 0x01 | PING | – | – | SAFETY / RETRY | `LinkSupervisor` heartbeat, `Device.ping` |
| 0x02 | GET_INFO | – | INFO 44 B | GENERAL / RETRY | connect, reconnect |
| 0x03 | GET_STATUS | – | STATUS 86 B | GENERAL / RETRY | connect, poll, VERIFY resolution, stop confirmation |
| 0x04 | REBOOT | `u32 0xB007B007` | – | GENERAL / VERIFY | `config.reboot_async` (REBOOT_PENDING) |
| 0x10 | GET_ALL_PARAMS | `u8 page` | page, page_count, n, entries | GENERAL / RETRY | `read_all_params` (3 pages for dict 1) |
| 0x11 | GET_PARAM | `u16 id` | PARAM_ENTRY | GENERAL / RETRY | read-back |
| 0x12 | SET_PARAM | PARAM_ENTRY | PARAM_ENTRY as stored | GENERAL or CONTROL (`safety.*`) / RETRY | write plan, ThresholdManager, travel cal |
| 0x13–0x15 | SAVE / LOAD / DEFAULT_PARAMS | – | – | GENERAL / VERIFY | config API, travel cal ACCEPT |
| 0x20 / 0x21 | STREAM_START / STOP | – | – | GENERAL / RETRY | connect, toolbar, engines |
| 0x22 | SET_VALID | `u8 0/1` | `u32 t_us` | SAFETY (0) / CONTROL (1), RETRY newest | sequencer windows, manual toggle |
| 0x30 | ENABLE | – | `u16 settle_ms` | CONTROL / VERIFY | `motion.enable` (state ENABLING shown for `settle_ms`) |
| 0x31 | DISABLE | – | – | CONTROL / VERIFY | `motion.disable(confirmed)` |
| 0x32 | HOME | `u8 flags` (bit0 = load confirmed) | – | CONTROL / VERIFY | `motion.home`; `E_CONFIRM` → `ConfirmationRequired` |
| 0x33 | MOVE_ABS | `i32 target_um, u32 v_um_s, u32 a_um_s2` | – | CONTROL / VERIFY | `motion.move_to/move_by`, engines |
| 0x34 | JOG | `i32 v_um_s, u32 a_um_s2, i32 bound_um` (`JOG_NO_BOUND` = 0x80000000) | – | CONTROL / VERIFY (v ≠ 0), SAFETY / RETRY (v = 0) | `motion.jog_*` (§5.4) |
| 0x35 | MOVE_UNTIL_LOAD | `i32 bound_um, u32 v_um_s, u32 a_um_s2, i32 raw_stop, u8 cmp` | – | CONTROL / VERIFY | load-step approach (§10.4) |
| 0x36 | STOP | `u8 mode` 0 immediate / 1 controlled | – | priority / CONFIRM | `Backend.stop`, safety, supervisor, sequencer stop (mode 1) |
| 0x37 | HALT | – | – | priority / CONFIRM | `Backend.halt`, hotkey |
| 0x38 | HALT_CLEAR | – | – | priority / VERIFY (D-34) | `clear_stop_async` (clears HALT **and** PAUSED, D-31) |
| 0x39 | ESTOP_CLEAR | – | – | priority / VERIFY (D-34) | `estop_clear_async(confirmed)` |
| 0x3A | FAULT_CLEAR | – | `u16 cleared` FAULT mask | priority / VERIFY (D-34) | `fault_clear_async` |
| 0x3B | PAUSE | – | – | priority / CONFIRM | `Backend.pause` (D-29 a) |
| 0x3C | **RESUME** (ICD v0.4, D-31) | – (0) | – | CONTROL / VERIFY (ICD v0.4; refused only by ESTOP latched or input open, HALT and latched faults — never by NOT_ENABLED, DRV_UNPOWERED, DRIVER_ALARM, LIMIT, AFE or motion state) | `Backend.resume()`: clears **only** PAUSED; `E_STATE` (BLOCK mask) while HALT, ESTOP or a fault is latched |

All request LENs are fixed (`E_LENGTH` otherwise); the builders are tested byte-identical against the
request frames of `protocol_vectors.json`. Speeds/accelerations: accel `0` = `motion.a_max_um_s2`.

**NACK** = exactly 3 bytes `u8 status, u16 detail`; a NACKed command had **no effect** (ICD §4.1).
`NackError(cmd, status, detail)` carries `nack_text()` (shown verbatim, FW-CMD-003):

| Status | Decoding of `detail` → text |
|---|---|
| `E_UNKNOWN_CMD` 1 / `E_LENGTH` 2 | TYPE / expected LEN → "internal protocol error" (logged as a defect; never expected) |
| `E_PARAM_ID` 3 / `E_TYPE` 4 | parameter id → key from `params_gen.BY_ID` |
| `E_RANGE` 5 | SET_PARAM: parameter id → key + allowed range; other commands: **byte offset** → field name from the request layout (e.g. MOVE_ABS 0 = target, 4 = speed "above the current speed cap `v_limit`", 8 = accel; JOG 8 = bound "not ahead of the axis / outside the soft limits"; MOVE_UNTIL_LOAD 12 = raw_stop, 16 = cmp) |
| `E_CONFIG` 6 | id of the **other** parameter of the violated hard rule → "conflicts with `<key>` (rule Hn)" |
| `E_BUSY` 7 | 1 MOTION ("axis moving / homing / stopping"), 2 ENABLING ("driver settling") |
| `E_STATE` 8 | BLOCK mask → list of names + clear hints (§6.5): ESTOP, HALT, FAULT, NOT_ENABLED, NOT_HOMED, LIMIT, AFE_STALE, AFE_SATURATED, DRV_UNPOWERED, DRIVER_ALARM, **PAUSED** (D-30: an expected outcome for motion commands, §4.4 — shown as "paused — press Resume", never as an error); on RESUME the mask names the latch that refused it (HALT / ESTOP / FAULT, D-31) |
| `E_CAUSE_ACTIVE` 9 | ESTOP_CLEAR: `0xFFFF` "E-stop input still open", else "wait n ms"; HALT_CLEAR: `0xFFFF` "STOP button still pressed", else "wait n ms"; FAULT_CLEAR: FAULT mask of the faults whose cause is present (names) |
| `E_CONFIRM` 10 | HOME under load → `ConfirmationRequired` (the gate shows C-02 and the call is repeated with the flag) |
| `E_NVM` 11 | 1 "no valid NVM record / record violates a hard rule", 2 "flash erase/program error", 3 "flash verify error" |
| `E_INTERNAL` 12 | implementation-defined → logged with the raw value |

---

## 5. Device API

### 5.1 `core.device.Device` (wire-level, thread-safe)

```python
class Device:                                   # Implements: SW-PLT-003, SW-CFG-*, IF-005, IF-008
    def __init__(self, transport_factory: Callable[[str], Transport], events: EventBus,
                 clock: Clock = MONOTONIC) -> None
    # connection
    def connect(self, endpoint: str, *, stream: bool = True) -> DeviceInfo      # §5.2
    def disconnect(self) -> None                 # STOP if moving, STREAM_STOP, close (no DISABLE)
    state: LinkState; compat: Compat; info: DeviceInfo | None
    def get_info(self) -> DeviceInfo; def get_status(self) -> BoardStatus; def ping(self) -> float
    def reboot(self) -> None                     # VERIFY class; reconnect after EVENT BOOT or 2 s
    # parameters (SW-CFG)
    def read_all_params(self) -> dict[str, ParamValue]              # paged GET_ALL_PARAMS (FW-CFG-002)
    def get_param(self, key: str) -> ParamValue
    def set_param(self, key: str, value: int | float | bool | str) -> ParamValue   # value as stored
    def write_and_verify(self, edits: Mapping[str, Any], *, progress=None) -> VerifyReport   # §5.3
    def save_params(self) -> None; def load_params(self) -> dict; def default_params(self) -> dict
    # streaming / validity
    def stream_start(self) -> None; def stream_stop(self) -> None   # stop refused while moving / op running
    def set_valid(self, flag: bool) -> int       # returns device t_us from which it applies (FW-CMD-002)
    # motion, wire units, used only by MotionController / engines (gates applied there)
    def enable(self) -> int                       # returns settle_ms (0 = already enabled)
    def disable(self) -> None
    def home(self, *, load_confirmed: bool) -> None                 # HOME flags bit0
    def move_abs_um(self, target_um: int, v_um_s: int, a_um_s2: int, *, epoch: int) -> None
    def move_until_load(self, bound_um: int, v_um_s: int, a_um_s2: int, raw_stop: int,
                        cmp: MulCmp, *, epoch: int) -> None         # direction = sign(bound − x)
    def jog_um_s(self, v_um_s: int, a_um_s2: int = 0, bound_um: int = JOG_NO_BOUND, *,
                 epoch: int) -> None                                # v = 0 → JOG 0 (RETRY class)
    # stops, pause and clears (priority path, never raise)
    def stop(self, mode: StopMode = StopMode.IMMEDIATE, reason: str = "user") -> StopResult
    def halt(self, source: str) -> StopResult
    def pause(self, source: str) -> StopResult                     # PAUSE 0x3B (D-29 a)
    def resume_cmd(self) -> ClearResult                             # RESUME 0x3C: clears only PAUSED (D-31, ICD v0.4)
    def halt_clear(self) -> ClearResult; def estop_clear(self) -> ClearResult
    def fault_clear(self) -> ClearResult                            # .cleared = FAULT mask names
    # ClearResult(sent, confirmed, outcome OK | REFUSED(nack) | NOT_CONFIRMED, cleared, text): clears and
    # RESUME are VERIFY class (D-31, D-34) — one frame, never re-sent; a timeout is resolved by GET_STATUS
    # every blocking method has `<name>_async(...) -> ReleasingFuture` (Worker thread)
```

`ParamValue`, `DeviceInfo` (INFO §7.1: proto/payload versions, fw_version, `param_dict_hash`, `uid` hex,
`build`, `param_count`, `features: frozenset[str]`), `BoardStatus` (STATUS §7.2, all 86-byte fields decoded:
`motion_state`, `home_phase`, `halt_src`, `reset_cause`, `sys_flags` (CLK_FALLBACK, CFG_DIRTY, STREAM_ON,
REBOOT_PENDING, NVM_DEFAULTED), `pos_um`, `target_um`, `pos_steps`, `afe_raw_last`, `afe_rate_sps`,
counters, `link_age_ms`, `idle_disable_left_s`, `nvm_record_seq`, `v_limit_um_s`, `pause_src` (offset 84,
`Source` NONE/PC/BUTTON, ICD v0.2)), `StatusFlags` (DATA `flags` u8 + `status` u16, ICD §7.6), `Faults`,
`IoLevels`, `BlockMask` are frozen dataclasses wrapping the generated `protocol_gen` `IntFlag`s/`IntEnum`s
(`DataFlags`, `DataStatus`, `Faults`, `IoBits`, `Block`, `SysFlags`, `MotionState`, …). A STATUS body
longer than 86 B is accepted (trailing bytes ignored, ICD §0.2). Compat flags: `OK | MINOR_DIFF |
MAJOR_MISMATCH | PAYLOAD_MISMATCH | PARAM_HASH_MISMATCH` (IF-008). `MulCmp` (`protocol_gen`)
(`GE = 0`: stop when raw ≥ raw_stop, `LE = 1`, ICD §5.4).

**Feature mask** (INFO `feature_mask`): a function whose bit is 0 is refused by its gate with the reason
"not supported by this FW build" — `MOTION` (all motion), `HOMING` (HOME), `MOVE_UNTIL_LOAD` (LOAD steps,
sequence start with LOAD steps), `NVM` (SAVE/LOAD), `BUTTONS` / `DRV_SIGNALS` (indicators shown as
"not wired"). `AFE_SYNTHETIC` (M1 FW placeholder samples): banner "synthetic load data", load calibration
and tare refused (`cal_load_start`, `tare` gates), SW load limits treated as without valid input.

### 5.2 Connect sequence (SW-PLT-003, IF-008)

Order = ICD §9.5.
1. Open the transport; pending bytes are fed to a fresh `FrameDecoder` (stale responses have no pending SEQ
   and are ignored, R3 P13); start Reader/Pipeline/Supervisor; randomise the first SEQ.
2. GET_INFO (200 ms timeout) repeated for ≤ 3 s; heartbeat starts with the first answer. No answer → "no board".
3. Version check: `proto_major` ≠ 1 or `payload_version` ≠ 1 → `MAJOR_MISMATCH`/`PAYLOAD_MISMATCH`:
   **read-only state** (monitoring and config read allowed; every motion, clear-and-enable and config write
   refused locally; DATA of another payload version is not decoded). `proto_minor` lower than the SW's →
   features beyond it unused (`MINOR_DIFF`). `param_dict_hash` ≠ `PARAM_DICT_HASH` → `PARAM_HASH_MISMATCH`:
   configuration read-only + warning (`set_param`/`write_and_verify` raise `ConfigReadOnly`; the
   ThresholdManager may still write the three `safety.*` session values because their ids/types are checked
   individually against the received PARAM_ENTRY type — if any differs, motion stays disabled).
4. GET_STATUS → latches, inputs, reset cause, motion state/HOMED/ENABLED, `sys_flags` (CFG_DIRTY →
   indicator "unsaved changes in RAM"; NVM_DEFAULTED → banner "board runs on defaults"; REBOOT_PENDING;
   CLK_FALLBACK → warning "MCU on HSI fallback clock, ±1 % timing", SD-10); nothing is saved automatically.
5. GET_ALL_PARAMS (pages 0…page_count−1) → `ParamStore`. Checks: AFE configuration vs the active
   calibration's `afe` block → calibration invalid for load limits (SW-CAL-009, D-29 l); `motion.steps_per_mm`
   vs the active travel calibration and a restore-pending record (§9.3.1). (`home.ref_switch` no longer exists in dict 2; a
   board with dict 1 is reported as `PARAM_HASH_MISMATCH`, configuration read-only.)
6. `ThresholdManager.on_connect()` writes and verifies `safety.load_raw_min/max` + `safety.zero_raw`
   (SAF-SW-002, §6.3) — motion stays disabled until verified (or the defaults in no-specimen mode, §6.7).
7. STREAM_START (default on; SW-ACQ-001 toggle later). Time unwrap starts a new epoch (§7.3).
8. `MotionController.resync()` from the first DATA frame (commanded target = reported `setpoint_um`).
A board UID different from the previous connection in this run invalidates the session tare (KD-13) and the
restore-pending record is kept for its own UID only.
Link statistics (frames OK, lost frames FW/link, CRC/len/timeout errors, late responses, command timeouts,
FW counters from GET_STATUS) are available from step 2 (`Backend.status().link`).

### 5.3 Configuration read / write / verify (SW-CFG-001..004)

- `ParamStore` holds board values, defaults and metadata from `params_gen` (typed fields, units, ranges, enum
  names for D's generated form, SW-CFG-001).
- `check(edits) -> list[Issue]` (GRQ-B-03): the same code as step (1) below, callable from the GUI thread
  (pure, < 1 ms): per key unknown / type / range (`ParamMeta.in_range`, enum code, f32 finite) and hard
  rules H1–H4 on board values ⊕ edits; locked keys (`safety.load_raw_min/max`, `safety.zero_raw` owned by the
  ThresholdManager, F-B-21) → ERROR "managed by the backend";
  `reboot_required` keys → INFO "effective after Save + Reboot" (SD-06).
- `write_and_verify(edits)` (TS-SWD §4.1 procedure, simplified, no `fw_owned`): (0) refuse under
  `PARAM_HASH_MISMATCH`; (1) `check(edits)` — any ERROR aborts before the first write (SW-CFG-003);
  (2) write changed parameters in an order that keeps H1–H4 true after each single SET (ICD §11.4: min/max
  pairs move the outward bound first; H3 lower the rate before widening pulses, widen the rate after
  narrowing pulses; H4 raise travel before load, lower load before travel); an `E_CONFIG` item is retried
  after the others in a further pass until a pass makes no progress (then REJECTED); parameters without
  `moving_ok` while moving → `BUSY` without sending; (3) `GET_ALL_PARAMS` read-back; per item `OK |
  REJECTED(status, detail) | MISMATCH | BUSY | TIMEOUT | NOT_ATTEMPTED | REBOOT_REQUIRED`; (4) GET_STATUS →
  CFG_DIRTY, REBOOT_PENDING. Never saves to NVM implicitly. After `motion.steps_per_mm`, `afe.*` or
  `safety.*`-related edits the ThresholdManager rechecks (§6.3).
- Board-config file (`*.bbboard.json`, §13.1): `save_board_config(path, values)`; `load_board_config(path)
  -> BoardConfigFile(values, unknown_keys, missing_keys, out_of_range, hash_mismatch)` — fills edit fields
  only (SW-CFG-002).
- NVM buttons: `save_params` (then GET_STATUS: CFG_DIRTY must be 0, `nvm_record_seq` increased),
  `load_params` / `default_params` (+ re-read; DEFAULT_PARAMS resets the session values to ±7 022 271 / 0,
  so the `ThresholdManager` **must** re-send them, ICD §5.2/§11.5) (SW-CFG-004). `reboot_async()`
  (REBOOT_PENDING after an `R` parameter + SAVE) refused while moving; reconnect after EVENT BOOT.
- `safety.load_raw_*` and `safety.zero_raw` are owned by the `ThresholdManager`; the config form shows them
  read-only (F-B-21, done in D's design).

### 5.4 Motion API (`core.motion.MotionController`) — SW-MAN-001..006, SW-LIM-001

```python
class MotionController:                    # all values in SW units; owner = OperationRegistry token
    commanded_target_mm: float | None      # last accepted absolute target (SW-MAN-002/003)
    pending_target_mm: float | None        # latest-wins target while the FW is busy
    x_zero_mm: float                       # test travel zero (PC offset, never sent)
    def move_to(self, target_mm: float, *, speed_mm_s: float | None = None,
                accel_mm_s2: float | None = None, owner: OwnerToken = MANUAL) -> MoveTicket
    def move_by(self, delta_mm: float, **kw) -> MoveTicket   # target = commanded_target + delta
    def jog_start(self, direction: int, speed_mm_s: float) -> None   # refresh every 100 ms (Supervisor)
    def jog_update(self, speed_mm_s: float) -> None; def jog_stop(self) -> None   # JOG 0 = controlled stop
    def move_until_load(self, ...) -> MoveTicket            # used by the load-step engine (§10.4)
    def enable(self) -> None; def disable(self, *, confirmed: bool) -> None
    def home(self, *, load_confirmed: bool = False) -> MoveTicket
    def set_test_zero(self) -> float      # x_zero = current commanded position (SW-MAN-006), event row
    def reset_test_zero(self) -> None     # x_zero := 0 (machine coordinate), event row X_ZERO (GRQ-B-06)
    def set_valid(self, flag: bool) -> int    # manual VALID toggle (SW-MAN-006); gate valid_toggle
    def limits(self) -> MotionLimits      # caps + SW travel range (below)
    def check(self, kind: MotionKind, *, speed_mm_s: float | None = None, accel_mm_s2: float | None = None,
              target_mm: float | None = None) -> GateResult   # GRQ-B-05: pure, GUI thread, < 1 ms
    def resync(self) -> None              # commanded_target := reported position (after stops/faults)
```

`MotionKind` = `MOVE | JOG | HOME | LOAD_APPROACH`. `MotionLimits` (frozen): `v_travel_mm_s`
(`motion.v_max_travel_um_s`), `v_load_mm_s` (`motion.v_max_load_um_s`), `v_step_rate_mm_s`
(`floor(max_step_rate_hz·1000/steps_per_mm)` µm/s), `v_unhomed_mm_s`, `a_max_mm_s2`, `loaded: bool`,
`v_cap_mm_s` (= the cap that applies now), `v_cap_fw_mm_s` (STATUS `v_limit_um_s`, ≤ 1 s old), SW travel
range (enabled limits ∩ soft limits, machine and test mm).

- **Conversion**: mm → µm with `round_half_away` (SYS-003) at the `Device` boundary only.
- **Speed caps (D-29 e, ICD §5.4)**: `v_cap = min(v_max, v_step_rate)` with `v_max = v_load` for
  MOVE_UNTIL_LOAD and whenever the axis is **loaded**, else `v_travel`; un-homed JOG additionally ≤
  `v_unhomed`. *Loaded* mirrors the FW predicate `abs(raw − safety.zero_raw) ≥ safety.release_band_raw` or
  AFE stale, evaluated by the SW with a safe-side margin (`≥ 0.8 · release_band_raw` counts as loaded), so a
  command the SW accepts is never refused by the FW for its speed except in a race at the band edge (then
  `E_RANGE` offset 4 → "speed above the loaded cap, retry slower"). Above the cap → `check()` ERROR /
  `ValueError` with the allowed maximum (SW-MAN-005); `None` = session default (≤ cap). Accel 0 = FW
  `a_max`; above `a_max` → ERROR.
- **Targets** must lie inside the enabled SW travel limits (SW-LIM-001) and the FW soft limits; refused
  locally with a message, nothing sent.
- **Commanded-target accumulator, latest wins (D-29 i, F-B-09/GF-04 closed)**: `move_by` adds to
  the **last commanded target including a pending one** (`pending_target_mm` if set, else
  `commanded_target_mm`), never to the live position (SW-MAN-002/003 v0.3). If the FW is idle the MOVE_ABS
  is sent at once; if a manual move of the same owner is still running, the new target becomes `pending_target_mm`
  (latest wins) and is sent on MOVE_DONE reason TARGET; any other MOVE_DONE reason or a stop discards it.
  Rapid clicks 11/12/13 send 11 and 13 (final target 13); with each move completed between clicks the wire
  sees 11, 12, 13. `status().motion.pending_target_mm` lets the GUI show the final target.
- **Resync**: after any stop, fault, latch clear, reconnect or MOVE_DONE other than TARGET,
  `commanded_target_mm` := reported position at standstill (`setpoint_um` of the first DATA frame with
  `MOVING = 0`, or MOVE_DONE `value`), so the next ±1 mm starts where the axis stopped.
- **Slider** (SW-MAN-001): GUI sends nothing while dragging; on release it calls `move_to(value)` once.
- **Jog** (SW-MAN-004): `jog_start` sends `JOG(v, a, bound)` immediately; the Supervisor refreshes it every
  80 ms on its 5 ms tick (max interval < 100 ms incl. tick and jitter, SWD-P1-11; newest speed and bound) while the session is active, the motion epoch is unchanged, the GUI beat is
  younger than 300 ms and the gate stays open; `jog_stop` (button release, focus loss — D calls it) sends
  JOG 0 (controlled stop, RETRY class). **Bound (F-B-15 closed, ICD §5.4)**: homed and an SW travel limit
  enabled in the jog direction → `bound_um` = that limit (the FW stops exactly there with a planned
  deceleration, MOVE_DONE BOUND); otherwise `JOG_NO_BOUND` (FW: soft limit when homed, `home.max_travel_um`
  from the start point when un-homed). A bound must lie strictly ahead of the axis: if the axis is at or
  beyond the SW limit in that direction the jog is refused locally (direction-aware, §6.1). The predictive
  PC check (§6.1 rule 3) stays as a second layer. Un-homed jog ≤ `v_unhomed`.
- **ENABLE**: the response's `settle_ms` starts an `ENABLING` display state; motion gates refuse with
  "driver settling (n ms)" until DATA shows `ENABLED = 1` (FW `E_BUSY` 2 otherwise).
- **PAUSED (D-30)**: a PAUSE (GUI or button) is a controlled stop and a **motion-blocking latch** in the FW
  (BLOCK bit PAUSED, ICD v0.3): every new motion start incl. JOG refreshes is refused while PAUSED; STOP,
  HALT, PAUSE, JOG 0 and the clears stay accepted. The manual gates therefore REFUSE while PAUSED with the
  hint "Resume (clears PAUSE)"; manual `Backend.resume()` = RESUME only (no motion, D-31). A manual command
  already in flight and refused with BLOCK PAUSED is an expected outcome (§4.4, D-33 k). On EVENT PAUSED or
  STOPPED (and on DATA `status.PAUSED` 0→1) the Pipeline **first** ends any jog session and drops the
  pending latest-wins target (motion epoch++), before any other processing.
- **MoveTicket**: a future resolved by EVENT MOVE_DONE (`MoveDone(reason: TARGET | LOAD_THRESHOLD | BOUND |
  SOFT_LIMIT | JOG_ZERO | STOPPED, pos_mm, pos_steps, t_us, stop_cause | None)` — `stop_cause` from the
  preceding STOPPED / HOME_FAILED), or resolved without motion as `REFUSED_PAUSED` (NACK with BLOCK PAUSED,
  expected, D-33 k) / `REFUSED(nack)` (any other NACK), or cancelled with the stop/latch/link reason; engines
  wait on it, the GUI may attach a done-callback via the bridge.

### 5.5 Stop, halt, pause and clear (SW-STOP-001..004, SAF-SW-004)

| Backend call | Wire (ICD v0.2) | Side effects |
|---|---|---|
| `Backend.stop(source)` | STOP mode 0 (immediate), CONFIRM | epoch++, jog/pending cancelled, `terminate_all` (sequence/wizard/tare terminated), event; not latched (D-26 (2)); FW clears VALID |
| `SequenceExecutor.stop()` | STOP mode 1 (controlled), CONFIRM | sequence ends STOPPED (SW-SEQ-007) |
| `Backend.halt(source)` (Pause/Break key, abort) | HALT, CONFIRM (≤ 20 tries / 1 s until ACK or `flags.HALT`) | as STOP; HALT latched in FW (`halt_src` PC) (SW-STOP-002) |
| `Backend.pause(source)` (GUI Pause) | **PAUSE 0x3B**, CONFIRM (ACK or `status.PAUSED`) (D-29 a) | epoch++, jog session and pending target dropped, `pause_all` (§3.5): sequence → PAUSED (state kept); wizards/tare terminated (GRQ-B-10 d); manual: FW controlled stop; FW sets the motion-blocking PAUSED latch (EVENT PAUSED arg PC, STATUS `pause_src`), clears VALID (D-30) |
| `Backend.resume()` | **RESUME 0x3C** (clears only PAUSED, D-31), then — sequence only — re-issue the interrupted step's motion (absolute target / approach + trim) | gate `resume` re-checked; capture window restarted; manual mode: RESUME only (no motion); a RESUME refused with `E_STATE` HALT/ESTOP/FAULT is an expected outcome (§10.5) |
| `Backend.clear_stop_async()` | HALT_CLEAR | only by explicit GUI action; NACK `E_CAUSE_ACTIVE` (STOP button pressed / released < `io.release_ms`) decoded; clears HALT and PAUSED (D-31). **While a sequence is PAUSED** (no HALT — a HALT has already terminated it): CONFIRM "ends the paused sequence" → the sequence is ended STOPPED (reason `CLEARED`) first, then HALT_CLEAR is sent; **no motion afterwards** (SW-STOP-003) |
| `Backend.estop_clear_async(confirmed)` | ESTOP_CLEAR | requires the confirmation token "button released, re-home needed" (SAF-SW-004); afterwards driver disabled + not homed: ENABLE then HOME (SAF-FW-006) |
| `Backend.fault_clear_async()` | FAULT_CLEAR | OK body = cleared FAULT mask; `E_CAUSE_ACTIVE` detail = faults whose cause is present, nothing cleared (FW-CMD-003); LOAD_LIMIT always clearable (unload; re-trip on regrow) |

#### 5.5.1 FW EVENT dispatch (ICD §8; Pipeline thread, in arrival order with DATA)

EVENTs are notifications; DATA flags / GET_STATUS stay authoritative (ICD §7.4). An EVENT SEQ gap (lost
events, `event_overflows`) triggers an immediate GET_STATUS and a `resync()`.

| EVENT (code) | Backend action |
|---|---|
| BOOT (1) | new time epoch (§7.3), link stats reset, re-run connect steps 4–8 (no motion, no re-enable), tare kept (same UID), restore-pending check (§9.3.1), indicator "board reset (cause)" |
| STOPPED (2) | epoch++, jog session ended and pending target dropped first (D-30), `stop_cause` stored for the next MOVE_DONE; cause ∈ {PC_HALT, STOP_BUTTON, ESTOP, LIMIT_*, LIMIT_WIRING, LOAD_LIMIT, AFE_FAULT, LINK_WDG, STEP_FAULT, HOME_FAIL, DRV_POWER_LOST} → `terminate_all(cause)`; PC_PAUSE / PAUSE_BUTTON → `pause_all`; PC_STOP / PC_STOP_CONTROLLED → already handled by the sender (or `terminate_all` if another PC instance sent it); JOG_DEADMAN → jog session ended, event "jog stopped: no refresh" |
| MOVE_DONE (3) | resolve the MoveTicket; manual pending target sent on TARGET; `resync()` on any other reason |
| ESTOP_SET (4) / ESTOP_CLEARED (5) | `terminate_all("ESTOP")`, travel-cal restore-pending stays armed; indicators |
| HALT_SET (6, arg source) / HALT_CLEARED (7) | `terminate_all("HALT <src>")`; `halt_source` |
| PAUSED (8, arg source 1 PC / 2 BUTTON) / PAUSE_CLEARED (9) | **first** epoch++, jog session ended, pending target dropped (D-30, OI-ICD-04); then `pause_all(source)`; `paused_source` (STATUS `pause_src`, GRQ-B-02). PAUSE_CLEARED (arg RESUME, ICD v0.4) → the resume in progress continues with the re-issue; PAUSE_CLEARED arg HALT_CLEAR → the sequence was already ended by `clear_stop`; an unexpected PAUSE_CLEARED while a sequence is PAUSED (another client) → sequence STOPPED |
| RESUME_REQUEST (10) | `Backend.resume(source="button")` if the `resume` gate is open: sequence PAUSED → RESUME + re-issue; manual → RESUME only (no motion, D-14/D-31); otherwise topic **`resume.ignored`** (`ResumeIgnored(source "button" | "gui", reason GateResult, t_us)`, GF-11) + event row (SW-STOP-004) |
| FAULT_SET (11, arg bit) / FAULT_CLEARED (12) | `terminate_all(fault)` if an operation runs; indicators per fault (§6.5); LOAD_LIMIT value = deciding raw → event row with F |
| LIMIT_SET (13) / LIMIT_CLEARED (14) | indicators; `resync()` |
| LINK_WDG (15) / LINK_RESTORED (16) | `terminate_all("LINK_WDG")`; indicator; the SW never restarts motion |
| VALID_CLEARED (17, arg cause) | sequencer closes the open window as discarded (`WINDOW_DISCARDED`), recorder event row; VALID never re-asserted |
| HOMED (18, value drift µm) / HOME_FAILED (19, arg reason) | resolve the homing ticket; drift shown; `resync()`; HOMING operation ends |
| DRIVER_ENABLED (20) / DRIVER_DISABLED (21, arg 1 PC / 2 IDLE / 3 ESTOP / 4 DRV_POWER_LOST) | indicators; IDLE: info "driver disabled after idle time"; 3/4: HOMED lost → `resync()` |
| STOP_BUTTON (22) / PAUSE_BUTTON (23) | input indicators only (the stop itself comes as STOPPED / HALT_SET / PAUSED) |
| ALM_CHANGED (24) | indicator `alm`; new motion refused by FW while powered (D-28) → gate REFUSE "driver alarm". **ALM 0→1 while a sequence runs (D-33 c)**: priority STOP mode 1 (controlled) + the sequence ends STOPPED, reason `DRIVER_ALARM` (no retry; the FW itself only reports, D-16). Same rule for travel calibration and homing operations (terminated). The ALM state is also taken from DATA `status.ALM` (0→1 edge) so a lost EVENT cannot hide it |
| AFE_REINIT (25), AFE_RATE_MISMATCH (26), AFE_STALE (27) | indicators; captures abort on stale (§9.2) |
| PARAMS_SAVED / LOADED / DEFAULTED (28–30), NVM_ERROR (31) | parameter re-read where values may have changed; LOADED/DEFAULTED → `ThresholdManager.recheck()` (session values reset by DEFAULT); NVM error text |
| CLK_FALLBACK (32) | warning indicator (SD-10) |
| DRIVER_POWER (33, arg 1/0) | indicator `drv_pwr`; 0 → motion refused (DRV_UNPOWERED), HOMED cleared by FW (D-29 c) → `terminate_all("DRV_POWER_LOST")`, `resync()`; 1 → hint "Enable, then Home" |
| NOT_SETTLED (34) | warning event "PEND not active n ms after the last pulse" (no reaction, D-16) |
| unknown code | logged, ignored (ICD §0.2) |

### 5.6 Gates (`core.gates`, pure functions of a `GateSnapshot`)

`GateSnapshot` = link state, compat, latest DATA flags (age), GET_STATUS latches/inputs, ParamStore,
threshold state, SW-limit input validity, operation owner, calibration/tare state, recording state.
Each gate returns `GateResult(items: list[GateItem(code, severity REFUSE|CONFIRM|WARN, text, clear_hint)])`.

`GateId` (StrEnum) lists every precomputed gate; `status().gates: Mapping[GateId, GateResult]` is rebuilt
with every status snapshot (≥ 10 Hz). The REFUSE items mirror the FW BLOCK mask (ICD §4.3) so the GUI greys
a control before the FW would NACK it; the FW stays the authority. GRQ-B-01: all gates requested by D are
provided.

| Gate | REFUSE items (any) | CONFIRM / WARN |
|---|---|---|
| `move`, `jog` (`motion_gate(kind, owner)`) | not connected / DEGRADED / LOST; compat major/payload mismatch; feature `MOTION` missing; stream off or DATA > 500 ms old; NOT_ENABLED / ENABLING; not homed (`move`; `jog` with bound); ESTOP (latched or input open), HALT, any FAULT latched, **PAUSED** (D-30; hint "Resume clears PAUSE"); LIMIT toward an active/latched switch (direction-aware); AFE stale or saturated; DRV_UNPOWERED; DRIVER_ALARM (ALM + power, D-28); thresholds not verified (SAF-SW-002); an enabled SW load limit without valid input (SAF-SW-001; not in no-specimen mode); owner conflict; SW-limit trip active in the commanded direction (§6.1); hotkey test running | WARN SAF-SW-006 margin; WARN no-specimen mode; WARN travel calibration differs (§9.3.1) |
| `home` | as `move` without NOT_HOMED/LIMIT (the FW homing handles the switches; homing only at START, D-29 b); feature `HOMING` | CONFIRM if abs(F) ≥ 5 % FS **or** load unknown (no calibration/tare, AFE synthetic) → HOME carries the confirmed flag (SAF-SW-004, SAF-FW-021) |
| `enable` | ESTOP latched / input open; DRV_UNPOWERED; read-only compat | – |
| `disable` | moving / stopping | CONFIRM "specimen unloaded?" (SAF-SW-004) |
| `pause` | not connected; read-only compat | WARN "no motion running — sets PAUSED only" when idle and no sequence |
| `resume` | FW PAUSED = 0 and no sequence PAUSED; HALT, ESTOP or a fault latched (the FW would refuse RESUME, D-31); feature/compat as `move`; sequence: the `move` gate for the step's motion kind refuses (the PAUSED item ignored) | – |
| `clear_stop` | nothing to clear (no HALT, no PAUSED); STOP button active (STATUS io) | CONFIRM "ends the paused sequence — use Resume to continue it" while a sequence is PAUSED (D-31, SWD-P1-02 c) |
| `estop_clear` | E-stop input still open (STATUS io) / closed < `io.estop_release_ms` | CONFIRM "button released; driver stays disabled; Enable and re-home" |
| `fault_clear` | no fault latched | WARN per fault whose cause is still present (FW will refuse) |
| `stream_start` / `stream_stop` | not connected / already in that state; `stream_stop`: moving or an operation running (PC limits need data) | – |
| `record_start` / `record_stop` | `record_start`: already recording, folder not writable, free space < limit; `record_stop`: not recording or the recording belongs to a running sequence | WARN marks incomplete (specimen/number empty, Q27 default: warning only) |
| `sample` | stream off; another SAMPLE capture running | WARN not recording (goes to the daily samples file) |
| `tare` | SW-TARE-003 list (§9.5); AFE synthetic | WARN large offset (after the capture) |
| `config_write` | not connected; `PARAM_HASH_MISMATCH` / read-only compat; any operation running; (per key) moving and key without `moving_ok` | WARN REBOOT_PENDING / reboot-required keys |
| `cal_travel_start` | `move` gate; another operation; SW-limit room for 2 + 10 + 50 mm in + direction | CONFIRM "no specimen mounted" if load unknown (D-29 h: allowed in no-specimen mode) |
| `cal_load_start` | not connected; stream cannot start; another operation; AFE synthetic; AFE stale | WARN existing active calibration will be replaced on accept |
| `sequence_start` | SW-SEQ-005 list (§10.3), each with its own item and text: not homed / not enabled; any latch (ESTOP, HALT, FAULT, LIMIT); **PAUSED** ("Resume or Clear stop first"); **POS_UNCERTAIN** ("re-home: the position may be off by one step"); **AFE_RATE_MISMATCH** ("HX711 rate differs from the configuration"); **ALM active** ("driver alarm"); **DRV_PWR off** ("driver unpowered") (D-33 b, SWD-P1-04/08); LOAD steps in no-specimen mode; feature `MOVE_UNTIL_LOAD` missing with LOAD steps | CONFIRM HOME steps under load; CONFIRM **"Pause/Break key unavailable"** when the hotkey is not active (GQ-09/Q27 default); CONFIRM travel-only sequence in no-specimen mode; WARN margin, LOW_SPAN, extrapolation, travel calibration differs |
| `sequence_edit` | a sequence is running or PAUSED | – |
| `valid_toggle` | not connected; a sequence runs (SW-SEQ-004) | – |
| `test_zero` | not homed (`set_test_zero`); moving; a sequence runs (x_zero frozen) | – |
| `no_specimen` (enter) | moving; an operation runs | CONFIRM C-10 text (§6.7) |
| `hotkey_test` | moving; an operation runs; hotkey unavailable | – |

Gate item codes (GF-11): an item that mirrors a FW BLOCK condition uses **exactly the generated
`protocol_gen.BLOCK_BITS` name** (`ESTOP`, `HALT`, `FAULT`, `NOT_ENABLED`, `NOT_HOMED`, `LIMIT`,
`AFE_STALE`, `AFE_SATURATED`, `DRV_UNPOWERED`, `DRIVER_ALARM`, `PAUSED`); an item mirroring a DATA status
bit without a BLOCK counterpart uses the generated `DATA_STATUS_BITS` name (`POS_UNCERTAIN`,
`AFE_RATE_MISMATCH`, …); SW-only items use names that never collide with generated ones (`LINK_DOWN`,
`COMPAT_READ_ONLY`, `FEATURE_MISSING`, `STREAM_STALE`, `THRESHOLDS_UNVERIFIED`, `LOAD_INPUT_INVALID`,
`OWNER_CONFLICT`, `SW_TRIP`, `HOTKEY_TEST`, `NO_SPECIMEN_MODE`, `TRAVEL_CAL_DIFFERS`, `SAF_SW_006_MARGIN`, …;
the full list is the `GateCode` StrEnum in `core.gates`, which a unit test checks for collisions with
`protocol_gen`).

Confirmation tokens: the GUI shows the CONFIRM text and calls the action with `confirmed=True` (also
`sequencer.start(seq, confirmed=True)`, GF-14); `confirmed=True` confirms the CONFIRM items of the gate
result **as evaluated at the call** — if a new CONFIRM item appeared since the dialog, the call raises
`ConfirmationRequired` with the new items; the backend refuses a CONFIRM-gated action without it (Enter/Space
handling and STOP-in-dialog are D's, SAF-SW-004).

---
## 6. Safety supervisor (`core.safety`) — SAF-SW-001..006

### 6.1 Per-frame evaluation (SAF-SW-001)

`SafetySupervisor.process(batch)` runs in the Pipeline thread after scaling, **for every sample in time
order**. Configuration (`LimitConfig`, session file, SW-LIM-001..003; edits refused while moving):

| Limit | Fields | Default |
|---|---|---|
| Travel min / max | `travel_min_mm`, `travel_max_mm` (machine mm), each `enabled`; must lie inside the FW soft limits | disabled until set (FW soft limits always active) |
| Pull max | `pull_trip_n` (> 0), `enabled`, `warn_pct` | +100 % FS (1961.33 N), enabled, warn 90 % (A-15) |
| Push max | `push_trip_n` (< 0), `enabled`, `warn_pct` | −100 % FS, enabled, warn 90 % |
| FW load-limit level | `fw_level_n` (≤ 110 % FS = 2157.46 N, ≥ the largest enabled SW trip magnitude) | 110 % FS (SW-LIM-002) |
| No-specimen mode | `no_specimen_mode` (session-only, never in the session file; ends at disconnect / exit) | off (§6.7, SW-LIM-004) |

Disabling the pull or push limit individually is allowed only while the load input is valid (calibration +
tare); without a valid input the only way to move with the SW load limits off is no-specimen mode (D-29 h).

Rules per sample (pure functions `calc.limits.*`; the supervisor adds state and actions):

1. **Load**: with a valid input (active calibration matching the AFE config, a tare, raw state OK or
   SETTLING) `F = K·(raw − tare_raw)`; trip if `F > pull_trip_n` or `F < push_trip_n` (enabled sides). A
   **saturated** sample counts as `±∞` with sign `sign(K)·sign(rail)` (overload, never "no data").
   Warning edge when `|F| ≥ warn_pct·|trip|` (hysteresis 2 % of the trip level) → `safety.warning` event and
   indicator.
2. **Load input invalid** while a load limit is enabled (no calibration/tare, AFE-config mismatch — D-29 l,
   NO_AFE_DATA fallback frame, AFE stale/fault flag, AFE synthetic): if moving → STOP (reason
   `LOAD_INPUT_INVALID`); the motion gate refuses new motion (SAF-SW-001 last sentence). In no-specimen mode
   (§6.7) the SW load limits are off, so this rule does not apply.
3. **Travel** (enabled, axis homed): `x = setpoint_um/1000` (exact commanded position). JOG and MOVE_ABS
   cannot pass an SW limit because targets are checked and JOG carries the limit as `bound_um` (§5.4; the FW
   stops exactly there); MOVE_UNTIL_LOAD bounds are never beyond an enabled SW limit (§10.4, D-33 d). As a
   second layer against a FW defect: (i) while the running command's end point (`target_um` of MOVE_ABS, JOG
   `bound_um`, MOVE_UNTIL_LOAD `bound_um`, as sent) lies inside the enabled limits, the trip fires only when
   the commanded position itself passes the limit by more than one step (`x` beyond limit + 1/spm) — a
   planned deceleration onto a bound that equals the limit is **not** a trip (D-33 d: reaching the bound is
   NOT_REACHED, not a limit trip); (ii) for motion without such an end point (un-bounded JOG, homing) the
   predicted position `x_pred = x + v_cmd·t_lead` (`v_cmd` from consecutive setpoints and `t_us`,
   `t_lead = 75 ms`) crossing a limit in the direction of motion trips. A position outside a limit at
   standstill (limit edited) is no trip, but the gate refuses motion further outside.
4. **Direction-aware latch** `SwTrip(limit_id, side)`: after a trip, motion that **increases** the violation is
   refused, motion that reduces it is allowed (unloading, moving back), mirroring SAF-FW-011. A load-side
   direction uses `pull_dir` (session, +1/−1, SRS §5.2): `Δx·pull_dir > 0` increases tension. The latch clears
   automatically when the value is back inside the trip level by the hysteresis band.

### 6.2 Trip action and latency

Order (KD-05): (1) `PrioritySender.stop(IMMEDIATE, "SW_LIMIT:<id>")`, (2) `OperationRegistry.terminate_all`
(sequence/wizard motion terminated), (3) latch + indicator, (4) event `SAFETY_TRIP {limit, value, threshold,
t_us}` → recorder event row and log. Budget from reception of the violating frame (Reader stamp) to the STOP
write (`wire_log`): Reader dispatch ≤ 1 ms + Pipeline wake-up ≤ 1 ms + per-frame processing ≤ 1 ms + writer
wait ≤ 3 ms ≈ **≤ 6 ms typical**; requirement **≤ 50 ms p95** (SAF-SW-001), margin covers GIL/GC pauses
(GUI GC policy, D). Verified by the simulator perf test (100 injected violations).

### 6.3 FW load-threshold manager (`ThresholdManager`) — SAF-SW-002, D-12

- **Compute** (`calc.loadcal.fw_raw_limits`, R4 §4.4, rounding toward the tare): `(raw_min, raw_max) =
  fw_raw_limits(f_hi=+fw_level_n, f_lo=−fw_level_n, k=K, tare_raw)`; `zero_raw = round_half_away(tare_raw)`.
- **Check**: `fw_level_n ≤ 110 % FS` (2157.46 N) and ≥ the enabled SW trip magnitudes (SW-LIM-002) —
  violations are refused at edit time (`limits.set` issue), never written. **Clamp inward (D-29 g, SAF-SW-002 v0.3,
  F-B-07 closed)**: a computed raw value outside the dictionary range ±7 151 121 counts (SAF-FW-010; happens when
  `|K|` is below nominal) is clamped to the range end on its side, which can only make the FW trip *earlier*
  in force; state `VERIFIED` with `clamped = True` and a warning event/indicator text "FW load limit clamped:
  effective +a N / −b N" (`F_eff = K·(raw_clamped − tare_raw)`). Only if clamping leaves
  `raw_min ≥ raw_max` or `zero_raw` outside its range (tare beyond the cap — not physical) → `INVALID`,
  motion disabled.
- **Write** (CONTROL lane, idle only): order keeps H2 `raw_min < raw_max` after each SET (new min < current
  max → min first, else max first), then `zero_raw`; **read-back** (GET_PARAM ×3) compared exactly →
  `VERIFIED(cal_id, tare_id, fw_level_n, raw_min, raw_max, zero_raw, clamped)`. NACK/timeout/mismatch →
  `FAILED`, motion disabled, event; `recheck()` retries (also public: `limits.recheck_async()`, GRQ-B-04).
- **Triggers**: connect/reconnect, EVENT BOOT, calibration activated, tare done/undone, FW level edited,
  no-specimen mode entered/left, PARAMS_LOADED/PARAMS_DEFAULTED (DEFAULT resets the session values, ICD
  §11.5), `write_and_verify` touching `motion.steps_per_mm`/`afe.*`, every `read_all_params` (consistency
  check). Calibration accept, tare and limit edits are refused while moving, so thresholds never lag a
  running move.
- **No calibration or no tare** (outside no-specimen mode): state `DEFAULT_ONLY` (dictionary defaults
  ±7 022 271 and `zero_raw` 0 written and verified); with any SW load limit enabled the motion gate refuses
  ("calibrate + tare, or enter no-specimen mode", §6.7).
- **No-specimen mode** (§6.7, SW-LIM-004, Orchestrator decision): the ThresholdManager behaves exactly as
  outside the mode — with a valid calibration + tare it keeps writing the **calibrated** thresholds
  (`VERIFIED`); only without them the FW thresholds stay at the nominal defaults (`DEFAULT_ONLY`, never
  widened). The mode switches off only the PC's own load trips.
- Motion gate item: `thresholds.state == VERIFIED` and its ids equal the active calibration + tare, **or**
  `DEFAULT_ONLY` verified while in no-specimen mode without a valid calibration + tare.

### 6.4 Link loss and liveness (SAF-SW-003) — see §4.6

DATA gap > 500 ms while moving → priority STOP + `terminate_all("LINK_LOST")` + indicator LINK LOST;
heartbeat gated by liveness; FW watchdog (`safety.link_timeout_ms`, default 1 s, controlled stop) is the
backstop when the PC side is dead. A configured `safety.link_timeout_ms` < 750 ms raises a config WARN
("not robust against lost heartbeats", ICD §9.2).
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
