HawortiaCooper/Bird.Bend_Stend/01_HW/diagrams/bench/B2_multimeter_points.png

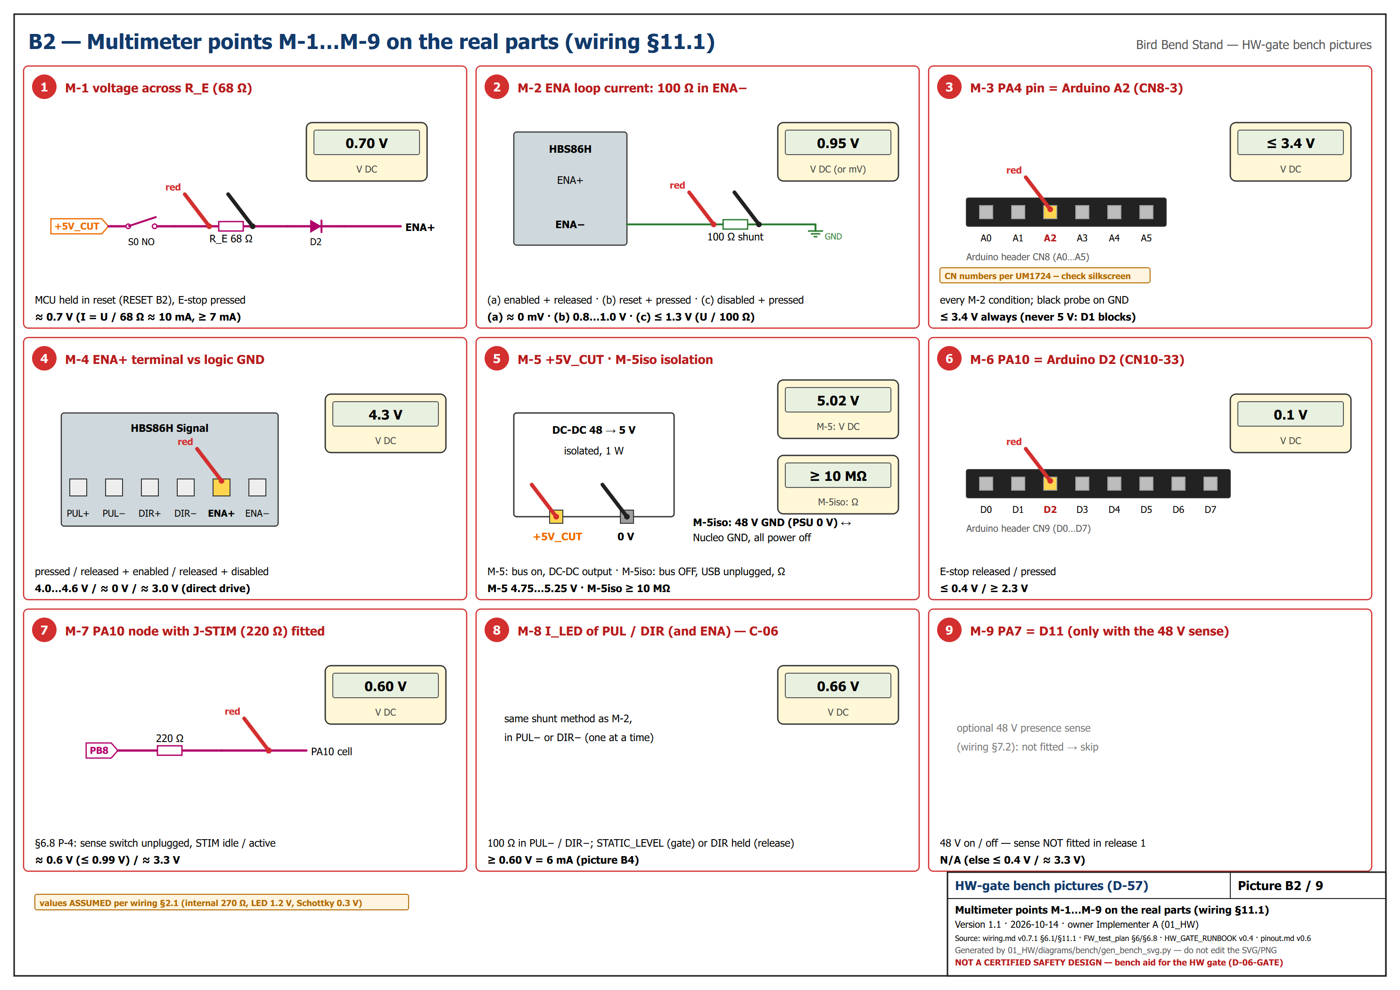
01_HW/diagrams/bench/B2_multimeter_points.png
