HawortiaCooper/Bird.Bend_Stend/01_HW/diagrams/bench/B3_jstim_stimulus.png

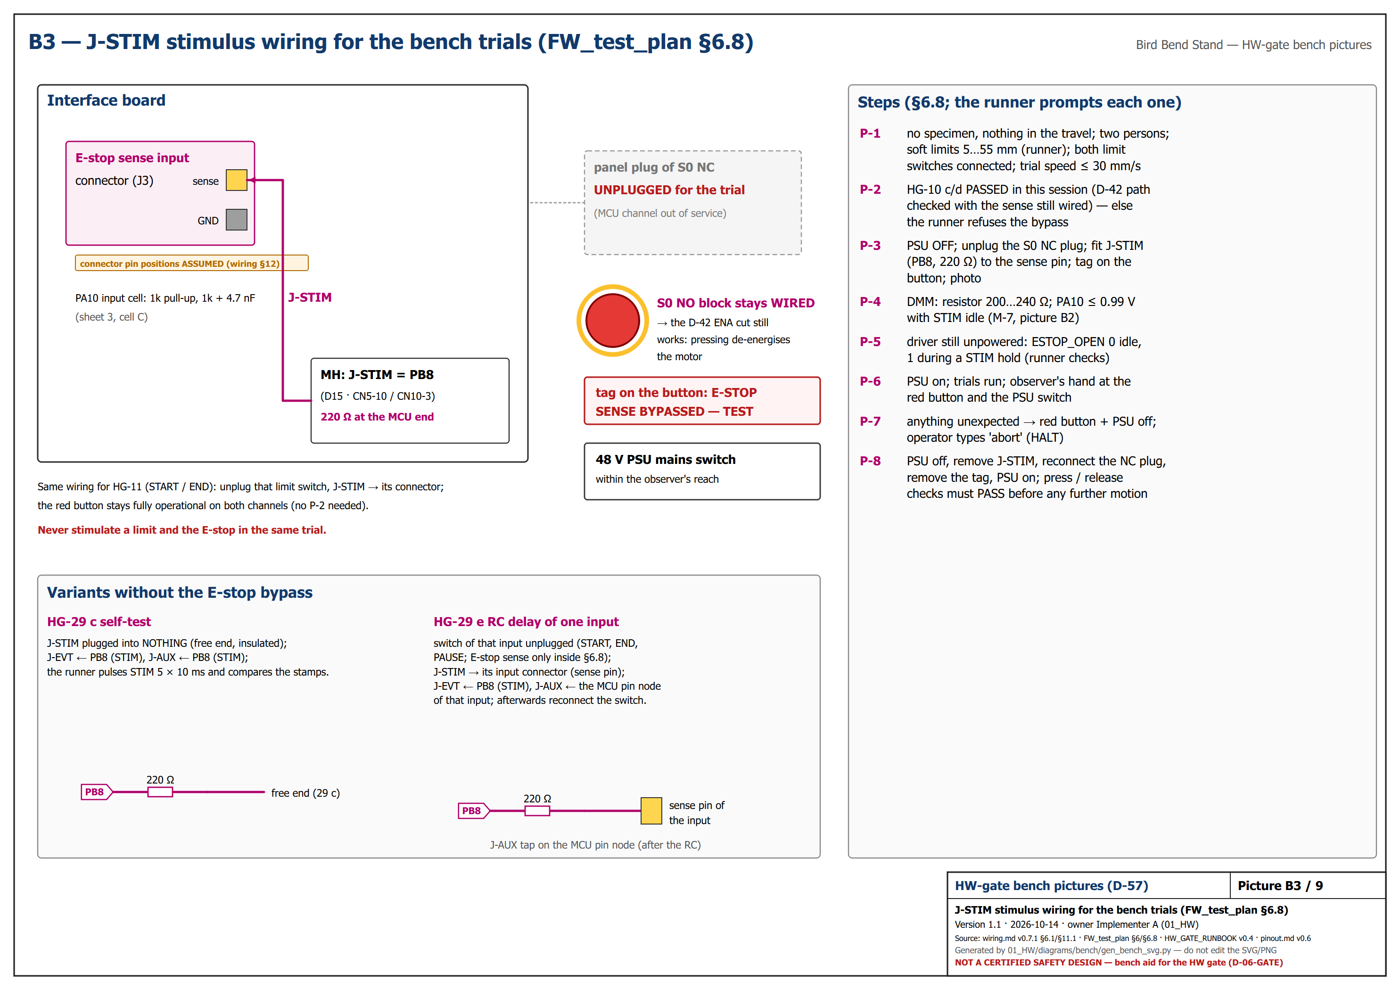
01_HW/diagrams/bench/B3_jstim_stimulus.png
