HawortiaCooper/Bird.Bend_Stend/01_HW/diagrams/bench/B4_hg06_shunt.png

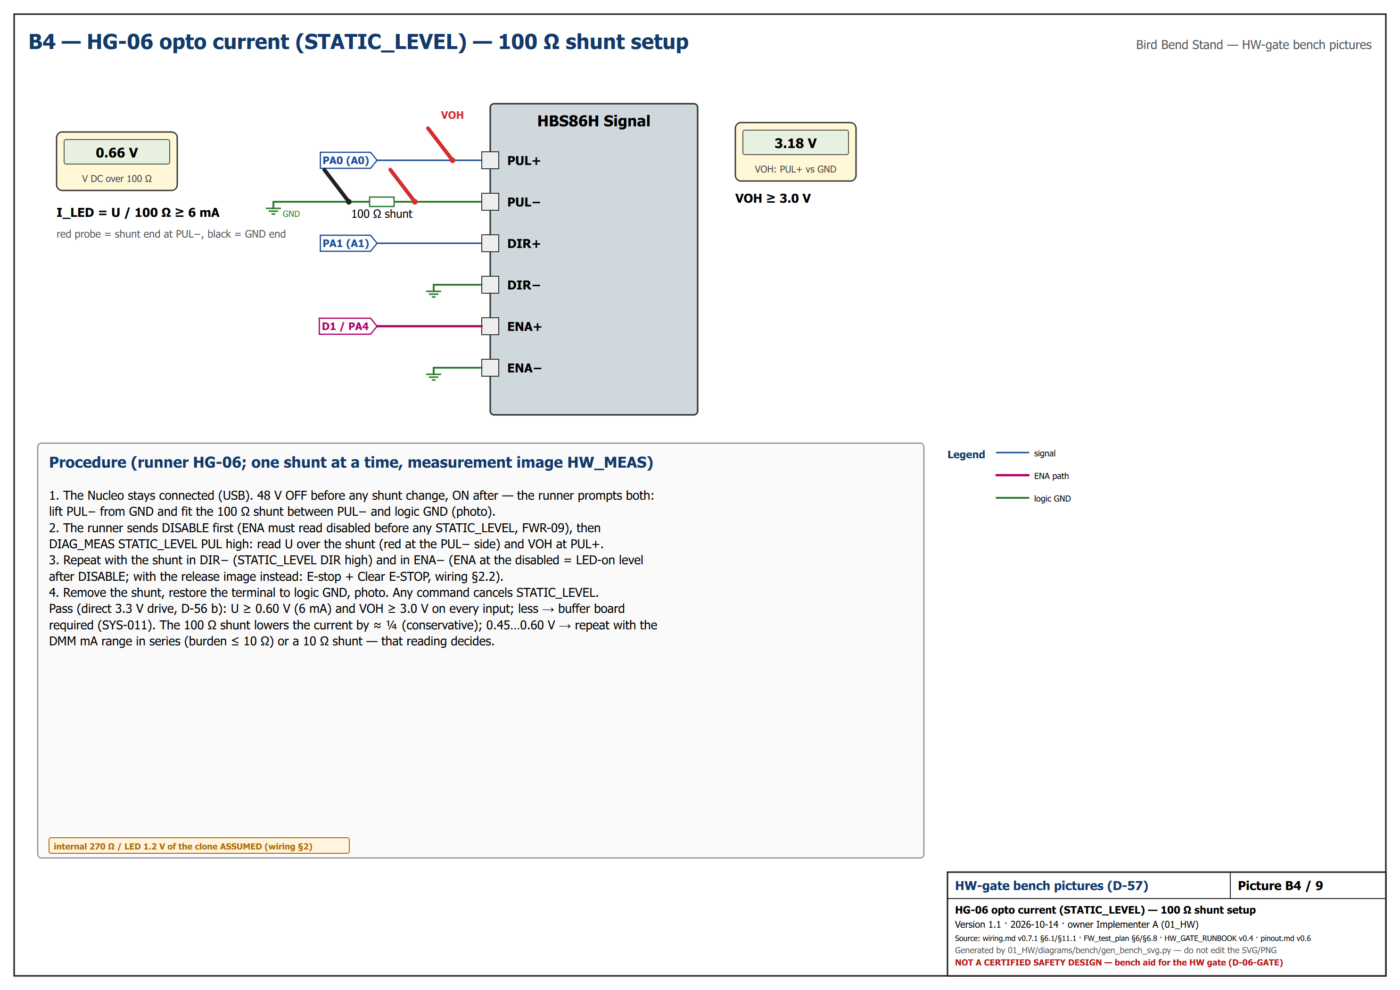
01_HW/diagrams/bench/B4_hg06_shunt.png
