HawortiaCooper/Bird.Bend_Stend/01_HW/diagrams/bench/B5_flash_gate_images.png

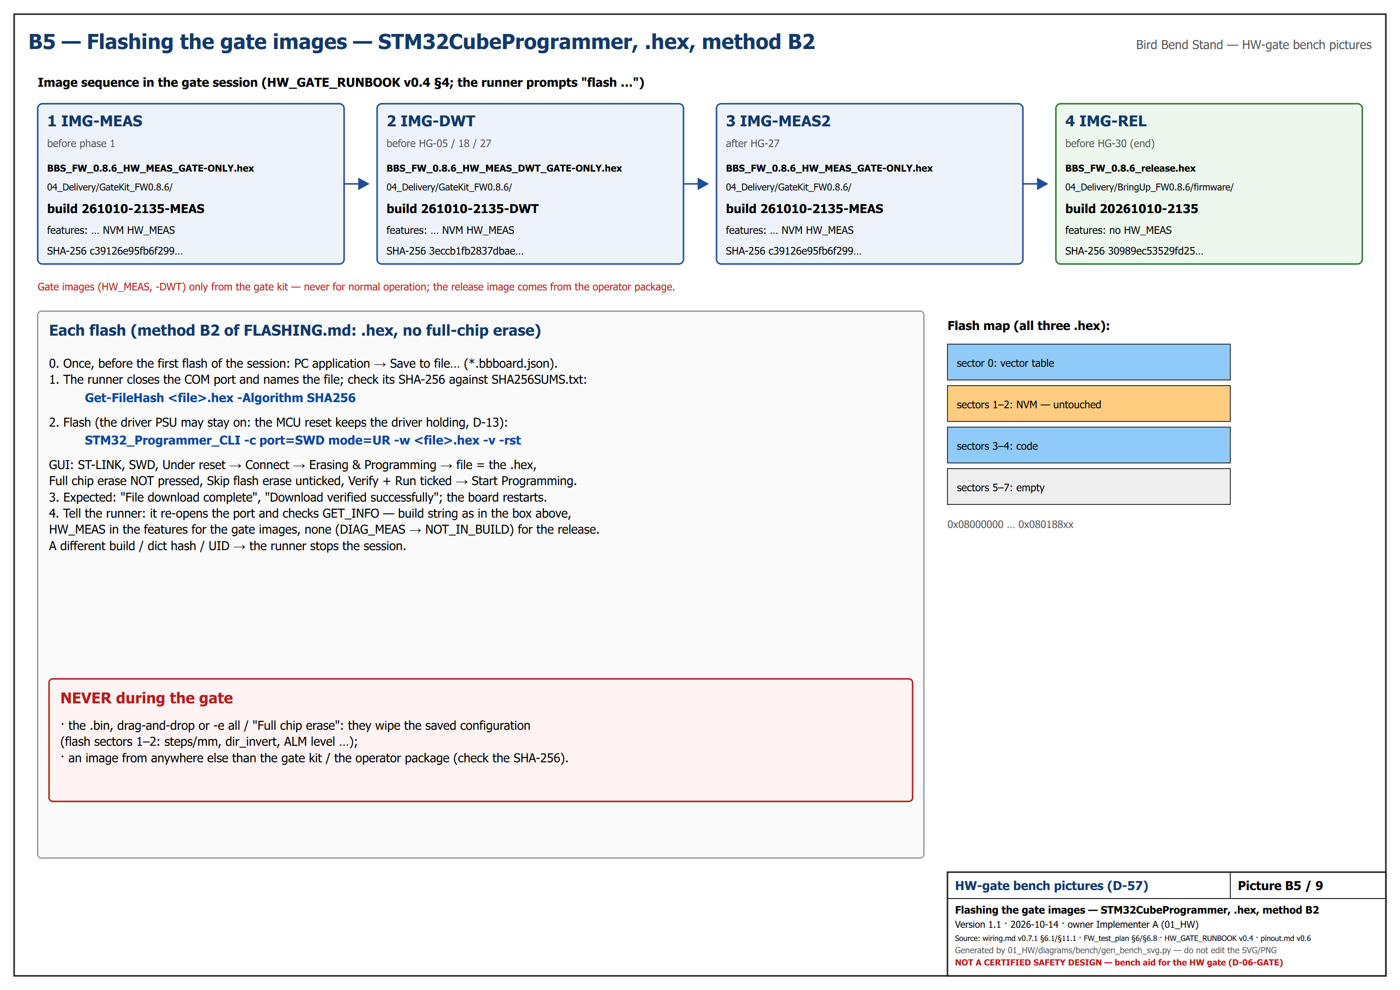
01_HW/diagrams/bench/B5_flash_gate_images.png
