HawortiaCooper/Bird.Bend_Stend/01_HW/diagrams/bench/B6_hg10cd_hg17_reset_estop.png

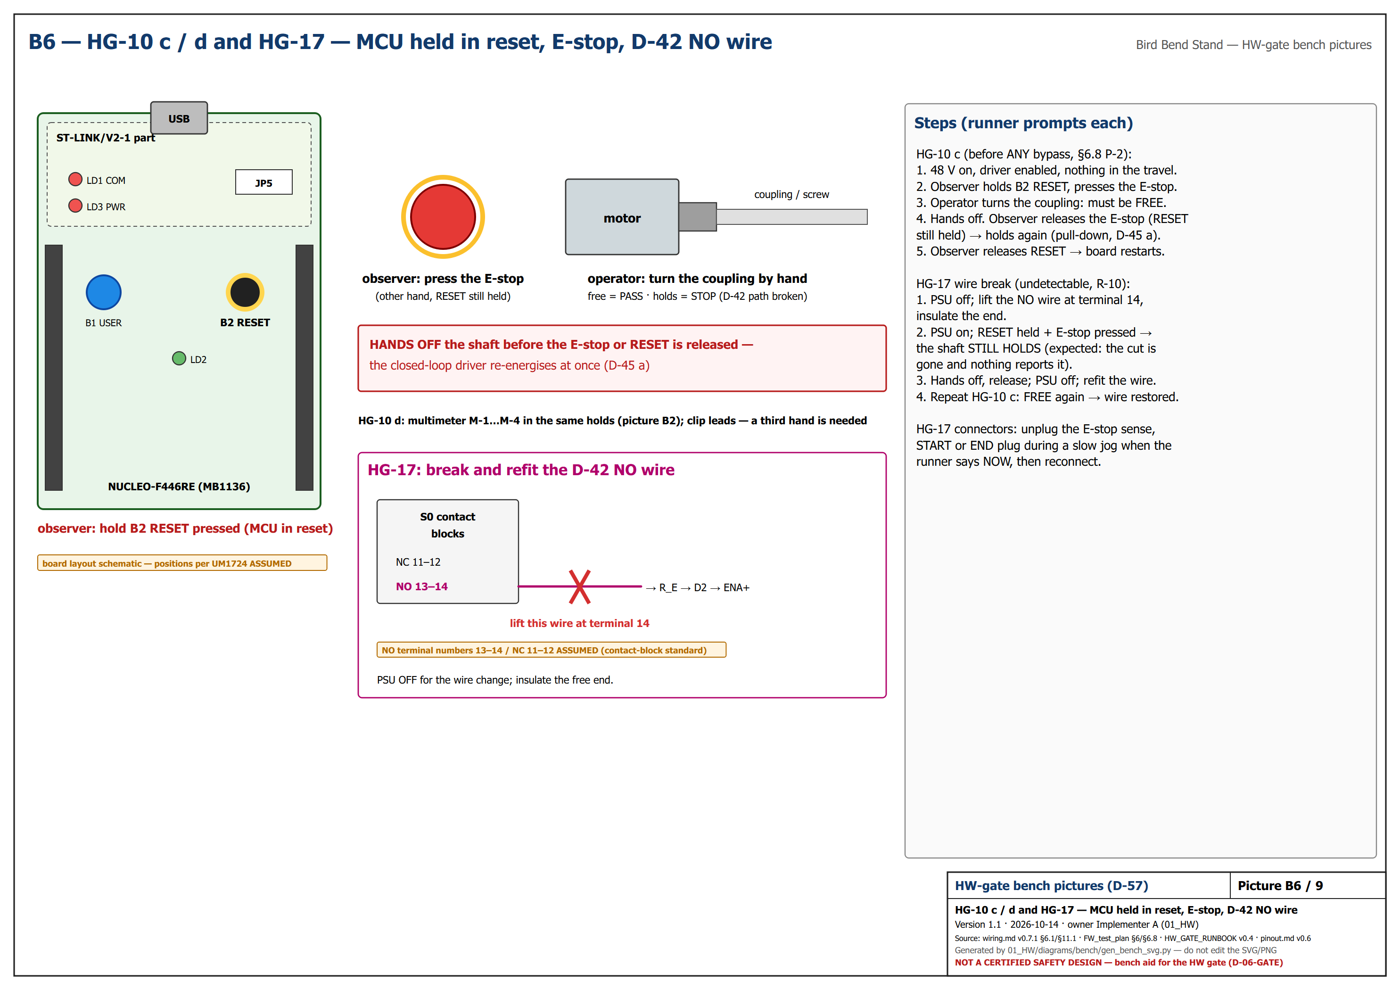
01_HW/diagrams/bench/B6_hg10cd_hg17_reset_estop.png
