HawortiaCooper/Bird.Bend_Stend/01_HW/diagrams/bench/B7_nucleo_reset_power.png

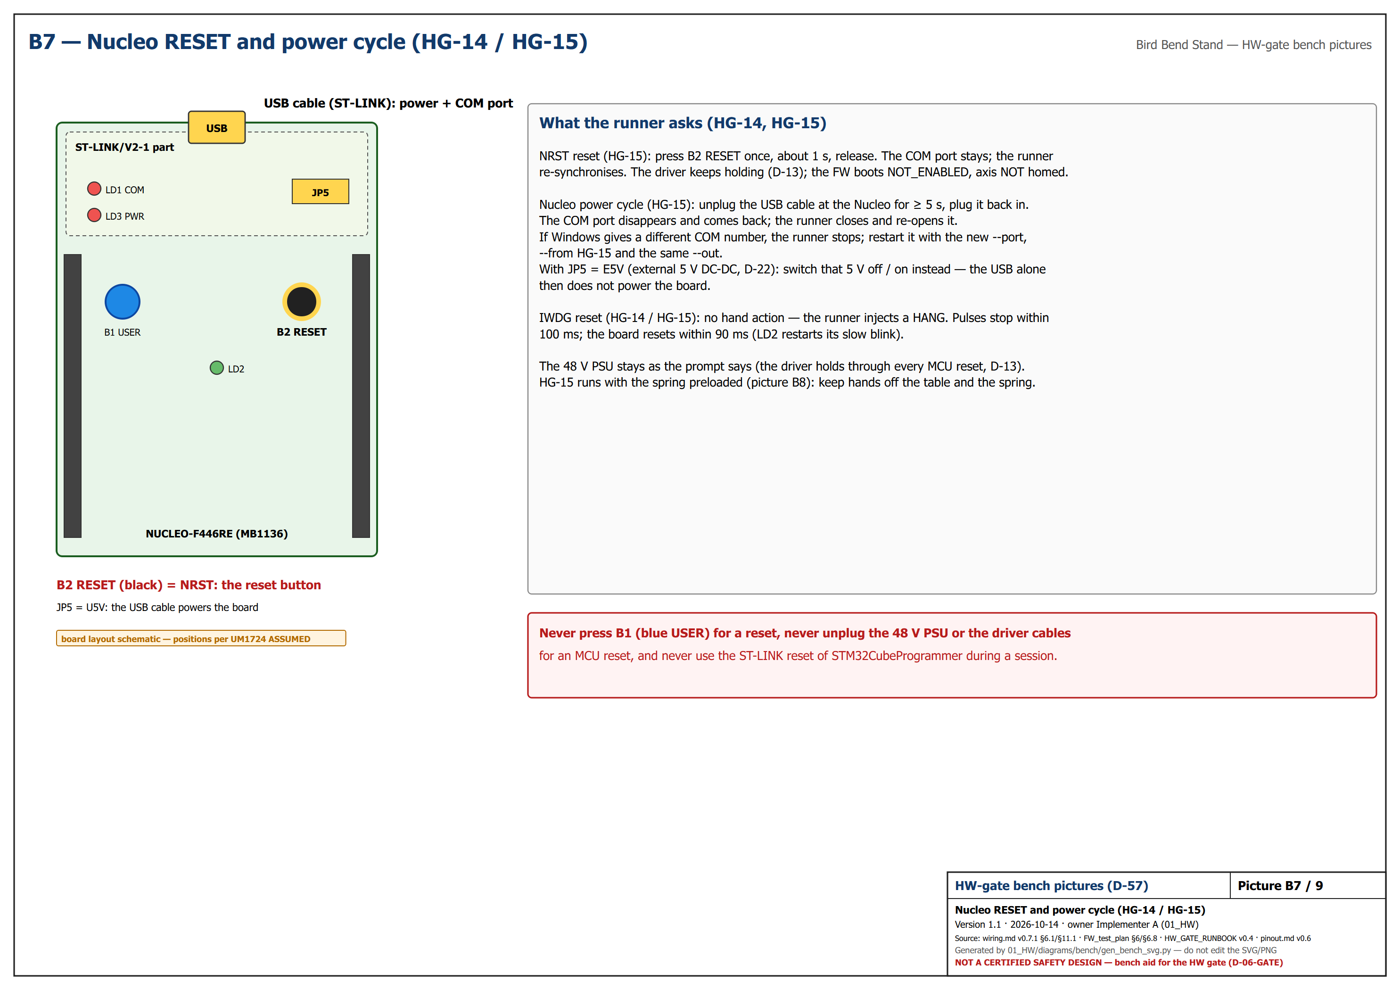
01_HW/diagrams/bench/B7_nucleo_reset_power.png
