HawortiaCooper/Bird.Bend_Stend/01_HW/diagrams/bench/B8_spring_dial.png

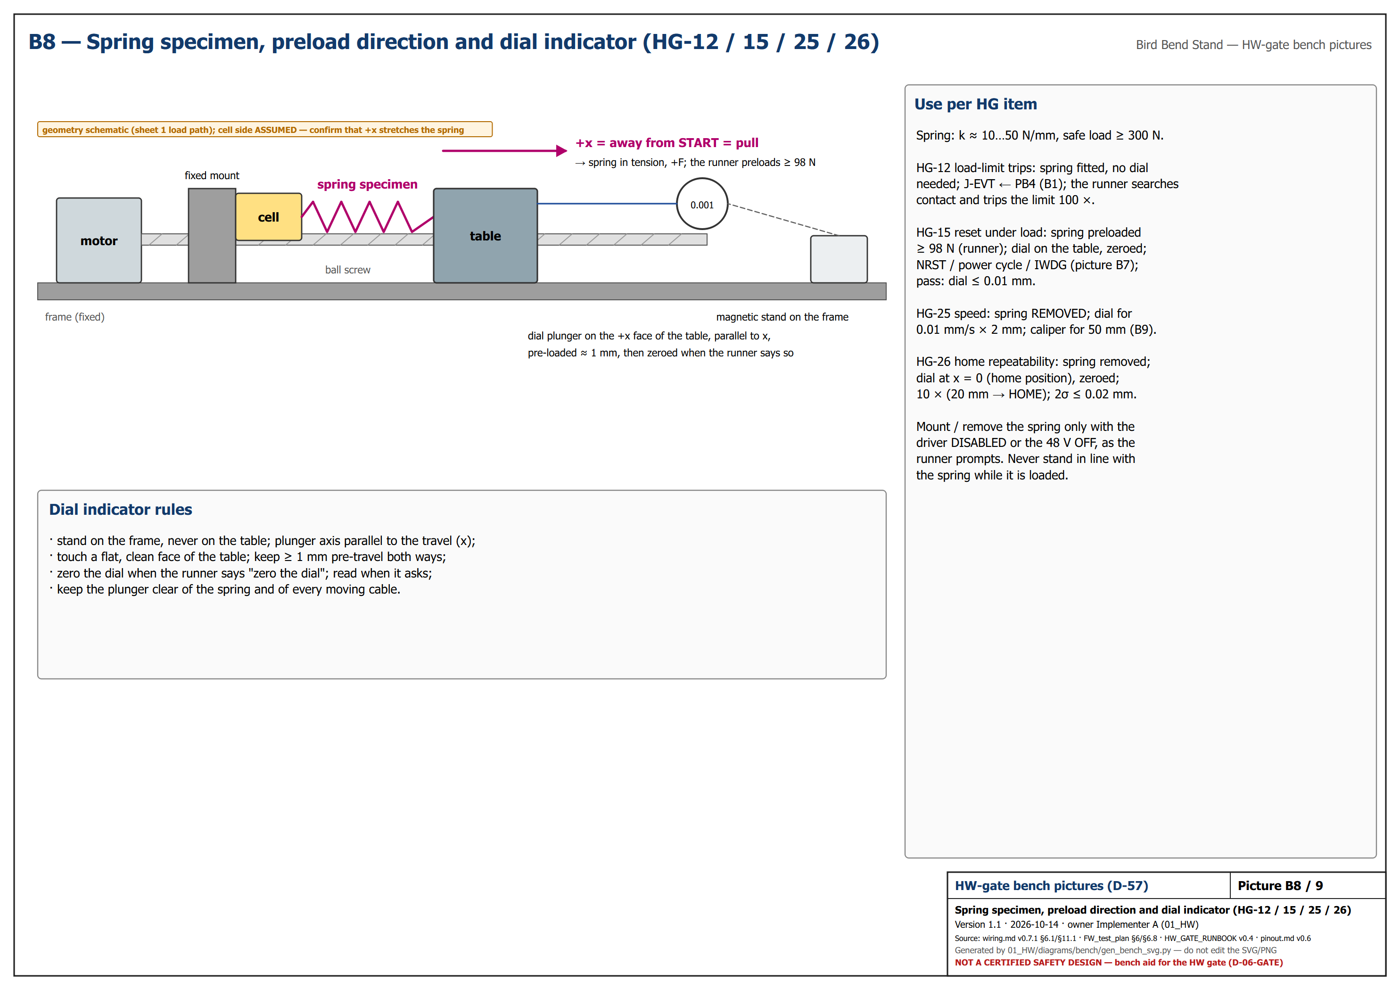
01_HW/diagrams/bench/B8_spring_dial.png
