HawortiaCooper/Bird.Bend_Stend/01_HW/diagrams/bench/B9_caliper_reference.png

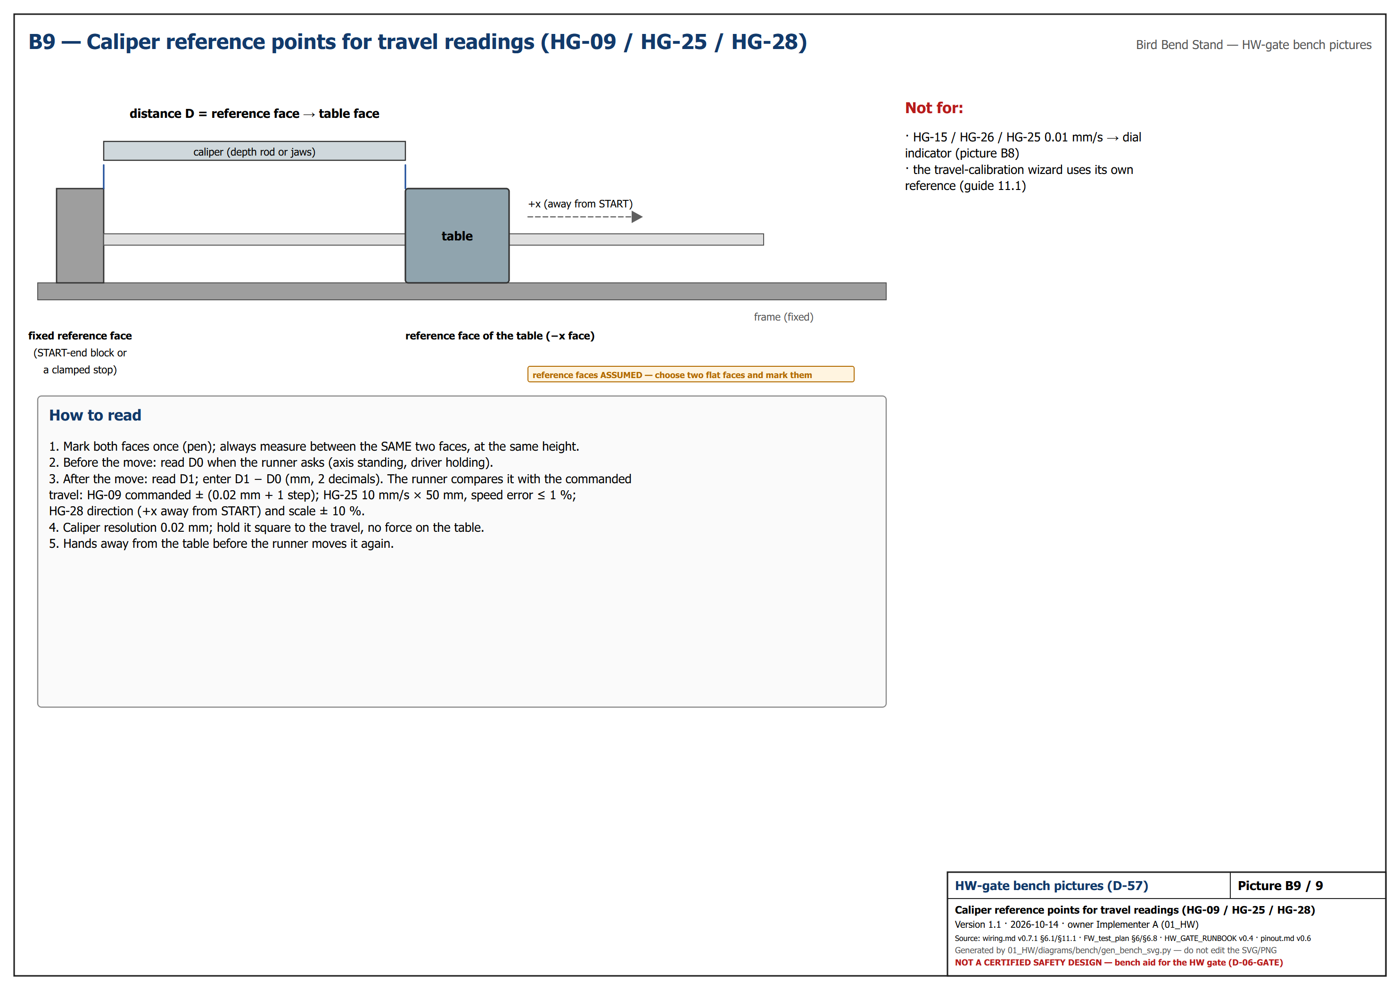
01_HW/diagrams/bench/B9_caliper_reference.png
