HawortiaCooper/Bird.Bend_Stend/01_HW/diagrams/sheet1_system_overview.png

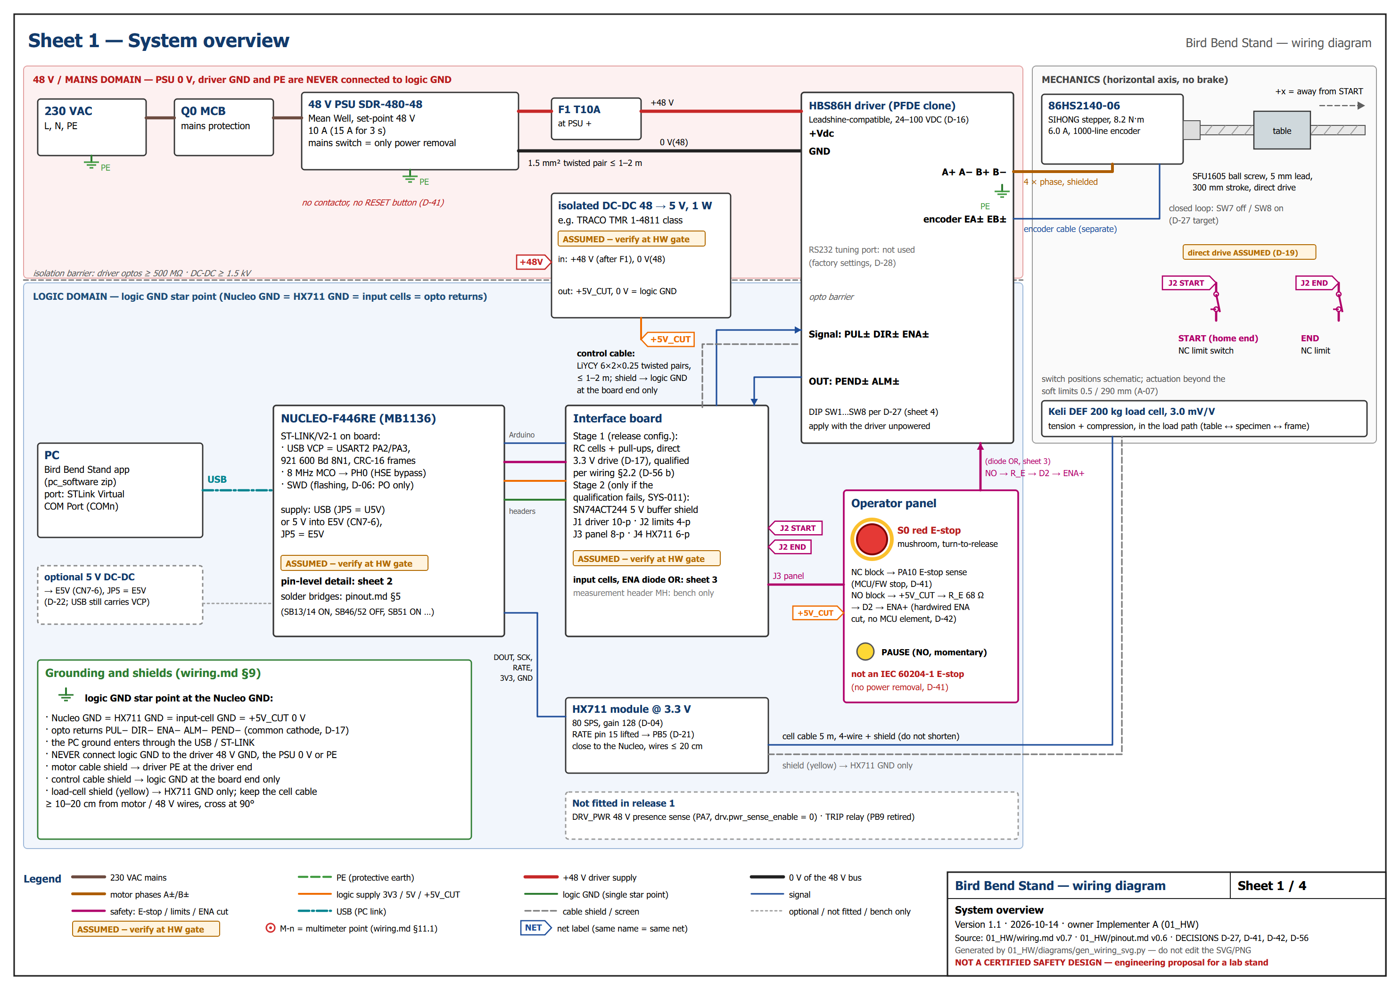
01_HW/diagrams/sheet1_system_overview.png
