HawortiaCooper/Bird.Bend_Stend/01_HW/diagrams/sheet2_nucleo_pins.png

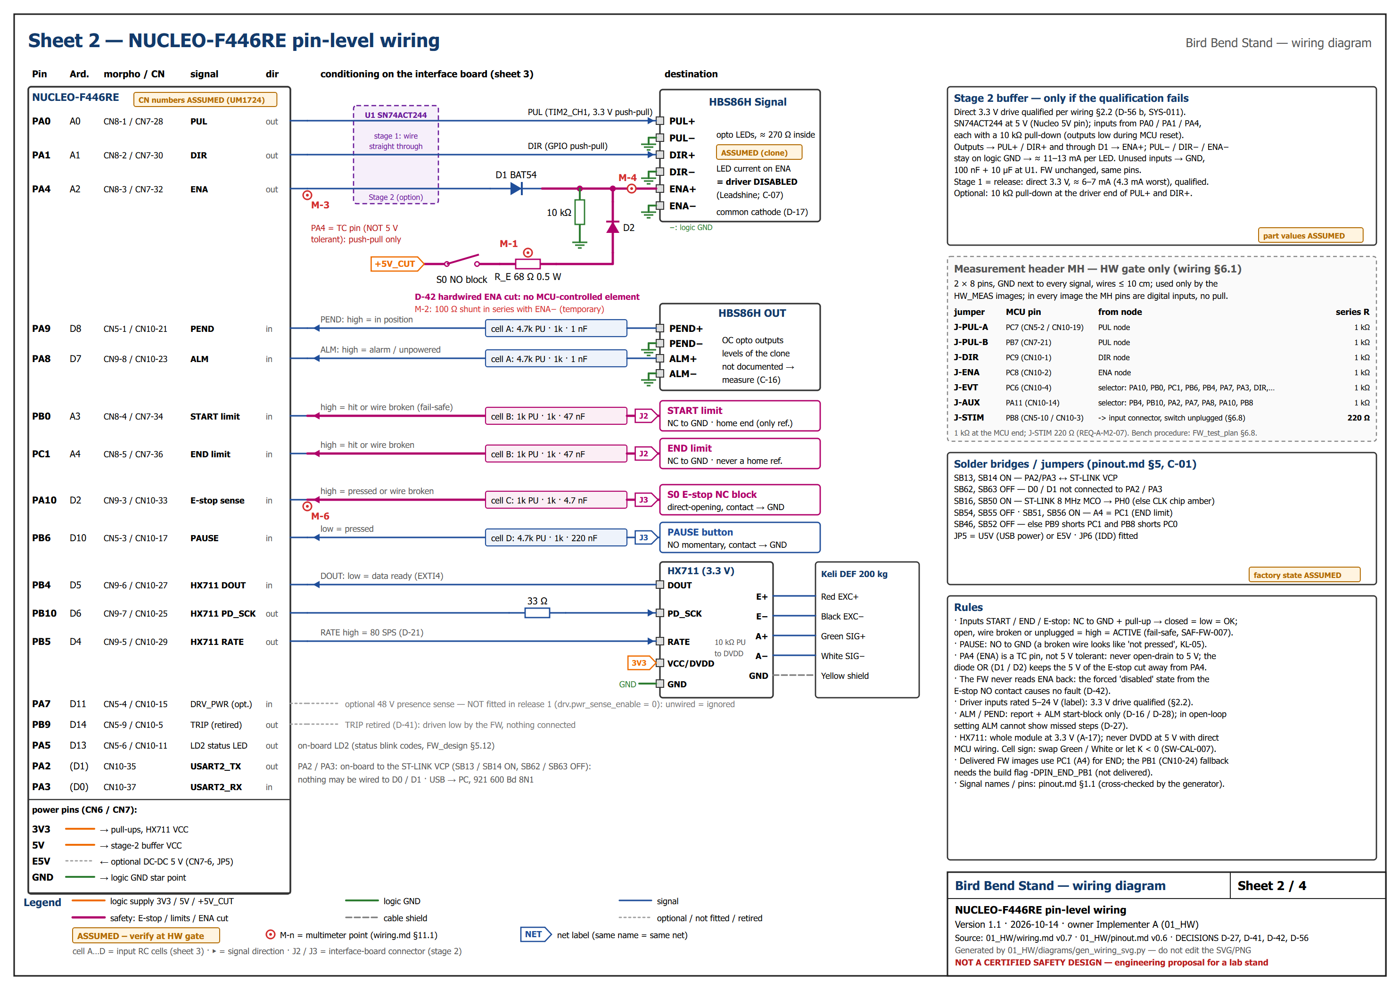
01_HW/diagrams/sheet2_nucleo_pins.png
