HawortiaCooper/Bird.Bend_Stend/04_Delivery/BringUp_FW0.8.6/firmware/BUILD_INFO.txt

Bird Bend Stand - firmware delivery BUILD_INFO
============================================================
Release label (FW_design version) : 0.8.6
Git commit                        : 5eb2755f71f596ffa5b276589083bbac9da83e60
GET_INFO fw_version (wire)        : 0.8.6   (shown as 'FW 0.8.6' in the PC app)
Source tree                       : clean clone of commit 5eb2755 (git status clean); rebuilt 2026-10-14, images byte-identical to the files shipped from the pre-commit tree (ce22533 + the FW 0.8.6 change that 5eb2755 commits)
ICD                               : 0.7.5
PROTO_VERSION / PAYLOAD_VERSION   : 1.0 / 1
PARAM_DICT_HASH / version / count : 0xF8BCDCB8 / 6 / 48
SOURCE_DATE_EPOCH                 : 1791668154 (2026-10-10 21:35 UTC; build-id time, reproducible)
Packaging date                    : 2026-10-14
Toolchain                         : PlatformIO Core, version 6.2.0; platform ststm32@20.0.0, framework-arduinoststm32@4.30000.0,
                                    toolchain-gccarmnoneeabi@1.120301.0 (arm-none-eabi-gcc.exe (xPack GNU Arm Embedded GCC x86_64) 12.3.1 20230626)
HEX / BIN conversion              : GNU objcopy (xPack GNU Arm Embedded GCC x86_64) 2.40.0.20230627; bin gap fill 0xFF

[release]  env nucleo_f446re
  purpose            : release image - normal operation
  GET_INFO build     : 20261010-2135   (git 5eb2755f)
  features (PC app)  : AFE BUTTONS DRV_SIGNALS HOMING MOTION MOVE_UNTIL_LOAD NVM
  flash / static RAM : 47780 B / 8824 B (+ 4096 B main-stack reserve)
  flash ranges (HEX) : 0x08000000-0x080001C3, 0x0800C000-0x080178DF  -> sectors [0, 3, 4]; sectors 1-2 (NVM) untouched by the HEX
  BBS_FW_0.8.6_release.bin                     sha256 5e5a238683d59864399d08b6743a440d4a6088d024f1dc9938357f03d70034b2
  BBS_FW_0.8.6_release.hex                     sha256 30989ec53529fd252a20c5ff7e5a4bf780d126b94ca919439eb282502ebddbc0
  firmware.elf (not delivered)       sha256 a81deefa8f2afd8892747dac5cd90c5e07083078867852ef17639a3c10ae016c
  reproducible       : yes - two independent clean builds, identical ELF/BIN/HEX

Checks at packaging: PlatformIO check_map.py PASS (nothing linked into the NVM hole 0x08004000..0x0800BFFF);
TC-SYS-009-02 check_meas_build.py PASS (measurement images: core / pure / gen objects and the safety handlers
byte-identical to the release image); FW host suites (implementer + validator, 251 test cases) green.
Note: GET_INFO 'build' = YYYYMMDD-HHMM (gate images YYMMDD-HHMM-MEAS / -DWT) of SOURCE_DATE_EPOCH (UTC) if set, else
the local build minute. The git hash is NOT compiled into the image (it is only reported here), so the same
source tree + toolchain + SOURCE_DATE_EPOCH gives byte-identical images from any commit containing that tree.

Rebuild recipe (Git Bash, PlatformIO 6.2 and the toolchain above; no board needed):
  git clone <repo> bbs && git -C bbs checkout 5eb2755
  export SOURCE_DATE_EPOCH=1791668154
  export PLATFORMIO_BUILD_DIR=<empty private folder>
  for e in nucleo_f446re nucleo_f446re_meas nucleo_f446re_meas_dwt; do pio run -d bbs/02_FW -e $e; done
  python bbs/02_FW/tools/make_delivery.py --build-dir $PLATFORMIO_BUILD_DIR [--compare-build-dir <2nd build>] \
      --out <pkg> --gate-out <gate kit> --label 0.8.6 --commit <full hash>
  then compare with SHA256SUMS.txt (sha256sum -c SHA256SUMS.txt in the image folder).
