HawortiaCooper/Bird.Bend_Stend/02_FW/docs/FW_test_plan.md

# Bird Bend Stand — Firmware test plan

| Item | Value |
|---|---|
| Doc | `02_FW/docs/FW_test_plan.md` |
| Version | **0.4.15** — gate runner v1.1: TC-SYS-009-04 extended (C-GR-1…3, GR-2 / GR-3). **0.4.14** — D-57 gate runner: TC-SYS-009-04 (approval file, results zip, offline analysis, twin rehearsal, data rule); HG-06 prompts the three shunt changes with the 48 V OFF. **0.4.13** — D-56 b / SRS v0.6.8 SYS-011: TC-SYS-011-01 = direct-drive qualification (I_LED ≥ 6 mA ENA / DIR + pulse-integrity re-home; buffer only on failure), HG-23 conditional (N/A without the buffer), HG-06 note; IDs aligned with TC-SYS-011-02 … -04 (SW_test_plan v0.5.7, OI-F-BRU-03). **0.4.12** — re-check of FW v0.8.6 (D-55): TC-FW-MOT-002-03 (target step-ISR entry `step_isr_core(cnt)` vs the seam entry `step_isr()`, same HAL source twice + real core), TC-FW-MOT-003-03 (acc clamp removal, exhaustive float check); TC-SYS-009-02 safety symbol `step_isr_core` (OI-FW-53). **0.4.11** — re-check of FW v0.8.5 (guard 1.5 µs): TC-SAF-FW-004-05 rewritten as a pass/fail guard-margin criterion (anti-vacuity + margin ≥ 2× the conservative target path; OI-FW-52 answered), TC-SAF-FW-002-05 also at the conservative-equivalent bus cost, TC-SAF-FW-004-02 for both guards, guard window 1.5 µs in TC-SAF-FW-004-01 and §6 item 3. **0.4.10** — re-check of FW v0.8.4: TC-SAF-FW-002-05 (CLEAN halt, update in the decision window: FWR-21 reproducer), TC-SAF-FW-004-05 (stop / stretch guard margin, OBS-RC-7); TC-FW-SW-002-01 CRIT_HALT figure aligned with NFR-007 (OBS-RC-6). **0.4.9** — re-check of FW v0.8.3: TC-FW-HOM-001-03 (FWR-20 reproducer), TC-FW-MOT-005-02. **0.4.8** — re-check of FW v0.8.2: TC-FW-HOM-001-02 on the real tick, TC-SAF-FW-005-03 (deferral bound). **0.4.7** — re-check of FW v0.8.1: TC-FW-HOM-001-02 (FWR-18 reproducer). **0.4.6** — D-52 HG-18 criteria (level-1 handlers ≤ 2.5 µs, step ISR + largest level-1 ≤ 5 µs); check vectors state_schema 4 (`ena_on`, hw_meas_vectors replayed by `test_val_check`). **0.4.5** — re-check of FW v0.8 (FW_code_review §10): HG-18 sections 1, 2, 3/4, 23 with pass criteria (D-51); validator harnesses adapted to v0.8 (OI-FW-49); TC-SAF-FW-005-02 (FWR-16 reproducer). **0.4.4** — code review (FW_code_review.md v0.2): reproducer TCs TC-SAF-FW-002-04, -004-04, -013-02, -023-04, TC-FW-CFG-001-02, TC-SYS-009-03 (suites `test_val_steprace`, `test_val_toctou`, `test_val_review_gen.py`, `test_hil_review.py`); §6.9 HIL session identity / gating (FWR-12/13/15). **0.4.3** — M4 verification: D-47 a (link watchdog clears VALID in every motion state) in TC-SAF-FW-015-01, replay of `linkwdg_vectors.json`; ICD v0.7.4. **0.4.2** — M3 verification: D-45 (a)–(g) applied to §6 (HG-02/04/08/10/29, §6.8 P-1, OI-E-HG-07 deferred), dict 6 / ICD v0.7.3 pulse defaults (12.5 + 12.5 µs, 40 kHz), TC-FW-MOT-006-01 moved to M3 (D-44) and extended by the ICD §5.4 execution rules (a)–(e), §6.9 HIL realisation (`00_System/tools/hil/`, D-06 interlock). **0.4.1** — M2 close-out re-test: ICD v0.7 / v0.7.1 (state_schema 3, 48 parameters, CR-03 sense / K1-check defaults false, NOINIT w4–w8, DWT sections 0–22), `_meas_dwt` exception in TC-SYS-009-02, D-43 b TC (§9). **0.4** — M2 gate: D-40 a/b/d applied (LIMIT_WIRING clear rule, ramp sum tolerance ±ceil(N/1000), load-limit regrow window); **D-41** (no power-removal contactor: E-stop is MCU / FW only, CR-03) and **D-42** (extra NO contact on the E-stop drives the driver's ENA opto to *disabled*, independent of the MCU) applied to the HG list (§6.5, §6.6); PO answers (multimeter available; SWD least preferred → DIAG_MEAS primary); **bench safety procedure for stimulus trials (§6.8, for PO approval)**; OI-FW-39 answered (§3.2 TC-SAF-FW-003-01); all M2 TCs implemented (§2.1). v0.3 = M2 entry (CR-01, CR-02), v0.2 = M1 gate, v0.1 = P1 (§9) |
| Date | 2026-10-14 (v0.4.13) |
| Owner | Validator E — FW (independent of Implementer A) |
| Binding inputs (v0.4.4) | SRS v0.6.4, ICD v0.7.4 (dict 6, 0xF8BCDCB8), DECISIONS D-01…D-49, FW_design v0.7, review anchor commit e600169 (`02_FW/docs/FW_code_review.md`) |
| Binding inputs (v0.4.3) | SRS **v0.6.3** (SAF-FW-015 every motion state), ICD **v0.7.4** (dict 6 unchanged, hash 0xF8BCDCB8; `vectors/linkwdg_vectors.json` 32 cases + `ref_linkwdg.py`), DECISIONS D-01…D-48, commit 5daf3b8 |
| Binding inputs (v0.4.2) | SRS **v0.6.2**, ICD **v0.7.3** (dict_version 6, 48 parameters, PARAM_DICT_HASH 0xF8BCDCB8; MOVE_UNTIL_LOAD rules (a)–(e) §5.4 / §6.2; twin DIAG_MEAS fidelity OBS-E-HG-01/02/05 fixed, -03 documented), DECISIONS D-01…D-45, FW_design **v0.7**, commit 2d36eec |
| Binding inputs (v0.4) | SRS **v0.5.2**, ICD **v0.6** (DIAG_MEAS 0x3D + Appendix C, FEAT_HW_MEAS, BLOCK MEAS_STATE, D-40 a/b/d normative, `loadlim_vectors.json` + `ref_loadlim.py`, twin M2 extensions incl. `--hw-meas`; seam v1.3), DECISIONS D-01…D-42, FW_design **v0.5** (§9.7 as built, §9.8 NFR-007 analysis), pinout / wiring **v0.4**, commit 099af88 |
| Binding inputs (v0.3) | SRS **v0.5.1** (SAF-FW-022 withdrawn; +H acceptance "on-chip measurement (DWT / timer capture with PUL/DIR/DOUT loopback) or equivalent", D-35 G5), ICD **v0.5** (landed 2026-10-04: `proto_gen.h` PROTO_ICD_VERSION 0.5; dict_version 4, 47 parameters, PARAM_DICT_HASH 0xFCC54C90; STOP_BTN bits / EVENT 22 / stop cause 4 retired; twin actions `inject isr_storm`, `reset cause hardfault`, `afe miss_next` → `afe_sample_t.status` bit 1; OI-ICD-09 A's `ramp_stop` rounding aligned to `ref_motion.py`), `vectors/motion_vectors.json` (OI-FW-20, published 2026-10-04 by the Integrator from `ref_motion.py`), DECISIONS D-01…D-39 (D-36 one red button = E-stop, D-37 SAVE exemption / feature-bit validity, D-39 M2 start, HX711 driver reused from Thrust_Stand), STATUS M1-gate conditions E-C1…E-C4 and CR-01/CR-02, FW_design **v0.4** (§9.6 as built; CR-01 still pending there, §8.4), `01_HW/pinout.md` / `wiring.md` **v0.3** (pre-CR-01, OBS-M1-07 carried), `tools/README.md` seam v1.1 + vocabulary v2 (v0.5: STOP-button names retired), `FW_test_report_M1.md` |
| Binding inputs (v0.2) | SRS **v0.4.1**, ICD **v0.4.1** (`proto_gen.h` PROTO_ICD_VERSION 0.4.1), `params.yaml` dict_version 3 (PARAM_DICT_HASH 0xF0376293), DECISIONS D-01…D-36 (D-36: physical STOP button withdrawn, CR-01 pending — TCs naming the STOP button stay until CR-01 is applied to this plan), FW_design **v0.4** (§9.6 as-built), `tools/README.md` twin vocabulary v2 |
| Binding inputs (v0.1) | SRS **v0.3** (SYS-001…011, SAF-FW-001…026, FW-*, IF-001…012, NFR-005…008, §3.2, §6); DECISIONS D-01…D-31 (**D-30**: PAUSED blocks every new motion start; clean-halt substitution only at step period > 2 ms **and** stop distance ≤ 1 step; **D-31**: RESUME command 0x3C clears only PAUSED, refused while HALT/ESTOP/fault latched; HALT_CLEAR clears HALT and PAUSED); ICD **v0.2** (header) with the v0.3/v0.4 deltas announced by the Integrator (`protocol.yaml` already at icd_version 0.3: BLOCK bit 10 PAUSED); `params.yaml` dict_version 2; `00_System/tools/{README.md, ref_codec.py, ref_cmdcheck.py, vectors/}`; `02_FW/docs/FW_design.md` **v0.2**; `01_HW/pinout.md` v0.2; `01_HW/wiring.md` (check list C-01…C-20) |
| Scope | FW-side verification of **101** requirements (v0.3; v0.2: 102): SYS-001…011 (FW side), SAF-FW-001…026 **without SAF-FW-022** (withdrawn in SRS v0.5, D-36), FW-PLT/AFE/MOT/HOM/SW/CFG/NVM/CMD/STR/TIM/PAR (49), IF-001…012 (FW side), NFR-005…008. 99 Must + 2 Should (FW-HOM-003, FW-STR-005). SW-side parts of IF-005/008/011 belong to Validator F. |
| Constraints | D-06: no COM port, no flashing until the PO approves a hardware gate. D-07: integration first against the FW host twin. **D-35 G5: no oscilloscope and no logic analyser at the hardware gate** — target timing evidence comes from on-chip measurement and the PC (§6). Target-only criteria stay **open** until then and are listed in the hardware-gate check list (§6.5). |

Level codes used throughout: **U** host unit test (Unity, `pio test -e native`, `src/pure` + `src/gen`, shared vectors read in place) · **T** FW host twin (lock-step virtual time, pytest driving `fw_twin.exe`) · **S** static check / inspection (build, map file, grep, document review) · **A** analysis · **H** target procedure at the PO-approved hardware gate (HG-xx, §6). Evidence kinds inside H (v0.3, §6.1): **OC** on-chip measurement (measurement build `HW_MEAS`), **PC** PC-side timing, **FN** functional observation, **DMM** multimeter / caliper / dial indicator, **INSP** inspection.

---

## 1. Strategy and test levels

### 1.1 Principles
1. **Independence.** Validator suites never include Implementer A's test helpers (`test/test_impl_*`, `test/common_impl/*`). Expected values come only from oracles: the shared vectors (`protocol_vectors.json`, `check_vectors.json`), `ref_codec.py`, `ref_cmdcheck.py`, R4 §12 reference values, and validator-owned reference models for non-protocol math (ramp, units, load limit, rate median, NVM log) in `02_FW/test/val_oracles/` (Python, they emit JSON consumed by Unity). Protocol vectors are **never** generated a second time: new protocol scenarios are requested from the Integrator for `gen_vectors.py` (R3 pitfall P12).
2. **One requirement, one acceptance criterion, lean TCs.** IDs `TC-<REQ>-nn`. A parametrised case (states × sources × parameter values) counts once. Every test carries `/* Verifies: <REQ> */` and `/* TC: TC-<REQ>-nn */` (Python: `# Verifies:` / `# TC:`).
3. **Twin results prove logic and ordering, not silicon timing.** The twin executes ISR callbacks atomically in NVIC-level order (FW_design §8.2). Twin timing criteria therefore check (a) that the reaction happens in the detecting context (same virtual event, or the stated tick), and (b) the virtual-time budget. Real latencies are measured only at the hardware gate (§6).
4. **Vectors are consumed in place** and counted: the validator run compares the number of executed vector cases with `len()` of each JSON list (anti-silent-skip check), and refuses to run when `icd_version` / `param_dict_hash` of the vectors differ from `proto_gen.h` / `params_gen.h`.
5. **Every run twice**: fixed order and randomised order/seed (seed recorded), as in Thrust_Stand.
6. **Defects** found against code are `DEF-Mx-nn` (severity, file:line, evidence, fix hint) and observations `OBS-Mx-nn`; this P1 review uses `DEF-P1-nn` / `OBS-P1-nn` (§8).

### 1.2 Levels and where they live

| Level | What | Location (owner E) | Runner | Oracle |
|---|---|---|---|---|
| U — vector conformance | CRC, every frame encode/decode, parser `streams` (frames + counters), every `check_vectors.json` case (STATUS/detail/NACK bytes, no side effect, `paused_after`) | `02_FW/test/test_val_codec/`, `test_val_check/` | `python 02_FW/test/val_oracles/gen_val_vectors.py`, then `pio test -d 02_FW -e native -f "test_val_*"` with `VAL_VEC_DIR` / `VAL_SEED` (MinGW 13.1 prepended to PATH, CLAUDE.md) | **v0.2:** shared vectors read in place and translated by the validator's own `val_oracles/gen_val_vectors.py` (ref_codec tables, gen_params) into run-time text files in `02_FW/.pio/val_vectors/` (not A's pre-script headers); `H` line = ICD version + dict hash gate, `N` line = anti-skip count |
| U — pure modules | units, ramp/planner, stepgen halt/stretch/path decisions, loadlim, afe_rate, debounce, drvmon, latches, homing, motion_sm, valid, flags, txsched, evq, stop_sniff, nvm_log, param_rules, resetcause | `02_FW/test/test_val_<module>/` | same | `val_oracles/*.py` → JSON (R4 formulas, SRS rules), shared vectors where they exist |
| T — twin | system behaviour of the unchanged `src/pure` + `src/core` against the Integrator's seam implementation, virtual time, fault injection (§4) | `02_FW/test/twin/` (pytest; folder not prefixed `test_` so PlatformIO ignores it) | `.venv\Scripts\python -m pytest 02_FW/test/twin -q` (then `-p randomly` seed run) | SRS acceptance criteria, ICD §5–§8, `ref_codec` for decoding, world truth from the twin (`x_um_true`, edge log) |
| T — SW⇄twin | smoke of the shared world vocabulary with the SW simulator (differential runs are owned by the Integrator, `03_SW/tests/integration/`) | consumed, not owned | – | – |
| S — static | clean build, `platformio.ini` flags, map file (no allocator/printf/HardwareSerial/HardwareTimer, handler slots, nothing in flash sectors 1–2, `.RamFunc` content), NVIC levels/critical sections, generated files untouched, origin notes, ID tags, no hand-written codes/param tables | `02_FW/test/static/check_static.py` | `.venv\Scripts\python 02_FW/test/static/check_static.py --build-dir …` | FW_design §2, pinout §1/§4, SRS NFR-005 |
| U — motion (v0.3) | ramp generator and controlled-stop path vs `motion_vectors.json` (9 cases incl. stops and on-the-fly jog changes, 28 path rows) | `02_FW/test/test_val_ramp/` | as above (`motion.txt` written by `gen_val_vectors.py` only if the validator oracle `ramp_ref.py` reproduces every vector) | shared motion vectors + independent `val_oracles/ramp_ref.py` |
| H — target | hardware-gate procedures (§6) on top of `ref_codec.py`, only after PO approval (D-06) | `00_System/tools/hil/` (Integrator reviews) | `hil_*.py --port COMx --po-approval <ref>` | SRS §6 budgets, measured **on-chip** by the measurement build `HW_MEAS` (timer input capture of looped-back PUL/DIR/ENA/event signals, independent pulse counter, DMA device-time stamps, DWT) and by the PC; DMM / caliper / dial indicator; **no oscilloscope, no logic analyser** (D-35 G5, §6.1) |

### 1.3 Twin harness requirements (input to the Integrator; see DEF-P1-02/03)
**v0.3 status:** DEF-P1-02/03 are closed — seam v1.1 is single-sourced in `tools/README.md` and vocabulary v2 is implemented
(M1 subset complete; also `wire`, `chatter`, `world_shift`, `iwdg`, `clk`, `afe sck_overrun / miss_next / raw_script`,
`query conversions / inputs`). What the M2 TCs still need is listed per action in **§4.1** (REQ-C-M2-01…10). The v0.1
list below is kept as the original requirement.

The T-level cases need, beyond `tools/README.md` "world-control vocabulary v1":
- **lock-step clock** with deterministic event order; scenario start time configurable (to test the 2³² µs wrap);
- **time-stamped edge log** of PUL (both edges), DIR and ENA, plus a log of seam calls (`hal_step_stop_now/abort/set_period_now/set_period/arm_last`, `hal_ena_set`, `hal_hx711_config`, `hal_flash_*`) with virtual timestamps;
- **byte-level RX injection at a virtual time** (lock-step; TCP pacing alone cannot place the last byte of a STOP frame at a known instant) and a **wire log** of every TX frame with its first-byte/last-byte virtual times (DATA latency, response time, frame integrity around NVM);
- input models with **bounce/chatter and broken wire for every input** (E-stop sense, START, END, STOP, PAUSE, ALM, PEND, DRV_PWR), independent `estop` and `drv_power` control (K1 weld = E-stop open while power stays on);
- HX711 model controls: stall, single missed edge, rate error, rails, **SCK-high overrun / power-down symptom**, observation of the gain pulse count per read;
- **flash power cut** after program word *n* / during erase *k*, flash write counter;
- **IWDG model** (timeout window from `hal_wdg_set_timeout`, LSI 17…47 kHz selectable) and hang injection in the main loop, the tick, and as a level-1 ISR storm;
- RX DMA ring overflow, TX congestion (class D full), HSE failure flag (`hal_clk_fallback`), reset causes.

### 1.4 Standard preconditions (used in §3)

| Tag | Meaning |
|---|---|
| **B** | Twin booted from blank flash, lock-step, defaults, stream off, PC connected (GET_INFO done), no specimen, load offset 0. |
| **R** | "Ready": B + `safety.*` session values written + ENABLE + 500 ms settle + HOME completed + MOVE_ABS to x = 100 mm, stream on, VALID = 1. |
| **U** | B + ENABLE + settle, not homed. |
| **M(v)** | R + MOVE_ABS to 200 mm at v (default 10 mm/s) in cruise. |
| **J(v)** | R + JOG at v, refreshed every 100 ms. |
| **L1/L2/L3** | link variants for SYS-002: L1 connected + stream on, L2 connected + stream off, L3 PC silent after the last command (`safety.link_timeout_ms` = 5000 so the watchdog does not mask the stimulus). |
| **W** (v0.3) | twin default world (`tools/README` / `twin.DEFAULT_WORLD`): `x_true` = model count · 1000 / 800 + shift, START active ⇔ `x_true` ≤ −1 500 µm, END active ⇔ `x_true` ≥ 301 000 µm, no specimen, load offset 50 000 counts, 80 SPS, driver powered, E-stop closed. A scenario `params.motion.steps_per_mm` also sets the world scale (the test still SETs the FW parameter). |

### 1.5 What the twin cannot show (v0.3, as-built twin; input for the HG list)
1. **ISR and main-loop durations** are zero (atomic callbacks; `loop_max_us` = 0, `stack_free_min` = seam constant 3072, OBS-M1-06): every µs budget is a twin *ordering/virtual-time* proof only → target OC measurement (§6).
2. **Step counting is the twin's model counter.** `hal_step_count()` returns the twin's count, and `x_true` is derived from it; a HAL counting error cannot exist in the twin. SAF-FW-004 twin evidence therefore covers the core's halt-path choice (CLEAN / TRUNCATE / POS_UNCERTAIN) and the edge-level "no runt" rule; counting integrity on silicon = HG-09 (independent on-chip counter).
3. **World direction follows the FW counter, not the DIR pin**: an inverted DIR wiring or `motion.dir_invert` cannot move the world the wrong way (REQ-C-M2-06). HOME_WIRING is provoked by forcing END active during FAST_SEEK; real direction → HG-28.
4. **Edge times are rounded to 1 ns per edge**; periods are reconstructed per interval as round(Δt · 90 MHz) (exact), never from accumulated world time (TV-M would drift by ≈ −13 µs, OBS-E-M2-01).
5. **HX711 bit-bang** is not modelled: the gain/pulse count is observable only as `hal_hx711_config(gain_pulses)` in `seam_log` (REQ-C-M2-05); SCK-high and read time → HG-05.
6. **Electrical levels, RC delays, opto currents, RAM-resident behaviour during a flash erase** → HG items (§6.5).

---

## 2. Test infrastructure and tooling (planned P2 files, owner E)

| Path | Content | MS |
|---|---|---|
| `02_FW/test/test_val_codec/`, `test_val_check/`, `test_val_units/`, `test_val_flags/`, `test_val_link/`, `test_val_nvm/`, `val_common/val_io.h` | (v0.2 as built) vector replay incl. anti-skip counts and a 10⁵-stream parser corpus vs `ref_codec.FrameParser`; `proto_gen.h` codes = `ref_codec` tables moved to `static/check_static.py` S-10 (no `test_val_names`) | M1 |
| `02_FW/test/test_val_{units,ramp,stepgen,loadlim,rate,debounce,drvmon,latches,homing,motion,valid,flags,txsched,evq,sniff,nvm,rules,resetcause}/` | independent pure-module suites | M1/M2 |
| `02_FW/test/val_oracles/` | M1 (as built): `gen_val_vectors.py` (vectors → run-time files, units oracle = binary64 + round half away, parser corpus; **v0.3: + `motion.txt` from `motion_vectors.json`**, written only if `ramp_ref.case_periods()` reproduces every vector), `nvm_ref.py` (record decoder / hash patch); **M2 (built v0.3):** `ramp_ref.py` (R4 §1.5 exact sqrt ramp, fractional carry, planner, controlled stop, JOG virtual index, ICD §6.5 path, pulse timing), `homing_ref.py` (FW-HOM-001/002/004, SAF-FW-021 on the twin world), `latch_ref.py` (E-stop clear, limit latch D-33 h, DRV_PWR filter, K1 window, load limit + regrow, H5) | M1/M2 |
| `02_FW/test/twin/` | pytest twin suites (M1: `test_val_twin_boot.py`, `test_val_twin_params.py`, `test_val_twin_link.py`), `conftest.py`, `vhelp.py` (`ref_codec` client on the twin's Python API); **v0.3: `vhelp_m2.py`, `test_val_m2_oracles.py` (runs now), `test_val_twin_m2_{motion,homing,safety}.py` (gated, §2.1)** | M1/M2 |
| `02_FW/test/test_val_ramp/` (v0.3) | Unity: A's `ramp.h` / `stepgen.h` vs `motion.txt` (all failures collected, anti-skip count); IGNORE "M2 pending" while the headers are absent | M2 |
| `02_FW/test/static/check_static.py` | map/flags/tags/origin/grep checks (independent of A's `check_map.py`); **v0.3 M2 additions:** S-11 CR-01 (no EXTI line 7 / PC7 input, no `io.stop_active_level`, retired codes never emitted in `src/**`), S-12 `TC-SYS-009-02` measurement-build differential (§6.3), S-13 reboot-required overlay derived from generated flags (OBS-M1-08 follow-up) | M1/M2 |
| `00_System/tools/hil/` | `hil_guard.py` (refuses to open a port without `--port` and `--po-approval`), `hil_link.py`, `hil_soak.py`, `hil_cmd_latency.py`, `hil_events.py`, `hil_report.py`; **v0.3 (CR-02) instead of `hil_capture.py` (LA/scope CSV, withdrawn):** `hil_meas.py` (DIAG_MEAS client, REQ-C-M2-01), `hil_latency.py` (probe trials per path, statistics, uncertainty), `hil_count.py` (independent counter vs `pos_steps`), `hil_clock.py` (device vs PC clock regression), `hil_stim.py` (random-phase stimulus series), `hil_hang.py` (IWDG `.noinit` read-back); dry-run against the twin when REQ-C-M2-08 exists | HW gate |
| `02_FW/docs/FW_test_report_M1.md`, `…_M2.md`, `…_HG1.md` | reports with verdicts | per gate |

### 2.0 M2 suites as run at the M2 gate (v0.4)
| File | Level | TCs (M2) |
|---|---|---|
| `test_val_ramp`, `test_val_loadlim`, `test_val_m2pure` (Unity) | U | FW-MOT-003-01/02, SAF-FW-003-02, SAF-FW-008-02, -009-01 (U), -011-01 (U), SAF-FW-002-02, SAF-FW-004-02, FW-AFE-001-01, FW-AFE-003-01 (U), FW-AFE-004-01, FW-SW-001-01 (U); `test_val_check` 507 vectors = SAF-FW-020-01, -023-03 (U), -026-01 (U), FW-MOT-009-01 (U), SAF-FW-010-01 (U) |
| `twin/test_val_twin_m2_motion.py`, `_homing.py`, `_safety.py`, `_sources.py`, `_cmds.py`, `_meas.py` | T | all other T-level M2 TCs (function names carry `TC-…` in their docstrings); `test_command_check_differential_walk` = SAF-FW-020-02; `test_every_stop_source` = SAF-FW-001-01; `test_fw_safety_without_pc` = SYS-002-01 (L2 / L3 subset of the FW-only reactions; the full SAF suite runs in L1) |
| `static/check_static.py` S-14 / S-15, `static/check_meas_build.py` | S | CR-01 code check, SAF-FW-007-01, SAF-FW-008-03, SYS-002-02, TC-SYS-009-02 |
| inspection (report §6) | S | SYS-001-01, SYS-005-01, SAF-FW-020-03, FW-SW-002-01 (S part), NFR-006/007 (S part) |

### 2.1 Pre-written M2 suites (v0.3) — status and run rule
Written before Implementer A's M2 code from the specifications and oracles only. **Run rule:** each twin test calls
`need(v, <features>)` and **skips** with "M2 pending" while GET_INFO reports the feature bit 0; the Unity suite is
**ignored** while `ramp.h`/`stepgen.h` are absent. At the M2 gate a skip/ignore is a failure of the evidence (§5.2), and a
change of an expectation needs a plan reference (never "make it pass").

| File | Tests | TCs | State 2026-10-04 |
|---|---|---|---|
| `twin/test_val_m2_oracles.py` | 22 | oracle anchors for TC-FW-MOT-003-01/02, TC-SAF-FW-003-01/02, TC-FW-HOM-001/004, TC-SAF-FW-006/008/011/013/024/025, TC-FW-SW-005 | **22/22 pass** (fixed + random order); incl. `motion_vectors.json`: 9/9 cases and 28/28 path rows reproduced **exactly** by the independent `ramp_ref.py`, 3/3 planner rows |
| `test_val_ramp/` (Unity) | 1 (37 vector lines) | TC-FW-MOT-003-01/02, TC-SAF-FW-003-02 (U) | written against A's ramp API of 2026-10-04; dry run in `env:native` against A's **in-progress, not yet delivered** `ramp.c` after the OI-ICD-09 alignment: **9/9 cases (worst 1 tick, sum error ≤ 1 tick) + 28/28 path rows PASS**, anti-skip 37/37 (an earlier run before the alignment failed the 4 stop / jog cases, OBS-E-M2-03) |
| `twin/test_val_twin_m2_motion.py` | 11 (incl. 3 speed bands) | TC-FW-MOT-001-02, -003-01 (T), -004-01, -005-01, TC-SAF-FW-002-01 (PC paths), -003-01, -004-01, TC-IF-005-01 (M2 part, E-C2), TC-FW-NVM-003-01 (M2 part, E-C2) | gated (MOTION, HOMING); dry run vs A's in-progress M2 build: 11/11 PASS (incl. TV-M periods on the wire) |
| `twin/test_val_twin_m2_homing.py` | 6 | TC-FW-HOM-001-01, -002-01, -004-01, TC-SAF-FW-021-01 | gated (MOTION, HOMING [, AFE]); dry run: 6/6 PASS |
| `twin/test_val_twin_m2_safety.py` | 9 | CR-01 regression (runs now), TC-SAF-FW-005-01, -006-01, -008-01, -011-01, -013-01, -014-01, -024-01, -025-01, TC-FW-SW-005-01 | 1 ungated, 8 gated (MOTION [, HOMING, DRV_SIGNALS, AFE]); dry run: 8 PASS + 1 strict xfail (TC-SAF-FW-014-01, OBS-E-M2-08) |

**Dry run 2026-10-04** (A's working tree already reports the M2 feature set; **not M2 evidence** — A has not delivered, the code is still changing): validator twin suites 74 passed + 1 strict xfail, fixed order and random order (`VAL_TWIN_BUILD_DIR` = private twin build in the validator scratchpad, so the shared `fw_twin.exe` of other roles is never rebuilt); Unity `test_val_*` 7 suites PASS with all anti-skip counts (check 500, frames 163, streams 11, corpus 10⁵, units 660, bits 37, motion 37); `check_static.py` 13/13. The dry run found and fixed harness issues of the pre-written suites (PC heartbeat while waiting — the link watchdog trips after 1 s; controlled-stop commit taken from the update that preloads the first longer period, distance counted from the commit) and made the M1 twin tests feature-aware (OBS-E-M2-07).

Still to be written at M2 (need A's as-built details or REQ-C items): TC-SAF-FW-001-01 (all sources), -002-02/03, -007-0x,
-009/010/012/015/016/017/018/019/020-02/023/026, TC-FW-AFE-*, TC-FW-MOT-006 (M4), -007/008/009, TC-FW-SW-001/002/003/004,
TC-FW-CMD-003, TC-FW-STR-003 (M2 bits, E-C2) / -005 / -006, TC-FW-TIM-001, TC-SYS-002-01 (L1/L2/L3 re-run of the SAF suite),
TC-SYS-004-02, TC-SYS-006-01, unit suites `test_val_{loadlim,stepgen,latches,drvmon,homing,debounce}` against A's pure API.

---

## 3. Test cases

Columns: **Lvl** level · **MS** milestone of the requirement (SRS) · **Pre** precondition (§1.4) · **Stimulus** · **Expected** (traced to the SRS acceptance criterion; "AC" = that criterion). Target parts of a criterion are referenced as HG-xx (§6) and stay open under D-06.

### 3.1 System (SYS-, FW side)

| TC | Lvl | MS | Pre | Stimulus | Expected (AC) |
|---|---|---|---|---|---|
| TC-SYS-001-01 | S | M2 | `01_HW` docs | Inspect `wiring.md`/`pinout.md` for every FW-connected signal of SRS §3.1 (PUL, DIR, ENA, ALM, PEND, DRV_PWR, DOUT, PD_SCK, RATE, START, END, E-stop sense, PAUSE, TRIP, LED, USART2) and the operator panel (single red E-stop + PAUSE, D-36); **v0.3:** no STOP/BREAK input (PC7 free, CR-01); the measurement header MH (§6.2) documented as a bench-only item | every connection documented with pin, connector, level; FW-side inspection checklist complete (AC). HW completeness also HG-20. |
| TC-SYS-002-01 | T | M2 | L1, L2, L3 | Re-run the whole SAF-FW twin suite (§3.2) once per link variant | identical verdicts in L1/L2/L3 (AC "every SAF-FW test also passes with the PC disconnected and the stream off"); only LINK_WDG cases are excluded from L3. |
| TC-SYS-002-02 | S | M2 | source tree | grep/inspection of `src/**` for force scaling (K, B, N, kg, tare math) | no force scaling in FW (AC). |
| TC-SYS-003-01 | U | M1 | – | `um_to_steps`/`steps_to_um` with R4 TV-TC values + ±0.5-step ties, negatives, int32 ends | all equal the oracle, round half away from zero (AC). Source: `units_vectors.json` when OI-FW-20 lands, until then `val_oracles/units_ref.py`. |
| TC-SYS-004-01 | H | M2 | HG-25 | 0.01 and 10 mm/s moves, 30 mm/s unloaded move, re-home, soft-limit travel | AC on target (HG-25). |
| TC-SYS-004-02 | T | M2 | R, spm ∈ {100, 160, 800} | MOVE_ABS at 0.001 mm/s (short distance) and at the cap; 30 mm/s unloaded | accepted; period of 0.001 mm/s fits the 32-bit timer (no E_RANGE, no overflow); mean speed from the edge log within 1 %; envelope part of AC. |
| TC-SYS-005-01 | S | M2 | `params.yaml`, `src/**` | inspect units of every speed/accel parameter and command field | no speed/accel in step units (AC inspection); DIP sheet part → HG-19. |
| TC-SYS-006-01 | T | M2 | M(10) | E-stop open → close after 1 s → `drv_power` on again (RESET) | no PUL edge, motion_state stays NOT_ENABLED, ESTOP latched until ESTOP_CLEAR, no motion until ENABLE + HOME (AC "after RESET no axis motion until ENABLE + HOME"); power-removal part → HG-10/HG-20. |
| TC-SYS-007-01 | S | M1 | `pinout.md`, `include/board_pins.h`, `irq_prio.h` | compare pin, direction, level, EXTI line, NVIC level; 5 V tolerance column | every FW pin in `pinout.md` with direction/level/origin; no 5 V signal on PA4/PA5 (TC pins) (AC); code constants equal the document. |
| TC-SYS-008-01 | T+S | M1 | twin build | build `fw_twin.exe` from the unchanged `src/pure` + `src/core`; grep core/pure for register access (`->CR`, `GPIO`, `TIM2->` …) | twin builds without `#ifdef TWIN` in core/pure; no register access outside `hal/f446`; the validator twin suites run (AC "SW⇄twin integration tests pass" FW part). |
| TC-SYS-009-01 | H | M2 | PO-approved gate | execute the hardware-gate check list HG-01…HG-31 (§6.5) with the evidence kinds of §6.1 (OC / PC / FN / DMM / INSP; no scope / LA, D-35 G5) | check-list report with measured values and their uncertainty, every §6 budget met with the uncertainty added (§6.1 rule 4), first-jog record before homing/calibration (AC). |
| TC-SYS-009-02 | S | M2 | release + `HW_MEAS` builds | (v0.3, CR-02) build `nucleo_f446re` and `nucleo_f446re_meas`; compare the disassembly of `.RamFunc`, `EXTI0/1/4/9_5/15_10_IRQHandler`, `TIM2_IRQHandler`, `TIM5_IRQHandler`, `step_isr_core` (v0.4.12, OI-FW-53: was `step_isr`, the seam wrapper the FW v0.8.6 images no longer contain) and every `src/core` / `src/pure` object; grep `HW_MEAS` | byte-identical safety handlers and core/pure objects; `HW_MEAS` only in `hal/f446/meas*.c` + the env; FEAT_HW_MEAS only in the measurement env; the measured image is the release logic (§6.3, residual R-4). |
| TC-SYS-009-03 | U | M2 | `00_System/tools/hil/tests/test_hil_review.py` (fakes; no port, no twin) | (v0.4.4, review FWR-12/13/15/09) D-06 approval rows (negated / questioned / wrong format), results of another session / board / mode / image presented to the load gate and `result_of()`, `--accepted-open` references, `--board-uid` missing or malformed, `--only` / `--from` selections, GET_INFO identity mismatches, HG-06 in NOT_ENABLED | only a dedicated `approved (PO)` row opens the interlock; gates accept only results of the current session; unrecorded accepted-open refused; no port without a 24-hex UID; S-00 (or S-ID) always first, HG-10a always between BENCH-ENTRY and BENCH-EXIT, GATE-LOAD before phase 4; any identity mismatch refuses; HG-06 sends DISABLE and needs ENA disabled before STATIC_LEVEL. Round 2 (Integrator review C-R1…3, O-1…3): a later / other non-approving row for the same reference cancels it (both files); rows in code fences / HTML comments never count; no HALT / HALT_CLEAR to an unidentified device; an identity or BENCH-ENTRY step ending ERROR / FAIL / INCONCLUSIVE (e.g. DIP = no) stops the session before motion; suffix and FEAT_HW_MEAS must agree; selection ids checked before the port. Verifies: SYS-009, D-06 (FW_test_plan §6.8, §6.9). |
| TC-SYS-009-04 | U | M2 | `00_System/tools/hil/tests/test_gate_runner.py` (fakes and the FW twin; no port, D-06) | (v0.4.14, D-57) gate runner: approval file (GATE_RUNNER.md §3) valid / missing / tampered / outside its window / wrong board / wrong runner / changed or missing kit image / inconsistent content; `make_approval.py` rules (stale or revoked row, UID not named, open item not accepted, hash not in SHA256SUMS); session CLI refusals before any port and before the session folder; a valid file reaching the interlocked port; window re-check at every open; results zip manifest (change / add / drop detected); offline analysis flags a doctored decision; (v0.4.15) board sessions refuse unpinned non-default options (C-GR-1), the analysis treats a board zip without approval / results-zip anchors, with `--quick` or with unpinned options as a problem (C-GR-2), whole-bundle runner hash and one-folder rule (C-GR-3), plain-language prompts and picture map consistent (GR-2 / GR-3); twin rehearsal through the runner (zip intact, analysis clean); stray run writes only into `--out` | every refusal exit 2 with nothing opened or written; zip verify empty for an intact zip and non-empty for each tamper; analysis 0 problems / 0 mismatches for the rehearsal; no file outside `--out` (cwd, TEMP, APPDATA, LOCALAPPDATA, USERPROFILE, HOME). Verifies: SYS-009, D-06. |
| TC-SYS-010-01 | S | M1 | source + tests | grep origin notes in reused files (path @ commit); `Implements:`/`Verifies:` tags; traceability scan | every reused file has an origin note with commit hash; 100 % of in-scope Must requirements have ≥ 1 `Verifies:` test (AC). |
| TC-SYS-011-01 | I+H | M2 | bring-up record (assistant package, SW-BRU-003) and HG-06 / HG-25 / HG-23 | (v0.4.13, D-56 b, SRS v0.6.8 SYS-011) qualification of the **direct 3.3 V drive** before any calibration / test campaign: (a) I_LED on **ENA** (DISABLE, LED-on level) and **DIR** (held level) with the 100 Ω shunt (C-06 / M-2 / M-8); (b) pulse-integrity check: repeated full-speed moves over the working stroke, then a re-home; repeated after any wiring change and at the end of every campaign. Inspection of the record and of the installed wiring; at the HW gate the same quantities from HG-06 (I_LED, VOH) and HG-25 (30 mm/s travel + re-home). The buffer board (SN74ACT244) only if (a) or (b) failed → then HG-23. | (a) I_LED ≥ 6 mA on ENA and DIR (and VOH ≥ 3.0 V at the gate); (b) no HOME_DRIFT, home offset within `home.drift_tol_um` (FW-HOM tolerance); any fail → "buffer board required" recorded, buffer fitted before calibration, HG-23 (10…13 mA) PASS. Simulator / twin / entry-form parts of the assistant's steps: TC-SYS-011-02 … -04 (SW_test_plan v0.5.7 §3.15, Validator F). |

### 3.2 Safety — firmware (SAF-FW-)

| TC | Lvl | MS | Pre | Stimulus | Expected (AC) |
|---|---|---|---|---|---|
| TC-SAF-FW-001-01 | T | M2 | M(10), J(10), homing | parametrised over every stop source of SRS §3.2 / ICD §6.2 (v0.3: no STOP button, D-36): PC STOP 0/1, HALT, PAUSE button, PC PAUSE, START/END limit, both limits, load limit, rail sample, AFE stale, link watchdog, jog dead-man, step fault, homing failure, E-stop, DRV_PWR loss | ENA level unchanged (E-stop and DRV_PWR loss: disabled); next DATA MOVING = 0, VALID = 0 (dead-man: VALID unchanged); STOPPED(cause) then exactly one MOVE_DONE(STOPPED); afterwards the matching clear (+ ENABLE/HOME where needed): no PUL edge for 5 s (old move never resumed) (AC). |
| TC-SAF-FW-002-01 | T | M2 | M(v) v ∈ {1, 10, 30 mm/s}; `pulse_high_ns` ∈ {10 000, 100 000} | per immediate path, 100 random phases each: limit edge (`limit active` at a random virtual time), load limit deciding sample (`afe raw_script`), STOP 0 frame, HALT frame (`rx_bytes at_us`: last byte at a random phase vs the 1 kHz tick; main loop loaded with 500 µs per pass: `inject loop_load`, REQ-C-M2-02), AFE fault, step fault, HOME_WIRING (v0.3: STOP-button edge removed, D-36) | stop issued in the detecting context (`seam_log` `hal_step_stop_now` / `hal_step_abort` at the trigger instant for inputs / samples); last PUL edge (`query edges`) − trigger ≤ 200 µs (inputs, load sample) / ≤ 2 ms after `wire_log.last_us` of the STOP/HALT frame; max over trials reported (AC twin part); target part HG-11/12/13 (OC, §6.5). Pre-written: `test_stop_frame_last_byte_to_last_edge` (PC paths). |
| TC-SAF-FW-002-02 | U | M2 | `stop_sniff` | STOP/HALT/PAUSE frames whole, split at every byte across two ticks, bad CRC, STOP mode 2, wrong LEN, sync in a payload, other TYPEs, **RESUME (0x3C) frame** | hits exactly for CRC-valid STOP(mode ≤ 1)/HALT/PAUSE; no hit for RESUME, STOP mode 2, bad CRC (supports AC of SAF-FW-002/003). |
| TC-SAF-FW-002-03 | T | M2 | R, `motion.a_max_um_s2` = 10 000 000, spm ∈ {800, 100 000} | one RX burst MOVE_ABS + HALT; dispatch budget forced to split between the two frames | HALT effective: last PUL edge ≤ 2 ms after the HALT last byte; number of emitted pulses reported (FW_design §5.9.3 claims 0 — see DEF-P1-04). |
| TC-SAF-FW-002-04 | U | M2 | target `hal/f446/step_tim2.c` on a TIM2 register model (`test_val_steprace`) | (v0.4.4, review FWR-01) a limit CLEAN halt / an E-stop TRUNCATE issued while the timer is idle, after the start sequence captured `hal_step_stop_gen()` (gate check → start window) | the halt is visible to the start-then-recheck (stop_gen changes), so the start is refused or stopped at once: no PUL edge later than SAF-FW-002 (200 µs) / SAF-FW-005 a (100 µs). Verifies: SAF-FW-002, SAF-FW-005. |
| TC-SAF-FW-002-05 | U | M2 | target `hal/f446/step_tim2.c` on an **access-timed** TIM2 register model (`test_val_haltwin`: every TIM2 access lets the counter run 6 ticks = nominal APB1 cost, no instruction cost) | (v0.4.10, review FWR-21) CLEAN halt `hal_step_stop_now()` while the running pulse ends: call at CNT = ARR − d, d = 0…95, period 1.25 ms, at 6 (nominal) and 12 (conservative-equivalent) ticks per TIM2 access (v0.4.11); control: d inside the pulse (100…840) | no further pulse: the last PUL edge ≤ pulse_high + guard (target `s_guard`) (+ 0.7 µs model slack) after the call (FW_design §5.3; SAF-FW-002 ≤ 200 µs); step count = completed pulses; no runt. Verifies: SAF-FW-002, SAF-FW-004. |
| TC-SAF-FW-003-01 | T | M2 | M(v), J(v) for v giving step period P ≤ 1 ms, 1 ms < P ≤ 2 ms, P > 2 ms | each controlled source: link watchdog (`inject link_silence`), PAUSE button (`button pause`; trigger = the action time — the twin has no RC), PC PAUSE, jog dead-man, STOP 1, JOG 0 | deceleration **committed** (`seam_log`: `hal_step_set_period_now` / first `hal_step_set_period` > the running period / `hal_step_stop_now` for a CLEAN halt) ≤ 2 ms after the trigger; every PUL interval after the commit (reconstructed per interval, §1.5 item 4) ≥ the previous one and within ±1 tick of the profile defined by `motion_vectors.json` (`ref_motion` docstring: r0 = ceil(v_cur²/2α_stop), c = max(c_last, D(r))); stop distance = v²/(2·a_stop) ± 1 step; then SAF-FW-001 state (AC; OBS-P1-01 / OI-FW-24). Pre-written: `test_controlled_stop_commit_and_profile` (STOP 1, three bands). **OI-FW-39 (answered v0.4): the stop distance is counted from the deceleration commit** — the first period longer than the running one (ISR path: its preload is written at the update that starts the period before it; stretch path: `hal_step_set_period_now`) — so the step already preloaded at the trigger (ISR path) and the running pulse are not part of the ± 1 step budget; they are bounded by the ≤ 2 ms commit rule instead. The FW (ceil(v²/2a) + 1 preloaded step) is compliant on this reference. |
| TC-SAF-FW-003-02 | U+T | M2 | grid P × d: spm ∈ {100, 160, 100 000}, a_stop ∈ {10 000, 1 000 000} µm/s² | controlled stop at P just below/above 2 ms | **D-30**: CLEAN halt only when P > 2 ms **and** d ≤ 1 step: no PUL edge > 2 ms after the trigger, no runt, distance < 1 step, POS_UNCERTAIN not set, MS → IDLE without STOPPING, same STOPPED cause, MOVE_DONE STOPPED/JOG_ZERO; otherwise planned deceleration as TC-003-01 (U: `ctrl_stop_path`, `stepgen_stretch_decide`). |
| TC-SAF-FW-004-01 | T | M2 | M(v), J(v) random v | 10 000 random stops at the gate run (`VAL_STOPS`, 200 in development runs; random source and phase, incl. the guard window before a pulse: 1.5 µs since FW v0.8.5) | PUL rising edges in the edge log = Δ`pos_steps` exactly; ±1 only together with POS_UNCERTAIN (TRUNCATE paths); no pulse shorter than `pulse_high_ns` (AC twin; scope of the twin evidence: §1.5 item 2). Target → HG-09 (OC independent counter). Pre-written: `test_random_stops_count_integrity`. |
| TC-SAF-FW-004-02 | U | M2 | `stepgen_halt_decide` | every CNT ∈ [0, ARR] for PW ∈ {225, 900, 9000} ticks and guard ∈ {45, 135} ticks (0.5 / 1.5 µs, v0.4.11); CNT = 0 against every CCR1 ∈ [225, 20 000) | OPM path iff CNT ≥ CCR1 − guard, else force-inactive; "pulse in flight" flag correct (no runt, no uncounted pulse); CNT = 0 (counter stopped by OPM) never chooses OPM and never reports a cut. |
| TC-SAF-FW-004-03 | T | M2 | M(30) | inject a missed step update (`inject step_fault`) | STEP_FAULT latched, immediate stop, HOMED = 0, POS_UNCERTAIN = 1, FAULT_SET(2) (AC "missed timer update raises STEP_FAULT"). |
| TC-SAF-FW-004-04 | U | M2 | `test_val_steprace` (register model; injection at the `dwt_cycles()` call between `s_running = true` and `TIM2->CR1 \|= CEN`) | (v0.4.4, review FWR-02) E-stop abort / limit CLEAN halt inside `hal_step_start()` of a 7-step move | the timer stays stopped: 0 update events, 0 PUL edges, step count = completed pulses (no phantom count). Control: the same move without injection gives 7 pulses / count 7. Verifies: SAF-FW-004, SAF-FW-002, SAF-FW-005. |
| TC-SAF-FW-004-05 | U | M2 | `test_val_haltwin` (access-timed register model) | (v0.4.10, OBS-RC-7; criterion v0.4.11) (a) stretch `hal_step_set_period_now(2P)` decided at CNT = CCR1 − guard − 1 − x, x = 0…39 (guard = the target's `s_guard`); (b) CLEAN halt decided at CNT = CCR1 − guard − 1 − y (halt_hw path); both at the nominal bus cost; (c) per path, a scan of the per-access cost c from 6 up to past the guard (k accesses after the CNT read: stretch k = 4, halt_hw k = 2) | (a), (b): no runt (no PUL pulse shorter than pulse_high), count = completed pulses. (c) pass/fail: a runt **must** appear once k·c exceeds the guard (anti-vacuity); no runt while k·c ≤ guard; first runt at ≥ 2× the conservative target path (stretch 46 ticks, CLEAN halt_hw 38 ticks, disassembly; factor 2 because the static model is uncalibrated until HG-18, OI-FW-46). FW v0.8.4 (guard 0.5 µs) fails (c) for the stretch (factor 1.04); v0.8.5 passes (2.96 / 3.58). Target confirmation of the sub-paths: DWT sections 13 / 16 at HG-18. Verifies: SAF-FW-004. |
| TC-SAF-FW-005-01 | T | M2 | parametrised states: NOT_ENABLED, ENABLING, IDLE, MOVE_ABS, JOG, each HOMING phase, STOPPING, stream off, PC silent, NVM SAVE in progress | E-stop sense opens (`estop open`, `drv_power_follows` false and true) | `hal_step_abort` in `seam_log` at the same virtual instant as the input change (≤ 100 µs); ENA edge in `query edges`; ENA disabled ≤ 1 ms; ESTOP latched, VALID = 0, HOMED = 0, move discarded; next DATA ESTOP = 1 (AC twin; during SAVE the latch/event is delivered after the flash op, the HAL reaction is immediate). Target → HG-10, HG-04. |
| TC-SAF-FW-005-02 | U | M2 | `test_val_toctou` (unchanged `cmd.c`; fake seams, documented exception to §1.1 rule 1) | (v0.4.5, re-check FWR-16) after DISABLE, an E-stop edge (fixed reaction + record, not yet folded) between the check and the execution of ENABLE | ENA stays at the disabled level (SAF-FW-005 b); the next tick latches ESTOP. Control: the same edge before a JOG start → no PUL edge. Verifies: SAF-FW-005. |
| TC-SAF-FW-005-03 | U | M2 | `test_val_tickgen` (real tick) | (v0.4.8, re-check FW v0.8.2 deferral) jog; E-stop opens, then reopens after the record take of 30 consecutive ticks (chatter) | no PUL edge after the first E-stop edge; exactly one MOVE_DONE ≤ 2 ticks after the chatter ends; ESTOP latched, ENA disabled. Verifies: SAF-FW-005, SAF-FW-001. |
| TC-SAF-FW-006-01 | T | M2 | after an E-stop | ESTOP_CLEAR with the input open, closed 50 ms, 99 ms, 100 ms; bounce during release; then JOG; ENABLE with DRV_PWR off; power on + ENABLE + settle + MOVE_ABS | E_CAUSE_ACTIVE 0xFFFF / ms missing; accepted at ≥ 100 ms only, bounce restarts the count; JOG → E_STATE NOT_ENABLED; ENABLE → E_STATE DRV_UNPOWERED; MOVE_ABS → E_STATE NOT_HOMED (AC). Pre-written: `test_estop_clear_rules` (oracle `latch_ref.estop_clear`). |
| TC-SAF-FW-007-01 | S | M2 | `params.yaml`, `params_gen.h` | search for polarity parameters of E-stop, START, END, DRV_PWR | none exist (AC inspection). |
| TC-SAF-FW-007-02 | T | M2 | R and M(10) | broken wire (`wire broken`) on E-stop sense, START, END, DRV_PWR aux (v0.3: STOP removed, D-36; `wire stop` answers ok = false) | reads active / unpowered → the corresponding stop + flag/latch (AC). PAUSE (NO) wire break is undetectable by design (OBS-P1-11). |
| TC-SAF-FW-007-03 | T | M2 | boot | boot with each of: E-stop open, START open, END open, both, DRV_PWR off (v0.3: STOP removed); and with `drv.pwr_sense_enable` = false (SET + SAVE + REBOOT) | first GET_STATUS shows the latch/inputs; motion refused with the expected BLOCK bits; boot ENA disabled when the E-stop is open (and per OI-FW-22 when DRV_PWR is off); sense disabled → DRV_PWR = 1 (AC). |
| TC-SAF-FW-008-01 | T | M2 | NOT_ENABLED idle, un-homed JOG, each HOMING phase, MOVE_ABS, stream off, PC silent | inject raw_max + 1 (and raw_min − 1); raw_max exactly; `load_trip_samples` = 2 with consecutive vs alternating violations | trip on that sample (2nd consecutive for 2), no trip at the threshold or alternating; LOAD_LIMIT latched, VALID = 0, stop in every state (AC). Stimulus `afe raw_script` [raw_max, raw_max, raw_max + 1, …]. Pre-written: `test_load_limit_trip_and_regrow` (with TC-SAF-FW-011-01). |
| TC-SAF-FW-008-02 | U | M2 | `loadlim` | threshold, trip-sample counter, rails, regrow after clear, thresholds changed between samples | equals `val_oracles/loadlim_ref.py`. v0.3: oracle = `val_oracles/latch_ref.LoadLimit` (regrow window ends with the first in-range sample — ASSUMED, confirmed by A's `loadlim.h` text, OI-E-M2-03); Unity suite `test_val_loadlim` against A's `loadlim_check/on_clear` at M2. |
| TC-SAF-FW-008-03 | S | M2 | params, call graph | inspect for any parameter/command/build flag that disables the check; `loadlim_check` called unconditionally in the sample ISR | none (AC inspection). |
| TC-SAF-FW-009-01 | U+T | M2 | thresholds at the range caps ±7 151 121 | samples 0x7FFFFF, 0x800000 (−8 388 608) | trip with LOAD_LIMIT, DS_AFE_SATURATED in that frame (AC). |
| TC-SAF-FW-010-01 | U+T | M2 | B; M(10) | check vectors `set_safety.load_raw_*` (min/max/below/above/type/padding/moving), H2; SET 7 151 122 / 7 151 121; SET while moving; boot, DEFAULT_PARAMS, LOAD_PARAMS, SAVE + REBOOT | E_RANGE detail = id, 7 151 121 read back; while moving accepted and effective from the next sample; boot/DEFAULTS → ±7 022 271; LOAD keeps the session values; after SAVE + REBOOT defaults (record holds no session entry) (AC). |
| TC-SAF-FW-011-01 | T | M2 | LOAD_LIMIT latched with load beyond threshold (spring specimen) | FAULT_CLEAR; move reducing the load; move increasing it by ≤ regrow and by > regrow | clear accepted; unloading move runs; re-trip only beyond `safety.load_regrow_raw` (AC). |
| TC-SAF-FW-012-01 | T | M2 | J(10) | DOUT stall; motion commands while stale; saturated last sample; samples resume; FAULT_CLEAR before/after | stop ≤ `afe.timeout_ms` + 1 ms after the last sample, AFE_FAULT latched; motion → E_STATE AFE_STALE / AFE_SATURATED; FAULT_CLEAR refused until a fresh sample (AC). |
| TC-SAF-FW-012-02 | T | M2 | R, `afe.rate_sps` = SPS10, `afe.timeout_ms` default | 10 min idle + 60 s jog at the true 10 SPS rate (± 0.5 % jitter) | **no** AFE_STALE / AFE_FAULT. Expected to fail against the current dictionary (DEF-P1-01). |
| TC-SAF-FW-013-01 | T | M2 | M(10), J(10), MOVE_UNTIL_LOAD (M4) toward START/END, with bounce | hit; JOG toward / away; release for 19 ms and ≥ 21 ms; release without moving away | immediate stop, LIMIT_x latch, LIMIT_SET, VALID = 0; toward → E_STATE LIMIT, away → runs; **v0.3 (D-33 h):** the latch clears after the input has been released continuously for `io.release_ms` — **no position condition** (the v0.1/v0.2 "≥ 1 step on the away side" is withdrawn, OBS-P1-06 closed); kept at 19 ms (oracle `latch_ref.limit_latch_cleared`, ±1 ms tick band) (AC). Pre-written: `test_limit_hit_latch_and_release`. |
| TC-SAF-FW-013-02 | U | M2 | unchanged `core/cmd.c` compiled into `test_val_toctou` with its `hal_time_us()` call (inside the check→execute window) routed to one `core_tick_1ms()`; A's fake seams (exception to §1.1 rule 1: the race needs the full core; expected values from the SRS only) | (v0.4.4, review FWR-03) boot, ENABLE, settle; END active edge (not yet folded); un-homed JOG +1 mm/s, the tick folds LIMIT_END between `cmd_check()` and execution | no PUL edge toward the latched END switch within 50 ms (NACK BLOCK_LIMIT or immediate stop). Control: fold before the check → E_STATE BLOCK_LIMIT. Verifies: SAF-FW-013 (SAF-FW-014 by the same mechanism). |
| TC-SAF-FW-014-01 | T | M2 | R | both limits active; FAULT_CLEAR while active, with one released, both released | LIMIT_WIRING, motion E_STATE FAULT; FAULT_CLEAR E_CAUSE_ACTIVE until both released, then OK (AC). **D-40 a (v0.4):** FAULT_CLEAR is accepted once the inputs are no longer *both* active; the input still active keeps acting as a normal limit latch (motion toward it refused). Test: `test_both_limits_wiring_fault`. |
| TC-SAF-FW-015-01 | T | M2 | M(10), J(10), HOMING; `link_timeout_ms` ∈ {200, 1000, 5000} | command silence of timeout − 1 ms and timeout; then a NACKed command, a bad-CRC frame, an invalid-TYPE frame | no stop at timeout − 1 ms; deceleration committed ≤ timeout + 2 ms; LINK_WDG, VALID = 0, EVENT; bad-CRC/invalid TYPE do not refresh or clear; any valid command frame clears LINK_WDG (LINK_RESTORED), nothing restarts; idle silence never trips (AC). **v0.4.3 (D-47 a, ICD v0.7.4, SRS v0.6.3):** in every motion state (NOT_ENABLED, IDLE, MOVE_ABS, MOVE_UNTIL_LOAD) a silence ≥ the timeout clears VALID (VALID_CLEARED arg LINK_WDG only on 1 → 0) without a stop when not moving; replay of the 32 cases of `linkwdg_vectors.json`, each re-derived by the validator oracle (`latch_ref.link_watchdog`), suite `test_val_twin_m4_linkwdg.py`. Every other twin TC with > 1 s of PC silence keeps a PING heartbeat. |
| TC-SAF-FW-016-01 | T | M2 | J(10); `jog_timeout_ms` ∈ {50, 250, 1000} | refresh every 200 ms for 10 s; stop refreshing | keeps moving; deceleration committed ≤ timeout + 2 ms after the last refresh; STOPPED JOG_DEADMAN, VALID unchanged (AC). |
| TC-SAF-FW-017-01 | T | M2 | R idle; `zero_raw` shifted; `idle_disable_s` ∈ {0, 600} | unloaded; loaded ≥ band; a move at 300 s | unloaded: ENA disabled at 600 s ± 1 s, HOMED = 0, DRIVER_DISABLED(2); loaded: still enabled after 3600 s; a move restarts the count; 0 = never; STATUS `idle_disable_left_s` consistent (AC). |
| TC-SAF-FW-017-02 | T | M2 | R idle, unloaded | AFE stalls at t = 300 s | no idle disable while stale (design rule FW_design §5.7.1; SRS silent → OBS-P1-05). |
| TC-SAF-FW-018-01 | T | M2 | reset causes pin, power, IWDG, software during M(10) | reset | no PUL edge from reset release; ENA not driven to disabled (unless E-stop open); STATUS NOT_ENABLED, HOMED = 0, reset cause, stream off, EVENT BOOT; JOG before ENABLE → E_STATE NOT_ENABLED (AC twin). Target → HG-15 (DEF-P1-05). |
| TC-SAF-FW-019-01 | T | M2 | M(10) | hang in the main loop (`inject hang where main`); hang in the tick (`where tick`); level-1 ISR storm (`inject isr_storm duration_ms` / `where isr1`, delivered with ICD v0.5); LSI 17 and 47 kHz (`iwdg lsi_hz`) | no kick → IWDG reset ≤ 90 ms → PUL stops ≤ 100 ms after the hang; next boot reset cause IWDG (AC twin). Target → HG-14. |
| TC-SAF-FW-019-02 | U+T | M2 | – | kick rule (tick advanced since last kick); SAVE request while moving | kick only when the tick advanced; long window only inside an idle NVM operation (SAVE while moving → E_BUSY) (AC "extended only while idle"). |
| TC-SAF-FW-020-01 | U | M2 | `check_vectors.json` | every motion vector (one per refusal reason: ESTOP, HALT, FAULT, NOT_ENABLED, NOT_HOMED, LIMIT, AFE_STALE, AFE_SATURATED, DRV_UNPOWERED, DRIVER_ALARM, **PAUSED**, E_RANGE target/bound/speed/accel, loaded speed cap, step-rate cap, E_BUSY) | STATUS, detail and NACK bytes identical, no side effect (AC "command-check vectors, one per refusal reason"). |
| TC-SAF-FW-020-02 | T | M2 | random walk | 10 000-step random command/world walk; before each command the twin state is mapped to `FwState` and `ref_cmdcheck` predicts the verdict | live FW verdict = oracle verdict for every step (differential, catches context-filling errors the snapshot vectors cannot). |
| TC-SAF-FW-020-03 | S | M2 | `protocol.yaml`, ICD §3.2 | inspection | no relative-move command (AC inspection). |
| TC-SAF-FW-021-01 | T | M2 | U, load offsets 4.9 %, 5 %, 6 % FS from `zero_raw` | HOME without/with the confirmed flag; load trip during each homing phase | 6 % → E_CONFIRM; with flag runs; boundary per `>` rule; trip → stop, LOAD_LIMIT, HOME_FAILED ABORTED (AC). Pre-written: `test_home_load_precheck` (`load_offset` 400 000 counts > `home.max_load_raw` 322 123). |
| ~~TC-SAF-FW-022-01~~ | — | — | — | **Withdrawn in v0.3** (SAF-FW-022 withdrawn, SRS v0.5, D-36 / CR-01: the single red button is the E-stop, there is no physical holding STOP/BREAK button; HALT sources are the PC HALT command for GUI STOP-HALT and the Pause/Break key). The ID is kept and never reused. CR-01 regression checks moved to TC-FW-SW-003-01 (no STOP input, bit, event or source), TC-IF-012-01 and `test_cr01_stop_button_names_retired`. | — |
| TC-SAF-FW-023-01 | T | M2 | M(10), J(10), idle | PAUSE button and PC PAUSE; second press; PAUSE while PAUSED; while PAUSED: MOVE_ABS, MOVE_UNTIL_LOAD, HOME, JOG ≠ 0, JOG 0, STOP, HALT, ENABLE, DISABLE, ESTOP_CLEAR, FAULT_CLEAR, SET_PARAM, **RESUME**, HALT_CLEAR | controlled stop, PAUSED(src), EVENT PAUSED once, VALID = 0; second press → RESUME_REQUEST only, no pulse; motion starts → E_STATE **PAUSED** and PAUSED kept (D-30); other commands accepted without clearing PAUSED; **RESUME** → PAUSED cleared, PAUSE_CLEARED, no pulse (D-31); HALT_CLEAR → PAUSED cleared; PAUSE while idle also sets PAUSED; nothing restarts motion (AC as amended by D-30/D-31). |
| TC-SAF-FW-023-02 | T | M2 | M(10), J(10) | **race (D-30)**: PAUSE button at t; a JOG refresh / MOVE_ABS frame whose last byte arrives at t + k ms, k = −1…5 in 0.5 ms steps; PC PAUSE followed in the same burst by MOVE_ABS | no motion restarts in any case: the late command gets E_STATE PAUSED (or E_BUSY while STOPPING); no PUL edge after the controlled stop ends. |
| TC-SAF-FW-023-03 | T+U | M2 | U: `check_vectors` RESUME cases; T: R | **D-31**: (a) PAUSED → RESUME; (b) PAUSED + HALT latched by a PC HALT (GUI STOP-HALT / Pause/Break key; v0.3: no button source, D-36) ms before the RESUME frame → RESUME; (c) HALT + PAUSED → HALT_CLEAR; (d) PAUSED + ESTOP latched / + any FAULT → RESUME; (e) RESUME with nothing latched | (a) OK, only PAUSED cleared; (b) E_STATE (BLOCK HALT), **HALT and PAUSED both stay**; (c) both cleared (HALT_CLEARED, PAUSE_CLEARED); (d) E_STATE with ESTOP / FAULT bit, PAUSED stays; (e) OK no-op (pending ICD v0.4, OBS-P1-15); no clear or RESUME ever produces a PUL edge. |
| TC-SAF-FW-023-04 | U | M2 | as TC-SAF-FW-013-02 (`test_val_toctou`) | (v0.4.4, review FWR-03) PAUSE button press folded by the tick between `cmd_check()` and the execution of a JOG −1 mm/s | no PUL edge while PAUSED (D-30). Verifies: SAF-FW-023. |
| TC-SAF-FW-024-01 | T | M2 | J(10), M(10), HOMING, ENABLING, idle; E-stop closed | DRV_PWR off; toggles of 5, 19 ms; ENABLE/motion while off; power on at t_p and ENABLE at t_e (both orders) | stop + ENA disabled + NOT_ENABLED + HOMED = 0 + VALID = 0 ≤ 25 ms after the input change; EVENTs DRIVER_POWER(0), STOPPED(DRV_POWER_LOST) if moving, DRIVER_DISABLED(4) (ICD §6.2 rule, OBS-P1-03); short toggles ignored; ENABLE → E_STATE DRV_UNPOWERED; first PUL/DIR edge ≥ max(t_p, t_e) + 500 ms (AC twin). Target → HG-21. Pre-written: `test_drv_power_loss_while_jogging`. |
| TC-SAF-FW-024-02 | T | M2 | idle, SAVE with sector erase in progress | DRV_PWR off during the flash operation | reaction time reported; expected per SRS ≤ 25 ms — currently not met by design (DEF-P1-06). |
| TC-SAF-FW-025-01 | T | M2 | R; `drv.k1_weld_ms` ∈ {100, 200, 2000} | E-stop open with DRV_PWR held on; normal case: power drops 60 ms after the E-stop; FAULT_CLEAR while open + powered, after power off, after E-stop closed; sense disabled | no fault at 150 ms (k1 = 200); fault in (k1, k1 + 2 ms] after the E-stop edge with FAULT_SET(6, ms) (OBS-P1-02); normal case no fault, only DRIVER_POWER(0); FAULT_CLEAR E_CAUSE_ACTIVE while the cause persists, accepted after it is gone; sense disabled → never (AC). Target → HG-22. Pre-written: `test_k1_weld_window` (window (k1, k1 + 25] ms per SRS v0.5.1 / D-33 f; the v0.2 test bound k1 + 2 ms is reported as a design margin only). |
| TC-SAF-FW-026-01 | U+T | M2 | R; J(10) | ALM active + power on: MOVE_ABS, MOVE_UNTIL_LOAD, HOME, JOG ≠ 0 (new), ENABLE, STOP, HALT, PAUSE, JOG 0, clears; ALM during a MOVE_ABS; ALM during a jog then speed refreshes; ALM + DRV_PWR off; sense disabled | new starts → E_STATE DRIVER_ALARM; others accepted; move completes (MOVE_DONE TARGET) with ALM_CHANGED; jog refreshes still accepted; power off → DRV_UNPOWERED (not DRIVER_ALARM); sense disabled → DRIVER_ALARM (AC). Target → HG-16. |

### 3.3 Firmware (FW-)

| TC | Lvl | MS | Pre | Stimulus | Expected (AC) |
|---|---|---|---|---|---|
| TC-FW-PLT-001-01 | S | M1 | clean checkout | `pio run -d 02_FW -e nucleo_f446re` and `_debug`; inspect `platformio.ini`; map handler slots; `board_pins.h` vs `pinout.md` | build SUCCESS with flash/RAM figures; flags of FW_design §2.2 present; own IRQ handlers in their vector slots, no core HardwareSerial/HardwareTimer; pin init = pinout (AC). |
| TC-FW-PLT-002-01 | S | M1 | `hal/f446/clock.c`, init code | inspection | constants derived from `HAL_RCC_Get*Freq()`/`SystemCoreClock`, no hard-coded Stefan values; bounded HSE/PLL waits (AC inspection). |
| TC-FW-PLT-002-02 | T | M1 | B with `hal_clk_fallback()` = 1 | boot | STATUS `sys_flags.CLK_FALLBACK` = 1, EVENT CLK_FALLBACK at boot, no DATA bit (AC twin). Target PUL frequency → HG-02. |
| TC-FW-AFE-001-01 | U | M2 | `hx711_seq`, `hx711_math` | bit sequences for 0, 1, −1, 0x7FFFFF, 0x800000, random; pulse counts 25/27/26 | sign extension and pulse counts exact; origin note present (AC host part). Target → HG-05. |
| TC-FW-AFE-002-01 | T | M2 | R | SET `afe.gain_channel` A64/B32/A128, SET `afe.rate_sps` SPS10/SPS80 (idle), DEFAULT_PARAMS | next read uses 27/26/25 pulses — v0.3: observed as `seam_log` `hal_hx711_config gain_pulses=…` before the next delivered conversion (the twin does not model the bit-bang, §1.5 item 5; per-conversion `gain_pulses` in `query conversions` = REQ-C-M2-05); RATE output level follows (`query outputs` RATE) and the conversion interval in `query conversions` follows 10/80 SPS; no reboot; DEFAULTS → A128/80 SPS (AC). Silicon pulse count → HG-05. |
| TC-FW-AFE-003-01 | T | M2 | boot; R | boot; gain change; rate change; `afe.settle_discard` ∈ {0, 4, 20}; rail sample during settling (`afe raw_script`); SCK-high overrun / power-down symptom (`afe sck_overrun`, T-only) | first N samples flagged AFE_SETTLING and still load-checked (rail trips); overrun → re-init, `afe_reinit_count` + 1, EVENT AFE_REINIT (AC). |
| TC-FW-AFE-004-01 | U | M2 | `afe_rate` | Δt series incl. outliers, 2³² wrap, 80/10 SPS | median of 16 periods, 0.1 SPS resolution, mismatch flag at > `rate_tol_pct` (oracle). |
| TC-FW-AFE-004-02 | T | M2 | R | model at 10 SPS with 80 configured; 80 SPS ± 2 % for 10 min; tolerance boundary 20 %; recovery | flag + EVENT(1) ≤ 1 s; no flag at ± 2 %; EVENT(0) on recovery; STATUS rate reported (AC). Target → HG-05. |
| TC-FW-AFE-005-01 | T | M2 | M(30); twin start time 2³² − 5 s | samples across the t_us wrap | DATA `t_us` = virtual data-ready ± 2 µs; `setpoint_um` = steps at that instant converted (round half away) (AC). |
| TC-FW-MOT-001-01 | U | M2 | pulse-timing derivation | params at range ends and the H3 boundary, f_tick 90 MHz | PW and c_min per FW_design §5.6.1; H3 violations rejected (E_CONFIG). |
| TC-FW-MOT-001-02 | T | M2 | M(v) at the 50 kHz cap (v0.3: spm 2000 → `v_limit_um_s` 25 000 = 50 kHz); reversals | edge log; SET `pul_invert` / `ena_invert` (reboot-required) then SAVE + REBOOT; SET `dir_invert` | high = `pulse_high_ns` ± 1 tick, low ≥ `pulse_low_min_ns`, DIR setup ≥ `dir_setup_us` on every reversal, DIR never changes while running; PUL/ENA polarity unchanged until reboot with REBOOT_PENDING = 1 (AC twin). Target → HG-08. Twin note: `dir_invert` changes only the DIR edge level, not the world direction (§1.5 item 3). Pre-written: `test_pulse_timing_at_cap_and_dir_setup`. |
| TC-FW-MOT-002-01 | U+T | M2 | spm ∈ {100, 160, 800, 100 000} | positions after moves; `um_to_steps`/`steps_to_um` vectors | reported µm = steps·1000/spm round half away; counter changes only per completed pulse (edge log) (AC). |
| TC-FW-MOT-002-03 | U | M2 | `test_val_isrcore`: target `hal/f446/step_tim2.c` compiled twice on a TIM2 register model — without `HOST_TEST` (target entry: `TIM2_IRQHandler` → `step_isr_core(cnt)`, packed 64-bit result) and with it (seam entry: → `step_isr()` → `step_isr_core(hal_step_count())`, the twin's form); both drive the **real** core (`core/motion.c`, a real MOVE_ABS of 240 steps set up on A's fake seams) | (v0.4.12, re-check FW v0.8.6 / D-55) same inputs to both entries: plain move to its target (LAST), missed update (held ISR, count estimate → STOP), FWR-05 late latch (preload rewritten with the update pending), CLEAN / TRUNCATE / E-stop halts between ISRs at 10 phases incl. the FWR-21 window, halts with the ISR pending (DEF-M2-01), halts pre-empting the handler before the core is consulted; characterisation of a pre-emption beyond the D-52 budget | identical core calls (count argument and packed result), PUL rise times, completed pulses, update events, final count, stop generation and timer registers; the target's count argument equals the HAL count at the call; no runt and count = completed pulses (TRUNCATE: ± the cut pulse); the FWR-05 ISR takes the period the update started. Mutants (count − d, swapped late select, packing shift) are caught. Verifies: FW-MOT-002, SAF-FW-004, NFR-007 (no behaviour change). |
| TC-FW-MOT-003-01 | U+T | M2 | `ramp`, `planner` | U: every case of `motion_vectors.json` (v0.3: TV-M trapezoid / triangle / asymmetric triangle, default 10 mm move, 1 mm at 0.5 mm/s, controlled stop in cruise / in accel / near the end, JOG speed changes + JOG 0) and its 28 `ctrl_stop_paths` rows, via `test_val_ramp`; T: the TV-M 100 mm move at 640 steps/mm on the wire (`test_tvm_move_periods_on_the_wire`) | every period ± 1 tick, sum ± floor(N/1000) ticks, period count exact; path rows equal; T: periods reconstructed from the PUL falling edges equal the vector within the same tolerances, duration = planner ± 1 ms (AC). Oracle cross-check: the validator's `ramp_ref.py` reproduces all 9 vector cases exactly (`test_val_m2_oracles.py`). |
| TC-FW-MOT-003-02 | U | M2 | `ramp` | 1000 random (v, a_acc, a_dec, N) incl. on-the-fly speed changes and controlled stops (virtual index), generated by `ramp_ref.random_cases()` / `JogRamp` / `move_with_stop()` (same definitions as the vectors) | equals `val_oracles/ramp_ref.py` within the same tolerances; no step lost on a speed change (independent oracle). |
| TC-FW-MOT-003-03 | U | M2 | `test_val_isrcore` (float arithmetic of `ramp_next_inl()`) | (v0.4.12, D-55) the removed `acc` clamp: every float c ∈ [2^22, `RAMP_U32_MAX_F` = 2^32 − 256] with the largest carry below 1, and every 61st float in [1, 2^22) with carries {0, 1e-7, 0.25, 0.5, 0.75, 0.9999, 1 − 2^-24} | carry + c never exceeds `RAMP_U32_MAX_F` (the clamp could not fire), the next carry stays in [0, 1); > 80 M cases. Verifies: FW-MOT-003. |
| TC-FW-MOT-004-01 | T | M2 | R | MOVE_ABS 10 mm at 5 mm/s; second MOVE_ABS while moving; target = current position | exact final step count, MOVE_DONE(TARGET, value), duration = planner ± 1 ms; E_BUSY 1; zero-length → MOVE_DONE at once, no pulse (AC). Pre-written: `test_move_abs_busy_and_zero_length`, duration in `test_tvm_move_periods_on_the_wire`. |
| TC-FW-MOT-005-01 | T | M2 | R, U | jog to each soft limit; bound 0 (real position, soft_min ≤ 0); bound = 0x80000000; bound behind/outside; bound un-homed; un-homed jog beyond `home.max_travel_um`; speed change and reversal on the fly; JOG 0 in every state incl. ESTOP | never passes a soft limit / bound / un-homed travel bound (world truth); bound 0 honoured; E_RANGE 8 / E_STATE NOT_HOMED as specified; speed changes ramp without step loss; reversal decelerates to 0 with DIR setup; JOG 0 never refused; MOVE_DONE BOUND/SOFT_LIMIT/JOG_ZERO (AC). Pre-written (part): `test_jog_never_passes_soft_limit_and_bound`. |
| TC-FW-MOT-005-02 | U | M2 | as TC-FW-HOM-001-03 | (v0.4.9) jog +2 mm/s, reversal to −2 mm/s with the deceleration end inside a tick | no fault, MS_JOG, the reversed jog moves in the new direction. Verifies: FW-MOT-005. |
| TC-FW-MOT-006-01 | T (+U vectors) | **M3** (v0.4.2, D-44; was M4) | R, scripted samples (`afe raw_script`) | MOVE_UNTIL_LOAD with `cmp` 0 and 1; threshold already beyond (equality counts); bound before threshold; refusals (NOT_HOMED, speed 0 / above `v_max_load_um_s`, bound = x / outside the soft limits, `raw_stop` / `cmp` range, PAUSED, E_BUSY); AFE stall during the move; ICD v0.7.3 §5.4 rules **(a)** load limit first, **(b)** threshold during a controlled stop, **(c)** bound within one step, **(d)** LOAD_THRESHOLD is not a stop source, **(e)** start parked by a sniffed HALT; vectors `mul_*`, `immediate_stops`, `threshold_in_controlled_stop` | stop on the first sample past the threshold, no PUL edge > 200 µs after it, periods = prefix of `mul_to_bound_5mm`; already beyond → LOAD_THRESHOLD, no pulse; bound → BOUND exactly at the bound with the vector periods; E_RANGE offsets 0 / 4 / 12 / 16; stale → STOPPED(AFE_FAULT) (fallback frames are not samples); (a) FAULT_SET + STOPPED(LOAD_LIMIT) + MOVE_DONE STOPPED; (b) one STOPPED (first cause), deceleration cut short, periods = oracle with the actual stop step (one-period preload latency, ICD §6.5); (c) BOUND / LOAD_THRESHOLD at once, no pulse; (d) no STOPPED / VALID_CLEARED, VALID + HOMED kept, no POS_UNCERTAIN; (e) MOVE_DONE STOPPED, STOPPED(PC_HALT), no pulse after the HALT frame (AC). Suite `test_val_twin_m3_mul.py`. |
| TC-FW-MOT-007-01 | T | M2 | every motion state × latch combination | STOP 0/1, HALT ×20, PAUSE, while idle and moving | STOP not latched; HALT latch src PC, one HALT_SET for 20 HALTs, all OK; motion → E_STATE HALT until HALT_CLEAR; STOP/HALT/PAUSE accepted in every state; STOP while idle clears VALID (AC). |
| TC-FW-MOT-008-01 | T | M2 | NOT_ENABLED; `ena_settle_ms` ∈ {0, 500, 2000} | ENABLE; motion during settle; ENABLE with E-stop open/latched, with DRV_PWR off; DISABLE while moving / idle | ENA enabled level at once, ENABLING, motion → E_BUSY 2, first PUL/DIR edge ≥ settle after ENABLE and after DRV_PWR return; response = remaining ms; E_STATE ESTOP / DRV_UNPOWERED; DISABLE moving → E_BUSY 1; idle → ENA disabled, HOMED = 0, DRIVER_DISABLED(1) (AC). Target → HG-07. |
| TC-FW-MOT-009-01 | U+T | M2 | vectors `set_motion.steps_per_mm_*`, `spm_*`; R | SET 99, 100, 10 000, 100 000; SET while moving; after idle SET read positions; at spm 10 000 MOVE_ABS 10 mm/s | E_RANGE / OK / E_BUSY 1; HOMED kept, µm = steps·1000/spm; 10 mm/s → E_RANGE (offset 4), STATUS `v_limit_um_s` = 5000, v_max params unchanged (AC). |
| TC-FW-HOM-001-01 | T | M2 | U, world W; START bounce 2 ms; START active at start (`world_shift` −2 000 µm) | HOME at default and range-end speeds | phase sequence RELEASE → FAST_SEEK → BACKOFF → SLOW_APPROACH → MOVE_TO_ZERO in `home_phase`; HOMED, final x = 0, START edge at −`home.offset_um` ± 1 step (world truth); EVENT HOMED(0), MOVE_DONE TARGET; expected START edges do not set LIMIT_START; POS_UNCERTAIN cleared (AC). Oracle: `val_oracles/homing_ref.expect_home()` (phase order as a subsequence of the sampled `home_phase`, final `x_true` interval). Pre-written: `test_home_default_world`, `test_home_with_start_active`. |
| TC-FW-HOM-001-02 | U | M2 | `test_val_tickgen` (the real `core_tick_1ms()` on A's fake seams + switch world; documented exception to §1.1 rule 1) | (v0.4.8, re-check FWR-18) un-homed HOME; the expected START edge of FAST_SEEK (HAL CLEAN halt + record) injected (1) between two ticks, (2) inside a tick after the record take (`fake_peek_hook`) | homing completes in both: HOMED, no HOME_FAILED, no fault latched. Verifies: FW-HOM-001, FW-HOM-002, SAF-FW-002 (tick path). |
| TC-FW-HOM-001-03 | U | M2 | `test_val_tickgen` (real tick; step events processed INSIDE each tick after the record take = the step ISR pre-empting the tick; A's fake seams) | (v0.4.9, re-check FWR-20) un-homed HOME with the switch world | homing completes: HOMED, no HOME_FAILED, no fault. Verifies: FW-HOM-001, FW-HOM-002. |
| TC-FW-HOM-002-01 | T | M2 | U | START switch missing (`home.max_travel_um` 1 000 or `limit start position_um` far away); END reached (v0.3: END forced active during FAST_SEEK — the twin world cannot run backwards on an inverted DIR, §1.5 item 3; real DIR inversion → HG-28); START stuck (`limit start active` forced, not released within `HOME_RELEASE_MAX_UM` 10 mm); STOP, HALT, PAUSE, E-stop, load trip, link watchdog in each phase | HOME_NOT_FOUND / HOME_WIRING faults; abort → HOME_FAILED ABORTED without a homing fault, FAULT_CLEAR finds nothing homing-related; HOMED = 0 in every case; MOVE_DONE STOPPED (AC). Pre-written: `test_home_not_found_and_wiring`, `test_home_aborted_is_not_a_fault`. |
| TC-FW-HOM-003-01 | H | M2 | HG-26 | 10 homing cycles with a dial indicator | ≤ 0.02 mm (2σ) (AC, Should). |
| TC-FW-HOM-004-01 | T | M2 | R | inject lost steps (`world_shift`) of 0.1 mm, `drift_tol_um` ± 1 step, 0.3 mm; first homing after boot | 0.1 mm: no fault, HOMED value ≈ 100 µm; 0.3 mm: HOME_DRIFT (FAULT_SET(7, deviation)), HOMED set, motion E_STATE FAULT until FAULT_CLEAR (clears at once); first homing value 0 (AC). Expected deviation = −shift ± 1 step (`homing_ref`). Pre-written: `test_home_drift`. |
| TC-FW-SW-001-01 | U+T | M2 | M(10); `io.release_ms` ∈ {5, 20, 200} | hit with 5 ms bounce burst; release with bounce; stable 19 / 20 ms | one stop, one LIMIT_SET; release reported only after the stable time (AC). Stimulus `limit active … bounce_ms [...]`. |
| TC-FW-SW-002-01 | S+T | M2 | `irq_prio.h`, NVIC init, `crit.h` | inspection; twin release with bounce | EXTI15_10 alone at level 0; no BASEPRI section masks level 0 (only `CRIT_HALT` = PRIMASK, ≤ 1 µs per window, NFR-007; static bounds FW_design §9.8, DWT sections 11 / 16–18 at HG-18); RC τ ≤ 10 µs in pinout; release debounced ≥ `io.estop_release_ms` (AC). Target → HG-18. |
| TC-FW-SW-003-01 | T+S | M2 | R | PAUSE presses with bounce (`button pause … bounce_ms`); `io.pause_active_level` both values; DATA/STATUS bits; **CR-01 negative checks (v0.3):** grep/static S-11: no EXTI line 7 / PC7 input configured, no `io.stop_active_level`; twin: `button stop` / `wire stop` answer ok = false; across the whole M2 twin run DATA `status` bit 9 and STATUS `io` bit 3 are always 0, EVENT 22 and stop cause 4 never sent, `halt_src` never BUTTON (2) | one EVENT PAUSE_BUTTON per press (and release); polarity inverts detection without a spurious press; PAUSE_BTN bit and IO mask; EXTI level 1; retired STOP-button codes never emitted (AC as amended by D-36). |
| TC-FW-SW-004-01 | T+S | M2 | M(10) | ALM toggles; polarity parameters; PEND withheld after a move; `drv.pend_timeout_ms` = 0; ALM chatter 1 kHz for 1 s | ALM bit + ALM_CHANGED, motion continues; NOT_SETTLED after the timeout (value = elapsed), none with 0; inspection: no stop path from ALM; chatter does not cause STEP_FAULT or AFE timestamp errors (OBS-P1-10) (AC). |
| TC-FW-SW-005-01 | T | M2 | R | DRV_PWR toggles of 5, 19, 21 ms; changes; sense disabled after SAVE + REBOOT | toggles < 20 ms ignored; each accepted change → DS/IO bit + DRIVER_POWER; sense disabled → DRV_PWR = 1, no events (AC). Target → HG-21. |
| TC-FW-CFG-001-01 | S | M1 | repo | `gen_params.py --check`; grep `02_FW/src` for parameter ids/keys/tables outside `gen/`; diff `gen/*` vs generator output | `--check` exit 0; no hand-written table; generated files untouched (AC). |
| TC-FW-CFG-001-02 | S | M1 | modified COPIES of `params.yaml` / `protocol.yaml` in a tmp dir; generators run in memory (`02_FW/test/static/test_val_review_gen.py`) | (v0.4.4, review FWR-14) hostile text in: unit, enum label, c_member, dict_version (params); constant desc, table title, icd_version, table icd (protocol) | each value is rejected (DictError / ProtoError) or stays inert (inside a comment / string literal): no marker identifier in the comment-stripped C or in the Python AST. Control: the real YAML renders inert. Verifies: FW-CFG-001, IF-010. |
| TC-FW-CFG-002-01 | U+T | M1 | vectors; B with 20 random SETs | GET_ALL_PARAMS pages 0…page_count−1 and page_count | page frames byte-identical to vectors at defaults; every entry exactly once, ascending, current value; page_count → E_RANGE (AC). |
| TC-FW-CFG-003-01 | U | M1 | `check_vectors.json` | every `set_*` (default/min/max/below/above/NaN/type/padding/moving) and `rule_h1…h4` vector | STATUS/detail/NACK bytes identical (AC "vectors per parameter type"). |
| TC-FW-CFG-003-02 | T | M1 | B | random SET sequence; read back; flash write counter; SET `motion.ena_invert`, `motion.pul_invert`, `drv.pwr_sense_enable` | response = GET_PARAM; 0 flash writes; reboot-required: old behaviour kept, REBOOT_PENDING = 1 until SAVE + REBOOT; others effective ≤ 10 ms (AC). |
| TC-FW-CFG-004-01 | U+T | M1 | B | GET_INFO | proto 1.0, payload 1, FW version/build id = build constants, hash = `PARAM_DICT_HASH`, `param_count`, UID from the seam, feature mask (M1: AFE_SYNTHETIC + NVM + TWIN in the twin) (AC). |
| TC-FW-NVM-001-01 | T | M1 | B | SET → GET_STATUS; SAVE; REBOOT; DEFAULT_PARAMS; LOAD_PARAMS; SET of a session parameter | CFG_DIRTY 1 → 0 after SAVE (PARAMS_SAVED); values restored after reboot; DEFAULTS → defaults + dirty; LOAD → record values, session values kept; session SET never dirties (AC + ICD §11.2). |
| TC-FW-NVM-002-01 | U | M1 | `nvm_log` | slot selection, highest seq, CRC-bad skip, sector full → erase other, migration by id (retired 0x0401 dropped, new 0x0705 default, type change → default, out of range → default), hard-rule violation → defaults, seq wrap | equals `val_oracles/nvm_ref.py`. |
| TC-FW-NVM-002-02 | T | M1 | B | power cut after every program word and at erase start/middle, over ≥ 3 consecutive SAVEs including a sector switch; blank flash; changed hash | after every cut the boot finds a complete valid record (old or new, never mixed); blank → defaults + NVM_DEFAULTED + PARAMS_DEFAULTED(1); hash change → PARAMS_DEFAULTED(3); session parameters never in a record (decoded) (AC). |
| TC-FW-NVM-002-03 | A | M1 | FW_design §5.11 | endurance computation (slots × sectors × 10 000 cycles) | ≥ 10 000 saves (AC analysis). |
| TC-FW-NVM-003-01 | T | M1 | M(10); idle with a TX backlog (GET_ALL_PARAMS pages + events) | SAVE/LOAD/DEFAULT while moving; SAVE (with sector erase) while idle and streaming | E_BUSY 1 while moving (**M2**: no motion in M1; the U-level check vectors cover E_BUSY); wire log: no frame on the wire during the flash operation (operation starts only after TX idle); conversions missed during the stall → **OVERRUN on the next frame** (v0.2: no `frame_seq` gap expected — ICD §2.2/§5.2: `frame_seq` counts due frames, conversions not delivered during the AFE hold are not due) (AC twin). Target → HG-04. |
| TC-FW-CMD-001-01 | U | M1 | `protocol_vectors.json` | every frame, the 11 streams, check-order vectors (unknown TYPE, wrong LEN) | byte-identical encode/decode; frames and counters equal (AC "shared protocol vectors pass"). |
| TC-FW-CMD-001-02 | T | M1 | B and R | fuzz: 10 000 frames mixing valid commands, invalid TYPE, wrong LEN, bad CRC, noise; flood with > 4 outstanding commands | exactly one response per CRC-valid 0x01…0x3F command echoing its SEQ; invalid TYPE → no response, `rx_frame_errors` + 1; NACK has no side effect (STATUS snapshot identical except counters/link age); no lost response under flood (DEF-P1-07): v0.2 — every command frame that reaches the parser intact is answered; a flood beyond the RX ring (back-pressure, ICD §9.1 "bursts of up to 4 commands") is counted in `rx_overruns`. |
| TC-FW-CMD-002-01 | U+T | M1 | B stream on; start time near 2³² | SET_VALID 1/0; stream off; boot | frames with `t_us` ≥ returned t carry the new value, earlier the old one (modular across the wrap); stored with the stream off; VALID = 0 at boot (AC). |
| TC-FW-CMD-003-01 | T | M2 | parametrised over LOAD_LIMIT, AFE_FAULT, STEP_FAULT, LIMIT_WIRING, HOME_NOT_FOUND, HOME_WIRING, HOME_DRIFT, K1_WELDED; also two faults latched | FAULT_CLEAR with the cause present / gone | cause present → E_CAUSE_ACTIVE with the mask, **nothing** cleared (also the clearable one); gone → OK body = mask, FAULT_CLEARED; LOAD_LIMIT always clearable; ESTOP/HALT/PAUSED untouched (AC "one test per fault"). |
| TC-FW-CMD-004-01 | U+T | M1 | B | injection per counter: CRC error, LEN > 160, inter-byte timeout, invalid TYPE, RX ring overflow, TX congestion, event overflow, resets, AFE re-init, latches, inputs, motion | each STATUS counter/field increments or changes exactly under its condition; STATUS frame encode = vector (AC). |
| TC-FW-STR-001-01 | T | M1 | B | boot; STREAM_START ×2, STREAM_STOP ×2 | no DATA after boot; idempotent; `frame_seq` not reset; SAF suite with the stream off = TC-SYS-002-01 (AC). |
| TC-FW-STR-002-01 | T | M1 | B stream on (M1 synthetic; M2 HX711 model) | 10 min at 80 Hz; concurrent GET_ALL_PARAMS polling (168 B frames) + 20 commands/s | DATA count = conversions; DRDY → first DATA byte ≤ 2 ms with an idle line, ≤ 2 ms + wire time of the frame in transmission otherwise (max reported) (AC). |
| TC-FW-STR-003-01 | U+T | M1 | DATA vectors; R | DATA "all bits" vectors; table-driven: provoke each of the 23 flags/status bits (v0.3: status bit 9 STOP_BTN retired, must stay 0; feature-dependent bits ALM/PEND/DRV_PWR are 0 and invalid while FEAT_DRV_SIGNALS = 0, D-37 b) | encode byte-identical; each bit set exactly under its condition and cleared accordingly (AC). v0.2: M1 provokes VALID, HALT, PAUSED, AFE_STALE, NO_AFE_DATA, AFE_SATURATED, AFE_SETTLING, AFE_RATE_MISMATCH, OVERRUN, DRV_PWR; MOVING, HOMED, ENABLED, ESTOP, FAULT, LIMIT_*, LOAD_LIMIT, LINK_WDG, PAUSE_BTN, ALM, PEND, POS_UNCERTAIN need M2 sources (re-run at M2, condition E-C2). OVERRUN only for losses in the FW (ICD §7.6 bit 7). |
| TC-FW-STR-004-01 | T | M1 | R stream on | TX congestion dropping k ∈ {1, 5, 50} frames; NVM stall | `frame_seq` gap = k, OVERRUN only on the next sent frame, `tx_drops` + k (AC). |
| TC-FW-STR-005-01 | T | M2 | R; `stream.fallback_hz` ∈ {1, 10, 80} | DOUT silent 10 s, then resume | fallback frames at the rate ± 1 frame/s with NO_AFE_DATA + AFE_STALE, raw 0x80000000; stop at resume (AC, Should). |
| TC-FW-STR-006-01 | T | M2 | scenario per code | trigger each EVENT code 1…34 except the retired 22 STOP_BUTTON (never sent, v0.3 D-36) (+ PAUSE_CLEARED reasons incl. RESUME per ICD v0.4; BOOT value/value2 from a HardFault record: `reset cause hardfault`, REQ-C-M2-04 / OI-FW-32); burst > queue depth | each EVENT with correct code/arg/value and `t_us` (= trigger, ± 1 ms for tick-detected causes); EVENT SEQ +1 incl. drops; overflow counted; depth ≥ 8 (AC). |
| TC-FW-TIM-001-01 | T | M2 | M(50 kHz) | data-ready at the same virtual instant as level 0–2 events; t_us across the wrap | DATA/EVENT/SET_VALID time base monotonic modulo 2³²; timestamp latency ≤ 5 µs (twin model) (AC twin). Target → HG-05. |
| TC-FW-PAR-001-01 | S | M1 | SRS Table 5.1, `params.yaml`, generated C/Python | `check_static.py` table diff (AFE group) | ranges ⊇ listed, defaults equal, present in generated outputs (AC). |
| TC-FW-PAR-002-01 | S | M1 | as above (mechanics/pulse timing) | same; reboot-required flags on PUL/ENA polarity | equal; ENA settle default 500 (AC). |
| TC-FW-PAR-003-01 | S | M1 | as above (speeds/accels) | same; units check | equal; H4 present; no step-unit speed (AC). |
| TC-FW-PAR-004-01 | S+U | M1 | as above (travel/homing) | same; H1 vectors | equal; no home-switch parameter; `rule_h1` vectors pass (AC "I, T"). |
| TC-FW-PAR-005-01 | S | M1 | as above (safety) | same; `nvm: false` on the three session parameters | equal (AC). |
| TC-FW-PAR-006-01 | S | M1 | as above (I/O, drv, stream) | same; search for E-stop/limit/DRV_PWR polarity parameters | equal; none of the forbidden polarity parameters (AC). |

### 3.4 Interface (IF-, FW side)

| TC | Lvl | MS | Pre | Stimulus | Expected (AC) |
|---|---|---|---|---|---|
| TC-IF-001-01 | S | M1 | ICD, `src/**` | grep for literal TYPE/STATUS/EVENT/bit values outside `gen/`; ICD version + history | every code used comes from `proto_gen.h`; ICD versioned with history (AC). |
| TC-IF-002-01 | U+S | M1 | `le.h`, BRR computation | LE vectors; BRR from PCLK1 45 MHz | little-endian round trip; 918 367 Bd (−0.35 %) (AC host part). Target soak → HG-03. |
| TC-IF-003-01 | U | M1 | parser | 11 `streams` vectors + validator corpus of 10⁵ random streams with expectations generated by `ref_codec.FrameParser` | frames and counters identical (AC + differential). |
| TC-IF-004-01 | U+T | M1 | CRC | `crc16` vectors ("123456789" → 0x29B1, empty → 0xFFFF); corrupted command frames in the twin | equal; corrupted frames: no action, `rx_crc_errors` + 1 (AC). |
| TC-IF-005-01 | T | M1 | R (v0.2: B in M1 — no motion; MOVE_ABS is refused, no pulse; the double-motion part is re-run in M2 with R) | same MOVE_ABS frame (same SEQ) sent twice; query/parameter commands repeated with new SEQ | each answered once with its SEQ; the FW does not de-duplicate (second MOVE_ABS → E_BUSY or zero-length move), no double motion (FW part of AC; SW retry rules → Validator F). |
| TC-IF-006-01 | U+S | M1 | DATA vectors, ICD §7.3 | decode/encode every field; layout review | every field decoded; layout = ICD (AC). |
| TC-IF-007-01 | T | M1/M2 | B stream on | 10 min incl. two DOUT stalls | DATA frames = conversions; fallback frames only during stalls and marked NO_AFE_DATA (AC). |
| TC-IF-008-01 | T | M1 | B | GET_INFO; every DATA frame | proto/payload/hash fields correct; `payload_version` = 1 in every DATA frame (FW part; SW reaction → Validator F). |
| TC-IF-009-01 | S+U | M1 | ICD, `protocol.yaml`, vectors | review of units; codec vectors | wire units µm, µm/s, µm/s², µs, counts; absolute targets only (AC). |
| TC-IF-010-01 | S | M1 | CI | `gen_params.py --check`, `gen_vectors.py --check`; pre-script reads vectors in place; anti-skip counts | exit 0; same JSON files consumed by FW and SW; executed counts = JSON counts (AC). |
| TC-IF-011-01 | A+T | M1 | R stream on, 10 min with events | twin wire log byte count; congestion with a STOP/HALT/PAUSE command | FW→PC ≤ 10 % of 92 160 B/s; the stop executes before its response is queued and the response is never dropped (FW part of AC). |
| TC-IF-012-01 | S+T | M1 | `proto_gen.h`, dispatch table | each of the 26 commands (25 of ICD v0.2 incl. PAUSE 0x3B, plus RESUME 0x3C per ICD v0.4) sent once; v0.3: + DIAG_MEAS once it is in the ICD (REQ-C-M2-01) | no E_UNKNOWN_CMD for a defined command (M1: motion commands may answer E_INTERNAL NOT_IN_BUILD with feature bit 0; release and twin builds: DIAG_MEAS → E_INTERNAL NOT_IN_BUILD, FEAT_HW_MEAS = 0) (AC checklist). |

### 3.5 Non-functional (NFR-005…008)

| TC | Lvl | MS | Pre | Stimulus | Expected (AC) |
|---|---|---|---|---|---|
| TC-NFR-005-01 | S+T | M1 | release map file; twin | `check_static.py`: malloc/free/calloc/realloc/_sbrk/_malloc_r/operator new/delete, printf family, HardwareSerial, HardwareTimer; heap usage; STATUS `stack_free_min` | no allocator symbol, heap 0; stack high-water reported (AC). Target value → HG-18. |
| TC-NFR-006-01 | S+H | M2 | source; HG-18 | inspection for waits/loops without a bound < 1 ms outside the NVM PROGRAM pass; target `loop_max_us` (STATUS, release image) at 50 kHz + 80 Hz + 20 cmd/s | no blocking construct; `loop_max_us` ≤ 1000 µs (AC target; evidence kind OC — the FW's own TIM5-based figure, cross-checked with the `HW_MEAS_DWT` main-loop histogram, §6.5 HG-18). |
| TC-NFR-007-01 | S+H | M2 | disassembly; HG-18 | static cycle count of the stop primitive / E-stop / limit handlers and of every critical section; `HW_MEAS_DWT` build (DWT entry/exit stamps per ISR and per `CRIT_*` section, instrumentation overhead calibrated with an empty stamp pair); non-intrusive cross-check of the step CPU load by the idle-loop counter method (main-loop passes/s with and without 50 kHz stepping, `HW_MEAS`) | step ISR ≤ 2 µs, step CPU ≤ 15 % at 50 kHz, windows masking NVIC levels 0–2 ≤ 1 µs, E-stop / limit ISR ≤ 1 µs (v0.3: STOP ISR retired, D-36) (AC; interpretation OBS-P1-04). |
| TC-NFR-008-01 | T | M1 | R stream on, 20 commands/s | every command type; SAVE (with erase), LOAD, DEFAULT | last request byte → first response byte ≤ 10 ms; NVM commands ≤ 2.5 s with the twin's 500 ms erase model (AC twin). Target sample → HG-27. |

### 3.6 Coverage summary

| Group | Requirements in scope | Must / Should | TCs | U | T | S/A | H-only |
|---|---|---|---|---|---|---|---|
| SYS | 11 | 11 / 0 | 16 | 3 | 4 | 6 | 3 |
| SAF-FW | 25 (+ 1 withdrawn) | 25 / 0 | 50 (+ 1 withdrawn) | 17 | 30 | 3 | 0 |
| FW-PLT/AFE/MOT/HOM/SW | 25 | 24 / 1 | 34 | 13 | 17 | 3 | 1 |
| FW-CFG/NVM/CMD/STR/TIM/PAR | 24 | 23 / 1 | 29 | 8 | 12 | 9 | 0 |
| IF | 12 | 12 / 0 | 12 | 4 | 3 | 5 | 0 |
| NFR-005…008 | 4 | 4 / 0 | 4 | 0 | 1 | 3 | 0 |
| **Total** | **101** | **99 / 2** | **145** | **45** | **67** | **29** | **4** |

Counting rule: a TC is counted once at its primary level (combined levels such as "U+T" count at the first letter); withdrawn TCs keep their row and are not counted. **v0.4.14:** +1 TC (TC-SYS-009-04 U). **v0.4.12:** +2 TCs (TC-FW-MOT-002-03, -003-03 U). **v0.4.10:** +2 review TCs (TC-SAF-FW-002-05, -004-05 U). **v0.4.4:** +6 review TCs (TC-SAF-FW-002-04, -004-04, -013-02, -023-04 U; TC-FW-CFG-001-02 S; TC-SYS-009-03 U). **v0.3:** −1 TC (TC-SAF-FW-022-01 withdrawn with SAF-FW-022, D-36), +1 TC (TC-SYS-009-02, measurement-build differential, CR-02). By milestone: **M1** 45 TCs for 40 requirements; **M2** 83 TCs for 60 requirements; **M4** 1 TC (FW-MOT-006) — v0.4.2: moved to **M3** (D-44). Every in-scope requirement has ≥ 1 TC (101/101 = 100 %); 98 requirements have a host-runnable (U/T/S/A) TC and 3 (SYS-009 — apart from its measurement-build check —, SYS-011, FW-HOM-003) are verified only at the hardware gate. Requirements with an additional **+H** part (open under D-06): SYS-004/005/006/009/011, SAF-FW-002/004/005/018/019/024, FW-PLT-002, FW-AFE-001/004, FW-MOT-001, FW-HOM-003, FW-SW-005, FW-NVM-003, FW-TIM-001, IF-002, NFR-006/007/008 (**23** requirements → §6; v0.2: 24 incl. SAF-FW-022).

---

## 4. Fault-injection catalogue (FW host twin)

"Vocab" (v0.3) = availability in the as-built twin (`tools/README.md` vocabulary v2, `twin.py`): **yes**, **T** = twin-only action, **REQ-C-M2-nn** = still missing (§4.1). v0.1 "ext" entries that the Integrator delivered are now "yes".

| FI | Fault | Injection | Parameters | Expected FW reaction | Vocab | Used by |
|---|---|---|---|---|---|---|
| FI-01 | Switch bounce on hit/release | limit / PAUSE / E-stop / DRV_PWR edge bursts (`bounce_ms`) | burst 0.1–5 ms, 1–20 bounces; release stable 19/21 ms | first edge acts, one stop, one EVENT; release only after `io.release_ms` | yes | FW-SW-001/003, SAF-FW-006/013/023 (v0.3: SAF-FW-022 withdrawn) |
| FI-02 | Wire break (NC) | `wire broken` | E-stop sense, START, END, DRV_PWR aux (v0.3: no STOP input; `wire stop` → ok = false) | reads active / unpowered → stop + latch/flag | yes | SAF-FW-007, FW-SW-005 |
| FI-03 | Both limits active | START and END forced | idle / moving / homing | LIMIT_WIRING, motion refused | yes | SAF-FW-014 |
| FI-04 | DOUT stall | `afe stall`, `afe miss_next` | permanent; 1 missed edge; stall 50/99/100/101/500 ms (v0.3: timeout default 250 ms → 249/250/251 ms) | AFE_STALE, AFE_FAULT if moving, fallback frames, missed-edge kick | yes | SAF-FW-012, FW-STR-005, IF-007 |
| FI-05 | HX711 rate error | `afe.rate_error` | 10 vs 80 SPS, ±2 %, ±20 % | AFE_RATE_MISMATCH ≤ 1 s or none | yes | FW-AFE-004 |
| FI-06 | SCK overrun / HX711 power-down | `afe sck_overrun` (status bit 0 of the next sample) | one read, repeated | re-init, counter + 1, settle discard | T | FW-AFE-003 |
| FI-07 | Rail / threshold samples | `afe saturate`, `afe raw_script` (≤ 256 values) | ±rail, raw_max ± 1, regrow steps | LOAD_LIMIT trip rules | yes | SAF-FW-008…011 |
| FI-08 | Flash power cut | `flash cut_after_word / cut_in_erase` | every n for 3 SAVEs incl. sector switch | valid old or new record at boot, never mixed | yes (used in M1) | FW-NVM-002 |
| FI-09 | Link silence | `inject link_silence` | timeout ± 1 ms; idle/moving/homing | controlled stop at timeout, LINK_WDG, restore on next valid command | yes | SAF-FW-015, SYS-002 |
| FI-10 | RX corruption / noise / overflow | `inject rx_corrupt`; `rx_bytes at_us`; ring overflow | bad CRC, LEN 0xFFFF/161, truncation, 3 KB burst | counters, resync, no action on bad frames, `rx_overruns` | yes (used in M1) | IF-003/004, FW-CMD-001/004 |
| FI-11 | TX congestion | `inject tx_congestion` | drop 1/5/50 DATA frames | `frame_seq` gap, OVERRUN, responses never dropped | yes | FW-STR-004, IF-011 |
| FI-12 | FW hang / IWDG | `inject hang where main/tick`, `inject isr_storm` / `where isr1`, `iwdg lsi_hz` | main loop, tick, level-1 ISR storm; LSI 17/47 kHz | reset ≤ 90 ms, PUL stops ≤ 100 ms, cause IWDG | yes (ISR storm since ICD v0.5) | SAF-FW-019 |
| FI-13 | K1 weld | `estop open` with `drv_power on` held | 150/200/2000 ms, sense on/off | K1_WELDED after `drv.k1_weld_ms`, clear rules | yes (with `drv_power_follows` off) | SAF-FW-025 |
| FI-14 | Driver power loss | `drv_power on:false` (+ `bounce_ms`) with E-stop closed | during jog, move, homing, ENABLING, idle, SAVE; toggles 5/19/21 ms | stop, ENA disabled, NOT_ENABLED, HOMED 0 ≤ 25 ms; short toggles ignored | yes | SAF-FW-024, FW-SW-005, FW-MOT-008 |
| FI-15 | Driver ALM | `alm active`, `chatter input alm` | idle powered/unpowered, during move/jog, 1 kHz chatter | start-block only, no stop, ALM_CHANGED | yes (chatter T) | SAF-FW-026, FW-SW-004 |
| FI-16 | PEND withheld | `pend active:false` before the move ends | timeout 0/200 ms | NOT_SETTLED warning | yes (manual; automatic driver PEND model REQ-C-M2-07, optional) | FW-SW-004 |
| FI-17 | Step overrun | `inject step_fault` | during accel/cruise/decel | STEP_FAULT, HOMED cleared, POS_UNCERTAIN | yes | SAF-FW-004 |
| FI-18 | Lost steps (open loop) | `world_shift um` | 0.1 / 0.2 / 0.3 mm | HOME_DRIFT rule at re-homing | yes | FW-HOM-004 |
| FI-19 | HSE failure | `clk hse_fail` (next boot) | – | CLK_FALLBACK in STATUS + EVENT | T (used in M1) | FW-PLT-002 |
| FI-20 | Inputs active at boot / reset during motion | `reset cause pin/power/iwdg/software/hardfault` with inputs set | pin/power/IWDG/software/HardFault | boot latches, NOT_ENABLED, reset cause, BOOT value/value2 | yes (hardfault since ICD v0.5) | SAF-FW-007/018, FW-STR-006 |
| FI-21 | PAUSE race | PAUSE edge + JOG/MOVE_ABS frame (`rx_bytes at_us`) at offsets −1…+5 ms; RESUME vs PC-HALT race (v0.3: no STOP button) | 0.5 ms steps; main loop loaded (`inject loop_load`, REQ-C-M2-02) | D-30: no restart; D-31: RESUME refused with HALT latched | yes (+ REQ-C-M2-02) | SAF-FW-023 |
| FI-22 | Switch missing / swapped DIR | START moved out of reach (`limit start position_um`, or small `home.max_travel_um`); END forced active during FAST_SEEK | – | HOME_NOT_FOUND / HOME_WIRING | yes (real DIR inversion: REQ-C-M2-06 or HG-28) | FW-HOM-002 |
| FI-23 (v0.3) | Main-loop load | `inject loop_load us_per_pass, duration_ms` (each pass consumes virtual time) | 100 / 500 / 900 µs per pass | stop paths (sniffer / tick) unaffected; DEF-P1-04 hold effective | **REQ-C-M2-02** | SAF-FW-002/003/023 |
| FI-24 (v0.3) | DIR wiring inverted (world) | world direction from the DIR pin XOR `dir_wiring_inverted` | – | HOME_WIRING / first-jog direction check | **REQ-C-M2-06** (optional; else HG-28) | FW-HOM-002, FW-MOT-001 |

### 4.1 Twin vocabulary needed by the M2 TCs (v0.3; request list to the Integrator)
Status checked against `00_System/tools/fw_twin/twin.py` + `engine/` and `tools/README.md` on 2026-10-04 (ICD v0.5 in
progress). "yes" = implemented and sufficient; the REQ items are the only twin changes the M2 TCs still need.

| Action / observation | Twin status | Needed by (M2 TCs) | Request |
|---|---|---|---|
| `estop` (open, `drv_power_follows`, `k1_delay_ms`, `bounce_ms`) | yes | TC-SAF-FW-001/005/006/007/025-01, TC-SYS-006-01, TC-SAF-FW-024-01 (normal E-stop case) | – |
| `drv_power` (on, `bounce_ms`) | yes | TC-SAF-FW-024-01/02, TC-FW-SW-005-01, TC-FW-MOT-008-01 | – |
| `button pause` (pressed, `bounce_ms`); `button stop` | yes; `stop` retired (ok = false, CR-01) | TC-SAF-FW-003/023-0x, TC-FW-SW-003-01 | – |
| `limit` (forced `active`, `position_um`, `bounce_ms`) | yes | TC-SAF-FW-013/014-01, TC-FW-SW-001-01, TC-FW-HOM-001/002-01 | – |
| `wire` (all inputs) | yes; `stop` retired | TC-SAF-FW-007-02 | – |
| `chatter` | yes (T) | TC-FW-SW-004-01 (ALM 1 kHz) | – |
| `alm`, `pend` | yes (PEND manual only) | TC-SAF-FW-026-01, TC-FW-SW-004-01 | REQ-C-M2-07 (optional automatic PEND) |
| `specimen` spring / bilinear, `load_offset` | yes (relaxation M3) | TC-SAF-FW-011/017/021-01 | – |
| `afe` (rate_error, noise, stall, saturate, drop_every, miss_next, sck_overrun, raw_script) | yes | TC-SAF-FW-008…012, TC-FW-AFE-*, TC-FW-STR-005-01, TC-IF-007-01 | REQ-C-M2-05 (`gain_pulses` per conversion) |
| `world_shift` | yes | TC-FW-HOM-004-01 | – |
| `inject step_fault`, `link_silence`, `tx_congestion`, `rx_corrupt`, per-command faults | yes | TC-SAF-FW-004-03, -015-01, TC-FW-STR-004-01, TC-IF-005-01 | – |
| `inject hang where main / tick`, `iwdg lsi_hz` | yes | TC-SAF-FW-019-01/02 | – |
| `inject isr_storm` (`duration_ms`) / `hang where isr1` | yes (ICD v0.5, 2026-10-04) | TC-SAF-FW-019-01 | REQ-C-M2-03 delivered — verify at M2 |
| `inject loop_load` (main-loop pass consumes virtual time) | **no** | TC-SAF-FW-002-01/03, TC-SAF-FW-023-02 (FI-23) | **REQ-C-M2-02** |
| `rx_bytes at_us`, `on_frame`, `on_event` | yes | TC-SAF-FW-002-01/03, -023-02/03 races, TC-IF-005-01 | – |
| `flash cut_*` | yes | TC-SAF-FW-024-02 (DRV_PWR during SAVE), FW-NVM (M1) | – |
| `clk hse_fail`, `reset` pin / power / iwdg / software | yes | TC-SAF-FW-018-01, -007-03, TC-FW-PLT-002-02 | – |
| `reset cause hardfault` (HardFault record, seam v1.2 accessor) | yes (ICD v0.5, 2026-10-04); FW accessor OI-FW-32 with A | TC-FW-STR-006-01 (BOOT value/value2) | REQ-C-M2-04 delivered — verify at M2 |
| `query` world / pulses / outputs / edges / seam_log / wire_log / sent / flash / conversions / inputs | yes (`log_max` 200 000 entries: the TV-M move alone produces 128 000 PUL edges) | every T TC | REQ-C-M2-10 (Low: larger log or per-query ring) |
| World direction from the DIR pin (`dir_wiring_inverted`) | **no** (world follows the model counter, §1.5) | TC-FW-HOM-002-01 (real inversion), TC-FW-MOT-001-02 (`dir_invert` effect), TC-SAF-FW-004-01 (independent world truth) | REQ-C-M2-06 (optional; else HG-28) |
| Twin model of DIAG_MEAS (`hal_meas_cmd`) | **no** | dry run of `00_System/tools/hil/hil_*.py` before the HW gate (§6.4) | REQ-C-M2-08 (Should) |
| Scenario `params` / world `steps_per_mm` | yes (`schema` + `version` mandatory) | TC-FW-MOT-001-02 (2000 spm), -003-01 (640 spm) | – |
| `hal_inputs_config` seam log still prints `stop=` (`twin_seams.c:211`) | cosmetic CR-01 leftover | – | REQ-C-M2-09 |

---

## 5. Entry / exit criteria and verdict format

### 5.1 M1 (link & skeleton)
**Entry** (all required before Validator E starts M1 validation):
1. SRS ≥ v0.4 with D-30/D-31 incorporated; ICD v0.4 (RESUME) with regenerated `protocol.yaml` outputs and vectors; `gen_params.py --check` and `gen_vectors.py --check` exit 0 (today both exit 1 — OBS-P1-09).
2. FW_design ≥ v0.2 with seam v1 frozen and **the same seam list in `tools/README.md`** (DEF-P1-02).
3. Implementer A evidence (FW_design §9.3): `pio test -e native` green with case counts, release + debug build SUCCESS with flash/RAM figures and A's map check PASS.
4. `fw_twin.exe` (Integrator) builds from the unchanged sources and supports the M1 subset of §1.3 (lock-step, wire log with timestamps, byte injection, flash power cut).
5. `units_vectors.json` available (OI-FW-20) or the validator oracle accepted by the Orchestrator for SYS-003.

**Exit — GO**: every M1 TC (45) passes twice (fixed + random order/seed); 40/40 M1 requirements verified at host/twin/static level; zero open DEF of severity High/Medium against M1 code; vector counts equal the JSON counts. **GO WITH CONDITIONS**: as GO but with open Low DEFs or Medium DEFs that have an accepted fix plan and no safety impact, and with the +H parts of FW-PLT-002, FW-NVM-003, IF-002, NFR-008 open (D-06) — these are always listed as conditions until the hardware gate. **NO-GO**: any failing TC of a Must requirement without an accepted waiver, any High DEF, or missing evidence.

### 5.2 M2 (sensor & motion)
**Entry** (v0.3 status in brackets): M1 GO / GO WITH CONDITIONS with its conditions closed or carried [M1 accepted with conditions E-C1…E-C4]; SRS clarifications of §8 in the SRS [done in v0.4/v0.5.1]; DEF-P1-01 resolved [H5, dict 3]; DEF-P1-04 answered in FW_design [§5.6.2/§5.9.3 sniffed-stop hold]; **CR-01** in SRS v0.5 [done], ICD v0.5 + regenerated outputs with both `--check` exit 0 [done 2026-10-04, S-09 PASS], `pinout.md` / `wiring.md` / FW_design [open: REQ-A-M2-01/02/05]; twin vocabulary per §4.1 with REQ-C-M2-02 delivered (REQ-C-M2-03/04 delivered with ICD v0.5; REQ-C-M2-05…11 may follow during M2); `motion_vectors.json` [published 2026-10-04, reproduced by the validator oracle]; E-C4 / D-37 a SAVE exemption in SRS/ICD [done in SRS v0.5.1].
**Exit — GO**: all 83 M2 TCs pass twice (fixed + random order); the pre-written suites of §2.1 run with **no skip / ignore left** (every gated test executed against A's M2 build, FEAT_MOTION/HOMING/AFE/BUTTONS/DRV_SIGNALS = 1); `test_val_ramp` 9/9 vector cases + 28/28 path rows with the anti-skip count; carried M1 conditions E-C2 (motion/input parts of TC-FW-NVM-003-01, TC-IF-005-01, TC-FW-STR-003-01) pass; SAF-FW suite passes in L1, L2 and L3 (TC-SYS-002-01); 10 000-stop count test and 10 000-step differential walk clean; CR-01 regression clean (TC-FW-SW-003-01); no High/Medium DEF open. **GO WITH CONDITIONS**: the +H parts listed in §3.6 and the hardware-gate list §6 open under D-06 (mandatory condition: no motion under load on target before HG pass); in addition the measurement build `HW_MEAS` and its differential check TC-SYS-009-02 must exist before the HW gate (condition if not yet delivered at M2 exit). **NO-GO**: any failing SAF-FW TC, or a High DEF.

M4 (FW-MOT-006) uses the M2 criteria for its single TC. **v0.4.2:** FW-MOT-006 was pulled forward (D-44) and is verified at the **M3** gate with the M2 criteria (`FW_test_report_M3.md`).

### 5.3 Hardware gate HG1 (v0.3, CR-02)
**Entry**: PO approval reference (D-06), board and COM port named by the PO; M2 GO / GO WITH CONDITIONS; release image
and `HW_MEAS` / `HW_MEAS_DWT` images built from the same commit, TC-SYS-009-02 PASS; `pinout.md` / `wiring.md` with the
measurement header (REQ-A-M2-01/02) and the header fitted; `hil_*.py` reviewed by the Integrator and dry-run against the
twin (REQ-C-M2-08) or, without the twin model, reviewed line by line; DIAG_MEAS in the ICD (REQ-C-M2-01); HG-29
measurement-chain self-test PASS on the day. **Exit**: every HG item PASS with its uncertainty added (§6.1 rule 4) or
accepted under a residual-risk entry of §6.6 by the Orchestrator/PO; HG-30 release-image confirmation PASS; no motion under
load before HG-01…HG-24, HG-28, HG-29 pass (SYS-009). Verdict format §5.4, report `FW_test_report_HG1.md`.

### 5.4 Report and verdict format (`FW_test_report_<gate>.md`)
1. Header: gate, date, FW commit/build id, ICD/dict versions + hash, tool versions (gcc 13.1, PlatformIO 6.2, Python), host.
2. Evidence: every command run with pass/fail counts (`pio test …` cases/fail/ignored, pytest passed/failed/seed, static checks).
3. Coverage table: requirement → TCs → result (PASS / FAIL / OPEN-H / BLOCKED).
4. Findings: `DEF-Mx-nn` (severity High/Medium/Low, file:line, evidence, fix hint, addressee) and `OBS-Mx-nn`.
5. **Verdict: GO / GO WITH CONDITIONS / NO-GO**, conditions numbered with owner and closure point.

---

## 6. Hardware-gate check list (v0.3: re-planned without oscilloscope / logic analyser — CR-02, D-35 G5)

Merged list as in v0.2 (`wiring.md` C-01…C-23 + SYS-009 + every +H criterion of §3.6). HG-01…HG-28 keep their v0.2
meaning; their **methods** are replaced: the PO has no oscilloscope and no logic analyser (D-35 G5), so every timing value
comes from an **on-chip measurement build** (`HW_MEAS`, §6.3) reading timer captures of looped-back signals (§6.2), from the
**PC**, or from a **multimeter / caliper / dial indicator**; what none of these can show is stated as a residual risk with an
acceptance alternative (§6.6). HG-29…HG-31 are new (measurement-chain self-test, release-image confirmation, loopback hygiene).

### 6.1 Measurement principles and tools
1. **Hardware time, not the code under test.** A target timing budget is measured by timer capture / DMA in hardware,
   never by the reacting FW path reading a clock. FW self-reports (`loop_max_us`, `nvm_save_ms`, EVENT `t_us`) count only
   where the requirement defines them as the measure (NFR-006, SAF-FW-025 logic timing) and are cross-checked where possible.
2. **Reference points.** Event = the electrical edge at the MCU pin node (after the input RC), seen by a second timer
   input jumpered to that node; stop = the last PUL edge at the driver-side node (MCU pin during the direct 3.3 V
   bring-up, buffer output after SYS-011).
3. **Trials.** 100 per path (SRS) with a seeded random phase against the step timer (stimulus MT-7) + 10 real actuations
   of the switch / button; the phase distribution is reported (it must cover the guard window before a pulse: 1.5 µs since FW v0.8.5,
   OBS-RC-7).
4. **Decision with uncertainty u.** PASS if max(measured) + u ≤ budget; FAIL if max(measured) − u > budget; otherwise
   INCONCLUSIVE → repeat in a finer mode or decide under §6.6.
5. **Measured image = release logic.** `HW_MEAS` adds capture / DMA / stimulus code in `hal/f446/meas*.c` only;
   TC-SYS-009-02 proves byte-identical safety handlers and core; HG-30 repeats the functional safety items on the release
   image.
6. **Common clock.** All on-chip timers share the PLL; absolute accuracy is established once against the PC (HG-02), and
   every budget has more than 2× margin over a 0.1 % clock error.

| MT | Tool | Resource (proposal; A finalises, REQ-A-M2-03) | Resolution / range | Measures | Limits |
|---|---|---|---|---|---|
| MT-1 | DWT cycle counter | CYCCNT 180 MHz; entry/exit stamps per ISR, per `CRIT_*`, per main-loop pass and per HX711 SCK-high bit (`HW_MEAS_DWT` only) | 5.6 ns / 23.8 s | ISR bodies, masked windows, SCK-high window, read time, loop pass | intrusive: stamp overhead calibrated with an empty pair and reported; cannot see the hardware latency before the first instruction (→ MT-3) |
| MT-2 | Independent pulse counter | TIM4 CH2 (PB7, J-PUL-B), external clock mode 1, 16 bit extended in software every tick (≤ 100 pulses/ms ≪ 2¹⁶) | 1 pulse | step count vs `pos_steps` per move and per direction segment | counts edges at the pin, not executed driver steps (R-2) |
| MT-3 | Event latency probe | TIM8 (180 MHz): slave **trigger mode** (EVT on CH1/PC6 starts the counter) or **reset mode** (every EVT edge restarts it); CH2 PC7 = PUL (CCR2 = last rising edge), CH3 PC8 = ENA, CH4 PC9 = DIR; **PWM-input mode** on CH2 (period + high width per pulse, DMA min/max) | PSC 1: 11.1 ns / 728 µs · PSC 17: 0.1 µs / 6.55 ms · PSC 179: 1 µs / 65.5 ms · PSC 1799: 10 µs / 655 ms | E-stop / limit / DOUT / RX / DRV_PWR / DIR → last PUL or ENA edge; PUL high, low, period; DIR → next PUL | one event source per trial (jumper selector); window overflow and "edge before the event" (CCR = 0) flagged |
| MT-4 | Device-time stamps | DMA2 copies TIM5→CNT (the FW's 1 MHz `t_us` base) into RAM rings on each capture: TIM8 CH1/CH2/CH4 (EVT, PUL, DIR), TIM1 CH4 (PA11, J-AUX); TIM1 update at 10 kHz copies TIM5→CNT into a `.noinit` heartbeat; last-PUL and hang-start stamps in `.noinit` | 1 µs (+ ≤ 1 µs DMA service) / 71.6 min | edges in the `t_us` domain, directly comparable with DATA / EVENT `t_us`: PUL timeline, DOUT rate and timestamp latency, DRV_PWR / K1 / ALM edges, TX frame integrity around SAVE, last PUL and reset time after a hang (DMA runs while the CPU hangs; SRAM survives the IWDG reset) | 1 µs quantisation; ring size limits the window (4096 stamps ≈ 82 ms at 50 kHz) |
| MT-5 | PC clock reference | GET_STATUS `t_us` / `uptime_ms` vs PC `perf_counter_ns`, least squares over ≥ 600 s | ≈ 50 ppm (USB jitter / span + PC crystal) | device clock error (FW-PLT-002), device-time → PC-time map (NFR-003) | PC crystal not calibrated (±50 ppm assumed) |
| MT-6 | PC-side timing | `hil_*.py` timestamps of sent / received frames | 1…16 ms (USB CDC) | upper bounds (command round trip ≥ FW response time), soak counters, M3 key timing | never for a budget < 50 ms except as an upper bound |
| MT-7 | Stimulus | TIM10 CH1 (PB8) one-pulse output after a seeded pseudo-random delay (0…1 step period), through 1 kΩ into the input connector with the switch unplugged (J-STIM) | 5.6 ns placement | 100-trial series with uniform phase | contact bounce and the real switch → the 10 real actuations |
| DMM | multimeter, caliper, dial indicator | static output levels (`STATIC_LEVEL` op), shunt voltage → I_LED, travel, repeatability | instrument class | HG-06/15/16/19/23/25/26/28 | static values only (R-1); DMM availability OI-E-M2-01 |

### 6.2 Loopback jumpers and pins (request to Implementer A: REQ-A-M2-01 pinout, REQ-A-M2-02 wiring)
A bench-only **measurement header "MH"** (2 × 8 pins on the interface board / shield, GND next to every signal, wires
≤ 10 cm). Taps on the driver-side nodes move from the MCU pins to the buffer outputs once the SYS-011 buffer is fitted.

| Jumper | From (node) | To MCU pin (header, ASSUMED per UM1724 — A verifies) | Timer / AF (proposal) | Used by |
|---|---|---|---|---|
| J-PUL-A | PUL at the driver input (PA0 during bring-up, buffer output later) | **PC7** (D9, CN5-2 / CN10-19; free since CR-01, R-01 resolved) | TIM8_CH2, AF3 | MT-3 last PUL / PWM input; MT-4 PUL stamps |
| J-PUL-B | same PUL node | **PB7** (CN7-21) | TIM4_CH2, AF2 | MT-2 counter |
| J-DIR | DIR node (as PUL) | **PC9** (CN10-1) | TIM8_CH4, AF3 | DIR edges, DIR setup, per-direction counts |
| J-ENA | ENA node (as PUL) | **PC8** (CN10-2) | TIM8_CH3, AF3 | ENA edge after E-stop / DRV_PWR / ENABLE |
| J-EVT (selector, one source at a time) | MCU-pin node of E-stop sense PA10, START PB0, END PC1, PAUSE PB6, DOUT PB4, DRV_PWR PA7, USART2 RX PA3, DIR, or STIM PB8 (self-test) | **PC6** (CN10-4) | TIM8_CH1, AF3 (TI1FP1 = slave trigger / reset) | MT-3 event; MT-4 EVT stamps |
| J-AUX (selector) | DOUT PB4, PD_SCK PB10, USART2 TX PA2, DRV_PWR PA7, ALM PA8, E-stop PA10, STIM PB8 (self-test) | **PA11** (CN10-14) | TIM1_CH4, AF1 | MT-4 stamps of a second signal |
| J-STIM | **PB8** (D15, CN5-10 / CN10-3; SB52 must stay OFF) | input connector of E-stop sense / START / END / PAUSE with the switch unplugged — the E-stop power path (NC1 → K1) stays wired | TIM10_CH1, AF3 | MT-7 |

Rules (part of the request): a **1 kΩ series resistor at the MCU end of every jumper** (a misconfigured pin can never drive
a safety node; ≈ 10 ns RC with the pin capacitance). The capture pins must be **5 V tolerant (FT)** because the taps move
to the 5 V buffer outputs — A verifies PC6…PC9, PB7, PA11, PB8 in DS10693 Table 10, configures them as AF input without
internal pull in `HW_MEAS`, and as **digital input without pull (not analog)** in every other build or documents "jumpers
removed outside HG sessions" (pinout §1.2 configures unused pins analog; FT tolerance in analog mode to be checked,
REQ-A-M2-04, HG-31). DMA2 stream map to verify against RM0390 Table 29 (proposal: TIM8_CH1 → S2 ch7, TIM8_CH2 → S3 ch7,
TIM8_CH4 → S7 ch7, TIM1_CH4 → S4 ch6, TIM1_UP → S5 ch6; DMA1 S5/S6 stay with USART2). PC8/PC9 lose their scope-marker
role (`FW_DEBUG_PINS`, no scope): retire it or keep it mutually exclusive with `HW_MEAS` (OBS-E-M2-05). PC6 is the spare
of the future TIM8-PUL / PA6-BKIN option (pinout §1.2); if that option is built, MT-3 moves to TIM3 on the same pins
(AF2). Same-pin captures of the safety inputs (PA10 = TIM1_CH3, PB0 = TIM3_CH3, PB4 = TIM3_CH1, PA7 = TIM3_CH2) were
considered and rejected: they change the safety-input pin mode in the measured image and an AF-output misconfiguration
would short an NC contact.

### 6.3 Measurement build (request to Implementer A: REQ-A-M2-03)
- PlatformIO envs `nucleo_f446re_meas` (`-DHW_MEAS=1`) and `nucleo_f446re_meas_dwt` (`-DHW_MEAS=1 -DHW_MEAS_DWT=1`);
  IWDG active (never frozen); GET_INFO feature bit `FEAT_HW_MEAS` (REQ-C-M2-01) and build string suffix `-MEAS` / `-DWT`.
- (v0.4.1) In `_meas_dwt` the HAL objects that include `meas_dwt.h` and `main.cpp.o` may differ from the release image; core / pure / gen objects stay identical (`check_meas_build.py`).
- Code confined to `hal/f446/meas*.c` plus the forwarder seam `hal_meas_cmd()`; no `#ifdef` in `src/core` / `src/pure`;
  `.RamFunc`, `EXTI*_IRQHandler`, `TIM2_IRQHandler`, `TIM5_IRQHandler`, `step_isr` and all core / pure objects
  **byte-identical** to the release image (TC-SYS-009-02, static check S-12). Exception `HW_MEAS_DWT`: DWT stamps in the
  handlers and `CRIT_*` macros, used for NFR-007 only, with the calibrated stamp overhead reported.
- Functions: MT-2 counter (read / reset, 32-bit extension in the tick); MT-3 probe (arm: trigger / reset / PWM-input mode,
  PSC, EVT polarity; read: CCR1…4, capture counts, over-capture and window-overflow flags, CNT); MT-4 rings (per channel the
  last N stamps + write index) and `.noinit` words (last PUL, heartbeat, hang start, magic); MT-7 stimulus series (n, seed,
  polarity, hold time); HANG injection while moving (main loop, tick, level-1 storm via repeated software triggers of an
  unused level-1 EXTI line — test image only); `STATIC_LEVEL` (PUL / DIR high for the DMM, only while NOT_ENABLED, cancelled
  by any command); DWT statistics (`HW_MEAS_DWT`: max / min / count per section, main-loop histogram); idle-loop counter
  (passes per second, for the non-intrusive CPU-load method).
- No change of parameters, stop logic, priorities or timing of the release FW; any measurement ISR at the lowest priority
  (below the link, level ≥ 6); DMA preferred so that captures stay valid while the CPU is masked (NVM) or hung.

### 6.4 Diagnostic protocol (request to the Integrator: REQ-C-M2-01 — delivered in ICD v0.6 Appendix C; PO 2026-10-04: DIAG_MEAS is the primary evidence path, SWD only as fallback because the board is installed remotely)
`DIAG_MEAS` command — proposal: TYPE `0x3D`, LEN 8 `{u8 op, u8 sel, u16 a, u32 b}`, OK body fixed 64 B (`u32[16]`,
op-specific layouts in a new ICD appendix). Ops: 0 INFO (variant, timer clocks, PSC table, ring sizes, stamp overhead),
1 PROBE_ARM, 2 PROBE_READ, 3 COUNTER (read / reset), 4 STAMPS (channel, page), 5 NOINIT (read / clear), 6 STIM_RUN, 7 HANG,
8 STATIC_LEVEL, 9 DWT (read / reset). Rules: feature bit `FEAT_HW_MEAS` = features bit 9; bit 0 (release, twin) →
`E_INTERNAL` NOT_IN_BUILD, nothing executed; not sniffed, normal lane; retry class RETRY for read ops, VERIFY for ARM /
STIM / HANG / STATIC; HANG while not moving and STATIC_LEVEL while not NOT_ENABLED → `E_STATE`; refreshes the link watchdog;
response ≤ 10 ms; `ref_codec` encode / decode, protocol vectors per op, a NOT_IN_BUILD check vector; seam v1.3
`size_t hal_meas_cmd(const uint8_t *req, size_t n, uint8_t *resp, size_t max)` in `tools/README` (twin: NOT_IN_BUILD; a
model of it = REQ-C-M2-08). No EVENT is needed (the PC polls after each trial). **Fallback** if the ICD change is not
accepted: the PC reads the RAM result block over SWD while the FW runs (`STM32_Programmer_CLI` / OpenOCD `mdw` at the
map-file address) — same data, no protocol change, but the debugger connection must be covered by the PO approval (D-06).

### 6.5 Check list (v0.3; v0.4: D-41 no contactor, D-42 hardwired ENA disable)

Preconditions for the whole list: PO approval reference (D-06); board / port named by the PO; build ids of the release,
`HW_MEAS` and `HW_MEAS_DWT` images recorded (GET_INFO); DIP state recorded (SYS-005); M2 GO / GO WITH CONDITIONS; HG-29
passed on the day; for any trial with the E-stop sense bypassed the bench safety procedure §6.8 is followed. Items HG-01…HG-20, HG-23 (N/A without the buffer board, D-56 b), HG-24, HG-28, HG-29, HG-32 must pass **before any motion under load** (SYS-009; HG-21 / HG-22 are N/A or optional since D-41). Instruments:
measurement header MH + the three images, DMM, caliper, dial indicator, spring specimen, `00_System/tools/hil/*` —
**no oscilloscope, no logic analyser**. Evidence kinds as in the level codes (OC / PC / FN / DMM / INSP); u = measurement
uncertainty added per §6.1 rule 4.

| HG | Item (origin) | Method (v0.3) | Ev. | Pass criterion (u) | Req. |
|---|---|---|---|---|---|
| HG-01 | Board identity, solder bridges (C-01); MH header | visual + photo; jumper continuity incl. the 1 kΩ (DMM) | INSP, DMM | as `pinout.md` §5 and the MH table (§6.2) | SYS-007, FW-PLT-002 |
| HG-02 | Clock source and PUL frequency (C-02) | GET_STATUS `CLK_FALLBACK`; MT-5 regression ≥ 600 s; MT-3 PWM-input during a 50 kHz unloaded jog (spm 2000, 25 mm/s, no specimen) | PC, OC | no fallback; device clock error ≤ 0.1 % (u ≈ 0.01 %); PUL period = 3600 TIM8 ticks ± 1 (= 1800 TIM2 ticks: derivation exact; absolute error = the clock error). **v0.4.2 (D-45 c, R-HIL-03):** the 50 kHz train runs with the 48 V PSU off, un-homed (spm 2500, `motion.v_unhomed_um_s` 20 mm/s in RAM) with `pulse_high_ns` / `pulse_low_min_ns` 10 000 and `max_step_rate_hz` 50 000 set explicitly; REBOOT restores the stored parameters | FW-PLT-002 |
| HG-03 | VCP 921 600 Bd soak (C-03) | 10 min at 80 Hz + 20 cmd/s (M3 gate: 1 h, NFR-004) | PC | 0 sequence gaps, 0 CRC errors both sides | IF-002, SYS-009 |
| HG-04 | Flash erase vs IWDG; E-stop during SAVE; no split frame (C-04; C-23 optional since D-41) | 20 SAVEs forcing an erase: (a) STIM into the E-stop sense during the erase (§6.8), MT-3 trigger on the E-stop node, CCR3 = ENA; (b) **optional** (only if a 48 V presence sense is fitted and `drv.pwr_sense_enable` = 1, D-41): DRV_PWR change during the erase, MT-4 stamps; (c) J-AUX = TX: MT-4 stamps of every TX edge over 100 SAVEs | OC, FN | no IWDG reset; SAVE ≤ 2.5 s; valid record after reboot; ENA disabled ≤ 1 ms during the erase (u 0.1 µs); (b) DRV_PWR → ENA ≤ erase time + 25 ms; no gap > 22 µs inside any TX frame. **v0.4.2 (D-45 d):** (a) is a real button press (sense connected, no bypass) on the predicted erase SAVE (32-slot log: every 32nd SAVE erases) until ≥ 3 presses land inside an erase window (EVT stamp within [PARAMS_SAVED t_us − nvm_save_ms, t_us]); a J-STIM pulse cannot be placed into the erase (D-37 a) | FW-NVM-002/003, SAF-FW-005/019 (SAF-FW-024 optional) |
| HG-05 | HX711 on silicon (C-05) | 10 000 reads at 80 SPS: MT-1 SCK-high per bit and read time (`HW_MEAS_DWT`); J-AUX = PD_SCK: MT-4 SCK edges of 100 reads per gain; J-EVT = DOUT: MT-4 DOUT stamps → median period and `t_us`(DATA) − DOUT stamp per sample; `afe_reinit_count` | OC | SCK-high ≤ 50 µs (MT-1 and MT-4, u 1 µs); read ≤ 60 µs; SCK pulses per read 25 / 27 / 26; rate = MT-4 median ± 1 %; timestamp latency ≤ 5 µs: max ≤ 4 µs PASS (u ±1 µs), 4…6 µs → `HW_MEAS_DWT` fine method (TIM8 CNT read at EXTI4 entry with EVT = DOUT); `afe_reinit_count` = 0 | FW-AFE-001/004, FW-TIM-001 |
| HG-06 | Opto drive margin (C-06) | `STATIC_LEVEL` PUL / DIR high and ENA at the disabled (LED-on) level while NOT_ENABLED; DMM: VOH at the driver terminal, voltage over a 100 Ω shunt → I_LED | DMM | bring-up: I_LED ≥ 6 mA and VOH ≥ 3.0 V (with HG-25's re-home this qualifies the direct drive, D-56 b), else buffer first; through the buffer: 10…13 mA | SYS-009, SYS-011 |
| HG-07 | ENA enable / disable and settle (C-07) | ENABLE / DISABLE, shaft holding by hand (no load); MT-4 stamps of ENA and of the first PUL / DIR edge after ENABLE (and, only with a power sense fitted, after a DRV_PWR return, J-AUX = DRV_PWR) | FN, OC | disabled = shaft free, enabled = holding; first PUL/DIR edge − ENA enable (or − DRV_PWR return) ≥ `motion.ena_settle_ms` (u 1 µs) | FW-MOT-008 (SAF-FW-024 optional) |
| HG-08 | PUL / DIR timing at the driver terminals (C-08) | taps at the driver-side nodes; MT-3 PWM-input over ≥ 10⁵ pulses at 50 kHz (DMA min / max); ≥ 100 reversals with J-EVT = DIR: MT-3 trigger, CCR2 of the first PUL after DIR | OC | high ≥ 10 µs, low ≥ 10 µs, DIR setup ≥ 20 µs on every reversal (u 11 ns). **v0.4.2 (D-45 c/e):** PSU off; series a1 at the dict-6 defaults (12.5 + 12.5 µs, 40 kHz) against the driver minimum (high / low ≥ 10 µs, period ≥ 20 µs) and "as configured" (± 1 TIM2 tick); series a2 explicit 10 + 10 µs at 50 kHz (R-HIL-03) "as configured" only (a limit equal to the design value cannot pass rule 4); reversals = 1-step MOVE_ABS, MT-3 trigger on DIR (PSC 17, 179 on window overflow) + MT-4 cross-check; DIR → next PUL from rest includes the first ramp period | FW-MOT-001 |
| HG-09 | Step count integrity (C-09) | 100 moves of random length / speed, 10 jogs with reversals, 100 random STOP / HALT / E-stop stops: MT-2 vs Δ`pos_steps` per direction segment (DIR stamps); 5 moves cross-checked with the caliper | OC, DMM | difference 0 (± 1 only with POS_UNCERTAIN); caliper travel = commanded ± (caliper u + 1 step) | SAF-FW-004 |
| HG-10 | E-stop reaction, MCU path + hardwired ENA disable (C-10; **D-41 / D-42**) | (a) 100 STIM trials during a 30 mm/s unloaded jog (§6.8), J-EVT = E-stop node, MT-3 trigger PSC 1, CCR2 = last PUL, CCR3 = ENA; (b) 10 real presses (J-EVT on the node, real contact incl. bounce); (c) **D-42 independence:** MCU held in reset (NRST low via the ST-LINK reset / jumper), press the E-stop → motor de-energised (no holding torque by hand); **v0.4.2 (D-45 a):** releasing it while the MCU is still in reset re-enables the driver through the ENA pull-down (holding, no pulses possible — accepted, the check is "de-energised while pressed"); with the MCU running, release keeps the driver disabled until ESTOP_CLEAR + ENABLE; (d) **D-42 ENA opto loop (DMM, 100 Ω shunt in the ENA loop):** current with the MCU driving *enabled* and the E-stop released (≈ 0 mA), MCU in reset + E-stop pressed (≥ the driver's ENA threshold, ≈ 10…13 mA), MCU driving *disabled* + E-stop pressed (no over-current at the MCU pin: voltage across its series resistor within the pin limit, D-42 circuit per wiring.md v0.5); (e) **FW with ENA forced externally:** press slowly so that the NO contact (D-42) acts before / after the NC sense opens — no FW fault, no false latch besides ESTOP, no ALM-start-block surprise; after release: ESTOP latched until ESTOP_CLEAR, driver stays disabled until ENABLE, HOME required | OC, FN, DMM | (a)(b) last PUL ≤ 100 µs (u 0.1 µs + R-3 ≤ 1 µs), ENA disabled ≤ 1 ms; (c) as stated (independent of the MCU); (d) recorded, within the driver / pin ratings; (e) no unexpected FW state; release never causes motion. Supply < 5 V **N/A** (no contactor, D-41 → R-6) | SAF-FW-005, SYS-006 (D-41 / D-42 wording, SRS v0.6) |
| HG-11 | Limit reaction (C-11; v0.3: STOP-button part removed, D-36) | 100 STIM trials each for START and END (switch unplugged, jogging toward it), J-EVT = pin node, MT-3 trigger PSC 1; 10 real actuations at ≤ 1 mm/s | OC | last PUL ≤ 200 µs (u 0.1 µs + R-3 ≤ 15 µs) | SAF-FW-002 |
| HG-12 | FW load-limit reaction (C-12) | spring specimen; `safety.load_raw_max` set just above the present raw so that a sample trips during a slow jog; 100 trials; J-EVT = DOUT: MT-3 **reset mode** (last PUL relative to the latest DOUT edge) and MT-4 DOUT / PUL stamps; deciding sample = FAULT_SET (LOAD_LIMIT) value + DATA `t_us` | OC | deciding DOUT edge → last PUL ≤ 200 µs (u 1 µs), both methods agree; trip on the first violating sample | SAF-FW-002/008 |
| HG-13 | PC STOP / HALT (C-13) | 100 STOP 0 + 100 HALT frames at random times during a 30 mm/s jog, ≥ 5 ms line silence before; J-EVT = RX node: MT-3 trigger PSC 17, CCR1 = last RX edge, CCR2 = last PUL; stop-bit end computed from the frame bytes at the actual 918 367 Bd; (M3) Pause/Break key → last PUL via the MT-5 time map | OC, PC | last byte end → last PUL ≤ 2 ms (u 0.2 µs + 1.1 µs bit time); key → last edge ≤ 100 ms p95 (u ≈ 5 ms, M3) | SAF-FW-002, NFR-003 |
| HG-14 | Hang → IWDG (C-14) | `HANG` op in the main loop, the tick and as a level-1 storm while jogging at 10 mm/s (10 each); after the reset `NOINIT` read: hang-start stamp, last PUL stamp, heartbeat (DMA, survives the reset) | OC | last PUL − hang start ≤ 100 ms (u 0.1 ms); reset cause IWDG; heartbeat end − hang start = IWDG time ≤ 90 ms | SAF-FW-019 |
| HG-15 | Reset under load (C-15, D-33 e) | spring preloaded ≥ 98 N; MCU reset (NRST, Nucleo power cycle, `HANG` → IWDG); dial indicator; MT-2 counter after boot | DMM, OC, FN | motion ≤ 0.01 mm; raw change within noise; MT-2 = 0 from boot until ENABLE (the reset window itself: PA0 Hi-Z by design, pinout §1.1) | SAF-FW-018 |
| HG-16 | ALM / PEND levels and start-block (C-16) | powered / unpowered, in position / moving, closed-loop setting; GET_STATUS `io`, EVENT ALM_CHANGED; DMM at the opto outputs | FN, DMM | levels recorded, `drv.*_active_level` set; one ALM_CHANGED per change; new motion refused while ALM active and DRV_PWR on | FW-SW-004, SAF-FW-026 |
| HG-17 | Input wire break (C-17; v0.3: no STOP input) | unplug E-stop sense, START, END (K1 aux only if a power sense is fitted, D-41); break the D-42 NO wire and show that it is **not** detected (residual R-10) | FN | E-stop / limits read active → stop + flag; D-42 wire break recorded as undetectable (periodic functional test HG-10 c is the mitigation) | SAF-FW-007 |
| HG-18 | Main-loop and ISR budgets (C-18) | release image: `loop_max_us` at 50 kHz + 80 Hz + 20 cmd/s; `HW_MEAS_DWT`: per-ISR and per-`CRIT_*` maxima (overhead calibrated); `HW_MEAS`: idle-loop counter CPU-load method; `stack_free_min` | OC | loop ≤ 1000 µs; step ISR ≤ 2 µs; step CPU ≤ 15 %; windows masking levels 0–2 ≤ 1 µs; E-stop / limit ISR ≤ 1 µs; stack margin > 0. **v0.4.6 (D-51, D-52, FW v0.8):** the NFR-007 verdict is the DWT measurement. Every handler section is judged on its total = max − stamp overhead (section 21) + 27 cycles exception entry / exit (§6.1 rule 4). Criteria: section **1** step ISR ≤ 2 µs and step CPU (mean + 27 cyc) × 50 kHz ≤ 15 %; section **2** E-stop reaction (level 0) ≤ 1 µs; level-1 handlers **3/4** (START / END), **5** (PAUSE) and **23** (EXTI3 deferred E-stop callback) ≤ 2.5 µs each (D-52 design budget); derived check section 1 + largest level-1 handler ≤ 5 µs (D-52, FW-TIM-001); critical sections 11–13, 16–18 ≤ 1 µs. The `isr_wcet.py` v0.8 figures are informative; the measured / nominal ratios are recorded for OI-FW-46. | NFR-005/006/007, FW-SW-002 |
| HG-19 | Driver DIP sheet (C-19) | inspection of all 8 switches; first travel calibration vs the expected steps/mm | INSP, DMM | recorded (800 steps/mm at 4000 p/rev) | SYS-005 |
| HG-20 | E-stop circuit (C-20; single red button on the operator panel, D-36; **D-41 / D-42**) | wiring vs `wiring.md` v0.5: NC contact → PA10 (MCU sense), **extra NO contact → driver ENA opto forced to disabled** (D-42), **no contactor** (D-41); label on the panel | INSP | as drawn; the D-42 path contains no MCU-controlled element | SYS-006, SYS-001 |
| HG-21 | DRV_PWR sense (C-21) — **optional since D-41** (no contactor; `drv.pwr_sense_enable` default 0, CR-03) | only if a 48 V presence sense is fitted: PSU switched off during a jog; J-EVT = PA7 node: MT-3 trigger PSC 179, CCR3 = ENA, CCR2 = last PUL | OC, FN | ENA disabled and last PUL ≤ 25 ms after the PA7 change; else N/A | (SAF-FW-024, FW-SW-005) |
| HG-22 | K1_WELDED — **N/A since D-41** (no contactor to watch; the feature is kept and verified in the twin only, TC-SAF-FW-025-01) | – | – | N/A | (SAF-FW-025) |
| HG-23 | Buffer board (C-22) — **only if the D-56 b direct-drive qualification failed** | not installed → N/A (D-56 b); installed: inspection; I_LED per input (DMM, `STATIC_LEVEL`); HG-07 / HG-08 repeated with the taps at the buffer outputs | INSP, DMM, OC | N/A without the buffer; with it: installed before the first calibration; 10…13 mA; timing as HG-07 / HG-08 | SYS-011, SYS-009 |
| HG-24 | ALM reset (C-16; D-41) | provoke an ALM (bench); reset by switching the 48 V PSU off / on (the E-stop no longer cuts power, D-41); ENA-toggle reset | FN | power-cycle reset works; ENA-toggle result recorded | SYS-009, D-28 |
| HG-25 | Speed envelope (SYS-004) | after travel calibration: 0.01 mm/s over 2 mm (dial indicator) and 10 mm/s over 50 mm (caliper), duration from MT-4 PUL stamps (first / last edge); 30 mm/s unloaded; re-home; soft-limit travel | DMM, OC | mean speed error ≤ 1 % (u: dial 0.5 %, caliper 0.04 %); no ALM at 30 mm/s; HOME drift ≤ `home.drift_tol_um`; usable travel ≥ 280 mm | SYS-004 |
| HG-26 | Home repeatability (FW-HOM-003, Should) | 10 homing cycles, dial indicator at 0 | DMM | ≤ 0.02 mm (2σ) | FW-HOM-003 |
| HG-27 | Command response sample (NFR-008) | 1000 commands of all types under streaming: PC round trip (MT-6, upper bound); any RTT > 10 ms resolved on chip (J-EVT = RX last byte via MT-3, J-AUX = TX first response byte via MT-4); SAVE / LOAD / DEFAULT | PC, OC | ≤ 10 ms each (RTT ≤ 10 ms ⇒ PASS); NVM ≤ 2.5 s; commands during SAVE per D-37 a | NFR-008 |
| HG-28 | First motion, direction and homing smoke (SYS-009) | un-homed jog of a few mm at ≤ 1 mm/s, no specimen: direction (+x away from START) and caliper travel vs commanded; then HOME at low speed; HOME with `motion.dir_invert` deliberately wrong (no load) | FN, DMM | direction correct; scale within ± 10 % (DIP applied); HOMED at START; inverted DIR → HOME_WIRING or HOME_NOT_FOUND within `home.max_travel_um` | SYS-009, FW-HOM-001/002 |
| HG-29 (new) | Measurement-chain self-test (every HG session) | (a) HG-01 continuity; (b) DIAG INFO; (c) STIM → J-EVT and J-AUX: a programmed 10.000 µs pulse / delay read back by MT-3 (± 1 tick) and MT-4 (± 1 µs); (d) a commanded 10 000-step move at 10 kHz: MT-2 = 10 000, PWM-input period as programmed, 10 000 MT-4 stamps; (e) STIM at the connector of each RC input, J-EVT = STIM, J-AUX = pin node: effective RC + threshold delay recorded (basis of u_th, R-3); (f) TC-SYS-009-02 report present | OC | (c)(d) exact within resolution; (e) recorded; otherwise no HG measurement that day. **v0.4.2 (D-45 f):** (c) = STIM 5 × 10 ms hold: EVT interval = hold + 0…1 ms delay (± 2 µs), probe CNT consistent with the stamps, J-AUX width = hold ± 1 µs (STIM_RUN has 1 ms resolution); (d) 10 kHz train with the PSU off (spm 5000, 2 mm/s un-homed): MT-2 = Δpos_steps = Δstamps in a non-PWM move, PWM period 18 000 ± 1 ticks in a separate move (PWM input stops the stamp DMA on the board) | SYS-009 |
| HG-30 (new) | Release-image confirmation | flash the release image: GET_INFO = release (FEAT_HW_MEAS = 0, DIAG_MEAS → NOT_IN_BUILD); functional repeat of E-stop (latch, ENA disabled = shaft free, EVENTs), limit stop + latch, load-limit trip, STOP / HALT / PAUSE, HOME, 2-min soak, `loop_max_us` | FN, PC | same behaviour and EVENT sequences as with `HW_MEAS` | SYS-009 (R-4) |
| HG-32 (v0.4) | D-41 / CR-03 configuration | GET_ALL_PARAMS of the release image: `drv.pwr_sense_enable` = 0 by default (CR-03); E-stop held pressed > 1 s: no K1_WELDED, only ESTOP | INSP, FN | as stated | SYS-009, D-41 |
| HG-31 (new) | Loopback hygiene | release image with the jumpers fitted: loopback pins are digital inputs without pull (init-code inspection + A's statement), or jumpers removed per wiring rule | INSP | no loopback pin in analog mode while a 5 V tap is fitted | SYS-009 (REQ-A-M2-04) |

**List size: 32 items** (28 re-planned + 3 new in v0.3 + HG-32 in v0.4; HG-22 N/A and HG-21 optional since D-41). +H → HG: SYS-004 → 25; SYS-005 → 19; SYS-006 → 10, 20; SYS-009 → all;
SYS-011 → 23; SAF-FW-002 → 11, 12, 13; SAF-FW-004 → 09; SAF-FW-005 → 10, 04; SAF-FW-018 → 15; SAF-FW-019 → 14, 04;
SAF-FW-024 → 21, 04, 07 (optional since D-41); FW-PLT-002 → 02; FW-AFE-001/004 → 05; FW-MOT-001 → 08; FW-HOM-003 → 26; FW-SW-005 → 21;
FW-NVM-003 → 04; FW-TIM-001 → 05; IF-002 → 03; NFR-006/007 → 18; NFR-008 → 27 (23 requirements, every one mapped).
`wiring.md` C-xx methods still name a scope / LA (C-02, C-05…C-15, C-18) and the STOP button (C-11, C-17): to be
re-worded to this table (REQ-A-M2-02).

### 6.6 What cannot be measured without instruments — residual risks and acceptance alternatives

| R | Not measurable on chip / PC | Acceptance alternative (evidence) | Residual | Decision needed |
|---|---|---|---|---|
| R-1 | Analog waveform at the driver opto: rise / fall time, ringing, VOH under dynamic load, the actual LED current pulse | static VOH / I_LED with the DMM (HG-06/23); logic-threshold timing at the buffer output (HG-08); 10 µs pulses vs ≈ 3 µs that worked on Stefan's stand (D-24); buffer board before calibration (SYS-011) | Low | – |
| R-2 | Whether the driver executes every pulse (opto delay, minimum width accepted, filter) | travel commanded vs measured (caliper, HG-09/25), HOME_DRIFT at re-homing after long runs (FW-HOM-004), closed-loop following-error ALM (D-27 target setting) | Low (closed loop) / Medium (open loop: silent) | – |
| R-3 | Threshold mismatch between the EXTI pin and the capture pin on slow RC edges (limits τ ≈ 47…94 µs, E-stop ≤ 10 µs, DRV_PWR ≈ 2 ms) | delay STIM → pin node measured (HG-29 e) and added as u_th: ≤ 15 µs for limits (budget 200 µs, design ≤ 12 µs), ≤ 1 µs for the E-stop (100 µs, design ≤ 0.5 µs) | Low | – |
| R-4 | The measured image is not the release image | TC-SYS-009-02 byte-identical handlers / core; HG-30 functional repeat on the release image | Low | – |
| R-5 | Absolute time: every on-chip timer shares the PLL | HG-02 against the PC (≤ 0.1 %); budgets have > 2× margin | Low | – |
| R-6 | **(v0.4: superseded by D-41 / D-42 — no contactor, the supply is not removed by the E-stop; the MCU-independent channel is the D-42 hardwired ENA disable, verified functionally and with the DMM in HG-10 c/d; residual: not an IEC 60204-1 emergency stop (stated to the PO in D-41); a broken D-42 wire is undetectable (R-10))** v0.3 text: SYS-006 "driver supply < 5 V within 100 ms, independent of the MCU": the 48 V bus decay is not visible to the MCU (no common ground with the opto-isolated driver power side; a divider to an ADC pin would break the isolation) | on-chip E-stop → K1 aux edge and E-stop → ALM "unpowered" (driver logic drop-out) times (HG-10 d), MCU-in-reset functional test (HG-10 c), circuit inspection (HG-20); bus-capacitor discharge argued from the driver holding current | Medium | **OI-E-M2-02**: Orchestrator / PO accept "driver logic drop-out ≤ 100 ms" as the measured equivalent, or provide a DMM with min/max capture / a 48 V indicator |
| R-7 | Electrical SCK-high vs the DWT software window | MT-4 SCK edges (1 µs) + MT-1; functional: `afe_reinit_count` = 0 over 10 000 reads (a > 60 µs SCK-high powers the HX711 down) | Low | – |
| R-8 | PC timing jitter (USB CDC 1…16 ms) | used only as an upper bound or for budgets ≥ 50 ms (NFR-003 M3) | Low | – |
| R-9 | **(closed v0.4: multimeter available, PO)** DMM availability (not covered by D-35 G5) | if absent: HG-06/23 by datasheet calculation only (SN74ACT244 VOH, opto forward voltage, series resistor) | Medium if absent | **OI-E-M2-01**: Orchestrator asks the PO |
| R-10 | (v0.4, D-42) The NO contact of the hardwired ENA disable is not monitored: a broken wire or a welded / mis-adjusted contact block is invisible to the FW | functional test HG-10 c at every HG session and at commissioning; recommended periodic test (operator notes); the MCU path (NC → PA10, fail-safe on a broken wire) stays the monitored channel | Medium | Orchestrator: periodic-test interval in the operator notes |

### 6.7 Execution order (HG1 session plan)
1. Without driver power: HG-01, HG-19, HG-20 (INSP), HG-31 check of the build, HG-29 self-test, HG-03 soak, HG-02 clock.
2. Driver powered, direct 3.3 V drive, no specimen: HG-32, HG-06 (static), HG-10 c/d (D-42 path verified **before** any
   E-stop-sense bypass, §6.8), HG-28 first motion, HG-07, HG-08, HG-09, HG-10 a/b/e, HG-11, HG-13, HG-17, HG-04, HG-14,
   HG-16, HG-24, HG-05, HG-18, HG-27 (HG-21 only with a power sense fitted; HG-22 N/A).
3. Buffer board (SYS-011, only if the D-56 b qualification — HG-06 I_LED ≥ 6 mA plus the pulse-integrity re-home — failed): HG-23 (repeats HG-07/08 at the buffer outputs); otherwise HG-23 = N/A.
4. Spring specimen (first load, after HG-01…24, 28, 29 passed): HG-12, HG-15, HG-25, HG-26.
5. Release image: HG-30; report `FW_test_report_HG1.md` with u per item and the §6.6 decisions.

### 6.8 Bench safety procedure for stimulus trials on the E-stop sense input (proposal for PO approval, v0.4)
Applies to every trial in which the E-stop sense input (PA10) is driven by the stimulus output instead of the red button:
HG-10 a, HG-04 a, HG-29 e (E-stop input). During these trials the button's **MCU channel is out of service**; with D-41
there is no contactor, so the only stop means independent of the FW under test are the **D-42 hardwired ENA disable**
(the button's NO contact stays wired and active, it does not use the sense input) and the **48 V PSU mains switch**.

| Step | Action | Check / record |
|---|---|---|
| P-1 | Preconditions: no specimen, no load on the table, no tool in the travel; two persons — operator at the PC, observer at the operator panel within reach of the red button and the PSU switch; trial speed ≤ 30 mm/s; soft limits set to a 50 mm window **5…55 mm next to START** (v0.4.2, D-45 b: every E-stop trial clears HOMED and forces a re-home); both limit switches connected (never stimulate a limit and the E-stop in the same trial) | names, time, PO approval ref (D-06) in the HG log |
| P-2 | With the sense still wired: run HG-10 c (MCU held in reset → press → motor free) and HG-10 d (DMM on the ENA loop) — the D-42 path must work **before** the sense is bypassed | PASS recorded; otherwise stop: no bypass |
| P-3 | Driver PSU off (switch); unplug the NC sense connector at the interface board; fit J-STIM from PB8 through the series resistor to the PA10 input connector; hang the tag "E-STOP SENSE BYPASSED — TEST" on the red button | photo |
| P-4 | Series resistor of J-STIM sized so the PA10 pin reaches a valid low against its pull-up network (≤ 0.3 VDD; with a 1 kΩ external pull-up this needs ≤ ≈ 400 Ω, e.g. 220 Ω, instead of the 1 kΩ of the other jumpers — REQ-A-M2-07) and so that a mis-configured PB8 cannot exceed the pin current rating | resistor value; DMM: pin voltage with STIM idle (closed) and active (open) |
| P-5 | MCU on, HW_MEAS image: GET_STATUS shows ESTOP_OPEN = 0 with STIM idle and = 1 with a STIM_RUN hold (static check, driver still unpowered) | io bits recorded |
| P-6 | Driver PSU on; ENABLE; run the trial series (DIAG_MEAS STIM_RUN, PROBE_ARM / READ); the observer keeps a hand at the red button: pressing it still de-energises the motor through D-42 | trial log (hil_stim.py) |
| P-7 | Abort criteria: any unexpected motion, noise, ALM, or a trial outside the window → observer presses the red button (D-42) and switches the PSU off; operator sends HALT | incident note |
| P-8 | Restore: driver PSU off; remove J-STIM; reconnect the NC sense; remove the tag; MCU on; press the red button: EVENT ESTOP_SET, ENA disabled, ESTOP latched; release + ESTOP_CLEAR; GET_STATUS ESTOP_OPEN follows the button | PASS recorded **before** any further motion; HG report entry "sense restored" |

The same steps (without P-2) apply to STIM trials on START / END / PAUSE (the switch is unplugged, the red button
stays fully operational on both channels).

### 6.9 HIL realisation (v0.4.2)
The HG procedures, the §6.7 order and the §6.8 steps are implemented in `00_System/tools/hil/` (owner E, reviewed by
the Integrator): `hil_session.py` (runner; `--twin` dry run or a board session), `hil_procs.py` (one procedure per HG
item), `hil_link.py` (**D-06 interlock**: a serial port is opened only with `--approved D-06-GATE-YYYYMMDD[-TAG]`
recorded by the Orchestrator as a dedicated *approved* table row in `DECISIONS.md` / `STATUS.md`, an explicit
`--port` re-typed by the operator and the PO-named UID `--board-uid` (required since v0.4.4); flashing is always done
by the PO),
`hil_budget.py` (§6.1 rule 4), `hil_report.py` and `HW_GATE_RUNBOOK.md` (operator checklist, expected values). The
twin dry run (`Twin(hw_meas=True)`) exercises every automatable step; it is not hardware evidence. D-45 g: the ENA
node as a J-EVT source (OI-E-HG-07) is deferred / optional — HG-07 uses the RX-triggered probe on the ENABLE frame.
**v0.4.4 (review FWR-12/13/15/09):** the approval row must be dedicated (first cell = reference, last cell exactly
`approved` / `approved (PO)`, no negation / question / open state anywhere in the row); every run starts with the identity
block (S-00, or S-ID on a resume) whatever `--only` / `--from` select, and any mismatch of dict hash, protocol or board
UID stops the session; results carry session id / mode / board UID / image identity (GET_INFO build | dict hash), and
the gates (GATE-LOAD, BENCH-ENTRY → HG-10a, HG-10 c/d → BENCH-ENTRY) accept only results of the current session;
HG-10a always runs between BENCH-ENTRY and BENCH-EXIT, phase 4 always after GATE-LOAD; `--accepted-open HG-xx:REF`
needs REF recorded as a dedicated accepted row naming the item; HG-06 always sends DISABLE and requires ENA disabled
before STATIC_LEVEL. Unit evidence: TC-SYS-009-03.

---

## 7. Traceability of this plan
- Requirement → TC: §3 tables (one row per TC, requirement in the ID).
- TC → code: `/* Verifies: <REQ> */ /* TC: <TC-ID> */` tags in `02_FW/test/**`; the report lists the test function names per TC.
- HG item → requirement: §6 last column; target-only criteria stay OPEN-H in every report until the PO-approved gate.

---

## 8. Review findings (§8.1–8.3: P1 design review of FW_design v0.2, ICD v0.2 + v0.3/v0.4 deltas, pinout v0.2, params dict 2 vs SRS v0.3 + D-30/D-31; §8.4: M2 entry, v0.3)

Already tracked by Implementer A in FW_design §11.2 and confirmed independently here (no new ID): OI-FW-17 (seam deltas → see DEF-P1-02), OI-FW-18 (ICD §2.4 wire order), OI-FW-19 (sniffer PAUSE in ICD §2), OI-FW-20 (units/motion vectors), OI-FW-22 (boot ENA with DRV_PWR off), OI-FW-23 (homing bounds as FW constants), OI-FW-24 (controlled-stop measurement — adopted in TC-SAF-FW-003-01 with the refinement of OBS-P1-01), OI-FW-26 (SAF-FW-023 vs D-30), OI-FW-27 (SAF-FW-024 events).

### 8.1 Defects

| ID | Sev. | Finding (evidence) | Fix hint | Addressee |
|---|---|---|---|---|
| **DEF-P1-01** | High | **AFE stale timeout vs 10 SPS.** `params.yaml:160-171` `afe.timeout_ms` default 100 ms (min 20, no hard rule); `afe.rate_sps` SPS10 is allowed without reboot (FW-AFE-002) and gives a 100 ms conversion period. At 10 SPS every sample arrives at ≈ the timeout → AFE_STALE flickers, motion is refused (SAF-FW-012/020) and a running move trips AFE_FAULT. The M1 synthetic source (TIM5 CC2 at `afe.rate_sps`, FW_design §5.8) shows the same. FW_design §5.7.1 applies the parameter as is. | Hard rule H5 `afe.timeout_ms ≥ 2.5 × conversion period` (≥ 250 ms at 10 SPS, checked on SET of either parameter), or the FW uses `max(afe.timeout_ms, 2.5 × period)`; SRS SAF-FW-012 to state which. TC-SAF-FW-012-02. | Integrator (params/ICD §11.4), Orchestrator (SRS), A |
| **DEF-P1-02** | Medium | **Twin seam contract exists twice.** `tools/README.md` "Seams" table still lists `hal_uart_write(frame, n)` without class, `hal_step_stop_now` only, no `peek`, `abort`, `set_period_now`, `arm_last`, `set_count`, `stop_gen`, `inputs_config/rearm`, `afe_sample_t`, `hx711_kick/hold`, `stack_free_min`; FW_design v0.2 §8.1 needs all of them (OI-FW-17 open). The twin cannot be coded against both, and the halt modes (CLEAN/TRUNCATE, POS_UNCERTAIN), TX classes and stretch path are exactly what SAF-FW-002/003/004 and FW-STR-002/004 tests observe. | Integrator adopts FW_design §8.1 as seam v1 in the README (single source = A's headers), before M1-WP1 ends. | Integrator, A |
| **DEF-P1-03** | High | **Twin control/observation vocabulary insufficient for the acceptance criteria.** README vocabulary v1 has no time-stamped PUL/DIR/ENA edge log (`query pulses` returns a count), no byte-level RX injection at a virtual time, no flash power-cut action, no HX711 SCK-overrun/power-down or single missed edge, bounce/broken wire only for some inputs, no IWDG model, no ISR-storm or ALM chatter, no lost-step world shift, no HSE-fail flag, no wire log with first/last-byte times. About 45 T-level TCs (all SAF-FW timing, FW-STR-002/004, FW-NVM-002/003, NFR-008, FI-01…FI-22 marked "ext") cannot produce evidence without them. | Extend the vocabulary per §1.3 / §4 ("ext"); M1 subset (lock-step, wire log, byte injection, flash cut, reset causes) before M1 exit, the rest before M2 entry. | Integrator |
| **DEF-P1-04** | Medium | **False premise "c1 ≥ 1 ms for every parameter combination"** (FW_design §5.6.2 item 4) used by the sniffer argument in §5.9.3 ("a MOVE_ABS dispatched before an already sniffed HALT cannot emit a pulse"). c1 = f·√(2/α), α [steps/s²] = `a_um_s2`·spm/1000: at `a_max_um_s2` 10 000 000 and spm 100 000, α = 10⁹ → c1 ≈ 44.7 µs; at spm 800, ≈ 0.5 ms; at the default 160 spm with a_max at its maximum, ≈ 1.1 ms. If the dispatch budget splits MOVE_ABS and HALT across passes, pulses can be emitted after the HALT was received (HALT ≤ 2 ms still likely met, but not by the stated argument). | Either keep a "stop seen by the sniffer, not yet dispatched" marker that holds any motion start issued from earlier frames until the sniffed frame is dispatched, or restate the bound with the real c1 and dispatch-split timing. TC-SAF-FW-002-03. | A |
| **DEF-P1-05** | Medium | **Inexecutable acceptance criterion.** SRS SAF-FW-018 (and `wiring.md` C-15) "reset with a 10 kg hanging load → axis motion ≤ 0.01 mm": the axis is horizontal without gravity load (D-28, SRS §1), so a hanging load cannot act on it. | Reword: spring specimen preloaded in tension (e.g. ≈ 100 N), MCU reset, travel change ≤ 0.01 mm (dial indicator), raw change within noise. HG-15 already uses this. | Orchestrator (SRS), A (wiring C-15) |
| **DEF-P1-06** | Medium | **Flash operation suspends the DRV_PWR supervision.** During the PROGRAM pass (erase ≤ 0.5 s) `CRIT_NVM` (BASEPRI 0x20) masks the tick and core callbacks are deferred (FW_design §5.11, pinout §4). DRV_PWR is polled only in the tick (§5.7.2), so a driver-power loss during SAVE is handled up to ≈ 0.5 s late; SAF-FW-024 (≤ 25 ms, no state exemption) is then not met; K1_WELDED timing, idle disable and PAUSE/STOP core latches are deferred the same way (the RAM-resident HAL stop reactions are not affected). The axis is idle, so the safety impact is small, but the requirement is violated as written. | SRS: exempt the idle NVM operation explicitly (as NFR-006 does), or the HAL disables ENA from a RAM-resident check of PA7 during flash operations. TC-SAF-FW-024-02, HG-04. | Orchestrator, A |
| **DEF-P1-07** | Low | **Response ring overflow not closed.** FW_design §5.9.4: class R "cannot overflow by construction (SW ≤ 4 outstanding commands)… If it does anyway: E_INTERNAL INVARIANT is logged". FW-CMD-001 demands exactly one response per CRC-valid command regardless of PC behaviour; a flooding PC (or fuzz test) breaks it. | Dispatcher takes the next frame only when class R has room for the largest response (169 B) → back-pressure into the RX ring (counted overrun). TC-FW-CMD-001-02. | A |

### 8.2 Observations

| ID | Observation | Proposal | Addressee |
|---|---|---|---|
| OBS-P1-01 | SAF-FW-003 "deceleration starts ≤ 2 ms" is not measurable as written. FW_design OI-FW-24 proposes "the moment the running period is reprogrammed". | Adopted: **commit time** (seam log of `set_period_now` / preload of c_dec1 / CLEAN halt) ≤ 2 ms after the trigger, every later PUL interval non-decreasing and on the planned profile ± 1 tick, stop distance ± 1 step. Trigger for the PAUSE button = threshold crossing at the MCU pin (the 1.3 ms RC of PB6 is outside the budget). SRS v0.4 should state this. | Orchestrator |
| OBS-P1-02 | SAF-FW-025 gives only a lower bound ("not at 150 ms"). | Test bound: latched in (k1_weld_ms, k1_weld_ms + 2 ms] after the E-stop sense edge with filtered DRV_PWR present; SRS to state an upper bound. | Orchestrator |
| OBS-P1-03 | SRS v0.3 SAF-FW-023 (PAUSED cleared by an accepted motion command) and SAF-FW-024 (STOPPED(DRV_POWER_LOST) "whether or not the E-stop is open") contradict D-30/D-31 and ICD §6.2 (OI-FW-26/27). | TCs follow D-30/D-31 and ICD §6.2; SRS v0.4 must align, otherwise M2 verdicts would test against a superseded text. | Orchestrator |
| OBS-P1-04 | NFR-007 "IRQ-masked windows ≤ 1 µs" vs design `CRIT_DATA` ≤ 2 µs, `CRIT_TICK` ≤ 5 µs, `CRIT_NVM` ≤ 0.5 s; FW_design §6 reads it as "windows that mask a safety ISR". | TC-NFR-007-01 / HG-18 measure "windows masking NVIC levels 0–2 (E-stop, inputs, step) ≤ 1 µs" and report the others; SRS wording to match. | Orchestrator |
| OBS-P1-05 | SAF-FW-017 does not say what happens while the AFE is stale; FW_design §5.7.1 disables idle disable while stale (load unknown → keep holding). | Accept the design rule (safe side, consistent with the speed-cap rule); SRS to state it. TC-SAF-FW-017-02. | Orchestrator |
| OBS-P1-06 | SAF-FW-013 "has moved away" is undefined; FW_design §5.3 uses "pos_steps strictly on the away side of the latch position". | Test with ≥ 1 step; SRS to state it. | Orchestrator |
| OBS-P1-07 | FW design rules not yet in the ICD (OI-FW-18 wire order D > R > E vs ICD §2.4 "responses > EVENT > DATA"; OI-FW-19 sniffer incl. PAUSE; OI-FW-22 boot ENA with DRV_PWR off; OI-FW-23 homing bounds). Until they are in the ICD they are tested against FW_design, not against an interface oracle. | ICD v0.4. | Integrator |
| OBS-P1-08 | Units and motion vectors (R4 TV-TC, TV-M) are not produced by `gen_vectors.py` (OI-FW-20). SYS-003 is M1. | `units_vectors.json` before M1, `motion_vectors.json` before M2; meanwhile validator oracles in `val_oracles/` (non-protocol math only). | Integrator |
| OBS-P1-09 | Generated outputs are stale right now: `gen_params.py --check` exit 1 (proto_gen.h, protocol_gen.py, ICD), `gen_vectors.py --check` exit 1 (both vector files at icd_version 0.2, `protocol.yaml` at 0.3) — the Integrator's v0.3/v0.4 transition in flight (run 2026-10-03 by Validator E). | M1 entry criterion 1. | Integrator |
| OBS-P1-10 | ALM is on EXTI9_5 at level 1 with no self-masking (FW_design §5.2: HAL reaction "–"); a chattering ALM (opto at threshold, unpowered driver) can flood a level that pre-empts the step ISR (level 2) and the HX711 timestamp. ALM needs no µs reaction. | Mask-after-edge + tick re-arm as for the buttons, or poll ALM in the tick. TC-FW-SW-004-01 chatter case. | A |
| OBS-P1-11 | PAUSE is an NO contact (D-28): a broken wire reads "not pressed" and is undetectable. | Accepted by design (STOP NC and E-stop are the paths of record); state in the operator notes. | Orchestrator |
| OBS-P1-12 | `wiring.md` §11 lacks the SYS-009 items DRV_PWR via E-stop and PSU off, K1_WELDED simulated, ENA through the buffer board, ALM reset by power cycle / ENA toggle, settle after power return; C-20 still says "FAULT_K1 check (if adopted)" although D-29 c adopted it; C-15 see DEF-P1-05. | Add C-21… or reference HG-21…HG-28 of this plan. | A |
| OBS-P1-13 | DATA `status` u16 is fully used (16/16 bits). Any new DATA status bit needs PAYLOAD_VERSION 2. | Informational for ICD planning. | Integrator |
| OBS-P1-14 | SYS-002 "passes with the PC disconnected": while moving, a disconnected PC trips the link watchdog after `link_timeout_ms`, so "disconnected" must be defined for timed tests. | Variant L3 (§1.4) uses `link_timeout_ms` = 5000 and stimuli inside the window; SRS wording may say "PC silent after the last command". | Orchestrator |
| OBS-P1-15 | **D-31 RESUME details** for ICD v0.4: exact BLOCK bits evaluated (HALT, ESTOP latched, FAULT — and what about the E-stop input open but not latched, DRV_UNPOWERED, ALM?); RESUME with PAUSED not set (OK no-op?); retry class (ONCE_PRIORITY like the clears?); EVENT PAUSE_CLEARED reason value for RESUME; confirmation that HALT_CLEAR with HALT **not** latched still clears PAUSED; RESUME refreshes the link watchdog; the stop sniffer must **not** act on RESUME. | Integrator fixes these in ICD v0.4 + `check_vectors.json`; TC-SAF-FW-023-03 and TC-SAF-FW-002-02 use them. | Integrator |

### 8.3 P1 verdict on FW testability

**YES WITH CONDITIONS.** The FW design v0.2 is highly testable: all decision logic is pure and host-testable, every interface byte and acceptance rule has an executable oracle (`ref_codec`, `ref_cmdcheck`, shared vectors), the seams isolate every timing-relevant hardware action, and every in-scope requirement (102/102) has at least one test case; only 3 requirements are verifiable solely at the hardware gate.

Conditions:
1. **DEF-P1-01** resolved in `params.yaml` / ICD §11.4 or FW (+ SRS SAF-FW-012 wording) before M1 exit (the M1 synthetic source already shows it).
2. **DEF-P1-02** (single seam v1 in `tools/README.md` = FW_design §8.1) before M1-WP1 ends.
3. **DEF-P1-03** twin vocabulary: M1 subset before M1 exit, full list before M2 entry.
4. **DEF-P1-04** answered in FW_design (mechanism or restated bound) before M2 coding of the motion start path.
5. SRS v0.4 resolves **DEF-P1-05**, **DEF-P1-06** and OBS-P1-01…06/14 (with D-30/D-31) before M2 entry.
6. ICD v0.4 with RESUME (OBS-P1-15) and the FW-design rules of OBS-P1-07; regenerated outputs with `--check` exit 0 (OBS-P1-09) before M1 entry; units vectors (OBS-P1-08) before M1 exit, motion vectors before M2 entry.
7. **D-06 stays in force**: the hardware-gate list (§6, 28 items) is a mandatory condition of every FW verdict until the PO approves a gate; no motion under load on target before HG-01…HG-24 and HG-28 pass.

### 8.4 M2-entry findings (v0.3): requests, observations, open items

**Requests to Implementer A**

| ID | Request | Reason / evidence | Due |
|---|---|---|---|
| REQ-A-M2-01 | `pinout.md` v0.4: (a) CR-01 — remove the PC7 STOP/BREAK row, EXTI line 7, the level-1 STOP entries in §1.3/§4 and `io.stop_active_level`; R-01 closed; (b) new section "Measurement header (HW_MEAS, CR-02)" per §6.2: PC6…PC9 = TIM8_CH1…4 (AF3), PB7 = TIM4_CH2 (AF2), PA11 = TIM1_CH4 (AF1), PB8 = TIM10_CH1 (AF3), FT verified in DS10693 Table 10, DMA2 stream map verified in RM0390 Table 29, PC8/PC9 debug markers retired or exclusive | D-36, OBS-M1-07 (carried), D-35 G5 | (a) M2 entry, (b) before the HW gate |
| REQ-A-M2-02 | `wiring.md` v0.4: CR-01 (§6 operator panel = red E-stop + PAUSE, no STOP button; C-11/C-17); measurement header MH section (jumper table, 1 kΩ series resistors, tap points before/after the buffer, ≤ 10 cm, STIM injection with the switch unplugged and the NC1 → K1 power path kept); C-02, C-05…C-15, C-18 re-worded to the §6.5 methods (no scope / LA); C-xx ↔ HG-xx map | D-35 G5, D-36 | before the HW gate |
| REQ-A-M2-03 | Measurement build per §6.3: envs `nucleo_f446re_meas` / `_meas_dwt`, `hal/f446/meas*.c`, `hal_meas_cmd()` forwarder (seam with C), byte-identical safety handlers and core (TC-SYS-009-02) | CR-02: SRS +H criteria now require on-chip measurement | M2 exit (else condition) |
| REQ-A-M2-04 | Loopback pins never in analog mode while a 5 V tap may be fitted (digital input, no pull, in every build) — or the wiring rule "jumpers removed outside HG sessions"; confirm FT behaviour in analog mode | 5 V buffer taps (SYS-011); pinout §1.2 "unused pins analog" | with REQ-A-M2-01 |
| REQ-A-M2-05 | FW_design v0.5: CR-01 in §5.2 (STOP/BREAK row), §5.3 (STOP-button latch row; HALT_CLEAR "refused while the STOP button is active" → never refused, ICD v0.5 §5.5), `hal_in_cfg_t.stop_active_level` (seam field retired or documented unused); §6 timing table: target values measured per FW_test_plan §6; a HW_MEAS design section | D-36, CR-02 | M2 |
| REQ-A-M2-06 | Align `src/pure/ramp.c` controlled-stop sizing and the speed-up virtual index with the `motion_vectors.json` definitions | OBS-E-M2-03 | **closed 2026-10-04** (OI-ICD-09; dry run 9/9 + 28/28) — re-verified at M2 |

**Requests to the Integrator**

| ID | Request | Needed by | Due |
|---|---|---|---|
| REQ-C-M2-01 | `DIAG_MEAS` command + `FEAT_HW_MEAS` + seam v1.3 `hal_meas_cmd()` per §6.4 (ICD, `protocol.yaml`, `ref_codec`, vectors, `tools/README`); fallback SWD read-back if refused | HG list (§6.5), REQ-A-M2-03 | decision at M2 entry; implementation before the HW gate |
| REQ-C-M2-02 | twin `inject loop_load` (main-loop pass consumes virtual time) | TC-SAF-FW-002-01/03, -023-02 (FI-23) | M2 entry |
| REQ-C-M2-03 | twin `inject isr_storm` / `hang where isr1` | TC-SAF-FW-019-01 | **delivered** with ICD v0.5 (2026-10-04) |
| REQ-C-M2-04 | `reset cause hardfault` with the HardFault record accessor (seam v1.2, OI-FW-32) | TC-FW-STR-006-01 (BOOT value) | **delivered** (twin side) with ICD v0.5; FW accessor with A |
| REQ-C-M2-05 | `query conversions` carries the `gain_pulses` / channel used per conversion | TC-FW-AFE-002-01 | M2 |
| REQ-C-M2-06 | (optional) world direction from the DIR pin with `dir_wiring_inverted`; world position integrated from PUL edges, independent of the model counter | TC-FW-HOM-002-01, -MOT-001-02, SAF-FW-004 (OBS-E-M2-04) | M2 (else target only, HG-28/HG-09) |
| REQ-C-M2-07 | (optional) automatic driver PEND model with `lag_tau_ms` | TC-FW-SW-004-01 realism | M2 |
| REQ-C-M2-08 | (Should) twin model of `hal_meas_cmd` (counter = PUL rising count, probe and stamps from the edge log) | dry run of `hil_*.py` (§5.3 entry) | before the HW gate |
| REQ-C-M2-09 | CR-01 leftovers in the twin: `hal_inputs_config` seam log prints `stop=` (`twin_seams.c:211`) | cosmetic | M2 |
| REQ-C-M2-10 | (Low) larger `log_max` or a per-query ring (TV-M alone = 128 000 PUL edges of 200 000) | TC-FW-MOT-003-01 (T) | M2 |
| REQ-C-M2-11 | `motion_vectors.json` `tolerance.sum_ticks` = ceil(N/1000); SRS FW-MOT-003 says ±N/1000 → floor (min 1), or the SRS states ceil | OBS-E-M2-02 | M2 |

**Observations**

| ID | Observation | Addressee |
|---|---|---|
| OBS-E-M2-01 | Twin edge times are rounded to 1 ns per edge; a period sum taken from world time drifts (TV-M: −13.5 µs ≈ −1 215 ticks over 64 000 steps), per-interval reconstruction is exact. The validator reconstructs per interval; differential tests (B/C) should do the same. | C, B (informative) |
| OBS-E-M2-02 | `motion_vectors.json` sum tolerance uses ceil (31 280 periods → 32 ticks) where the SRS literal ±N/1000 gives 31. Validator verdicts use the stricter floor. | C (REQ-C-M2-11) |
| OBS-E-M2-03 | **Early check of A's in-progress `ramp.c`** (not yet delivered; scratchpad build of `test_val_ramp` against the working tree, 2026-10-04): 5/5 position-move cases and 28/28 `ctrl_stop_paths` rows PASS (worst 1 tick, sum error ≤ 1 tick); the 4 event cases FAIL — `tvm_stop_in_cruise` period 30 000: 7035 vs 7032 and one period short (sum −7 034 ticks), `default_stop_in_accel` period 500: 10 217 vs 10 114, `default_stop_near_end` period 7 990: 142 303 vs 69 456, `jog_speed_changes` period 2 000: 53 791 vs 55 398. Cause by inspection of `ramp.h`: the stop is sized with floor(v²/2a_stop) on a float32 index and the speed-up uses an integer virtual index, while the vectors define r0 = ceil(v_cur²/2α_stop) with v_cur = f/c_last and a real-valued k0. The validator's event mapping (`ramp_stop(cd_stop, 0, last)`, `ramp_set_speed(cmin, ca, cd)`) is a reading of the header and is re-checked when A documents the API. Not a DEF before delivery. **Update 2026-10-04:** A aligned `ramp_stop` / `ramp_set_speed` to `ref_motion.py` (OI-ICD-09, new API with α in steps/s²); the re-run passes 9/9 cases and 28/28 path rows — closed, re-verified at M2. | A (REQ-A-M2-06), C |
| OBS-E-M2-04 | The twin derives `x_true` from its model counter and moves the world in the FW's logical direction; a HAL counting error or a DIR wiring/polarity error cannot appear in the twin (§1.5). | C (REQ-C-M2-06), informative for the M2 report |
| OBS-E-M2-05 | The debug env's PC8/PC9 scope markers (`FW_DEBUG_PINS`) have no use without a scope (D-35 G5) and collide with the proposed TIM8 loopback pins. | A |
| OBS-E-M2-06 | FT pins configured analog at boot (pinout §1.2) may not tolerate a 5 V loopback tap. | A (REQ-A-M2-04) |
| OBS-E-M2-07 | Validator-owned M1 suites updated for ICD v0.5 / CR-01 and for the M2 build: `test_get_info_fields` (47 parameters, M2 feature set once MOTION is reported), `test_val_nvm` (47 − 3 session = 44 record entries), `test_val_check` (retired `stop_btn_*` state keys must stay 0), `test_val_flags` (no STOP_BTN input; all-on masks 0xFDFF / 0x03F7), `gen_val_vectors.py` (reserved / retired bit names skipped; `motion.txt`), `check_static.py` S-10 (retired names skipped; `#define` wins over comment text); twin M1 tests feature-aware (`idle_status_bits`: PEND + DRV_PWR valid with FEAT_DRV_SIGNALS; DRV_PWR made absent with `drv_power on:false` for the reboot-required checks). | Orchestrator (for the M2 report) |
| OBS-E-M2-08 | **SAF-FW-014 wording vs ICD:** SRS "all motion refused until both inputs are released and FAULT_CLEAR is received" vs ICD v0.5 §5.5 cause of LIMIT_WIRING = "both limit inputs active" (clearable once one input is released; the remaining active limit still blocks motion toward it). A's in-progress build follows the ICD; `test_both_limits_wiring_fault` follows the SRS and is a strict xfail until decided. | Orchestrator (SRS or ICD), C, A |

**Open items**

| ID | Item | Addressee |
|---|---|---|
| OI-E-M2-01 | Is a DMM (and caliper / dial indicator) available at the HW gate? D-35 G5 excludes only scope and LA. Without a DMM, HG-06/23 fall back to datasheet calculation (R-9). | Orchestrator → PO |
| OI-E-M2-02 | SYS-006 "driver supply < 5 V within 100 ms": accept the on-chip E-stop → K1-aux and → driver-logic-drop-out (ALM "unpowered") times plus the MCU-in-reset functional test as the equivalent (R-6), or provide an instrument. | Orchestrator → PO |
| OI-E-M2-03 | Load-limit regrow window end: A's `loadlim.h` and the validator oracle end it with the first sample inside the thresholds; SRS SAF-FW-011 / ICD §5.5 are silent — state it. | Orchestrator (SRS), C (ICD) |
| OI-E-M2-04 | If REQ-C-M2-01 is refused: the SWD read-back fallback needs the PO approval (D-06) to cover a debugger connection during the HG session. | Orchestrator |
| OI-E-M2-05 | STIM trials on the E-stop sense need the NC2 sense contact unplugged from PA10 while NC1 → K1 stays wired (hardware E-stop stays effective): bench safety procedure to be agreed and written into `wiring.md`. | Orchestrator, A |

### 8.5 M2-gate status of the v0.3 requests and new requests (v0.4)
| ID | Status 2026-10-04 (commit 099af88) |
|---|---|
| REQ-A-M2-01 / 02 | delivered: pinout / wiring v0.4 (CR-01, measurement header MH, C-xx re-worded). **D-41 / D-42** (no contactor, hardwired ENA disable) still to be drawn in wiring v0.5 (CR-03) |
| REQ-A-M2-03 | delivered incl. the DWT statistics (OI-FW-37 closed, 23 sections); TC-SYS-009-02 PASS with the §6.3 `_meas_dwt` exception |
| REQ-A-M2-04 | delivered (pinout v0.4 MH rule) — HG-31 checks it on target |
| REQ-A-M2-05 | delivered (FW_design v0.5) |
| REQ-A-M2-06 | closed (OI-ICD-09: `ramp_stop` aligned to `ref_motion.py`; `test_val_ramp` 9/9 + 28/28) |
| **REQ-A-M2-07 (new)** | J-STIM series resistor sized for a valid low at PA10 / PB0 / PC1 against their 1 kΩ pull-ups (≤ ≈ 400 Ω, e.g. 220 Ω; §6.8 P-4), and the D-42 circuit (NO contact → ENA opto) drawn without contention with the MCU ENA output (DMM check HG-10 d) — wiring v0.5 |
| **REQ-A-M2-08 (new; delivered, DEF-M2-02 closed)** | DEF-M2-02: preserve the pre-reset NOINIT record (last PUL stamp, heartbeat) across the reset — snapshot in `meas_start()` before the DMAs restart — so HG-14 can be evidenced (report `FW_test_report_M2.md`) |
| REQ-C-M2-01…10 | delivered in ICD v0.6 (DIAG_MEAS + Appendix C, loop_load, isr_storm, hardfault, conversions gain, DIR-pin world, auto PEND, DIAG_MEAS twin model, log size, `stop=` leftover) |
| REQ-C-M2-11 | resolved by D-40 b (ceil) |
| **REQ-C-M2-12 (new)** | twin DIAG_MEAS model: NOINIT w0 magic 0 until the first clear (target: set at boot) and w2 = live time — align with A's target semantics after REQ-A-M2-08; the four `test_twin_m1_fw.py` stop-timing tests are still skipped as "verified in M2" — un-skip them |
| OI-E-M2-01 | closed: multimeter available (PO) |
| OI-E-M2-02 | superseded by D-41 / D-42 (R-6 / R-10) |
| OI-E-M2-03 | closed: D-40 d (regrow window until back inside or the next FAULT_CLEAR) |
| OI-E-M2-04 | closed: DIAG_MEAS is the primary path, SWD fallback only (PO) |
| OI-E-M2-05 | answered: bench safety procedure §6.8 — **for PO approval** |
| OBS-E-M2-08 | closed: D-40 a |

---

## 9. Change history

| Version | Date | Change |
|---|---|---|
| 0.4.15 | 2026-10-14 | Gate runner v1.1 (`GATE_RUNNER.md`): TC-SYS-009-04 extended for C's review C-GR-1…3 and GR-2 / GR-3; HG-01 / HG-20 M-5iso with the Nucleo unpowered (port closed / re-opened / re-identified), HG-20 M-5 with the 48 V ON, HG-17 D-42 NO-wire sequence per picture B6 with the HG-10 c1 repeat recorded, S-00 bench-fact checks (load-cell side, caliper faces must be confirmed). |
| 0.4.14 | 2026-10-14 | D-57: gate runner (`00_System/tools/hil/GATE_RUNNER.md`): TC-SYS-009-04; board sessions only with an approval file (no `--approved`), results zip + `hil_analyze.py`; HG-06 switches the 48 V OFF for the shunt changes (picture B4). |
| 0.4.13 | 2026-10-14 | D-56 b (SRS v0.6.8 SYS-011, OI-F-BRU-03): TC-SYS-011-01 rewritten for the direct-drive qualification (I_LED ≥ 6 mA on ENA and DIR, pulse-integrity re-home, repeated after wiring changes and at each campaign end; buffer + HG-23 only on failure); HG-23 row and §6.7 order item 3 conditional; HG-06 note. The HIL HG-23 step answers N/A without the buffer (runbook v0.4). |
| 0.4.12 | 2026-10-10 | Re-check of FW v0.8.6 (`FW_code_review.md` §16, D-55): new suite `test_val_isrcore` (TC-FW-MOT-002-03 target vs seam step-ISR entry on the real core; TC-FW-MOT-003-03 acc clamp proof); `check_meas_build.py` safety symbol `step_isr` → `step_isr_core` (OI-FW-53; TC-SYS-009-02 PASS on v0.8.6, FAIL with the old list). |
| 0.4.11 | 2026-10-10 | Re-check of FW v0.8.5 (`FW_code_review.md` §15): TC-SAF-FW-004-05 (c) is now a pass/fail guard-margin criterion (anti-vacuity, no runt inside the guard, first runt ≥ 2× the conservative target path), replacing the informational threshold report (OI-FW-52: A's proposal "no runt up to 20 ticks per access" not adopted — with a 135-tick guard it can pass without the model ever producing a runt); TC-SAF-FW-002-05 at 6 and 12 ticks per access; `test_val_m2pure` halt / stretch decisions for both guards (45, 135) plus CNT = 0 below every compare ≥ 225 ticks; guard window 1.5 µs in TC-SAF-FW-004-01 and §6 item 3. |
| 0.4.10 | 2026-10-10 | Re-check of FW v0.8.4 (`FW_code_review.md` §14): new suite `test_val_haltwin` (access-timed TIM2 model of the target step HAL): TC-SAF-FW-002-05 (FWR-21: a CLEAN halt whose running pulse ends inside the decision window emits one more pulse a full period later), TC-SAF-FW-004-05 (OBS-RC-7: 0.5 µs guard margin of the stretch and of the CLEAN halt_hw path). TC-FW-SW-002-01: CRIT_HALT ≤ 1 µs per window (NFR-007) instead of ≤ 0.2 µs (OBS-RC-6). |
| 0.4.9 | 2026-10-09 | Re-check of FW v0.8.3 (`FW_code_review.md` §13): TC-FW-HOM-001-03 (FWR-20: segment end inside the tick), TC-FW-MOT-005-02 (jog reversal, same model). |
| 0.4.8 | 2026-10-09 | Re-check of FW v0.8.2 (`FW_code_review.md` §12): `test_val_tickgen` now drives the real `core_tick_1ms()` (TC-FW-HOM-001-02), new TC-SAF-FW-005-03 (E-stop chatter: deferral bounded, no motion). |
| 0.4.7 | 2026-10-09 | Re-check of FW v0.8.1 (`FW_code_review.md` §11): TC-FW-HOM-001-02 (`test_val_tickgen`, FWR-18 reproducer). |
| 0.4.6 | 2026-10-09 | D-52: HG-18 criteria (sections 3/4, 5, 23 ≤ 2.5 µs; section 1 + largest level-1 ≤ 5 µs; section 2 and critical sections ≤ 1 µs). Check vectors state_schema 4 (ICD v0.7.5 (h)): `gen_val_vectors.py` maps `ena_on` (s[22]) and emits `hw_meas_vectors` as CM lines; `test_val_check` replays 575 vectors (543 CV + 32 CM, hw_meas = 1). |
| 0.4.5 | 2026-10-09 | Re-check of FW v0.8 (Validator E, `FW_code_review.md` §10): HG-18 sections 1, 2, 3/4 and 23 with pass criteria (handler total incl. 27 cycles entry / exit; D-51), `isr_wcet.py` calibration data (OI-FW-46); `test_val_steprace` adapted to v0.8 (OI-FW-49: `step_estop_reaction`, `s_late`; new extra-state equivalence of the E-stop reaction); TC-SAF-FW-005-02 (FWR-16). |
| 0.4.4 | 2026-10-08 | Code review (Validator E, `FW_code_review.md`, anchor e600169): reproducer TCs TC-SAF-FW-002-04 / -004-04 (FWR-01/02, `test_val_steprace`, target step HAL on a register model), TC-SAF-FW-013-02 / -023-04 (FWR-03, `test_val_toctou`; documented exception to §1.1 rule 1), TC-FW-CFG-001-02 (FWR-14, `test_val_review_gen.py`), TC-SYS-009-03 (FWR-12/13/15 + FWR-09 HIL part, `test_hil_review.py`); §6.9 HIL session identity / gating rules. The FW reproducers fail at e600169 by design until A's fixes land. |
| 0.4.3 | 2026-10-05 | M4 verification (Validator E): TC-SAF-FW-015-01 extended for D-47 a (VALID cleared in every motion state, no stop while not moving) with the 32-case `linkwdg_vectors.json` replay and an independent oracle; TC-FW-CMD-002-01 keeps a PING heartbeat (otherwise the D-47 a watchdog clears VALID); binding inputs SRS v0.6.3, ICD v0.7.4. |
| 0.4.2 | 2026-10-05 | M3 verification (Validator E): D-45 (a) HG-10 c wording, (b) §6.8 P-1 window 5…55 mm next to START, (c) PSU-off pulse trains (HG-02 c, HG-08 a, HG-18, HG-29 d) with RAM parameters + REBOOT restore, explicit 50 kHz + 10/10 µs for the 50 kHz trials (R-HIL-03), (d) HG-04 a real press on the predicted erase SAVE, (e) dict 6 pulse defaults 12.5 + 12.5 µs / 40 kHz: HG-08 budget = driver minimum, configured values checked "as configured", (f) HG-29 c self-test with a 10 ms hold, (g) J-EVT ← ENA deferred; DEF-M3-01 / DEF-HG-01 closed (A, 2d36eec); TC-FW-MOT-006-01 moved to M3 with ICD v0.7.3 rules (a)–(e); §6.9 HIL scripts; binding inputs SRS v0.6.2, ICD v0.7.3, FW_design v0.7. |
| 0.4.1 | 2026-10-04 | M2 close-out re-test: ICD v0.7 / v0.7.1 (state_schema 3, dict 5 / 48 parameters, `drv.pwr_sense_enable` and `drv.k1_check_enable` default false — SAF-FW-024/025 and FW-SW-005 TCs enable the optional sense by SET + SAVE + REBOOT; load-limit reference only on a cleared LOAD_LIMIT; NOINIT w4–w8 previous-boot record for HG-14; DWT op 9 sections 0–22 for HG-18); §6.3 exception for `_meas_dwt` (HAL objects including `meas_dwt.h` + `main.cpp.o` may differ, core / pure / gen identical) implemented in `check_meas_build.py`; D-43 b un-homed window TC added; standing rule: private `PLATFORMIO_BUILD_DIR` / twin build dir. Results: `FW_test_report_M2.md` §6. |
| 0.4 | 2026-10-04 | M2 gate (Validator E): D-40 a/b/d, D-41 (no contactor, CR-03), D-42 (hardwired ENA disable) in the HG list (HG-04/07/10/17/20/21/22/24 revised, HG-32 new, R-6 superseded, R-9 closed, R-10 new); bench safety procedure §6.8 for PO approval; OI-FW-39 answered (distance counted from the deceleration commit); PO answers recorded (DMM available, DIAG_MEAS primary, SWD fallback); M2 suites implemented and run (results in `FW_test_report_M2.md`); new validator suites `test_val_loadlim`, `test_val_m2pure`, twin `test_val_twin_m2_sources/cmds/meas.py`, `static/check_meas_build.py` (TC-SYS-009-02), `check_static.py` S-14 / S-15. |
| 0.3 | 2026-10-04 | M2 entry (Validator E). **CR-01 / D-36:** TC-SAF-FW-022-01 withdrawn (ID kept); STOP button removed from TC-SYS-001-01, TC-SAF-FW-001/002/007-0x, -023-03 (b), TC-FW-SW-003-01 (+ CR-01 negative checks: no PC7 input, retired bits / EVENT 22 / stop cause 4 / HALT source BUTTON never emitted), TC-FW-STR-003/006-01, FI-01/02/21, HG-11/17; scope 101 requirements (99 Must + 2 Should). **CR-02 / D-35 G5:** §6 rewritten — measurement principles and tools MT-1…MT-7 (§6.1), loopback jumpers and pins (§6.2, REQ-A-M2-01/02/04), measurement build `HW_MEAS` / `HW_MEAS_DWT` (§6.3, REQ-A-M2-03), `DIAG_MEAS` protocol request (§6.4, REQ-C-M2-01), HG-01…HG-28 re-planned without scope / LA + HG-29…HG-31 new (§6.5), residual risks R-1…R-9 with acceptance alternatives (§6.6), session order (§6.7), HG1 entry / exit (§5.3); new TC-SYS-009-02 (measurement-build differential). **M2 refinement:** TCs mapped to the as-built seams / twin vocabulary v2 / ICD v0.5 (§1.4 W, §1.5 twin limits, §3, §4 FI status, §4.1 vocabulary needs REQ-C-M2-02…11); D-33 h limit-latch rule (TC-SAF-FW-013-01); `motion_vectors.json` adopted as the U oracle for FW-MOT-003 (cross-checked exactly by the validator's `ramp_ref.py`); M2 entry / exit updated (§5.2). **Pre-written suites (§2.1):** `val_oracles/{ramp_ref,homing_ref,latch_ref}.py`, `gen_val_vectors.py` + `motion.txt`, `test_val_ramp`, `twin/vhelp_m2.py`, `twin/test_val_m2_oracles.py` (22/22 PASS), `twin/test_val_twin_m2_{motion,homing,safety}.py` (gated, skip until A's M2 build). Validator suites aligned to ICD v0.5 / CR-01 (OBS-E-M2-07); dry run against A's in-progress M2 build (§2.1: twin 74 + 1 strict xfail, Unity 7/7 suites, static 13/13 — not M2 evidence). Findings §8.4 (REQ-A-M2-01…06, REQ-C-M2-01…11, OBS-E-M2-01…08, OI-E-M2-01…05). |
| 0.2 | 2026-10-03 | M1 gate (Validator E): binding inputs SRS/ICD v0.4.1, dict 3, FW_design v0.4, D-36; validator suites as built (§1.2, §2: run-time vector files from `val_oracles/gen_val_vectors.py` instead of A's pre-script headers, OI-FW-34 resolved without a `platformio.ini` change; names check moved to `static/check_static.py`); TC corrections: TC-FW-NVM-003-01 (OVERRUN without `frame_seq` gap; moving part M2), TC-FW-CMD-001-02 (flood definition), TC-IF-005-01 (M1 precondition B), TC-FW-STR-003-01 (bits reachable in M1, OVERRUN semantics). Results: `FW_test_report_M1.md`. |
| 0.1 | 2026-10-03 | First FW test plan for the P1 gate (Validator E): strategy and levels (U/T/S/A/H), independence rules, twin harness requirements; 129 TCs for 102 requirements (M1 45, M2 83, M4 1) incl. D-30 (PAUSED blocks motion, race, clean-halt condition) and D-31 (RESUME) cases; fault-injection catalogue FI-01…FI-22; M1/M2 entry/exit criteria and report format; hardware-gate list HG-01…HG-28 (C-01…C-20 merged + SYS-009 + all +H criteria); P1 review DEF-P1-01…07, OBS-P1-01…15; verdict YES WITH CONDITIONS. |
