HawortiaCooper/Bird.Bend_Stend/01_HW/diagrams/bench/B1_measurement_header.png

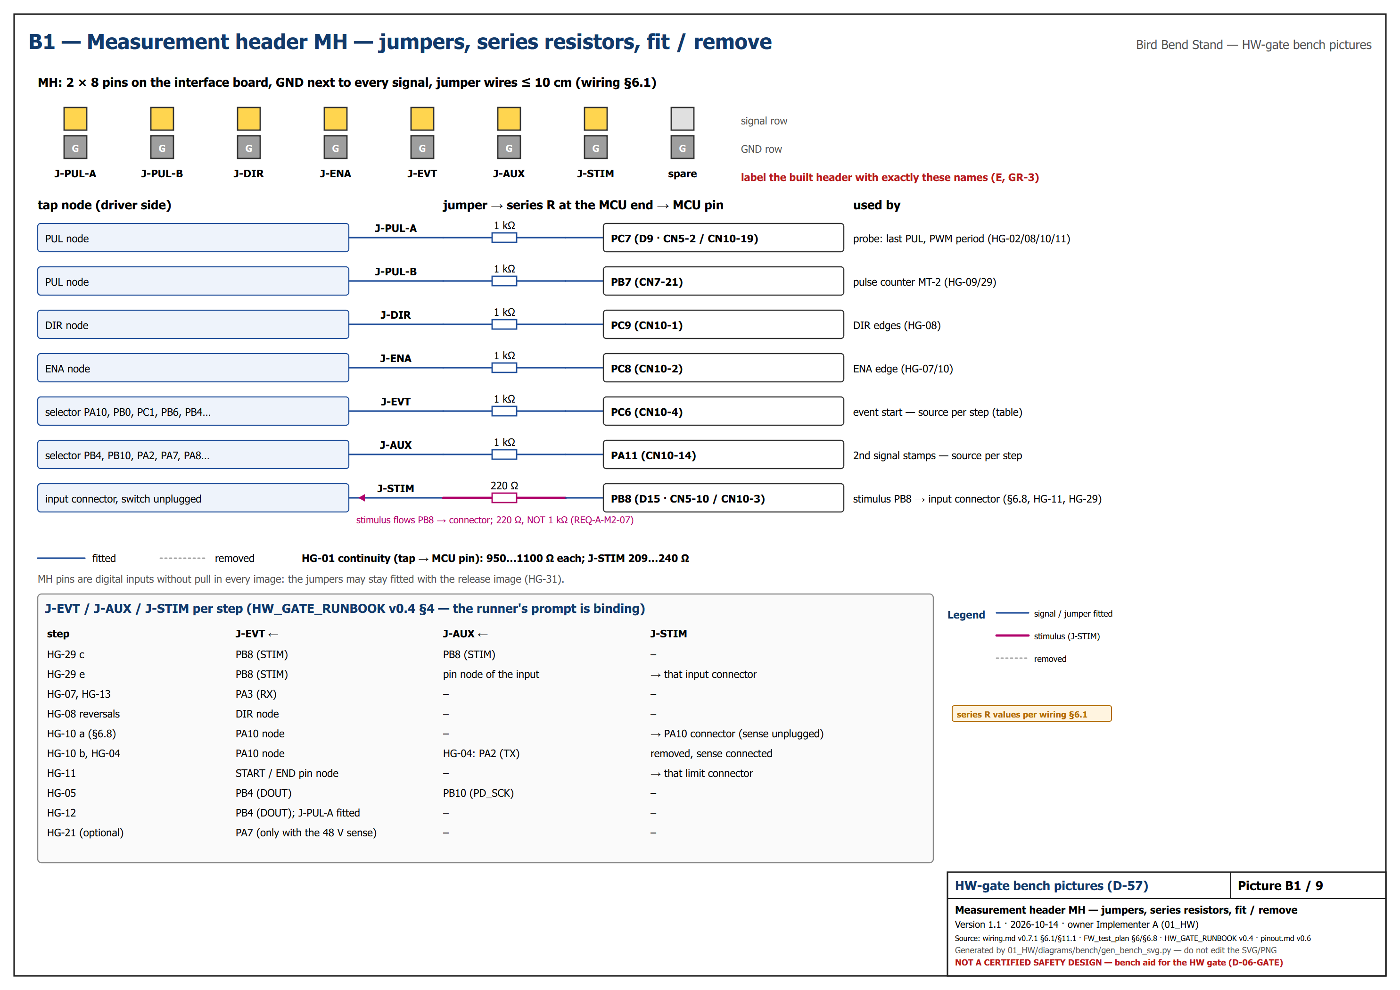
01_HW/diagrams/bench/B1_measurement_header.png
