HawortiaCooper/Bird.Bend_Stend/04_Delivery/BringUp_FW0.8.6/diagrams/sheet3_input_cells_ena_or.png

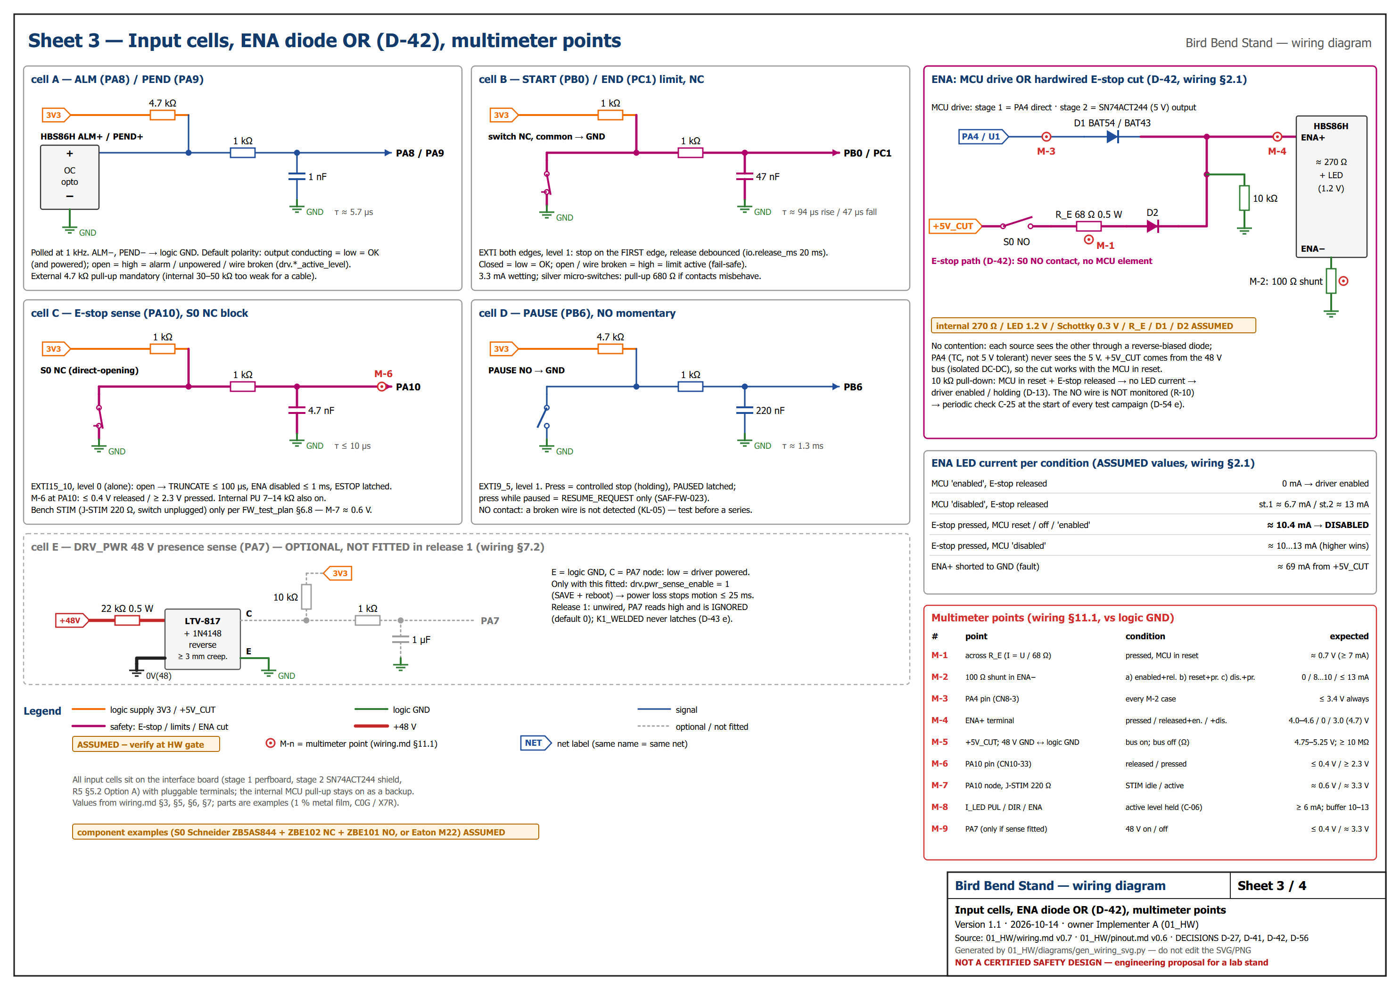
04_Delivery/BringUp_FW0.8.6/diagrams/sheet3_input_cells_ena_or.png
