HawortiaCooper/Bird.Bend_Stend/04_Delivery/BringUp_FW0.8.6/diagrams/sheet4_driver_dip_supply.png

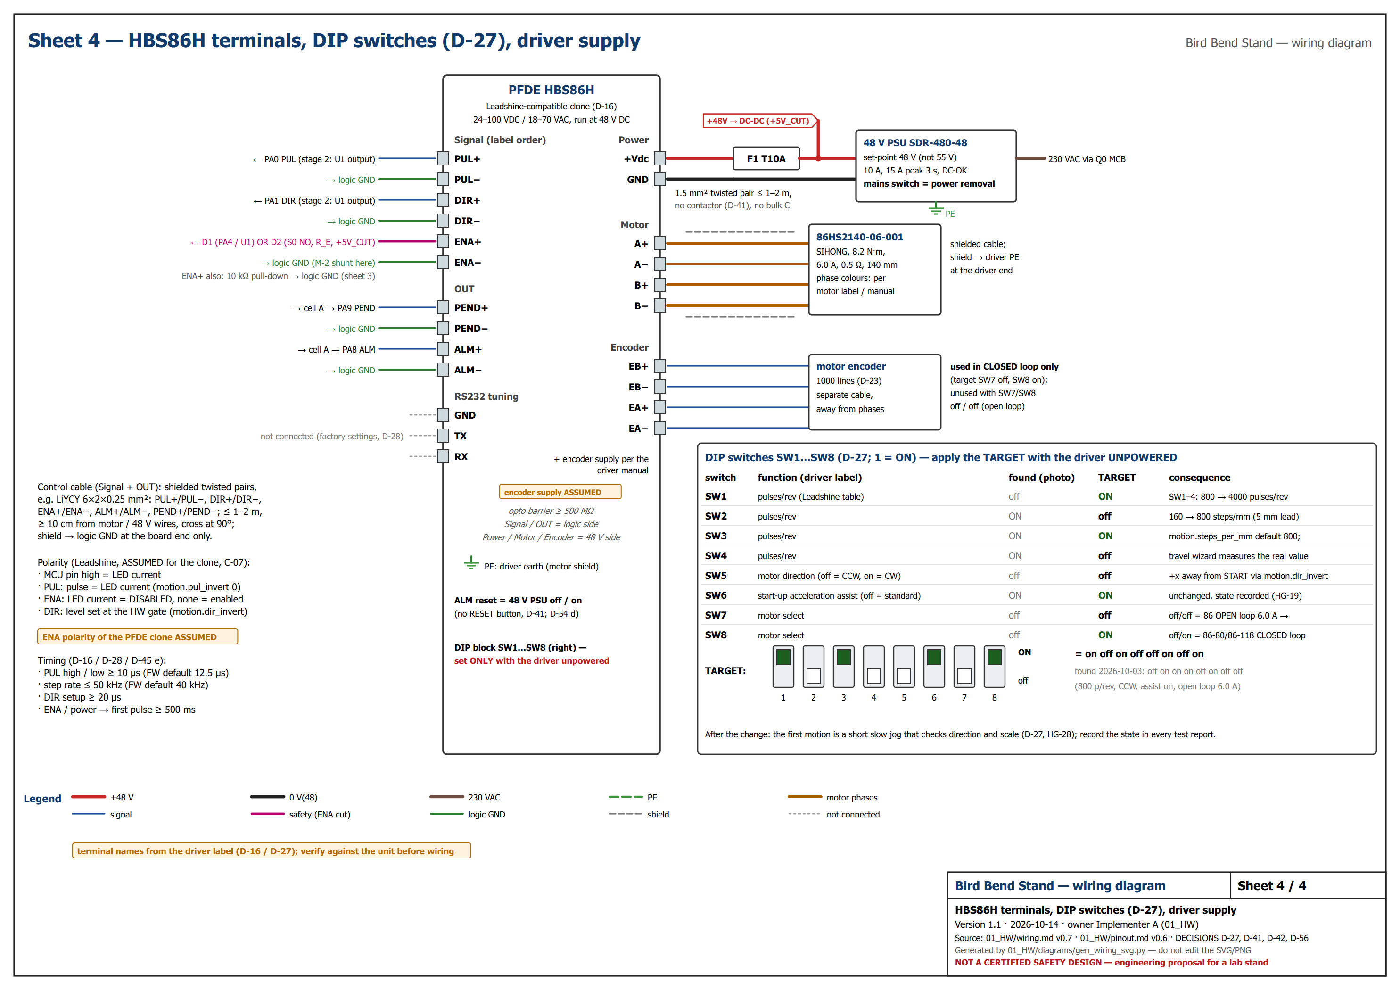
04_Delivery/BringUp_FW0.8.6/diagrams/sheet4_driver_dip_supply.png
