HawortiaCooper/Bird.Bend_Stend/(commit log)

2026-10-03 P0 research complete: process skeleton, role agents, R1-R4, PO decisions D-01..D-25
    - PROCESS/STATUS/CLAUDE.md and 7 role agents mirroring Thrust_Stand_HAW
    - R1 Stefan reference, R2 hardware components, R3 Thrust_Stand reuse, R4 methods
    - PO answers to the 24 P1 entry questions recorded as decisions (D-11: E-stop removes power)
2026-10-03 P1 wave 2: SRS v0.2, R5, ICD v0.1 + params dict v1 + tools, FW/HW/SW designs v0.1
    - SRS v0.2 (165 requirements, Orchestrator-reviewed), DECISIONS D-26..D-29
    - R5 interface & safety HW (E-stop Option A, buffer board, pin check)
    - ICD v0.1 (PROTO 1.0, PAYLOAD 1), params.yaml (48 params, hash 0x13961802),
    generator, reference codec, shared vectors (654 tool tests pass)
    - 01_HW pinout/wiring v0.1, FW_design v0.1, SW_design v0.1, SW_design_GUI v0.1
2026-10-03 P1 specification package for PO review: SRS v0.4.1, ICD v0.4.1, designs, test plans
    - SRS v0.4.1 (172 requirements), DECISIONS D-01..D-34 (D-27 driver DIP change approved)
    - ICD v0.4.1, params dict v3 (hash 0xF0376293), protocol.yaml single source of names,
    generators, reference codec, shared vectors (813 tool tests pass)
    - FW_design v0.3, pinout/wiring v0.3, SW_design v0.3.1, SW_design_GUI v0.3
    - FW test plan (129 TCs) and SW test plan (167 TCs); validator verdicts YES WITH CONDITIONS
    - TRACEABILITY.md generated (172/172 designed and covered), REVIEW_PACKAGE.md
2026-10-03 M1 implementation checkpoint (verification pending)
    - FW: PlatformIO project, pure/core/hal layers, link + CRC + parser, params/NVM (sectors 1+2),
    synthetic 80 Hz AFE stream, stop sniffer, IWDG; native 94/94, release build SUCCESS, map check PASS
    - FW host twin + integration suite (43 passed, 4 skipped, 1 xfail IF-C-M1-02)
    - SW backend: io/core/calc, simulator, recorder skeleton, test hooks; unit 1869 passed
    - GUI M1: main window, toolbar, indicators, connection/config tab, plot dock; 163 GUI tests
    - Role rule: stop only processes started by the agent, by PID
    [afe.c, afe_rate.c, afe_rate.h, afe_synth.c, api.py, app.c, backend.py]
2026-10-03 M1 accepted with conditions: fix rounds, validator suites and reports
    - FW: DEF-M1-01..04 + OBS-M1-08 fixed; Validator E GO WITH CONDITIONS (45/45 M1 TCs)
    - SW: SWD-M1-01..11 fixed (STOP path, clears on priority path, latch source, recorder);
    Validator F ACCEPTED WITH CONDITIONS (2479 tests x3 identical)
    - Validator suites: 02_FW/test (Unity, twin, static), 03_SW/tests/validation
    - D-37 M1 gate interface decisions
    [afe.c, api.py, app.c, backend.py, check_static.py, cmd.c, device.py]
2026-10-03 M2 implementation: FW sensor & motion, SW backend motion/sim, ICD v0.6; D-41 (no contactor)
2026-10-04 M2 close-out implementation: DEF-M2-01/02, DWT stats, D-43 un-homed window, CR-03 (ICD v0.7, SRS v0.6.1, wiring v0.5 D-42), SW close-out fixes
    [board_pins.h, check_ctx.h, cmd.c, cmd_check.c, cmd_check.h]
2026-10-04 M2 accepted with conditions: ICD v0.7.1, validator re-tests (E GO w/ conditions, F ACCEPTED w/ conditions)
    - FW: DEF-M2-01/02 fixed and verified; native 160/160; release 44 112 B flash / 8 672 B RAM
    - SW: 2815 tests x3 identical; CR-03 (no contactor, hardwired ENA cut) applied end-to-end
    - D-44: M3 started
    [check_meas_build.py, test_main.c]
2026-10-05 M3 implementation: SW backend (calibration, tare, PC limits, recording), GUI tabs/wizards, MOVE_UNTIL_LOAD, HW-gate HIL scripts, ICD v0.7.3 (D-45), DEF-M3-01 fix
    [afe.c, api.py, backend.py, capture.py, channels.py]
2026-10-05 P2 complete: D-49 standstill break detection, pre-P3 fixes and re-verification, P3 readiness note
    [model.py]
2026-10-10 Pre-P3 tasks 1-7: independent FW/SW reviews closed, packaging, manual, perf
    - FW v0.8.5: ISR rework (isr_wcet.py path bounds), FWR-01..21 fixed incl.
    FWR-03 (High, cmd_check->execute gap); FW_design v0.8.5, pinout v0.6
    - Validator E: FW_code_review v1.2 GO WITH CONDITIONS; HIL interlock
    hardening (FWR-12/13/15, C-R1..4); FW_test_plan v0.4.11 (142 TCs)
    - Validator F: SW_code_review v1.4 ACCEPTED WITH CONDITIONS, 36/37 SWR
    closed; SW perf report on the dev PC + reference-PC procedure
    - SW: SWR fixes (liveness, pipeline isolation, load-input gate, recorder,
    shutdown, link STOP ordering, log file), calibration plausibility (D-50 a),
    coverage >= 95 % on executor/report/calibration, simu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
    [api.py, backend.py, buildinfo.py, check_ctx.h, check_map.py]
2026-10-10 PO answers D-54/D-55: travel cal without load cal, folder picker, NFR-009 work, step-ISR trim
    - D-54 a: travel wizard independent of the load calibration (wizard-scoped
    no-specimen state, HOME first, limits restored on every exit); SWR-38 fix
    - D-54 b: new NFR-009 (600 s x 4 windows >= 20 fps); OpenGL setting (default
    off), skip-unchanged repaint, whole-pane update, vectorised xy() decimation
    - D-54 c: recordings-folder picker; D-54 d/e confirmed in the manual
    - D-55: fixed-point ramp dropped; float step ISR trimmed (FW v0.8.6,
    1.97 us nominal), Validator E re-check GO WITH CONDITIONS
    - SRS v0.6.7, SW_code_review v1.5, FW_code_review v1.3, test plans updated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
    [api.py, backend.py, check_meas_build.py, dataview.py, gates.py, isrc_api.h, model.py]
2026-10-14 Bring-up package, Bring-up assistant, gate runner (D-56, D-57), FW 0.8.6
    - 01_HW: wiring diagram sheets 1-4 and HW-gate bench pictures B1-B9
    (generated SVG/PNG), wiring.md v0.7.1 (direct-drive qualification, D-56 b)
    - 04_Delivery: BringUp_FW0.8.6 (release image .bin/.hex, FLASHING, operator
    BRINGUP_GUIDE draft 0.4, diagrams) and separate GateKit_FW0.8.6
    - FW: version 0.8.6, SOURCE_DATE_EPOCH reproducible builds, make_delivery.py
    - SW: Bring-up assistant (SW-BRU-001..004): engine core/bringup.py, 121-step
    step file v1.4, dock GUI, package zip with manifest; review fixes
    SWD-P3-02..09; data isolation for all test helpers (incident 2026-10-14)
    - HIL: frozen gate runner v1.2.0 (approval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
